shikhakath/APE-SingleBoardComputer/docs/schematic-open-items.md

# Schematic v0.1: open items for review

The schematic is generated from `hardware/gen` (16 sheets, 726 placed parts, 458 nets, 65 footprints). `build.py check` passes: no single-node nets, no accidental connections, no overlapping parts. All 16 sheets are built in Altium AD26, and every pin lands on its wire (pin-map check). `PCB.PcbDoc` is being placed and has not yet taken the 2026-11-04 netlist (717 footprints, 458 nets); the next Update PCB brings it in. 47 parts are DNP, and the `Production` project variant marks them Not Fitted. Use that variant for every BOM and pick-and-place output: `[No Variations]` still counts them as fitted.

ERC has 0 fatal errors, 7 errors and 332 warnings, all expected:
- The 7 errors are floating inputs, and the 262 "unconnected" warnings are on pins deliberately left NC with a No-ERC marker. The 7 inputs are the unused DP83867 JTAG pins and codec MIC1 inputs. All 262 pins were checked against the generator's NC list.
- 66 nets have only passive or input pins, so they have no driver.
- 4 nets join an IO pin with an output or power pin: SoC pads driven by a peripheral, and MCU_OSC0_XO tied to GND for the LVCMOS oscillator.

On 2026-10-21 the whole design was reviewed:
- against the Octavo OSD62x-PM schematic checklist (rev 07/07/2025, all 129 items);
- pin by pin against each part's datasheet;
- every footprint against its manufacturer drawing.

Fixes from that review are listed at the end.

Priority: **A** = must resolve before layout, **B** = confirm at footprint/PCB stage, **C** = confirm at bring-up.

## Decisions for you

| # | Sheet | Question | Default in the schematic |
|---|---|---|---|
| A1 | 07 | eMMC-module connector GB042-34P is broker-only (see `docs/bom`). Buy from a broker, or solder an eMMC chip? | Connector, as decided |
| A2 | 09 | Switch each USB-A port's power separately? This would mean TPS2041B plus a buffer. | Both ports switched together from USB1_DRVVBUS |
| A3 | 13 | Wire the M.2 USB pins to hub port 3, so USB-Bluetooth cards work? (M2-CC3351 uses UART.) | Not connected |
| A4 | 13 | Route BT `UART_WAKE#` and `VIO_CFG` to spare 1.8 V GPIOs? | Test points only |
| A5 | 14 | Fit the on-board HAT-ID EEPROM? It would collide with a HAT's own EEPROM at 0x50. | DNP |
| A6 | 15 | The TI-14 Tag-Connect pinout has no reset pin. `JTAG_SRST_N` sits on pad 6, the key position, which TI XDS probes leave unconnected. A custom adapter is needed. | KEY pad, pulled up on sheet 06 |
| A11 | 01 | L100 (MWSA0603S-4R7MT) saturates at 9 A, below the LM61460 high-side current limit (10.3 A typ, 11.5 A max). The datasheet asks for Isat ≥ the limit. The part is molded powder with a soft saturation curve, and the regulator has hiccup protection. Bourns SRP7028A-4R7M (10 A) is still short of 11.5 A. | Accept (risk 6 in `docs/research/bom/power.md`) |
| A12 | 14, 12 | Checklist 62_ALL_7 asks for ESD protection on off-board connectors. The 28 header signals have only their 33 Ω series resistors, and the camera FPC has none. The Raspberry Pi has none on its header either. Header protection would take 7 × TPD4E05U06. | None |
| A13 | 07 | The SD card is not power-cycled on a warm or watchdog reset. RESETSTATz is low for about 162 µs, but card VDD takes about 0.53 ms to discharge, so it only dips to about 2.4 V. A UHS-I card left in 1.8 V signalling then fails ROM SD boot. The SK has the same topology. Fixes: reboot through the Linux vmmc regulator (software), route watchdog/ESM resets to the PMIC as a cold reset, or delay the SD power enable. | Software fix (vmmc); sheet note |
| A14 | 08 | HR911130A ties all four PHY-side centre taps together inside the jack. TI DP83867 Fig 9-2 wants them separate, each with its own 0.1 µF. Most MagJack designs accept this. The alternative is a jack or discrete magnetics with separate taps, as on the DP83867 EVM. | Accept |
| A15 | 02, 03 | `VDDSHV_CANUART` is on the switched 3.3 V rail, and there is no link from `PMIC_LPM_EN0` to MODE/STBY (the DNP 0R `R207` was dropped on 2026-11-10). 62_CONFIG_9 assumes an always-on rail, as on the SK and OSD62-PM-BRK. This board has no Partial-IO, and AM625 DS Table 6-5 note 3 allows any valid IO source in that case. Moving the rail alone would break the rule that all rails discharge before a power-up (only Partial-IO with VDD_CANUART also always-on is exempt), so it would also need a 0.85 V always-on LDO for VDD_CANUART. Adding that link as things stand would be unsafe: if STBY drops `VCC_3V3_SYS`, the pull-ups lose power and MODE/STBY cannot return high. | Switched rail, no LPM_EN0 link, no SoC low-power mode through the PMIC |
| B1 | 11 | Headphone coupling caps: 47 µF gives a 211 Hz corner into 16 Ω. Fit 100–220 µF? | 47 µF |

## Footprint checks

The footprints are in `hardware/gen/fplib/`. Section 10 of `hardware/gen/README.md` lists what each one assumes. All 65 footprints were checked against their manufacturer drawings and compared pad by pad with the LCSC EasyEDA footprints; USB-C, HDMI, USB-A and TC2070 were also compared with KiCad. Where EasyEDA disagrees with the drawing, the library follows the drawing. Those cases: microSD shell tabs, TE FPC row pitch, USB-A contact rows, M.2 tab length, RJ45 LED holes.

| # | Part | Status |
|---|---|---|
| B2 | J100/J1500 USB-C (HRO TYPE-C-31-M-12) | Confirmed against the drawing, KiCad and EasyEDA |
| B3 | J1000 HDMI-A (XFCN) | Confirmed: pin 1 position backed by three sources |
| B4 | J1100 TRRS jack PJ-320DB | Confirmed from the drawing's schematic; the sheet wiring is CTIA |
| B5 | J1200 CSI FPC (TE) | Confirmed. Pick the cable type so conductor 1 lands on circuit 1. |
| B6 | J700/J701 GB042 | Confirmed by the Radxa eMMC module's own board export: socket rows 1–17 / 18–34, 34 opposite 1, no hold-downs. Face to face this gives the plug numbering used here. The same file fixes placement: J701's centre is 13.0 mm from J700's, on J700's 1–17 side, both turned the same way. |
| B7 | J702 microSD TF-01A | Footprint confirmed. **Still open:** the drawing does not show the card-detect polarity. The ROM needs SD_CD_N low with a card in. Check on a sample. |
| B8 | J900 dual USB-A (Bossie) | VBUS position confirmed (KiCad, EasyEDA). Lower port = front row is reasoned only; a swap would be harmless. |
| B9 | J1300 M.2 socket | Confirmed |
| B10 | J1400 header | Confirmed |
| B11 | SW602 DIP switch | Confirmed |
| B12 | All | Done: one name per package, every pad checked against its symbol pin by `build.py check` |
| B20 | J100, J1000 | Front silk lies 0.49 mm (USB-C) and 0.96 mm (HDMI) past the board edge. Cosmetic only. |
| B21 | Diodes, LEDs | Pad 1 = anode, matching the symbols (IPC puts the cathode on pad 1). Check D101–D103, D902 and LED1600–LED1603 rotation in the JLC placement preview. |
| B22 | U1 SiP | 0.20 mm paste apertures (area ratio 0.50). A `Paste_SiP` rule adds +0.03 mm in `pcbsetup.py`. |
| B23 | J700 GB042 | The 0.4 mm pitch leaves a 0.07 mm solder-mask web, so expect no mask between those pads. |

## Electrical items to confirm

| # | Sheet | Item |
|---|---|---|
| A8 | 01 | TPS25730 strap decoding is "firmware controlled": verify 5–9 V and 1.5/3 A on the EVM or the first boards. Its I2C address 0x20 collides with TCA64xx defaults (none on this board). |
| A9 | 06 | Ethernet boot puts 25 MHz on header **pin 7** (ball D16, CLKOUT0), because BOOTMODE bit 9 is fixed at 1. Booting from the eMMC UDA through MMCSD is unreachable; use the eMMC boot partition. |
| A10 | 07/08 | SD power-enable and PHY reset follow RESETSTATZ through resistors so the ROM can boot SD and Ethernet. R611 is 10 kΩ to GND, as on the SK. Before the SoC drives the pad, the PHY's ~9 k pull-up through R815 lifts RESETSTATZ to about 1.5 V, so RESET_N sits at 1.6–1.9 V (VIH 1.7 V), U703 reads high, and the U700 ON pins reach about 1.3 V (VIH 1.2 V). The PHY, eMMC reset and SD switch are not held off until the pad goes low, which then gives them a normal reset. Fallback: remove R815; the PHY's internal pull-up then holds RESET_N high, and nothing lifts the net. |
| B13 | 06 | 25 MHz oscillator rise time: ≤ 7 ns at 15 pF specified, against ≤ 4 ns required at the SoC input. Confirm with ECS or measure. Alternative: TI LMK6CE025000. |
| B14 | 10 | TFP410 latches on the falling edge (ti-tfp410 default). Setup at 1080p60 is 1.12 ns against the TFP410's 1.2 ns. DNP straps R1012–R1016 can add 350 ps of de-skew (fit R1013, R1014, R1016; remove R1005), giving 1.47 ns setup and 1.87 ns hold. Decide at bring-up from a 1080p60 margin test. |
| B16 | 11 | AUDIO_EXT_REFCLK1 (G26) must be configured as an **input** to McASP1, because the 12.288 MHz oscillator drives it. Confirm in the TRM. |
| B17 | 11 | Codec supply order: VDD_1V8 comes up before 3.3 V, but the datasheet wants AVDD ≥ DVDD. The codec is held in reset as on the SK. |
| B18 | 01/09 | Total capacitance on VCC_5V0, including 2 × 150 µF USB-A bulk, must be ≤ 470 µF effective for the TPS63070 |
| B19 | 03/08 | Capacitance on the LDO4 (DDR4_VPP_2V5) rail must be ≤ 30 µF including the SiP's internal caps. About 14.5 µF is on the board. |
| C1 | 06/07/08 | Measure RESET_N with its ~9 k internal pull-up: about 0.47 V with the pad low, 1.6–1.9 V before the pad is driven. Also check VDD_SD_3V3 for a short pulse in early power-up. |
| C2 | 15 | The FT4232 consoles go Hi-Z while the USB host suspends the bridge (PWREN# drives the buffers' OE# directly). The always-on option (R1530 out, R1506 in) went with the 0R links on 2026-11-10. |
| C3 | 14 | The 5 V header pins stay live while the SoC is off. Only the 33 Ω resistors limit back-drive from a HAT into SoC pads. |
| C5 | 02 | Optional upgrades: a Buck1 inductor rated ≥ 7.4 A (TI recommendation; DFE252012F-R47M is 6.7 A, the SK uses 4.5 A), and a VMON divider of 40.2 k / 4.87 k (trip 3.97–4.47 V instead of 4.33–4.79 V). |
| C6 | 02/06 | nRSTOUT rises through 2.2 k (R201) into U601, which is slow for its input. Fit 1 k if the gate output chatters. |

Closed in this review: **A7** (TI SLVUCL1A confirms the TPS6521904 rail map, sequence and SD_VSEL polarity) and **B15** (the 1.3 A bead carries the TFP410's 250 mA).

## Fixed in the 2026-10-21 review

| Sheet | Change | Reason |
|---|---|---|
| 01, 02, 16 | R1620/R1621 47 Ω at the SoC's I2C0 balls. Every I2C0 device now sits on `I2C0_SCL_BUS`/`I2C0_SDA_BUS`. | SK p.44: emulated open-drain pad |
| 01 | C100 4.7 µF 25 V 0805 | TPS25730 CVBUS max 10 µF |
| 02 | R208 MODE/STBY, R209 MODE/RESET, R210 LPM_EN0 pull-ups | Pins left floating; Octavo 62_CONFIG_9 |
| 03 | FB310 from VDDA_1V8 feeds a new `VDDS_OSC0_1V8` rail (SiP VDDS_OSC0, U600, U601) | VDDS_OSC0 was on the noisy Buck2 rail; Octavo 62_POWER_4, 62_CLOCK_2 |
| 03 | C322/C324/C326/C328 4.7 µF → 1 µF | 32 µF on LDO3 exceeded its 30 µF slow-ramp limit |
| 03 | TP300–TP312 on 13 rails | Octavo 62_ALL_2 |
| 06 | R611 1 kΩ (back to 10 kΩ on 2026-11-06) | See A10 |
| 07 | R732 SD CLK pull-down | Octavo checklist |
| 09 | R913 fitted (USB1_DRVVBUS pull-down) | TPS2051B EN floated while the SoC IO rail is off |
| 10 | R1012–R1016 de-skew straps (DNP) | See B14 |
| 11 | D1100–D1102 ESD at the jack | 62_ALL_7 |
| 13 | R1322/R1323 BT UART pull-ups (the R1321 SDIO CLK series link was dropped on 2026-11-10) | Octavo checklist |
| 14 | R1433 47 k UART5 RX pull-up | 62_UART_2 |
| 15 | PWREN# drives OE# directly (R1530 dropped 2026-11-10); C1506 10 µF | VREGOUT needs ≥ 3.3 µF effective |
| Footprints | QFN28 (CH335F) paste windows; silk clearance 0.20 mm; SiP paste rule | IPC-7525, JLC silk-to-mask rule |

## Fixed in the 2026-11-03 update

| Sheet | Change | Reason |
|---|---|---|
| All | `Production` variant marks all 47 DNP parts Not Fitted (`build.py variant`) | DNP was only a hidden parameter, which BOM and pick-and-place outputs ignore |
| 06 | R603 is now 10 MΩ | Its value read "0402". TI recommends the Rbias footprint on pre-production boards but gives no value. 10 MΩ is the usual bias for a 32 kHz crystal and is harmless if fitted. |
| 07 | U703 (SN74LVC1G08 on VDD_1V8) drives the module's RST_n from RESETSTATz ANDed with the GPIO. R710 moved to the GPIO side. | Checklist 62_EMMC_9: the GPIO alone left the module un-reset on a warm reset. |
| 08 | R824–R837 removed; U800 pins 39, 40 and 45 are NC | Fitted, they gave PHY address 5, RX skew 0.5 ns and TX skew 3.5 ns. The wanted setting is mode 1 (open), so no fitted value can be correct. Skews can still be changed in software. This also removes stubs from RGMII RX. |
| 08 | R816 removed | Fitted beside R815, it lifted RESET_N to about 0.8 V during reset. The fallback only needs R815 removed (see A10). |

## Power-net audit (2026-11-04)

Every checklist item that names a supply was checked against the netlist. Each SoC signal ball's IO bank comes from the ball map, and every pull-up reached directly or through one series resistor was compared with that bank: 0 mismatches.

| Sheet | Change | Reason |
|---|---|---|
| 03 | `R303`-`R310` (0 Ω) feed new nets `VDDSHV0`, `VDDSHV1`, `VDDSHV2`, `VDDSHV3`, `VDDSHV4`, `VDDSHV6`, `VDDSHV_MCU` and `VDDSHV_CANUART` from `VCC_3V3_SYS` or `VDD_1V8` | The checklist names pull-up rails by bank. All banks shared two nets, so a pull-up to `VCC_3V3_SYS` could not be told apart from a pull-up to the right bank. Voltages and sources do not change. **2026-11-10: the links were dropped with every other 0R link, so the bank nets are `VCC_3V3_SYS` and `VDD_1V8` again (`schgen.MERGED_NETS`); the sheets still name the bank behind each pull-up.** |
| All | 110 parts moved to the net of their bank: pull-ups, decoupling, `J700` VCCQ, `U800` VDDIO, `U602`, `U703`, `U1504`, `U1505` | 62_CONFIG_4, 62_CONFIG_5, 62_CONFIG_9, 62_RESET_4, 62_RESET_6, 62_BOOT_1, 62_I2C_1, 62_I2C_3, 62_UART_2, 62_EMMC_3, 62_EMMC_8, 62_SD_7, 62_DPI_3, 62_ETH_1, 62_ETH_2 |
| 03 | `R301` 40.2 kΩ, `R302` 4.87 kΩ (were 10 kΩ, 1.1 kΩ) | 62_CONFIG_6 figure is 40.2 kΩ / 4.81 kΩ. The old values could trip as high as 4.79 V, only 4 % under a 5 V rail. Now 3.97-4.47 V. |
| 03 | `FB311` gives `VDDA_3P3_USB` its own bead; `VDDA_TEMP` joins `VDDA_1V8_MCU`. `C361`, added here on the bead output, was deleted on 2026-11-06 with the other capacitors not in OSD62x-PM Table 4-3. | 62_POWER_4 groups 5 and 3 |

Divider details, using the AM625 DS 8.2.4 method (0.45 V ±3 %, 1 % resistors, 2.5 µA leakage):
- The figure's 4.81 kΩ trips at 4.01-4.52 V. It is not an E96 value, and a stocked 1 % 0402 part could not be confirmed (the parts searches were failing on 2026-11-04). 4.87 kΩ (C25902) trips at 3.97-4.47 V, which keeps the maximum under the 4.5 V target.
- The checklist quotes 2.5-10 µA leakage while the datasheet says 10 nA-2.5 µA. At 10 µA the maximum trip would be 4.77 V.
- At 5.25 V the pin sits at 0.57 V, under the 1 V limit.

| Item | Checklist asks | Net now | Parts | Result |
|---|---|---|---|---|
| 62_POWER_4 | Filtered groups 1-5 | `VDDA_1V8_OLDI`, `VDDA_1V8_CSI`, `VDDS_OSC0_1V8`, `VDDA_1V8_MCU` (with VDDA_TEMP), `VDDA_1V8_PLL0/1/2`, `VDDA_1V8_USB`, `VDDA_3P3_USB` | `FB303`-`FB311` | Met; each 1.8 V group split further than asked |
| 62_POWER_5 | VPP unconnected unless programming | `VPP_EFUSE_1V8` | `U202` DNP | Met |
| 62_POWER_7 | Partial IO needs always-on rails | `VDD_CORE_0V85`, `VDDSHV_CANUART` (switched) | | Not used; see A15 |
| 62_POWER_8, 62_POWER_10 | VDDR_CORE with VDD_CORE, 0.85 V at 1.4 GHz | `VDD_CORE_0V85` (one net since `R300` was dropped on 2026-11-10) | Direct | Met |
| 62_CONFIG_2, 62_RESET_1 | MCU_ERRORn and MCU_PORz in VDDS_OSC0 | `VDDS_OSC0_1V8` | `U601`, `R605` | Met |
| 62_CONFIG_4, 62_RESET_4 | 10 k or 47 k to VDDSHV_MCU | `VDDSHV_MCU` | `R610`, `R1523`-`R1527`, all 10 k | Met |
| 62_CONFIG_5 | Separate pull-ups to VDDSHV_MCU | `VDDSHV_MCU` | `R1428`-`R1431` | Met |
| 62_CONFIG_6 | VSYS divider | `VCC_5V0`, `VMON_VSYS` | `R301`, `R302`, `C300` 22 pF | Met |
| 62_CONFIG_8 | VMON pins on their rails | `VDD_1V8`, `VCC_3V3_SYS` | | Met (the sources, per DS Table 6-5 note 4) |
| 62_CONFIG_9 | Pull-up to the VDDSHV_CANUART source | `VDDSHV_CANUART` | `R210`; no LPM_EN0 link | Met, but the rail is not always-on; see A15 |
| 62_RESET_6 | 10 k or 47 k to VDDSHV0 | `VDDSHV0` | `R609`, `U602` | Met |
| 62_CLOCK_2 | Oscillator on the VDDS_OSC0 rail | `VDDS_OSC0_1V8` | `U600` | Met |
| 62_I2C_1 | 4.7 k to VDDSHV_MCU | `VDDSHV_MCU` | `R1428`, `R1429` 1.8 k; `R1430`, `R1431` 3.9 k | Rail met; values kept for HAT compatibility (62_CONFIG_5 allows choosing) |
| 62_I2C_3 | Pull-ups on the bank's rail | I2C0, I2C1 `VDDSHV0`; I2C2 `VDDSHV3` | `R1605`, `R1606`, `R1100`, `R1101`, `R1200`, `R1201` | Met |
| 62_UART_2 | RX pull-up | UART0/1/5 `VDDSHV0`; MCU/WKUP_UART0 `VDDSHV_CANUART`; UART6 `VDDSHV1` | `R1511`-`R1518`, `R1433`, `R1322`, `R1323` | Met |
| 62_BOOT_1, 62_DPI_3 | Straps to VDDSHV3 | `VDDSHV3` | `R620`-`R642`, `R651`, `SW602` | Met |
| 62_USB_2 | Valid USB supplies | `VDDA_CORE_USB_0V85`, `VDDA_1V8_USB`, `VDDA_3P3_USB` | | Met |
| 62_CSI_2 | Valid CSI supplies | `VDDA_CORE_CSI_0V85`, `VDDA_1V8_CSI` | | Met |
| 62_EMMC_3, 62_EMMC_8 | VCCQ on the VDDSHV4 rail; pull-ups to it | `VDDSHV4` | `J700`, `R701`-`R709`, `U703` | Met |
| 62_SD_3, 62_SD_4, 62_SD_8 | Switchable VDDSHV5, pull-ups on it | `VDDSHV5_SD` | `U700` ch2, `R723`-`R727` | Met |
| 62_SD_5 | Fixed 3.3 V card VDD | `VDD_SD_3V3` | `U700` ch1 | Met |
| 62_SD_7 | SDCD in VDDSHV0 | `VDDSHV0` | `R731` | Met |
| 62_OSPI_1 | VDDSHV1 and the attached IO on one source | `VDD_1V8` (one net since `R304` and `R1320` were dropped) | Direct | Met; OSPI balls used as UART6 and GPIO |
| 62_ETH_1, 62_ETH_2 | PHY IO on the VDDSHV2 source, MDIO pulled up | `VDDSHV2` | `U800`, `R813` | Met |
| 62_ALL_2 | Test points on rails | The bank rails are `VCC_3V3_SYS` and `VDD_1V8` (links dropped 2026-11-10) | `TP303`, `TP308` | Probe the two system rails |

`J1400` I2C path, checked ball to pin. Each signal goes ball, 47 pF to GND, 62 Ω, bus with pull-up, header pin:
- `MCU_I2C0_SDA` (B7): `C1400`, `R1424`, `R1428`, pin 3 (SDA1).
- `MCU_I2C0_SCL` (A7): `C1401`, `R1425`, `R1429`, pin 5 (SCL1).
- `WKUP_I2C0_SDA` (B8): `C1402`, `R1426`, `R1430`, pin 27 (ID_SD).
- `WKUP_I2C0_SCL` (A8): `C1403`, `R1427`, `R1431`, pin 28 (ID_SC).

SDA and SCL are not swapped, and these balls are fail-safe, so a powered HAT cannot damage them. The header has no ESD protection (A12).

## Software notes for the device tree

- `ti,vbus-divider` on both USB wrappers (09).
- McASP1 high-speed clock from AUDIO_EXT_REFCLK1 as an input (11).
- The TFP410 runs in strap mode, with PD# on `HDMI_PD_N` (10).
- CC3351 over SDIO (MMC2) + UART6 for Bluetooth. The card's reset is on WLAN_EN (W_DISABLE1#).
- PMIC at 0x30, TPS25730 at 0x20, TMP102 at 0x48 and the board-ID EEPROM at 0x51, all on I2C0.
- eMMC: RST_n only acts once EXT_CSD[162] (RST_n_FUNCTION) is enabled on the module. This setting is one-time programmable.
- SD card: give MMC1 a `vmmc-supply` on the SD power-enable GPIO, so a reboot power-cycles the card (A13).
