shikhakath/APE-SingleBoardComputer/reference/2_PROC142A/1_SCHEMATIC/ORCAD/Backup_SK_Schematic_For_Reference/PROC142A_GPIO_EXP_PINMUX.xlsx

Sheet: PROC142A
TCA6424ARGJR
Pin Number | Pin Name | Signal Name
1 | P00 | GPIO_CPSW2_RST
2 | P01 | GPIO_CPSW1_RST
3 | P02 | PRU_DETECT
4 | P03 | MMC1_SD_EN
5 | P04 | VPP_LDO_EN
6 | P05 | EXP_PS_3V3_EN
7 | P06 | EXP_PS_5V0_EN
8 | P07 | EXP_HAT_DETECT
17 | P20 | HDMI_INTN
18 | P21 | PD_I2C_IRQ
19 | P22 | MCASP1_FET_EN
20 | P23 | MCASP1_BUF_BT_EN
21 | P24 | MCASP1_FET_SEL
22 | P25 | UART1_FET_SEL
23 | P26 | TS_INT#
24 | P27 | IO_EXP_TEST_LED
9 | P10 | WLAN_ALERT_3V3
10 | P11 | BT_UART_WAKE_SOC_3V3
11 | P12 | UART1_FET_BUF_EN
12 | P13 | WL_LT_EN
13 | P14 | GPIO_HDMI_RSTN
14 | P15 | CSI_GPIO1
15 | P16 | CSI_GPIO2
16 | P17 | PRU_3V3_EN
TCA6408ARGTR
Pin Number | Pin Name | Signal Name
2 | P0 | WLAN_SDIO_RST_3V3
3 | P1 | GPIO_TS_RSTN
4 | P2 | GPIO_AUD_RSTN
5 | P3 | GPIO_EMMC_RSTN
7 | P4 | TP 118
8 | P5 | TP 119
9 | P6 | TP 120
10 | P7 | TP 121

Sheet: TCA6408ARGTR
Pin Number | Signal Name
1 | RESETSTATZ
2 | WLAN_SDIO_RST_3V3
3 | GPIO_TS_RSTN
4 | GPIO_AUD_RSTN
5 | GPIO_EMMC_RSTN
7 | TP 118
8 | TP 119
9 | TP 120
10 | TP 121
11 | IO_EXP1_INTN
12 | SOC_I2C1_SCL
13 | SOC_I2C1_SDA
16 | ADDR_IO_EXP1

Sheet: TCA6424ARGJR
Pin Number | Signal Name
1 | GPIO_CPSW2_RST
2 | GPIO_CPSW1_RST
3 | PRU_DETECT
4 | MMC1_SD_EN
5 | VPP_LDO_EN
6 | EXP_PS_3V3_EN
7 | EXP_PS_5V0_EN
8 | EXP_HAT_DETECT
17 | HDMI_INTN
18 | PD_I2C_IRQ
19 | MCASP1_FET_EN
20 | MCASP1_BUF_BT_EN
21 | MCASP1_FET_SEL
22 | UART1_FET_SEL
23 | TS_INT#
24 | IO_EXP_TEST_LED
26 | ADDR_IO_EXP
28 | RESETSTATZ
29 | SOC_I2C1_SCL
30 | SOC_I2C1_SDA
32 | IO_EXP_INTN
9 | WLAN_ALERT_3V3
10 | BT_UART_WAKE_SOC_3V3
11 | UART1_FET_BUF_EN
12 | WL_LT_EN
13 | GPIO_HDMI_RSTN
14 | CSI_GPIO1
15 | CSI_GPIO2
16 | PRU_3V3_EN
