shikhakath/APE-SingleBoardComputer/reference/2_PROC142A/1_SCHEMATIC/ORCAD/Backup_SK_Schematic_For_Reference/AM62-EVM_BGA425.xlsx

Pin Number | Pin Name
Y15 | RSVD7
AA12 | RSVD6
AA14 | CSI0_RXRCALIB
AB14 | CSI0_RXN0
AC15 | CSI0_RXP0
AD14 | CSI0_RXN1
AE14 | CSI0_RXP1
AE13 | CSI0_RXP2
AD13 | CSI0_RXN2
AB12 | CSI0_RXN3
AC13 | CSI0_RXP3
AD15 | CSI0_RXCLKN
AE15 | CSI0_RXCLKP
AA19 | RGMII2_TX_CTL
AD17 | RGMII1_RXC
AD19 | RGMII1_TX_CTL
AD22 | RGMII2_RX_CTL
AD23 | RGMII2_RXC
AE17 | RGMII1_RX_CTL
AE19 | RGMII1_TXC
AE21 | RGMII2_TXC
AB17 | RGMII1_RD0
AC17 | RGMII1_RD1
AB16 | RGMII1_RD2
AA15 | RGMII1_RD3
AE20 | RGMII1_TD0
AD20 | RGMII1_TD1
AE18 | RGMII1_TD2
AD18 | RGMII1_TD3
AE23 | RGMII2_RD0
AB20 | RGMII2_RD1
AC21 | RGMII2_RD2
AE22 | RGMII2_RD3
Y18 | RGMII2_TD0
AA18 | RGMII2_TD1
AD21 | RGMII2_TD2
AC20 | RGMII2_TD3
Y6 | OLDI0_A0P
Y8 | OLDI0_A2N
AA5 | OLDI0_A0N
AA8 | OLDI0_A2P
AB4 | OLDI0_A1P
AD3 | OLDI0_A1N
AD4 | OLDI0_CLK0N
AD6 | OLDI0_A5P
AD7 | OLDI0_A6P
AD8 | OLDI0_A7N
AE3 | OLDI0_CLK0P
AE5 | OLDI0_A5N
AE6 | OLDI0_A6N
AE7 | OLDI0_A7P
AA7 | OLDI0_A3P
AB6 | OLDI0_A3N
AC5 | OLDI0_A4P
AC6 | OLDI0_A4N
AD5 | OLDI0_CLK1P
AE4 | OLDI0_CLK1N
A3 | MCU_OSC0_XO
A5 | MCU_UART0_TXD
A6 | MCU_UART0_CTSN
A7 | MCU_SPI0_CLK
A8 | MCU_I2C0_SCL
B2 | MCU_OSC0_XI
B3 | MCU_MCAN0_RX
B5 | MCU_UART0_RXD
B6 | MCU_UART0_RTSN
B8 | MCU_SPI0_CS1
C9 | MCU_SPI0_D1
D4 | MCU_MCAN1_RX
D6 | MCU_MCAN0_TX
D9 | MCU_SPI0_D0
D10 | MCU_I2C0_SDA
E5 | MCU_MCAN1_TX
E8 | MCU_SPI0_CS0
A21 | MMC1_CMD
A22 | MMC1_DAT0
A23 | MMC2_SDCD
B21 | MMC1_DAT1
B22 | MMC1_CLK
B23 | MMC2_SDWP
C17 | MMC1_SDWP
C21 | MMC1_DAT2
C24 | MMC2_CMD
D17 | MMC1_SDCD
D22 | MMC1_DAT3
D25 | MMC2_CLK
Y3 | MMC0_CMD
Y4 | MMC0_DAT3
AA1 | MMC0_DAT1
AA2 | MMC0_DAT0
AA3 | MMC0_DAT2
AB1 | MMC0_CLK
AB2 | MMC0_DAT4
AC1 | MMC0_DAT5
AD2 | MMC0_DAT6
AC2 | MMC0_DAT7
B24 | MMC2_DAT0
C25 | MMC2_DAT1
E23 | MMC2_DAT2
D24 | MMC2_DAT3
A16 | I2C0_SDA
A17 | I2C1_SDA
B16 | I2C0_SCL
B17 | I2C1_SCL
A13 | SPI0_CS0
A14 | SPI0_CLK
B13 | SPI0_D0
B14 | SPI0_D1
C13 | SPI0_CS1
B1 | RSVD0
C15 | MCAN0_TX
E15 | MCAN0_RX
A15 | UART0_CTSN
B15 | UART0_RTSN
D14 | UART0_RXD
E14 | UART0_TXD
A18 | EXT_REFCLK1
A2 | RSVD1
F6 | RSVD2
AE2 | RSVD3
G9 | CAP_VDDS_CANUART
H11 | CAP_VDDS_MCU
H15 | CAP_VDDS0
K18 | CAP_VDDS1
W17 | CAP_VDDS2
P19 | CAP_VDDS3
U7 | CAP_VDDS4
H17 | CAP_VDDS5
J19 | CAP_VDDS6
A1 | VSS
A24 | VSS
A25 | VSS
B25 | VSS
F13 | VSS
G13 | VSS
G19 | VSS
H13 | VSS
H16 | VSS
H18 | VSS
H20 | VSS
J7 | VSS
J13 | VSS
K7 | VSS
K13 | VSS
K15 | VSS
K19 | VSS
L20 | VSS
M7 | VSS
M8 | VSS
M10 | VSS
M12 | VSS
M13 | VSS
M17 | VSS
M18 | VSS
N15 | VSS
P7 | VSS
P10 | VSS
P13 | VSS
R13 | VSS
R15 | VSS
R18 | VSS
R20 | VSS
T8 | VSS
T13 | VSS
T14 | VSS
T16 | VSS
T17 | VSS
T18 | VSS
U8 | VSS
U19 | VSS
V9 | VSS
V10 | VSS
V11 | VSS
V13 | VSS
V16 | VSS
V18 | VSS
W7 | VSS
Y2 | VSS
AA11 | VSS
AB9 | VSS
AD1 | VSS
AD9 | VSS
AD12 | VSS
AD16 | VSS
AD25 | VSS
AE1 | VSS
AE8 | VSS
AE12 | VSS
AE16 | VSS
AE24 | VSS
AE25 | VSS
A4 | WKUP_UART0_RTSN
A9 | WKUP_I2C0_SDA
A12 | WKUP_CLKOUT0
B4 | WKUP_UART0_RXD
B9 | WKUP_I2C0_SCL
C1 | WKUP_LFOSC0_XO
C2 | WKUP_LFOSC0_XI
C5 | WKUP_UART0_TXD
C6 | WKUP_UART0_CTSN
AB22 | MDIO0_MDIO
AD24 | MDIO0_MDC
B7 | PMIC_LPM_EN0
G7 | VDDS_OSC0
M9 | VDDS_DDR_C
G16 | VDDA_TEMP1
L11 | VDDA_MCU
L14 | VDDA_PLL2
T9 | VDDA_TEMP0
U11 | VDDA_PLL0
U15 | VDDA_PLL1
W9 | VDDA_1P8_OLDI0
W10 | VDDA_1P8_OLDI0
W12 | VDDA_CORE_USB
W13 | VDDA_CORE_CSIRX0
W14 | VDDA_1P8_CSIRX0
Y11 | VDDA_1P8_USB
Y13 | VDDA_3P3_USB
E7 | RSVD8
F8 | VDD_CANUART
G10 | VMON_1P8_SOC
H10 | VMON_ER_VSYS
J8 | VPP
K10 | VMON_3P3_SOC
H8 | VDD_CORE
J11 | VDD_CORE
J14 | VDD_CORE
K17 | VDD_CORE
L12 | VDD_CORE
L15 | VDD_CORE
M16 | VDD_CORE
N8 | VDD_CORE
N11 | VDD_CORE
N13 | VDD_CORE
P17 | VDD_CORE
R11 | VDD_CORE
R14 | VDD_CORE
U12 | VDD_CORE
V8 | VDD_CORE
V15 | VDD_CORE
V17 | VDD_CORE
K9 | VDDS_DDR
L8 | VDDS_DDR
P9 | VDDS_DDR
R8 | VDDS_DDR
K16 | VDDR_CORE
N12 | VDDR_CORE
N14 | VDDR_CORE
P16 | VDDR_CORE
R12 | VDDR_CORE
T10 | VDDR_CORE
U14 | VDDR_CORE
J12 | VDDR_CORE
F15 | VDDSHV0
G14 | VDDSHV0
L18 | VDDSHV1
M19 | VDDSHV1
T7 | VDDSHV4
W16 | VDDSHV2
W19 | VDDSHV2
F11 | VDDSHV_MCU
G12 | VDDSHV_MCU
N18 | VDDSHV3
P18 | VDDSHV3
T19 | VDDSHV3
U18 | VDDSHV3
G17 | VDDSHV5
J18 | VDDSHV6
H9 | VDDSHV_CANUART
B12 | MCU_RESETSTATZ
D2 | MCU_PORZ
D1 | MCU_ERRORN
E11 | MCU_RESETZ
E21 | PORZ_OUT
D16 | EXTINTN
F20 | RESET_REQZ
F22 | RESETSTATZ
L23 | GPMC0_ADVN_ALE
M22 | GPMC0_DIR
N20 | GPMC0_BE1N
M25 | GPMC0_AD0
M24 | GPMC0_BE0N_CLE
N23 | GPMC0_AD1
N24 | GPMC0_AD2
N25 | GPMC0_AD3
P21 | GPMC0_AD6
P22 | GPMC0_AD5
P24 | GPMC0_AD4
P25 | GPMC0_CLK
U24 | GPMC0_AD15
U25 | GPMC0_AD14
R23 | GPMC0_AD7
R24 | GPMC0_AD8
R25 | GPMC0_AD9
T25 | GPMC0_AD10
R21 | GPMC0_AD11
T22 | GPMC0_AD12
T24 | GPMC0_AD13
M21 | GPMC0_CSN0
L21 | GPMC0_CSN1
K22 | GPMC0_CSN2
K24 | GPMC0_CSN3
U23 | GPMC0_WAIT0
V25 | GPMC0_WAIT1
K25 | GPMC0_WPN
L24 | GPMC0_OEN_REN
L25 | GPMC0_WEN
U22 | VOUT0_DATA0
V24 | VOUT0_DATA1
W24 | VOUT0_DATA3
W25 | VOUT0_DATA2
Y20 | VOUT0_DE
Y23 | VOUT0_DATA6
Y24 | VOUT0_DATA5
Y25 | VOUT0_DATA4
AA25 | VOUT0_DATA7
AB24 | VOUT0_HSYNC
AC24 | VOUT0_PCLK
AC25 | VOUT0_VSYNC
V20 | VOUT0_DATA10
W21 | VOUT0_DATA9
V21 | VOUT0_DATA8
AA23 | VOUT0_DATA11
AB25 | VOUT0_DATA12
AA24 | VOUT0_DATA13
Y22 | VOUT0_DATA14
AA21 | VOUT0_DATA15
J1 | DDR0_A0
J2 | DDR0_A1
K1 | DDR0_A5
K3 | DDR0_A2
K4 | DDR0_A4
L5 | DDR0_A3
P1 | DDR0_A8
P2 | DDR0_A7
P4 | DDR0_A9
P5 | DDR0_A11
R1 | DDR0_A13
R2 | DDR0_A6
R3 | DDR0_ALERT_N
R5 | DDR0_A10
R6 | DDR0_A12
T1 | DDR0_PAR
F4 | DDR0_DQ0
G5 | DDR0_DQ1
F3 | DDR0_DQ2
H6 | DDR0_DQ3
E3 | DDR0_DQ4
G2 | DDR0_DQ5
F2 | DDR0_DQ6
F1 | DDR0_DQ7
U1 | DDR0_DQ8
U3 | DDR0_DQ9
U2 | DDR0_DQ10
V5 | DDR0_DQ11
W2 | DDR0_DQ12
V6 | DDR0_DQ13
Y1 | DDR0_DQ14
W1 | DDR0_DQ15
H1 | DDR0_ODT0
H2 | DDR0_CKE0
H5 | DDR0_DM0
J3 | DDR0_ODT1
J4 | DDR0_CKE1
K2 | DDR0_CS1_N
L1 | DDR0_CK0
L2 | DDR0_CK0_N
L6 | DDR0_CS0_N
M2 | DDR0_CAL0
M4 | DDR0_CAS_N
M5 | DDR0_RAS_N
N6 | DDR0_ACT_N
M1 | DDR0_BA0
N1 | DDR0_BA1
T4 | DDR0_BG0
N2 | DDR0_BG1
T2 | RSVD4
U4 | RSVD5
G1 | DDR0_RESET0_N
N3 | DDR0_WE_N
W5 | DDR0_DM1
E1 | DDR0_DQS0
E2 | DDR0_DQS0_N
V1 | DDR0_DQS1
V2 | DDR0_DQS1_N
C11 | EMU1
E12 | EMU0
A10 | TCK
A11 | TDI
B10 | TRSTN
B11 | TMS
D12 | TDO
E25 | OSPI0_D0
F23 | OSPI0_CSN0
F24 | OSPI0_D3
G21 | OSPI0_CSN1
F25 | OSPI0_D2
G24 | OSPI0_D1
G25 | OSPI0_LBCLKO
H24 | OSPI0_CLK
J23 | OSPI0_D4
J24 | OSPI0_DQS
J25 | OSPI0_D5
H25 | OSPI0_D6
J22 | OSPI0_D7
H21 | OSPI0_CSN2
E24 | OSPI0_CSN3
A19 | MCASP0_AXR2
A20 | MCASP0_ACLKR
B18 | MCASP0_AXR1
B19 | MCASP0_AXR3
B20 | MCASP0_ACLKX
D20 | MCASP0_AFSX
E18 | MCASP0_AXR0
E19 | MCASP0_AFSR
C20 | USB0_DRVVBUS
F18 | USB1_DRVVBUS
AB10 | USB1_VBUS
AC9 | USB1_RCALIB
AC11 | USB0_VBUS
AD10 | USB1_DM
AD11 | USB0_DP
AE9 | USB1_DP
AE10 | USB0_RCALIB
AE11 | USB0_DM
