shikhakath/APE-SingleBoardComputer/docs/pcb-floorplan.png

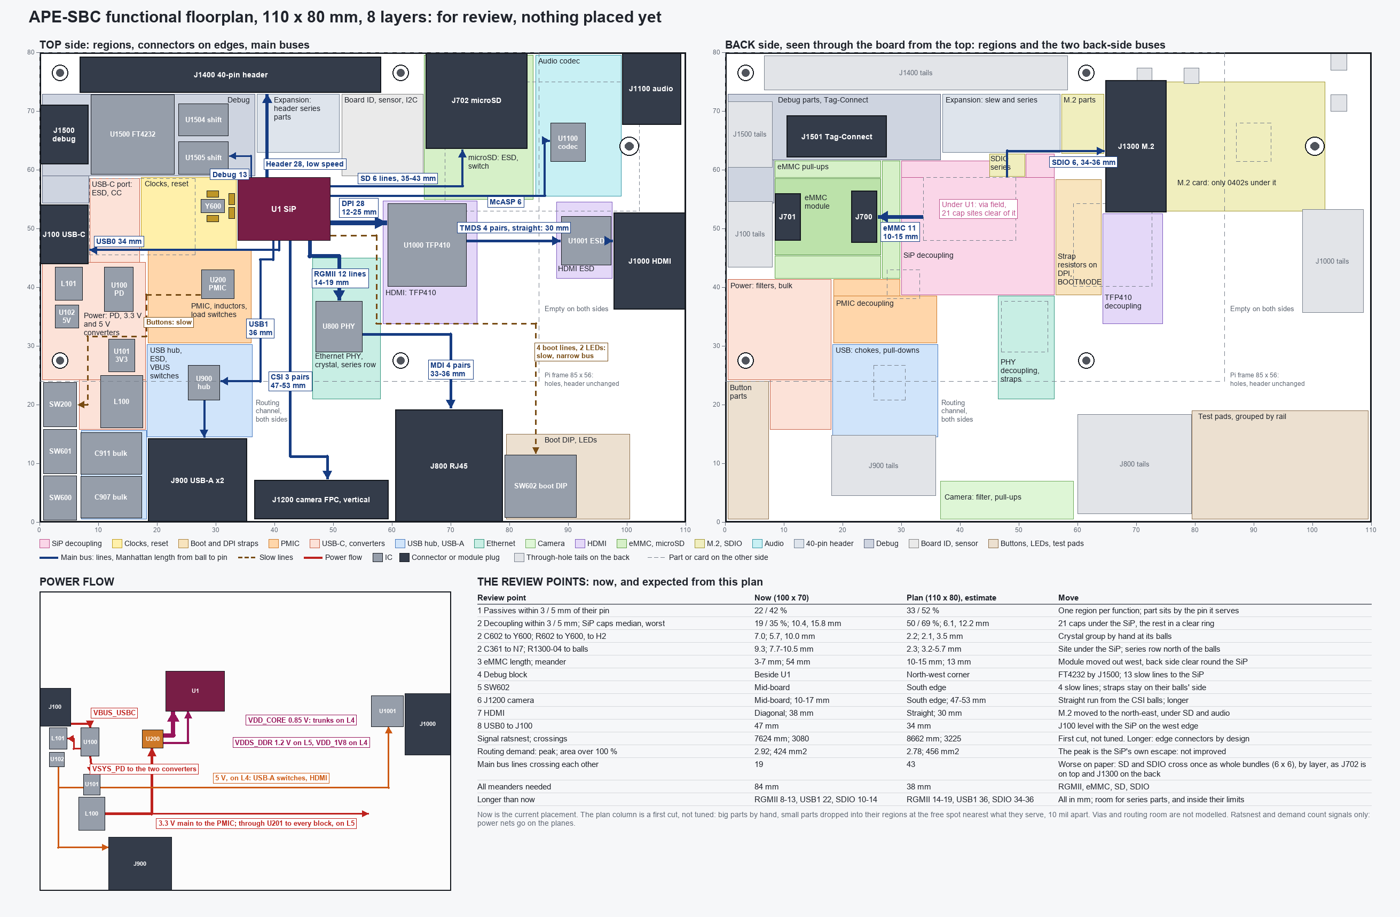
docs/pcb-floorplan.png
