shikhakath/APE-SingleBoardComputer/reference/2_PROC142A/1_SCHEMATIC/ORCAD/Backup_SK_Schematic_For_Reference/PROC142A_SCH.png

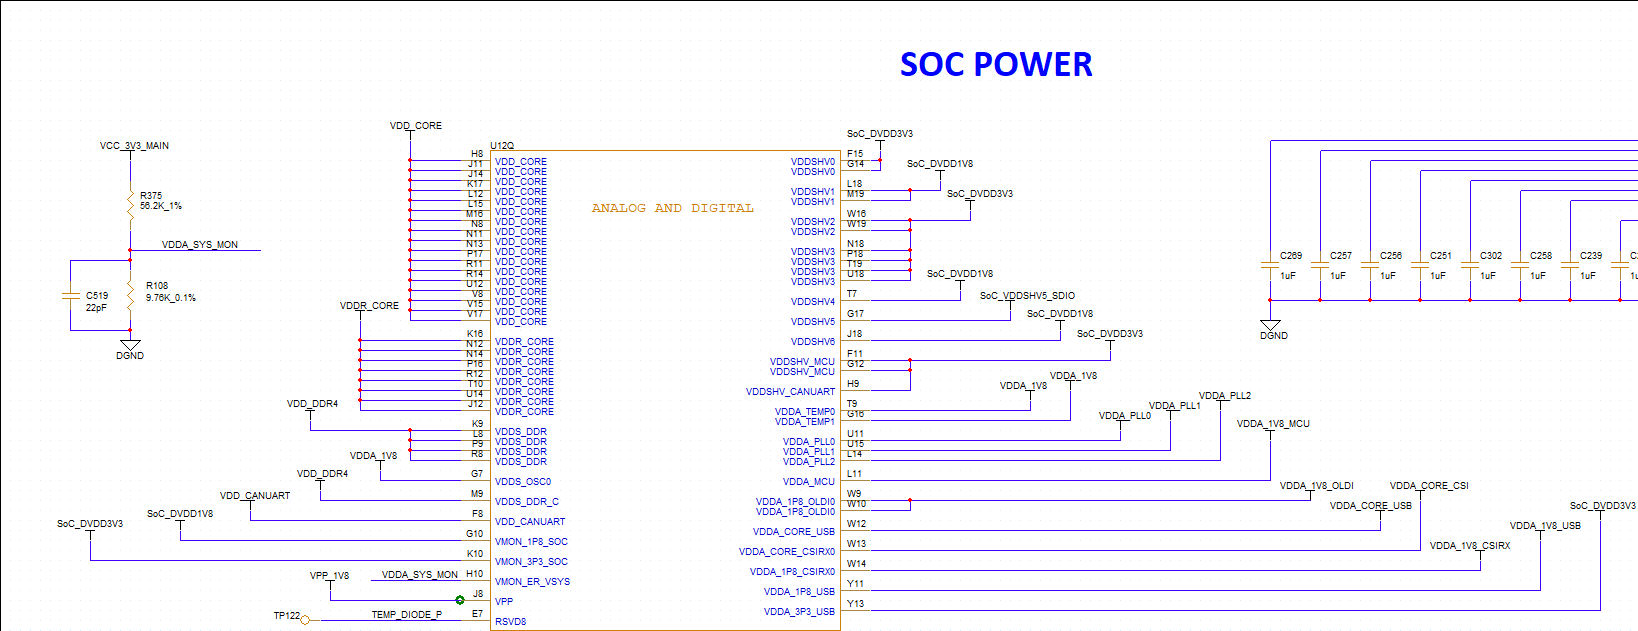
reference/2_PROC142A/1_SCHEMATIC/ORCAD/Backup_SK_Schematic_For_Reference/PROC142A_SCH.png
