shikhakath/APE-SingleBoardComputer/docs/bom/APE-SBC_BOM_estimate.csv

group | function | refdes_hint | qty_per_board | mpn | manufacturer | description | package | supplier | supplier_pn | unit_price_usd | ext_price_usd | price_basis | stock | jlc_class | url | notes
Processor | Processor SiP: AM6254 (quad A53 @1.4 GHz) + 1 GB DDR4 + passives | U1 | 1 | OSD6254-1G-IPM | Octavo Systems | System-in-Package AM6254 + 1 GB DDR4, -40..85 C, MSL4 | BGA-500 9x14 mm 0.5 mm pitch | Digi-Key | 1676-OSD6254-1G-IPM-ND | 44.0620 | 44.0620 | Digi-Key qty-10 break, checked 2026-10-17 ($45.48 @1) | Digi-Key 182 (Active, 18-wk LT); Mouser 0 (182 on order due 2026-10-27, $45.48 @1); Avnet 0; JLC C49026186 0 | Extended - JLC Global Sourcing or consign (JLC lib C49026186 exists, no stock/price, X-ray required) | https://www.digikey.com/en/products/detail/octavo-systems-llc/osd6254-1g-ipm/26728725 | Single in-stock source = Digi-Key (182 pcs = one factory tray; enough for 10 boards). Octavo direct list $22.50 (qty basis not stated; volume). 2025 DK price was ~$27.54 @10. Buy 10-11 now; JLC Global Sourcing can pull from DK/Mouser, or ship consigned parts to JLC. MSL4 (72 h floor life) - confirm JLC dry-pack/bake handling for consigned trays.
Power | PMIC (3x buck, 4x LDO), NVM for AM62x DDR4 0.85 V core, 3.3 V VSYS | U4 | 1 | TPS6521904RSMR | Texas Instruments | TPS65219 PMIC, NVM 04 (same NVM as SK's RHBR) | VQFN-32 4x4 0.4 mm pitch (RSM) | Digi-Key | 296-TPS6521904RSMRCT-ND | 3.4490 | 3.4490 | Digi-Key cut tape @10pcs (2026-10-17) | 2524 | global sourcing (JLC lib C32975654 has 5 pcs only) | https://www.digikey.com/en/products/detail/texas-instruments/TPS6521904RSMR/22106795 | STOCK OK (2,524 at Digi-Key = 2,524 boards' worth). Package changed RHB->RSM for stock: RSMR is in stock at Digi-Key (2,524) and Mouser (595-TPS6521904RSMR, 2,680, $3.49@10); RHBR is 0 at Digi-Key (26 wk, ~3,000 due 09-Dec-2026), 0 at Mouser (2,894 expected 02-Nov-2026), out of stock at TI store, only 19 at JLC/LCSC; Arrow lists RSMR quote-only. TI store RSMR out of stock. JLC has RSMR C32975654 (5 pcs only) -> buy via JLC global sourcing or consign from Digi-Key/Mouser. Layout: RSM footprint (TPS65219EVM-RSM as reference), not the SK RHB.
Power | USB-PD sink controller w/ integrated 5 A power path (OVP/RCP) | U1 | 1 | TPS25730DREFR | Texas Instruments | Stand-alone USB-C PD3.1 sink, resistor-strapped, 16 mOhm 5 A PPHV switch, I2C target 0x20/0x21 | WQFN-38 4x6 (REF) | JLCPCB/LCSC | C22438973 | 2.5680 | 2.5680 | JLCPCB parts lib @10pcs (2026-10-17) | 283 | extended | https://jlcpcb.com/partdetail/TexasInstruments-TPS25730DREFR/C22438973 | STOCK OK (283 at JLCPCB = 283 boards' worth). Strap: ADCIN1=GND (min 5 V, I2C 0x20), ADCIN2=decoded 1 (max 9 V; 100k/4.99k to LDO_3V3), ADCIN3/4 = 1.5 A op / 3 A max. This min/max combo gives dead-battery mode AlwaysEnableSink (datasheet Table 8-3), so legacy 5 V sources always power the board. Chosen over TPS25730ADREFR (PD3.2, cheaper $2.19) because the A has only 39 pcs at JLC (<50 boards); A is pin-compatible (see ALT row).
Power | Always-on 3.3 V buck (VCC_3V3_MAIN) | U2 | 1 | LM61460AANRJRR | Texas Instruments | 3-36 V in (42 V tolerant), 6 A sync buck, 200 kHz-2.2 MHz, adjustable | VQFN-HR-14 3.5x4 | JLCPCB/LCSC | C2864505 | 1.5934 | 1.5934 | JLCPCB parts lib @10pcs (2026-10-17) | 956 | extended | https://jlcpcb.com/partdetail/TexasInstruments-LM61460AANRJRR/C2864505 | STOCK OK (956 at JLCPCB = 956 boards' worth). Same family as SK U67 (LM61460AANQRJRRQ1) but catalog grade; input range is 3.0-36 V (not 4.5-24 V), so it works at the 5 V fallback. Run ~400 kHz.
Power | 5 V buck-boost (VCC_5V0: USB-A, HDMI 5 V, header 5 V) | U3 | 1 | TPS63070RNMR | Texas Instruments | 2-16 V in buck-boost, 3.6 A switch, 2 A out @5 V | VQFN-HR-15 2.5x3 | JLCPCB/LCSC | C109322 | 1.1265 | 1.1265 | JLCPCB parts lib @10pcs (2026-10-17) | 33251 | extended | https://jlcpcb.com/partdetail/TexasInstruments-TPS63070RNMR/C109322 | STOCK OK (33,251 at JLCPCB = 33,251 boards' worth). SK uses TPS630702 (same die, output-discharge on; $2.72, 146 pcs). TPS63070 is $1.14 with 31k stock. VIN max 16 V -> PD max-voltage strap must stay <= 9 V (15 V only with margin loss).
Power | LM61460 output caps (3.3 V) | C8-C11 | 4 | CL31A476MPHNNNE | Samsung | 47 uF 10 V X5R 20 % MLCC | 1206 | JLCPCB/LCSC | C96123 | 0.1803 | 0.7212 | JLCPCB parts lib @40pcs (2026-10-17) | 410152 | basic | https://jlcpcb.com/partdetail/97327-CL31A476MPHNNNE/C96123 | STOCK OK (410,152 at JLCPCB = 102,538 boards' worth).
Power | Bulk 22 uF 25 V: PPHV/VMAIN (2) + TPS63070 output (3) | C1-C5 | 5 | CL31A226KAHNNNE | Samsung | 22 uF 25 V X5R 10 % MLCC | 1206 | JLCPCB/LCSC | C12891 | 0.1238 | 0.6190 | JLCPCB parts lib @50pcs (2026-10-17) | 491470 | basic | https://jlcpcb.com/partdetail/13537-CL31A226KAHNNNE/C12891 | STOCK OK (491,470 at JLCPCB = 98,294 boards' worth). PPHV needs 47-100 uF nominal total (TPS25730A table); VMAIN total with converter input caps = ~84 uF nominal.
Power | LM61460 input caps | C6,C7 | 2 | CL31A106KBHNNNE | Samsung | 10 uF 50 V X5R 10 % MLCC | 1206 | JLCPCB/LCSC | C13585 | 0.2554 | 0.5108 | JLCPCB parts lib @20pcs (2026-10-17) | 2288816 | basic | https://jlcpcb.com/partdetail/14236-CL31A106KBHNNNE/C13585 | STOCK OK (2,288,816 at JLCPCB = 1,144,408 boards' worth). One per VIN pin pair (HotRod symmetric input) + 0.1 uF HF each (in passives line).
Power | VBUS surge/ESD clamp | D1 | 1 | TVS2200DRVR | Texas Instruments | 22 V flat-clamp surge protection, 40 A 8/20 us | WSON-6 2x2 | JLCPCB/LCSC | C523793 | 0.4621 | 0.4621 | JLCPCB parts lib @10pcs (2026-10-17) | 1365 | extended | https://jlcpcb.com/partdetail/TexasInstruments-TVS2200DRVR/C523793 | STOCK OK (1,365 at JLCPCB = 1,365 boards' worth). TPS25730 datasheet recommends TVS2200 on VBUS (breakdown between 22 V rec-max and 28 V abs-max). Same as SK U69/U78.
Power | PMIC buck inductors (Buck1/2/3) | L3,L4,L5 | 3 | DFE252012F-R47M=P2 | Murata | 0.47 uH, Isat 7.4 A, Irms 4.9 A, DCR 23 mOhm | 2520 (1008) | JLCPCB/LCSC | C703140 | 0.1478 | 0.4434 | JLCPCB parts lib @30pcs (2026-10-17) | 1654 | extended | https://jlcpcb.com/partdetail/MurataElectronics-DFE252012F_R47MP2/C703140 | STOCK OK (1,654 at JLCPCB = 551 boards' worth). Meets DCR <= 50 mOhm and Isat >= 7.4 A (Buck1) / 5.4 A (Buck2/3). SK part DFE201612E-R47M has Isat 5.5 A only (OK for Buck2/3, not Buck1).
Power | USB-A VBUS current-limited switches (0.5 A each) | U9,U10 | 2 | TPS2051BDBVR | Texas Instruments | 0.5 A power-distribution switch, OC flag | SOT-23-5 | JLCPCB/LCSC | C24593 | 0.1942 | 0.3884 | JLCPCB parts lib @20pcs (2026-10-17) | 64563 | extended | https://jlcpcb.com/partdetail/TexasInstruments-TPS2051BDBVR/C24593 | STOCK OK (64,563 at JLCPCB = 32,281 boards' worth). Same function as SK U34 (TPS2051BD SOIC-8). FLT# to IO expander/GPIO.
Power | CC1/CC2 ESD (short-to-VBUS tolerant) | D2,D3 | 2 | PESD24VL1BA,115 | Nexperia | 24 V bidirectional ESD diode, IEC 61000-4-2 | SOD-323 | JLCPCB/LCSC | C69324 | 0.1749 | 0.3498 | JLCPCB parts lib @20pcs (2026-10-17) | 19256 | extended | https://jlcpcb.com/partdetail/Nexperia-PESD24VL1BA115/C69324 | STOCK OK (19,256 at JLCPCB = 9,628 boards' worth). Deviation from SK (TPD1E01B04, 6.4 V breakdown): a 24 V part does not defeat the TPS25730 CC short-to-VBUS (26 V) tolerance. CC cap budget 200-480 pF total.
Power | SD card VDD + VDDSHV5 IO supply dual switch | U8 | 1 | TPS22996DRLR | Texas Instruments | Dual 4 A 14 mOhm load switch, VIN 0.6 V-VBIAS, QOD | SOT-583-8 (DRL) | JLCPCB/LCSC | C34640248 | 0.3070 | 0.3070 | JLCPCB parts lib @10pcs (2026-10-17) | 18518 | extended | https://jlcpcb.com/partdetail/TexasInstruments-TPS22996DRLR/C34640248 | STOCK OK (18,518 at JLCPCB = 18,518 boards' worth). Ch1 VCC_3V3_SYS -> VDD_SD; Ch2 PMIC LDO1 (3.3/1.8 V) -> VDDSHV5. VBIAS = 3.3 V. Catalog part replaces SK TPS22996H-Q1 ($0.67, 32 pcs).
Power | PMIC buck output bulk (1 per buck) | C15-C17 | 3 | CL21A476MQYNNNE | Samsung | 47 uF 6.3 V X5R 20 % MLCC | 0805 | JLCPCB/LCSC | C16780 | 0.1016 | 0.3048 | JLCPCB parts lib @30pcs (2026-10-17) | 1545354 | basic | https://jlcpcb.com/partdetail/17464-CL21A476MQYNNNE/C16780 | STOCK OK (1,545,354 at JLCPCB = 515,118 boards' worth). Plus 1x 10 uF 0603 per buck (passives line). Total Cout within 10-75 uF (low BW) incl. SiP-internal caps; confirm BW mode in SLVUCL1.
Power | USB-A port VBUS bulk (>=120 uF per port) | C_USBA1,C_USBA2 | 2 | RYHV10V150UF6*5 | Honor Elec | 150 uF 10 V polymer aluminium, 105 C | SMD D6.3xL5.8 | JLCPCB/LCSC | C48970647 | 0.1409 | 0.2818 | JLCPCB parts lib @20pcs (2026-10-17) | 370 | extended | https://jlcpcb.com/partdetail/HonorElec-RYHV10V150UF65/C48970647 | STOCK OK (370 at JLCPCB = 185 boards' worth). USB 2.0 downstream-port bulk requirement. Polymer chosen over wet electrolytic for lifetime.
Power | 3.3 V IO rail load switch (VCC_3V3_SYS), ON = PMIC GPO2 | U5 | 1 | TPS22965DSGR | Texas Instruments | 5.7 V 6 A 16 mOhm load switch, QOD, CT slew | WSON-8 2x2 | JLCPCB/LCSC | C122837 | 0.2479 | 0.2479 | JLCPCB parts lib @10pcs (2026-10-17) | 15234 | extended | https://jlcpcb.com/partdetail/TexasInstruments-TPS22965DSGR/C122837 | STOCK OK (15,234 at JLCPCB = 15,234 boards' worth). CT = 220 pF (SK). QOD version (not -N) as TPS65219 app note requires active discharge on the GPO2 rail. SK uses DSGT (small reel, $0.66).
Power | Ethernet PHY 1.0 V core LDO (DP83867 VDD1P0) | U7 | 1 | TLV75710PDBVR | Texas Instruments | 1 A 1.0 V LDO with EN, from VDD_1V8 | SOT-23-5 | JLCPCB/LCSC | C2865385 | 0.2304 | 0.2304 | JLCPCB parts lib @10pcs (2026-10-17) | 2113 | extended | https://jlcpcb.com/partdetail/TexasInstruments-TLV75710PDBVR/C2865385 | STOCK OK (2,113 at JLCPCB = 2,113 boards' worth). Requested TLV75510PDBVR has 4 pcs at JLC / 0 at LCSC; TLV75710P is the 1 A family member in the same DBV pinout (IN/GND/EN/NC/OUT). Either fits the footprint.
Power | Analog 1.8 V / VPP / PHY 2.5 V ferrite beads | FB1-FB8 | 8 | BLM15PX121SN1D | Murata | Ferrite bead 120 Ohm@100 MHz, 2 A, 55 mOhm | 0402 | JLCPCB/LCSC | C88970 | 0.0283 | 0.2264 | JLCPCB parts lib @80pcs (2026-10-17) | 348880 | extended | https://jlcpcb.com/partdetail/MurataElectronics-BLM15PX121SN1D/C88970 | STOCK OK (348,880 at JLCPCB = 43,610 boards' worth). VDDA_1P8 CSIRX/USB/MCU/OLDI/PLL, VDDS_OSC0, DDR_VPP, PHY VDDA2P5 (SK uses 18 incl. 2nd PHY etc.).
Power | USB-C PD power input + USB0 data (USB2) | J1 | 1 | TYPE-C-31-M-12 | Korean Hroparts Elec | USB Type-C receptacle, 16-pin USB 2.0, 20 V / 5 A, SMD right-angle, THT shell pegs | SMD R/A | JLCPCB/LCSC | C165948 | 0.1865 | 0.1865 | JLCPCB parts lib @10pcs (2026-10-17) | 365172 | extended | https://jlcpcb.com/partdetail/Korean_HropartsElec-TYPE_C_31_M12/C165948 | STOCK OK (365,172 at JLCPCB = 365,172 boards' worth). D+/D- pass straight to SoC USB0 (device/DFU) via USB-section ESD; CC1/CC2 to U1. Upgrade option: GCT USB4105-GF-A-120 (C5184243, $0.72) for a heavier shell.
Power | Core analog ferrite beads (VDDA_CORE_USB / _CSIRX) | FB9,FB10 | 2 | BLM18SG260TN1D | Murata | Ferrite bead 26 Ohm@100 MHz, 6 A, 7 mOhm | 0603 | JLCPCB/LCSC | C87063 | 0.0848 | 0.1696 | JLCPCB parts lib @20pcs (2026-10-17) | 42914 | extended | https://jlcpcb.com/partdetail/MurataElectronics-BLM18SG260TN1D/C87063 | STOCK OK (42,914 at JLCPCB = 21,457 boards' worth). As SK FL4/FL7. Keep within the +/-1 % VDD_CORE vs VDDA_CORE_USB matching rule (7 mOhm x ~50 mA, negligible).
Power | 5 V buck-boost inductor | L2 | 1 | MWSA0402S-1R5MT | Sunlord | 1.5 uH, Isat 5.5 A, Irms 5 A, DCR 46 mOhm | 4.4x4.2 mm | JLCPCB/LCSC | C408334 | 0.1638 | 0.1638 | JLCPCB parts lib @10pcs (2026-10-17) | 623 | extended | https://jlcpcb.com/partdetail/Sunlord-MWSA0402S1R5MT/C408334 | STOCK OK (623 at JLCPCB = 623 boards' worth). Replaces Coilcraft XFL4020-152 (no JLC stock). Isat > TPS63070 4 A switch limit.
Power | Small MLCC 10 uF 10 V 0603 (PMIC buck POL x3, TPS25730 VIN_3V3/LDO_3V3 x2, TPS22965 out x1) | C18-C23 | 6 | CL10A106KP8NNNC | Samsung | 10 uF 10 V X5R MLCC | 0603 | JLCPCB/LCSC | C19702 | 0.0271 | 0.1626 | JLCPCB parts lib @60pcs (2026-10-17) | 11164607 | basic | https://jlcpcb.com/partdetail/20411-CL10A106KP8NNNC/C19702 | STOCK OK (11,164,607 at JLCPCB = 1,860,767 boards' worth).
Power | VBUS input cap (1) + TPS63070 input (2) | C12-C14 | 3 | CL21A106KAYNNNE | Samsung | 10 uF 25 V X5R 10 % MLCC | 0805 | JLCPCB/LCSC | C15850 | 0.0438 | 0.1314 | JLCPCB parts lib @30pcs (2026-10-17) | 6500138 | basic | https://jlcpcb.com/partdetail/16532-CL21A106KAYNNNE/C15850 | STOCK OK (6,500,138 at JLCPCB = 2,166,712 boards' worth). CVBUS 1-10 uF effective per TPS25730A (keeps USB-PD cSnkBulk limit).
Power | 3.3 V buck inductor | L1 | 1 | MWSA0603S-4R7MT | Sunlord | 4.7 uH, Isat 9 A, Irms 6 A, DCR 33 mOhm, molded | 7.0x6.6 mm | JLCPCB/LCSC | C408447 | 0.1096 | 0.1096 | JLCPCB parts lib @10pcs (2026-10-17) | 47178 | extended | https://jlcpcb.com/partdetail/Sunlord-MWSA0603S4R7MT/C408447 | STOCK OK (47,178 at JLCPCB = 47,178 boards' worth). Replaces Coilcraft XAL6060-472 (not in JLC library). Upgrade for more Isat margin vs LM61460 10.3 A typ HS limit: Bourns SRP7028A-4R7M (C840529, Isat 10 A, $0.97).
Power | Small MLCC 4.7 uF 10 V 0402 (PMIC PVIN_B1/B2/B3, PVIN_LDO34, TPS25730 LDO_1V5) | C24-C28 | 5 | CL05A475MP5NRNC | Samsung | 4.7 uF 10 V X5R MLCC | 0402 | JLCPCB/LCSC | C23733 | 0.0206 | 0.1030 | JLCPCB parts lib @50pcs (2026-10-17) | 2106975 | basic | https://jlcpcb.com/partdetail/24469-CL05A475MP5NRNC/C23733 | STOCK OK (2,106,975 at JLCPCB = 421,395 boards' worth).
Power | Small MLCC 100 nF 16 V 0402 (HF decoupling, BOOT, VAUX, VBIAS) | C44-C57 | 14 | CL05B104KO5NNNC | Samsung | 100 nF 16 V X7R MLCC | 0402 | JLCPCB/LCSC | C1525 | 0.0051 | 0.0714 | JLCPCB parts lib @140pcs (2026-10-17) | 24757160 | basic | https://jlcpcb.com/partdetail/1877-CL05B104KO5NNNC/C1525 | STOCK OK (24,757,160 at JLCPCB = 1,768,368 boards' worth).
Power | Resistors 0402 1 % (TPS25730 ADCIN straps + provision x4, LM61460 FB/EN-UVLO/RT/PG x6, TPS63070 FB/EN/PS/PG x5, PMIC EN/nRSTOUT/nINT/VSEL/GPO2 pulls x5, TPS2051B FLT pulls x2, VMON_VSYS 10k/1k1 x2, TPS22996 ON pulls x2, FAULT_IN pull x1, spare/DNP-option x13) | R8-R47 | 40 | 0402WGF1002TCE (and similar values) | UNI-ROYAL | Thick-film 0402 1 % 62.5 mW | 0402 | JLCPCB/LCSC | C25744 | 0.0015 | 0.0600 | JLCPCB parts lib @400pcs (2026-10-17) | 20292353 | basic | https://jlcpcb.com/partdetail/26487-0402WGF1002TCE/C25744 | STOCK OK (20,292,353 at JLCPCB = 507,308 boards' worth). All values available as JLC basic 0402WGFxxxxTCE at the same price.
Power | Small MLCC 1 uF 25 V 0402 (LDO in/out, TPS22996 in/out, TPS22965 in, LM61460 VCC) | C36-C43 | 8 | CL05A105KA5NQNC | Samsung | 1 uF 25 V X5R MLCC | 0402 | JLCPCB/LCSC | C52923 | 0.0068 | 0.0544 | JLCPCB parts lib @80pcs (2026-10-17) | 9087231 | basic | https://jlcpcb.com/partdetail/53938-CL05A105KA5NQNC/C52923 | STOCK OK (9,087,231 at JLCPCB = 1,135,903 boards' worth). Excludes 2x DNP caps on U6.
Power | 40-pin header 5 V protection | F1 | 1 | BSMD1206-110-6V | BHFUSE | PTC resettable fuse, 1.1 A hold / 2.2 A trip, 6 V | 1206 | JLCPCB/LCSC | C2803344 | 0.0516 | 0.0516 | JLCPCB parts lib @10pcs (2026-10-17) | 24034 | extended | https://jlcpcb.com/partdetail/BHFUSE-BSMD1206_1106V/C2803344 | STOCK OK (24,034 at JLCPCB = 24,034 boards' worth). Deviation from SK (TPS22946 150 mA switch, off by default): RPi-style always-on header 5 V with PTC.
Power | Small MLCC 100 nF 50 V 0603 (LM61460 VIN HF x2, VBUS/VMAIN HF x2) | C58-C61 | 4 | CC0603KRX7R9BB104 | YAGEO | 100 nF 50 V X7R MLCC | 0603 | JLCPCB/LCSC | C14663 | 0.0108 | 0.0432 | JLCPCB parts lib @40pcs (2026-10-17) | 31897660 | basic | https://jlcpcb.com/partdetail/YAGEO-CC0603KRX7R9BB104/C14663 | STOCK OK (31,897,660 at JLCPCB = 7,974,415 boards' worth).
Power | Small MLCC 2.2 uF 6.3 V 0402 (PMIC VSYS, VDD1P8, PVIN_LDO1/2, LDO1/3/4 out) | C29-C35 | 7 | CL05A225MQ5NSNC | Samsung | 2.2 uF 6.3 V X5R MLCC | 0402 | JLCPCB/LCSC | C12530 | 0.0054 | 0.0378 | JLCPCB parts lib @70pcs (2026-10-17) | 4363079 | basic | https://jlcpcb.com/partdetail/13164-CL05A225MQ5NSNC/C12530 | STOCK OK (4,363,079 at JLCPCB = 623,297 boards' worth).
Power | PMIC buck-output 0 Ohm test links (Buck1 x2 parallel, Buck2, Buck3) | R1-R4 | 4 | 1206W4F0000T5E | UNI-ROYAL | 0 Ohm jumper 1206 | 1206 | JLCPCB/LCSC | C17888 | 0.0085 | 0.0340 | JLCPCB parts lib @40pcs (2026-10-17) | 2202661 | basic | https://jlcpcb.com/partdetail/18576-1206W4F0000T5E/C17888 | STOCK OK (2,202,661 at JLCPCB = 550,665 boards' worth). SK D-note: 0 Ohm or jumper at buck outputs on pre-production boards. Two in parallel on Buck1 (2.7 A).
Power | Small MLCC C0G pF caps (VMON 22 pF, TPS22965 CT 220 pF, CC 2x ~390 pF, spare) | C62-C66 | 5 | 0402CG220J500NT (and similar values) | FH (Fenghua) | C0G 50 V 0402, 22-390 pF | 0402 | JLCPCB/LCSC | C1555 | 0.0026 | 0.0130 | JLCPCB parts lib @50pcs (2026-10-17) | 1917153 | basic | https://jlcpcb.com/partdetail/1907-0402CG220J500NT/C1555 | STOCK OK (1,917,153 at JLCPCB = 383,430 boards' worth). Priced at the 22 pF basic part; other C0G 0402 values in the basic library are the same ~$0.002-0.003.
Power | PMIC LDO-output 0 Ohm test links (LDO1, LDO3, LDO4) | R5-R7 | 3 | 0603WAF0000T5E | UNI-ROYAL | 0 Ohm jumper 0603 | 0603 | JLCPCB/LCSC | C21189 | 0.0022 | 0.0066 | JLCPCB parts lib @30pcs (2026-10-17) | 23656090 | basic | https://jlcpcb.com/partdetail/21903-0603WAF0000T5E/C21189 | STOCK OK (23,656,090 at JLCPCB = 7,885,363 boards' worth).
Power | SoC VPP eFuse LDO 1.8 V, GPIO-enabled | U6 | 0 | TLV75518PDBVR | Texas Instruments | 500 mA 1.8 V LDO with EN | SOT-23-5 | JLCPCB/LCSC | C2877863 | 0.2049 | 0.0000 | JLCPCB parts lib @10pcs (2026-10-17) | 8540 | extended | https://jlcpcb.com/partdetail/TexasInstruments-TLV75518PDBVR/C2877863 | STOCK OK (8,540 at JLCPCB = 8,540 boards' worth). DNP by default (footprint + 2x 1 uF DNP). Never tie 1.8 V permanently to VPP. Price shown for reference; ext = 0.
Power | ALT: PMIC in RHB package (SK footprint) | (U4 alt) | 0 | TPS6521904RHBR | Texas Instruments | TPS65219 NVM 04, 5x5 mm 0.5 mm pitch | VQFN-32 5x5 (RHB) | JLCPCB/LCSC | C19274407 | 4.6201 | 0.0000 | JLCPCB parts lib @10pcs (2026-10-17) | 19 | extended | https://jlcpcb.com/partdetail/TexasInstruments-TPS6521904RHBR/C19274407 | STOCK RISK (19 at JLCPCB = 19 boards' worth: enough for 10, not 50). Only if you keep the SK RHB footprint: JLC/LCSC 19 pcs (enough for 10 boards, not 50); Digi-Key 0, Mouser 0 (2,894 expected 02-Nov-2026), TI store out of stock. Different footprint from U4 - decide before layout.
Power | ALT: PD sink controller A revision (PD3.2, pin-compatible) | (U1 alt) | 0 | TPS25730ADREFR | Texas Instruments | TPS25730A PD3.2-certified sink, same REF package/pinout | WQFN-38 4x6 (REF) | JLCPCB/LCSC | C55128590 | 2.1925 | 0.0000 | JLCPCB parts lib @10pcs (2026-10-17) | 39 | extended | https://jlcpcb.com/partdetail/TexasInstruments-TPS25730ADREFR/C55128590 | STOCK RISK (39 at JLCPCB = 39 boards' worth: enough for 10, not 50). JLC 39 pcs; Digi-Key 296-TPS25730ADREFRCT-ND 1,739 pcs $2.219@10 (20 wk). Dead-battery mode differs: A = EnableSinkAfterContract (set ADCIN3/4 operating current to 0.5 A so 5 V/500 mA sources still enable the path).
Power | ALT: Buck1 inductor with more Isat margin | (L3 alt) | 0 | DFE322520F-R47M=P2 | Murata | 0.47 uH, Isat 8.5 A, DCR 16 mOhm | 3225 (1210) | JLCPCB/LCSC | C5711365 | 0.7559 | 0.0000 | JLCPCB parts lib @10pcs (2026-10-17) | 203 | extended | https://jlcpcb.com/partdetail/6634885-DFE322520F_R47MP2/C5711365 | STOCK OK (203 at JLCPCB = 203 boards' worth). Optional for Buck1 only.
Clock+Reset+Boot | SoC MCU_OSC0 25 MHz LVCMOS clock (VDDS_OSC0 1.8 V; XO to VSS) | Y1 | 1 | ECS-2520MV-250-CN-TR | ECS Inc | Oscillator 25 MHz HCMOS 1.6-3.6 V +/-25 ppm | 2.5x2.0 mm SMD-4 | LCSC/JLCPCB | C405464 | 1.3387 | 1.3387 | JLCPCB parts library price @ order qty 10 (10 boards x 1/board for this C#), 2026-10-17 | 3477 | Extended | https://www.lcsc.com/product-detail/crystal-oscillators_ecs-ecs-2520mv-250-cn-tr_C405464.html | Exact part fitted on SK-AM62B-P1 BOM (U53). Alt: YXC OT252025MJBA4SL C717683 $0.498 @10 (1.8-3.3 V, +/-20 ppm, 7430 stk); TI D-note part LMK6CE02500DDLFR C22454733 $2.6055 @10 but only 11 in stock.
Clock+Reset+Boot | BOOTMODE[6:3] boot-device select DIP switch | SW1 | 1 | 2.54-4P TPGT | SHOU HAN | DIP switch 4-pos SPST slide (raised), gold, 2.54 mm | SMD gull-wing 2.54 mm | LCSC/JLCPCB | C6331176 | 0.4229 | 0.4229 | JLCPCB parts library price @ order qty 10 (10 boards x 1/board for this C#), 2026-10-17 | 45433 | Extended | https://www.lcsc.com/product-detail/dip-switches_shou-han-2-54-4p-tpgt_C6331176.html | Alt half-pitch 1.27-4P TPPT C6386919 $0.3968 @10 (smaller, recessed). Balls GPMC0_AD3-6 carry no display function so a switch is safe there.
Clock+Reset+Boot | Reset AND gates: SoC_PORz/JTAG-nRST + peripheral resets AND(RESETSTATz, GPIO) for eMMC, PHY, HDMI bridge, USB hub | U (5x) | 5 | SN74LVC1G08DBVR | Texas Instruments | Single 2-input AND, 1.65-5.5 V | SOT-23-5 | LCSC/JLCPCB | C7666 | 0.0449 | 0.2245 | JLCPCB parts library price @ order qty 50 (10 boards x 5/board for this C#), 2026-10-17 | 69792 | Extended | https://www.lcsc.com/product-detail/logic-gates_texas-instruments-sn74lvc1g08dbvr_C7666.html | SK uses 7x 1G08 + 4x 1G11; this board has fewer reset targets.
Clock+Reset+Boot | Button debounce Schmitt buffers: RESET_REQz and USER button | U (1x) | 1 | SN74LVC2G17DBVR | Texas Instruments | Dual Schmitt-trigger buffer | SOT-23-6 | LCSC/JLCPCB | C10429 | 0.2170 | 0.2170 | JLCPCB parts library price @ order qty 10 (10 boards x 1/board for this C#), 2026-10-17 | 61719 | Extended | https://www.lcsc.com/product-detail/buffers-drivers-receivers-transceivers_texas-instruments-sn74lvc2g17dbvr_C10429.html | Power button goes straight to PMIC EN/PB (PMIC deglitches). SK used SN74LVC3G17DCUR (C68245 $0.3396 @10) if a third channel is wanted.
Clock+Reset+Boot | WKUP_LFOSC0 32.768 kHz crystal (CL 6-12 pF) | Y2 | 1 | Q13FC13500003 | Seiko Epson | Crystal 32.768 kHz 9 pF +/-20 ppm ESR 70k | 3.2x1.5 mm SMD-2 | LCSC/JLCPCB | C99010 | 0.2035 | 0.2035 | JLCPCB parts library price @ order qty 10 (10 boards x 1/board for this C#), 2026-10-17 | 45939 | Extended | https://www.lcsc.com/product-detail/crystals_seiko-epson-q13fc13500003_C99010.html | Same 9 pF CL / 70k ESR / 3215 footprint as SK part ECS-.327-9-34QCS-TR (LCSC C5682941 $1.4432 @10, 150 stk). JLC basic 32k (C32346) is 12.5 pF = outside the 6-12 pF spec, so not used.
Clock+Reset+Boot | MCU_PORz driver AND3 (PMIC nRSTOUT, JTAG nSRST, spare) in 1.8 V domain, 22 pF filter | U (1x) | 1 | 74LVC1G11GW,125 | Nexperia | Single 3-input AND, 1.65-5.5 V, 5.5 V-tolerant Schmitt inputs, IOFF | SC-88 / SOT363 (SC70-6 land) | JLCPCB/LCSC | C282348 | 0.1089 | 0.1089 | JLCPCB parts library 1+ break, 2026-11-09 | JLC 27,882; Mouser 2,810 (771-LVC1G11GW125) | Extended | https://www.lcsc.com/product-detail/C282348.html | Replaces SN74LVC1G11DCKR (C529281): 0 at Digi-Key and Mouser on 2026-11-09. Same pins as TI DCK (A1 GND2 B3 Y4 VCC5 C6), same SC70-6 footprint. Fast-edge gate required by SK D-note (not slow open-drain PGOOD). Could be a 1G08 if only 2 inputs are used.
Clock+Reset+Boot | Button ESD (one per button, SK D12/D13/D15) | D (3x) | 3 | TPD1E10B06DPYR | Texas Instruments | 1-ch bidirectional ESD 6 V | X1SON-2 (0402) | LCSC/JLCPCB | C48260 | 0.0446 | 0.1338 | JLCPCB parts library price @ order qty 40 (10 boards x 4/board for this C#), 2026-10-17 | 288846 | Extended | https://www.lcsc.com/product-detail/esd-and-surge-protection-tvs-esd_texas-instruments-tpd1e10b06dpyr_C48260.html
Clock+Reset+Boot | Push buttons: POWER (PMIC PB), RESET (RESET_REQz), USER (MCU GPIO) | SW2-SW4 | 3 | TS-1187A-B-A-B | XKB Connection | Tactile switch SPST 5.1x5.1 mm, 1.5 mm actuator | SMD-4P 5.1x5.1 | LCSC/JLCPCB | C318884 | 0.0206 | 0.0618 | JLCPCB parts library price @ order qty 30 (10 boards x 3/board for this C#), 2026-10-17 | 294963 | Basic | https://www.lcsc.com/product-detail/tactile-switches_xkb-connection-ts-1187a-b-a-b_C318884.html | JLC Basic part (no feeder fee).
Clock+Reset+Boot | BOOTMODE fixed straps (BOOTMODE[15:7] and [2:0]: 25 MHz=011, backup boot, VOUT0-shared bits) | R (12x) | 12 | 0402WGF1002TCE | UNI-ROYAL | Res 10 k 1% 0402 | 0402 | LCSC/JLCPCB | C25744 | 0.0015 | 0.0180 | JLCPCB parts library price @ order qty 480 (10 boards x 48/board for this C#), 2026-10-17 | 20292880 | Basic | https://www.lcsc.com/product-detail/chip-resistor-surface-mount_uni-royal-uniroyal-elec-0402wgf1002tce_C25744.html | Each bit gets its own resistor (never tie bits together/rails). Lay out both PU and PD pads; only one fitted (DNP pads cost nothing).
Clock+Reset+Boot | BOOTMODE[6:3] DIP pull-ups (switch ON = 1) | R (4x) | 4 | 0402WGF1001TCE | UNI-ROYAL | Res 1 k 1% 0402 | 0402 | LCSC/JLCPCB | C11702 | 0.0035 | 0.0140 | JLCPCB parts library price @ order qty 80 (10 boards x 8/board for this C#), 2026-10-17 | 13763230 | Basic | https://www.lcsc.com/product-detail/chip-resistor-surface-mount_uni-royal-uniroyal-elec-0402wgf1001tce_C11702.html
Clock+Reset+Boot | BOOTMODE[6:3] pull-downs behind DIP switch | R (4x) | 4 | 0402WGF4702TCE | UNI-ROYAL | Res 47 k 1% 0402 | 0402 | LCSC/JLCPCB | C25792 | 0.0026 | 0.0104 | JLCPCB parts library price @ order qty 40 (10 boards x 4/board for this C#), 2026-10-17 | 4979344 | Basic | https://www.lcsc.com/product-detail/chip-resistor-surface-mount_uni-royal-uniroyal-elec-0402wgf4702tce_C25792.html | Octavo checklist: 47 k / 470 R-2 k divider when a DIP switch is used.
Clock+Reset+Boot | 32.768 kHz load capacitors | C (Y2) | 2 | 0402CG180J500NT | FH (Fenghua) | Cap C0G 18 pF 50 V 0402 | 0402 | LCSC/JLCPCB | C1549 | 0.0027 | 0.0054 | JLCPCB parts library price @ order qty 20 (10 boards x 2/board for this C#), 2026-10-17 | 790731 | Basic | https://www.lcsc.com/product-detail/multilayer-ceramic-capacitors-mlcc-smd-smt_fh-guangdong-fenghua-advanced-tech-0402cg180j500nt_C1549.html | SK rev-B design update uses 18 pF on LFOSC0 with a 9 pF crystal (C75/C79). Tune on first boards.
Storage | eMMC module board-side signal connector (34-pin plug) | J_EMMC1 | 1 | GB042-34P-H10-E3000 | LS Mtron (LS/LG Cable) | B2B plug 34P 0.4mm pitch, 1.0mm mated height; mates with GB042-34S-H10 on Hardkernel/Pine64/Radxa eMMC modules | SMD 2x17 0.4mm | IC Components Ltd (HK broker); consign to JLC | GB042-34P-H10-E3000 | 0.60 | 0.60 | EST: broker listings ~$0.50-0.57/pc (digipart/LRC listing); not stocked by LCSC/Digi-Key/Mouser | 2740 (broker claim; Jotrin claims 7310 for GB042-34P-H10) | Consigned (not in JLC library) | https://www.ic-components.com/products/1b3719006/GB042-34P-H10-E3000.pdf | STOCK RISK: broker-only part (no LCSC/Digi-Key/Mouser stock; JLC library has only placeholder C99000xxxx entries). Order ~20 pcs early, verify mating with a real module, ship to JLC as customer-supplied part. No in-stock mating-compatible equivalent exists at authorized distributors; fallback is a soldered BGA153 eMMC (see notes).
Storage | microSD socket push-push with card-detect | J_SD1 | 1 | TF-01A | Korean Hroparts Elec | microSD push-push, 8 contacts + CD switch, 1.85mm height, locating pins | SMD | JLCPCB/LCSC | C91145 | 0.1927 | 0.1927 | JLC parts library @10 pcs (1+ break) | 184825 | Extended | https://jlcpcb.com/partdetail/Korean_HropartsElec-TF01A/C91145 | STOCK OK. Replaces GCT MEM2051-00-195-00-A (C5137462: JLC stock 0). Contacts Ag-plated, 5000 cycles. Gold-contact alternate: Hirose DM3AT-SF-PEJM5 C114218 ($1.164, stock 16552).
Storage | microSD ESD array (CLK/CMD/DAT0-3/CD; 8 ch over 2 parts) | U_SDESD1-2 | 2 | TPD4E05U06DQAR | Texas Instruments | 4-ch ESD, 0.5pF, flow-through, IEC 61000-4-2 | USON-10 1x2.5 | JLCPCB/LCSC | C138714 | 0.083 | 0.166 | JLC parts library @20 pcs (1+ break) | 215912 | Extended | https://jlcpcb.com/partdetail/TexasInstruments-TPD4E05U06DQAR/C138714 | STOCK OK. Replaces TPD6E001RSER (C1973318 $0.33, stock 852) + TPD2E001DRLR (C150526 $0.161): cheaper and lower capacitance (0.5pF) for SDR104.
Storage | Storage passives (SD: 6x47k pull-ups incl CD, 100R CD series, CLK direct (0R link dropped 2026-11-10), 10uF+0.1uF; eMMC: 22R CLK, 3x10k (CMD/DAT0 pull-ups + RST_n pull-up), 0R RST link DNI, 10uF+4.7uF+3x0.1uF) | R/C various | 18 | various 0402/0603 (C25792 C25076 C25092 C25744 C19702 C23733 C1525) | UNI-ROYAL / Samsung | 0402 1% resistors, 0402/0603 X5R/X7R caps | 0402/0603 | JLCPCB/LCSC | various basic | 0.0083 | 0.15 | EST: sum of JLC basic unit prices (~$0.12) rounded up | >1M each | Basic | https://jlcpcb.com/parts | STOCK OK (all JLC basic, >1M stock).
Storage | eMMC module mounting connector (30-pin plug) - footprint only | J_EMMC2 | 0 | GB042-30P-H10-E3000 | LS Mtron (LS/LG Cable) | B2B plug 30P 0.4mm, mechanical only (no signals) for Radxa dual-connector modules | SMD 2x15 0.4mm | IC Components Ltd (HK broker) | GB042-30P-H10-E3000 | 0.55 | 0.00 | EST: broker listing; DNP so not in subtotal | 2656 (broker claim) | Consigned | https://www.ic-components.com/ | STOCK RISK (broker-only) - therefore DNP: keep footprint, do not populate. 34-pin-only hosts work with all module brands (Radxa forum; ROCKPro64/ODROID are 34-pin only).
USB | USB 2.0 hub controller (USB1 -> 2 downstream used of 4) | U_HUB1 | 1 | CH335F | WCH (Jiangsu Qin Heng) | USB2.0 HS 4-port hub, MTT, per-port power/OC control, -40~85C, 6kV ESD on USB pins, V5+VDD33 tied to single 3.3V | QFN-28 4x4 0.4mm | JLCPCB/LCSC | C5137013 | 0.9192 | 0.9192 | JLC parts library @10 pcs (10+ break) | 6199 | Extended | https://jlcpcb.com/partdetail/WCH_Jiangsu_Qin_Heng-CH335F/C5137013 | STOCK OK. Class-compliant hub (no driver). Cheaper sibling CH334F C5187527 $0.532 stock 8489 (GANG power/OC only). Conservative fallback: Microchip USB2514BI-AEZG-TR C58940 $2.04 stock 9424 (needs 24MHz xtal + caps + 12k RBIAS).
USB | USB-A port ESD (D+/D-/VBUS per port) | U_USBESD1-2 | 2 | USBLC6-2SC6 | STMicroelectronics | 2-line ESD + VBUS rail clamp, USB2.0 HS rated | SOT-23-6 | JLCPCB/LCSC | C7519 | 0.1774 | 0.3548 | JLC parts library @20 pcs (1+ break) | 34334 | Extended | https://jlcpcb.com/partdetail/STMicroelectronics-USBLC62SC6/C7519 | STOCK OK. Replaces TPD4S012DRYR (C96506 $0.392, stock 13613) at less than half the cost. Budget: TECH PUBLIC USBLC6-2SC6 C2827654 $0.045.
USB | USB0 D+/D- ESD | D_USB0 | 1 | ESD122DMXR | Texas Instruments | 2-ch bidirectional ESD 0.2pF (SK part) | X2SON-3 0.6x1 | JLCPCB/LCSC | C544474 | 0.3476 | 0.3476 | JLC parts library @10 pcs | 34664 | Extended | https://jlcpcb.com/partdetail/TexasInstruments-ESD122DMXR/C544474 | STOCK OK. USB0 path: CHECK NOT DOUBLE-COUNTED with USB-C/power section. Not USBLC6 here because PD VBUS may exceed 5.25V.
USB | USB-A receptacle dual stacked (2 host ports) | J_USBA1 | 1 | 61400826021 | Wurth Elektronik | WR-COM USB 2.0 Type-A female x2 stacked, right angle, THT | THT right-angle | Digi-Key | 732-2107-ND | 1.7690 | 1.7690 | Digi-Key qty-10 break, 2026-11-09 | Digi-Key 14,585; Mouser 12,279 (710-61400826021) | global sourcing or consign (JLC C5366339 had 99 on 2026-10-17) | https://www.digikey.com/en/products/detail/w%C3%BCrth-elektronik/61400826021/2060603 | Replaces Bossie BX-TYPE-A-MWC44 (C18077688, JLC 349; not at Digi-Key/Mouser). Fits the USBA_2X_BX-TYPE-A-MWC44 land: KiCad USB_A_Wuerth_61400826021_Horizontal_Stacked has the same 13.14 x 5.68 peg grid and 2.0/2.5 contact pitch; its front contact row is 0.09 mm off ours (0.90 mm holes). Body 14.5 x 17.0 mm, about 0.3 mm more overhang at the mating face. THT -> JLC THT assembly fee applies.
USB | USB passives (hub: 2x1uF, 3x0.1uF, 10uF, 2x10k PSELF/RESET; 2x22uF VBUS bulk at USB-A; USB0_VBUS divider 3.48k/16.5k/10k 1%; the 6x 0R CMC bypass DNP were dropped 2026-11-10) | R/C various | 7 | various 0402/0603/0805 | UNI-ROYAL / Samsung | 0402 1% resistors, ceramic caps | 0402/0603/0805 | JLCPCB/LCSC | various basic | 0.0115 | 0.15 | EST: JLC basic unit prices (~$0.13) rounded up | >1M each | Basic | https://jlcpcb.com/parts | STOCK OK. USB spec 120uF/port VBUS bulk assumed with port power switches (power section).
USB | USB-A D+/D- common-mode choke (fit; no bypass) | L_USBA1-2 | 2 | SDCW2012-2-900TF | Sunlord | CMC 90 ohm @100MHz, 330mA, 0805 | SMD-4P 2.0x1.2 | JLCPCB/LCSC | C54888 | 0.0593 | 0.1186 | JLC parts library @20 pcs (1+ break) | 65898 | Extended | https://jlcpcb.com/partdetail/Sunlord-SDCW2012_2900TF/C54888 | STOCK OK. Replaces Murata DLW21SZ900HQ2B (not in JLC library). The 0R bypass footprints were dropped on 2026-11-10.
USB | Hub crystal 12 MHz (no external load caps; CH335 has ~16pF internal) | Y_HUB1 | 1 | FL1200074 | Diodes Incorporated | 12MHz +/-20ppm tol, +/-20ppm stab, CL 20pF, -40..85 C, 3225 | SMD3225-4P | Digi-Key | 31-FL1200074CT-ND | 0.5640 | 0.5640 | Digi-Key cut tape qty-10 break (20 pcs with the FT4232 crystal is the same break), 2026-11-09 | Digi-Key 3,118 (+153,000 factory) | global sourcing or consign | https://www.digikey.com/en/products/detail/diodes-incorporated/FL1200074/9766596 | Replaces YXC X322512MSB4SI (C9002, JLC Basic; not at Digi-Key/Mouser). Pins 1/3 Xtal, 2/4 Case as before: same symbol and XTAL_3225_4P. WCH: do not fit external load caps. CL mismatch -> few-tens ppm offset, well inside USB +/-500ppm. Crystal-less mode exists but WCH says it may deviate from USB spec; not recommended.
USB | USB0 (USB-C device port) D+/D- common-mode choke | L_USB0 | 1 | SDCW2012-2-900TF | Sunlord | CMC 90 ohm @100MHz, 0805, no bypass | SMD-4P 2.0x1.2 | JLCPCB/LCSC | C54888 | 0.0593 | 0.0593 | JLC parts library @10 pcs | 65898 | Extended | https://jlcpcb.com/partdetail/Sunlord-SDCW2012_2900TF/C54888 | STOCK OK. USB0 path: CHECK NOT DOUBLE-COUNTED with the USB-C/power section.
USB | USB0_VBUS clamp zener 6.8V (AM62x DS Fig 8-4 divider) | D_VBUS0 | 1 | LBZX84C6V8LT1G | LRC | Zener 6.8V SOT-23 (BZX84C6V8 equivalent) | SOT-23 | JLCPCB/LCSC | C12746 | 0.019 | 0.019 | JLC parts library @10 pcs | 18902 | Extended | https://jlcpcb.com/partdetail/LRC-LBZX84C6V8LT1G/C12746 | STOCK OK. Verify leakage <100nA @5V per AM62x DS; onsemi BZX84C6V8LT1G C90848 $0.05 stock 5628 if LRC data insufficient. CHECK NOT DOUBLE-COUNTED with power section.
Ethernet | Gigabit Ethernet PHY (RGMII1) | U_PHY1 | 1 | DP83867ISRGZR | Texas Instruments | 10/100/1000 PHY, RGMII (+SGMII unused), -40~85C, VDDIO 3.3V, 2-supply mode 2.5V+1.0V | VQFN-48 7x7 | JLCPCB/LCSC | C543036 | 4.5303 | 4.5303 | JLC parts library @10 pcs (10+ break) | 777 (LCSC 773) | Extended | https://jlcpcb.com/partdetail/TexasInstruments-DP83867ISRGZR/C543036 | STOCK OK (77 boards). Pin-compatible superset of the SK's DP83867IRRGZ (IR: LCSC IRRGZR stock 0, IRRGZT stock 14 = STOCK RISK; Digi-Key IRRGZR 0 stock, ETA 2027-02-02). Same Linux dp83867 driver/PHY ID. Keep SGMII off (LED_1 strap default); fit dummy straps on RX_D1/RX_D3 if RX_D0/RX_D2 strapped. CS (0-70C) is NOT cheaper: LCSC $5.48, Digi-Key $5.31 @10.
Ethernet | RJ45 with integrated 1000BASE-T magnetics + 2 LEDs | J_ETH1 | 1 | HR911130A | HanRun | 1x RJ45, 100/1000Base-T magnetics (IEEE802.3ab), Bob-Smith 4x75R+1nF/2kV, green/yellow LEDs, shielded | THT right-angle | JLCPCB/LCSC | C54408 | 2.3541 | 2.3541 | JLC parts library @10 pcs (10+ break) | 20781 (LCSC 1707) | Extended | https://jlcpcb.com/partdetail/55426-HR911130A/C54408 | STOCK OK. Gigabit verified from HanRun datasheet. 0-70C rated. Replaces LINK-PP LPJG16314A4NL (C22456563 stock 10 = STOCK RISK, $4.38). THT -> JLC THT fee. Common chip-side center tap (P1) -> 0.1uF to GND.
Ethernet | Ethernet passives (decoupling per DP83867 Fig 9-7: ~9x1uF, ~10x0.1uF, 3x10uF, 3x10nF; 2x 15-18pF xtal; 2x 470R LED; 2.2k MDIO pull-up; 2x10k RESET/INT; 62R+47pF INT RC; 0.1uF center tap) | R/C various | 34 | various (C52923 C1525 C19702 C1549 C25117 C25879 C25744) | Samsung / UNI-ROYAL / FH | 0402/0603 ceramic caps and 0402 resistors | 0402/0603 | JLCPCB/LCSC | various basic | 0.0074 | 0.25 | EST: JLC basic unit prices (~$0.22) rounded up | >790k each | Basic | https://jlcpcb.com/parts | STOCK OK. PHY 2.5V and 1.0V rails/regulators NOT included (power section).
Ethernet | PHY crystal 25 MHz | Y_PHY1 | 1 | X322525MOB4SI | YXC | 25MHz +/-10ppm (+/-20ppm over temp), CL 12pF, 3225 | SMD3225-4P | JLCPCB/LCSC | C9006 | 0.0949 | 0.0949 | JLC parts library @10 pcs | 244430 | Basic | https://jlcpcb.com/partdetail/YXC_CrystalOscillators-X322525MOB4SI/C9006 | STOCK OK. Meets DP83867 25MHz +/-50ppm. Load caps 2x 15-18pF (in Ethernet passives line).
Ethernet | PHY strap resistors (4-level straps RX_D0, RX_D2, RX_CTRL mode3/4, GPIO_0/1, LED_0/1/2 + dummy RX_D1/RX_D3) | R_STRAP | 12 | 0402 1% various (e.g. C25744 10k / C25905 5.1k / C25768 22k) | UNI-ROYAL | 0402 1% strap resistors (count EST) | 0402 | JLCPCB/LCSC | various basic | 0.0021 | 0.025 | EST: JLC basic $0.0012-0.0026 | >1M each | Basic | https://jlcpcb.com/parts | STOCK OK. Count from DP83867 strap table + SK sheet p.25 (~36 R per PHY incl. series).
Ethernet | RGMII series resistors 22R (6 TX at SoC + 6 RX at PHY) | R_RGMII | 12 | 0402WGF220JTCE | UNI-ROYAL | 22R 1% 0402 | 0402 | JLCPCB/LCSC | C25092 | 0.0015 | 0.018 | JLC parts library @120 pcs | 3973188 | Basic | https://jlcpcb.com/partdetail/25835-0402WGF220JTCE/C25092 | STOCK OK. RX set may be 0R per SI sim (SK practice).
Ethernet | PHY RBIAS 11k 1% | R_RBIAS | 1 | 0402WGF1102TCE | UNI-ROYAL | 11k 1% 0402 | 0402 | JLCPCB/LCSC | C25749 | 0.0021 | 0.0021 | JLC parts library @10 pcs | 255608 | Extended | https://jlcpcb.com/partdetail/26492-0402WGF1102TCE/C25749 | STOCK OK. SK D-note: value tuned (reduced from 11k + parallel cap) for compliance; keep footprint for a cap.
HDMI | DPI (24-bit RGB) to HDMI-connector TMDS transmitter (DVI 1.0) | U_HDMI | 1 | TFP410PAPR | Texas Instruments | PanelBus DVI transmitter, 25-165 MHz (1080p60 OK), 24-bit single-edge 3.3V input, strap config (I2C optional), 3.3V only | HTQFP-64 10x10 PowerPAD | JLCPCB/LCSC | C7498519 | 4.6021 | 4.6021 | JLC 10+ break (build qty 10); checked 2026-10-17 | JLC 110 / LCSC 109; TI.com 11,487 ($7.097 @1-99); Digi-Key 0 (1,000 due 2027-10-07) | Extended | https://jlcpcb.com/partdetail/TexasInstruments-TFP410PAPR/C7498519 | STOCK OK (110 = 110 boards). RECOMMENDED after SiI9022A was dropped (no stock). Mainline drm/bridge ti-tfp410 (compatible ti,tfp410; strap mode needs no I2C; optional powerdown-gpios, ti,deskew). Video only: no HDMI audio/CEC/infoframes, audio from codec. 3.3V only (DVDD/PVDD/TVDD), IDD 200 typ/250 mA max; no crystal, no 1.2V rail. RTFADJ 510R 1% to TVDD. 0-70C part. Tray alt TFP410PAP C1543847 (LCSC 394, $5.57).
HDMI | HDMI companion: 5V load switch, DDC/CEC/HPD level shift, 12-ch ESD | U_HDMI_ESD | 1 | TPD12S016PWR | Texas Instruments | HDMI companion IC, 55 mA 5V switch, DDC level shift with pull-ups, HPD buffer, ESD | TSSOP-24 | JLCPCB/LCSC | C201665 | 0.9453 | 0.9453 | JLC 10+ break; checked 2026-10-17 | JLC 3,447; TI.com 20,549 | Extended | https://jlcpcb.com/partdetail/TexasInstruments-TPD12S016PWR/C201665 | STOCK OK. SK part. With TFP410 the SoC reads EDID over DDC (hdmi-connector ddc-i2c-bus) and HPD goes to a GPIO through this part.
HDMI | HDMI type-A receptacle | J_HDMI | 1 | HDMI-A-19F-S-D | XFCN | HDMI-A 19P female, right-angle, SMD | SMD RA | JLCPCB/LCSC | C5151728 | 0.1852 | 0.1852 | JLC 1+ break (next break 50); checked 2026-10-17 | JLC 3,436 / LCSC 3,060 | Extended | https://jlcpcb.com/partdetail/XFCN-HDMI_A_19F_SD/C5151728 | STOCK OK. SK part Amphenol 10029449-001RLF (JLC C428493, $1.17) has only 3 in stock (STOCK RISK). Use vendor footprint.
HDMI | HDMI section passives (rough) | C/R/FB_HDMI | 1 | various | various | ~8x100nF, 2x1uF, 3x10uF 0402; 1x 600R bead 0805 (PVDD); RTFADJ 510R 1% (C25123); ~7x 0402 R (ISEL/BSEL/DSEL/EDGE/DKEN/PD straps, 22R IDCK series) | 0402/0805 | JLCPCB basic | C1525/C52923/C15525/C1017/C25123/C25744 | 0.15 | 0.15 | EST: sum of JLC basic unit prices (100nF $0.0051, 1uF $0.0068, 10uF $0.0257, bead $0.020, R ~$0.0015) | JLC basic, >1M each | Basic | https://jlcpcb.com/parts | ~22 parts. STOCK OK (JLC basic parts, >1M each).
HDMI | ALT in-stock full HDMI + audio bridge (not in subtotal) | U_HDMI | 0 | ADV7513BSWZ | Analog Devices | HDMI 1.4 TX, 24-bit RGB in, 1080p60, I2S/SPDIF audio, CEC, I2C | LQFP-64 10x10 | JLCPCB/LCSC | C408901 | 26.5464 | 0.0 | JLC 1-29 break; checked 2026-10-17 | JLC 93 / LCSC 90 | Extended | https://jlcpcb.com/partdetail/AnalogDevices-ADV7513BSWZ/C408901 | STOCK OK (93 boards). Upgrade path if HDMI audio is required: mainline adv7511 driver (adv7513 compatible) with hdmi-codec audio. Needs 1.8V + 3.3V. +$21.9/board vs TFP410. ADV7511KSTZ (LQFP-100, JLC C179459 $13.23, 44 pcs) is cheaper but <50 boards.
HDMI | DROPPED: SK bridge (not in subtotal) | U_HDMI | 0 | SII9022ACNU | Lattice Semiconductor | HDMI 1.4a TX, 24-bit RGB in, I2S audio | QFN-72 10x10 | Digi-Key | SII9022ACNU-ND | 5.85 | 0.0 | Digi-Key 1-24 break; checked 2026-10-17 | DK 0 (104 due 2027-01-18); LCSC/JLC C369565 0; Mouser non-stocked | Extended (0 stock) | https://www.digikey.com/en/products/result?keywords=SII9022ACNU | STOCK RISK - dropped by user (no stock at any authorized distributor).
HDMI | REJECTED: DPI->HDMI ITE (not in subtotal) | U_HDMI | 0 | IT66121FN | ITE Tech | HDMI 1.4 TX, 24-bit RGB in, I2S audio | QFN-64 9x9 | Broker (Win Source via findchips) | - | 5.28 | 0.0 | EST: broker range $4.11-5.28 (findchips); no distributor price exists | JLC C2684803 0; LCSC none; Digi-Key/Mouser no listing; brokers only | Extended (0 stock) | https://www.findchips.com/search/IT66121FN | STOCK RISK - broker-only. Mainline ite-it66121 (BeaglePlay AM625, audio supported); needs 3.3/1.8/1.2V.
HDMI | REJECTED: OLDI(LVDS)->HDMI ITE (not in subtotal) | U_HDMI | 0 | IT6263FN | ITE Tech | LVDS (single/dual link) to HDMI 1.4 TX | QFN-64 9x9 | Broker (Win Source via findchips) | - | 6.45 | 0.0 | EST: broker range $4.30-6.45 (findchips, IT6263FN/BX); no distributor price exists | JLC C5184443 0; LCSC/Digi-Key none; brokers only | Extended (0 stock) | https://www.findchips.com/search/IT6263FN | STOCK RISK - broker-only. Mainline ite-it6263 (NXP 2024) is video-only (no audio), 9 supplies (1.8/3.3V), dual-link OK. Would free the DPI/BOOTMODE[15:8] balls.
Audio | Stereo audio codec (HP out + mic in), I2S + I2C | U_CODEC | 1 | TLV320AIC3104IRHBR | Texas Instruments | Low-power stereo codec, 8-96 kHz, PLL (MCLK/BCLK/GPIO2 ref), HP + line outs, mic bias, I2C control | VQFN-32 5x5 (RHB) | JLCPCB/LCSC | C181753 | 1.2326 | 1.2326 | JLC 10+ break; checked 2026-10-17 | JLC 769; TI.com 14,577 | Extended | https://jlcpcb.com/partdetail/TexasInstruments-TLV320AIC3104IRHBR/C181753 | STOCK OK. RECOMMENDED. Same mainline tlv320aic3x driver as SK's AIC3106 (compatible ti,tlv320aic3104); SK simple-audio-card DT reusable with routing change (no MIC3 on 3104). Supplies AVDD/DRVDD 3.3V, IOVDD 3.3V, DVDD 1.8V. HP out AC-coupled for TRRS headset. With no HDMI audio it owns McASP1 alone (SK FET mux not needed). SK's AIC3106 = $2.81 (C2651822, only 25 pcs).
Audio | Audio MCLK 12.288 MHz oscillator | Y_AUD | 1 | MC3225Z12.2880C19XSH | KYOCERA AVX | 12.288 MHz CMOS XO, 1.71-3.63 V, +/-30 ppm, -40..125 C, pad 1 stand-by | SMD3225-4P | Digi-Key | 478-MC3225Z12.2880C19XSHCT-ND | 1.3060 | 1.3060 | Digi-Key cut tape qty-10 break, 2026-11-09 | Digi-Key 2,115 | global sourcing or consign | https://www.digikey.com/en/products/detail/kyocera-avx/MC3225Z12-2880C19XSH/11610135 | Replaces SJK 3N12288G33YC (C252334, JLC 438; not at Digi-Key/Mouser). Pads 1 stand-by (open/H = active), 2 GND, 3 OUT, 4 VCC in the same corners: same OSC_3225_4P land; R1106 holds pad 1 high. Exact 48k-family rates, matches SK DT (fixed-clock, codec is clock master). AM62x AUDIO_EXT_REFCLK cannot make exact 12.288 MHz (12.345679 MHz observed, Toradex). Oscillator-less option: AIC3104 PLL from BCLK with McASP master (BeaglePlay auxclk style). 10k pull-down at MCLK input (SK D-note).
Audio | Audio passives (rough) | C/R/FB_AUD | 1 | various | various | ~6x100nF, 4x1uF, 2x10uF 0402; 2x47uF 0805 HP coupling; 1x bead 0805; ~6x 0402 R (mic bias 2.2k, MCLK 10k PD, reset, 0R) | 0402/0805 | JLCPCB basic | C1525/C52923/C15525/C16780/C1017/C25879 | 0.34 | 0.34 | EST: sum of JLC basic unit prices (47uF 0805 C16780 $0.1016 dominates) | JLC basic, >1M each | Basic | https://jlcpcb.com/parts | ~21 parts. STOCK OK (JLC basic parts, >1M each).
Audio | 3.5 mm 4-pole TRRS jack (headphone + mic) | J_AUDIO | 1 | PJ-320DB-5A | Korean Hroparts Elec | 3.5mm headphone jack, TRRS, SMD | SMD | JLCPCB/LCSC | C707225 | 0.1452 | 0.1452 | JLC 1+ break (next break 50); checked 2026-10-17 | JLC 412 | Extended | https://jlcpcb.com/partdetail/Korean_HropartsElec-PJ_320DB5A/C707225 | STOCK OK. SK part CUI SJ-43514-SMT-TR (JLC C4992301, $1.44) has only 9 in stock (STOCK RISK). Verify CTIA pin map and detect contact in the datasheet before layout.
Audio | ALT cost-down codec (not in subtotal) | U_CODEC | 0 | ES8316 | Everest Semiconductor | Stereo DAC + mono ADC, ground-centred charge-pump HP driver (no HP caps), mic bias, 1.8-3.3V | QFN-32-EP 4x4 | JLCPCB/LCSC | C365735 | 0.7331 | 0.0 | JLC 10+ break; checked 2026-10-17 | JLC 5,078 | Extended | https://jlcpcb.com/partdetail/339917-ES8316/C365735 | STOCK OK. Cheapest stereo option with a mainline driver (es8316; Pinebook Pro / RK3399 boards). Needs MCLK. ~$0.70/board cheaper incl. HP caps; less TI-ecosystem support.
Camera | 15-pin 1.0 mm CSI FPC (RPi camera pinout) | J_CSI | 1 | 1-1734248-5 | TE Connectivity | FPC 15P 1.0mm, vertical, single-side contact, slide lock, SMD | SMD P=1mm | JLCPCB/LCSC | C2922285 | 0.9453 | 0.9453 | JLC 10+ break; checked 2026-10-17 | JLC 3,324 | Extended | https://jlcpcb.com/partdetail/TEConnectivity-1_17342485/C2922285 | STOCK OK. Exact SK part, so contact side and orientation match RPi camera cables. Cheaper look-alike HDGC 1.0K-GL-15PB (C2914181, $0.148, 343 pcs) needs a contact-side check.
Camera | Camera passives (rough) | C/R/FB_CSI | 1 | various | various | 2x100nF, 1x1uF, 1x10uF 0402; 1x bead 0805 (3.3V); 2x I2C pull-ups 0402 | 0402/0805 | JLCPCB basic | C1525/C52923/C15525/C1017/C25879 | 0.06 | 0.06 | EST: sum of JLC basic unit prices | JLC basic, >1M each | Basic | https://jlcpcb.com/parts | ~7 parts. STOCK OK (JLC basic parts, >1M each).
Camera | OPTIONAL camera I2C switch (not in subtotal) | U_CSI_I2C | 0 | TCA9543APWR | Texas Instruments | 2-ch I2C switch with interrupt and reset | TSSOP-14 | JLCPCB/LCSC | C2653307 | 0.7265 | 0.0 | JLC 10+ break; checked 2026-10-17 | JLC 357 | Extended | https://jlcpcb.com/partdetail/TexasInstruments-TCA9543APWR/C2653307 | STOCK OK. SK uses it (U100, 0x71). Optional: give the camera a dedicated I2C bus (e.g. MCU_I2C0/WKUP_I2C0 or I2C3) and omit.
Wireless | M.2 module standoff (SMT M2 threaded, 1.5 mm) | ST_M2 | 1 | 9774015243R | Wurth Elektronik | SMT steel standoff, M2 internal thread, 1.5 mm | SMT | JLCPCB/LCSC | C22431324 | 0.6106 | 0.6106 | JLC 10+ break; checked 2026-10-17 | JLC 1,763 | Extended | https://jlcpcb.com/partdetail/WurthElektronik-9774015243R/C22431324 | STOCK OK. Exact SK part (ACC1). Cheaper alt HanElectricity SMTSO-M2-5.56-1.5-1.53 (C55968553, $0.058, 1,463 pcs): check height/OD.
Wireless | M.2 Key-E 2230 socket, 67P, H3.2 | J_M2 | 1 | APCI0085-P002A | LOTES | M.2 Key-E 67P 0.5mm right-angle SMD, 3.2 mm stack height | SMD P=0.5mm | JLCPCB/LCSC | C841649 | 0.3641 | 0.3641 | JLC 10+ break; checked 2026-10-17 | JLC 6,396 / LCSC 6,336 | Extended | https://jlcpcb.com/partdetail/LOTES-APCI0085P002A/C841649 | STOCK OK. Same 3.2 mm height as SK TE 2199119-4 (JLC C5163551 $2.28, 0 stock = STOCK RISK), so the same 1.5 mm standoff applies. LCSC spec table says 3 mm, key attributes say H3.2: confirm in the drawing.
Wireless | Wireless passives (rough) | C/R_M2 | 1 | various | various | 6x47k (SDIO CMD/D0-3 + WLAN_IRQ pull-up, rev-B fix), 3x10k, 4x0R 0402; 4x100nF, 2x10uF 0402; 1x22uF 0805 on 3.3V | 0402/0805 | JLCPCB basic | C25792/C25744/C17168/C1525/C15525/C45783 | 0.29 | 0.29 | EST: sum of JLC basic unit prices (22uF 0805 C45783 $0.1935 dominates) | JLC basic, >1M each | Basic | https://jlcpcb.com/parts | ~20 parts. STOCK OK (JLC basic parts, >1M each).
Wireless | M.2 module retaining screw M2 x 4 pan head | MH_M2 | 1 | PM2X4 (nickel) | Shuntian | M2 x 4 mm cross-recess pan-head machine screw, nickel-plated steel | - | JLCPCB/LCSC | C357393 | 0.0018 | 0.0018 | JLC 1+ break; checked 2026-10-17 | JLC 11,579 | Extended (hand-fit, not placed) | https://jlcpcb.com/partdetail/C357393 | STOCK OK. Order loose and fit by hand with the module. SK used an M2x5 (B&F MPMS 002 0005 PH); x4 is enough for 0.8 mm card + 1.5 mm standoff.
Wireless | BT UART 4-wire level shift 3.3V<->1.8V | U_BT_LS | 0 | SN74AVC4T245PWR | Texas Instruments | 4-bit dual-supply bus transceiver (2x2 direction groups) | TSSOP-16 | JLCPCB/LCSC | C81461 | 0.2444 | 0 | JLC 1+ break (next break 50); checked 2026-10-17 | JLC 18,217 | Extended | https://jlcpcb.com/partdetail/TexasInstruments-SN74AVC4T245PWR/C81461 | REMOVED: BT UART/BT_EN are on the 1.8 V VDDSHV1 bank (pinmux), no level shift. STOCK OK. NEEDED: AM62x UART1 pin options are in VDDSHV0 (3.3V) and the M.2-CC3351 IO is 1.8V. Same die as SK's DGVR (C2652943, $1.34) in a cheaper package.
Wireless | BT_EN 3.3V->1.8V level shift | U_EN_LS | 0 | TXS0104ERGYR | Texas Instruments | 4-bit auto-direction level translator | VQFN-14 3.5x3.5 | JLCPCB/LCSC | C154926 | 0.3951 | 0 | JLC 10+ break; checked 2026-10-17 | JLC 21,132 | Extended | https://jlcpcb.com/partdetail/TexasInstruments-TXS0104ERGYR/C154926 | REMOVED: BT UART/BT_EN are on the 1.8 V VDDSHV1 bank (pinmux), no level shift. STOCK OK. SK copy (BT_EN from MCU_GPIO0_1 at 3.3V). Delete if BT_EN moves to a 1.8V-domain GPIO (VDDSHV1/VDDSHV6), or use SN74LVC2T45DCUR (C15741, $0.217, 52k pcs). 32 kHz slow clock comes from the SoC (no part).
Expansion | 40-pin 2x20 2.54 mm header (RPi pinout) | J_EXP | 1 | 2541WV-2x20P | HanElectricity | Pin header 2x20P 2.54mm, straight, gold, through-hole | THT 2x20 | JLCPCB/LCSC | C25503140 | 0.1377 | 0.1377 | JLC 1+ break (next break 50); checked 2026-10-17 | JLC 3,873 | Extended | https://jlcpcb.com/partdetail/HanElectricity-2541WV2x20P/C25503140 | STOCK OK. THT adds a JLC through-hole soldering charge (or hand-solder). SK part Sullins PEC20DAAN (JLC C7025283, $2.13) has 0 stock (STOCK RISK). SMD alt Kinghelm KH-2.54PH-2X20P-L11.0-SMT (C19630986, $0.287) has only 50 pcs and is weaker mechanically.
Expansion | HAT-ID EEPROM 24C32 on dedicated ID_SD/ID_SC bus | U_HATID | 1 | BL24C32A-SFRC | Shanghai Belling | 32 Kbit I2C EEPROM, 1.7-5.5V, 1 MHz | TSSOP-8 | JLCPCB/LCSC | C177775 | 0.1076 | 0.1076 | JLC 1+ break (next break 50); checked 2026-10-17 | JLC 11,669 | Extended | https://jlcpcb.com/partdetail/BL_Shanghai_Belling-BL24C32ASFRC/C177775 | STOCK OK. VERIFY NEED: on a Raspberry Pi the HAT-ID EEPROM sits on the HAT; the host only routes pins 27/28 with pull-ups. Alt AT24C32D-SSHM-T (C60583, $0.33, 50k pcs).
Expansion | Expansion passives (rough) | C/R_EXP | 1 | various | various | 2x I2C2 pull-up (1.8k), 2x ID-bus pull-up, EEPROM WP pull, 1x100nF, 2x10uF 0402 on header 3V3/5V | 0402 | JLCPCB basic | C25879/C1525/C15525 | 0.06 | 0.06 | EST: sum of JLC basic unit prices | JLC basic, >1M each | Basic | https://jlcpcb.com/parts | ~8 parts. Header 3V3/5V load switches are priced in the power section. STOCK OK (JLC basic parts, >1M each).
Expansion | Header IO series resistors 33R (back-power/ESD damping) | R_EXP1-28 | 28 | 0402WGF330JTCE | UNI-ROYAL | 33R 1% 0402 thick film | 0402 | JLCPCB/LCSC | C25105 | 0.0012 | 0.0336 | JLC basic 1+ break (280 pcs for 10 boards; next break 1000); checked 2026-10-17 | JLC 1,682,522 | Basic | https://jlcpcb.com/partdetail/25848-0402WGF330JTCE/C25105 | STOCK OK. 28 = every non-power header pin (incl. I2C 3/5/27/28); 24 if the I2C pins have no series R. 4x arrays 4D02WGJ0330TCE (C25501, extended, $0.0084) x7 if area is tight.
Debug | Quad USB-UART bridge: MAIN_UART0 (Linux), MAIN_UART1 (TIFS), WKUP_UART0 (DM), MCU_UART0 | U (FT4232) | 1 | FT4232HL-Reel | FTDI | Hi-Speed USB 2.0 to quad UART/MPSSE | LQFP-64 10x10 | LCSC/JLCPCB | C56742 | 12.6031 | 12.6031 | JLCPCB parts library price @ order qty 10 (10 boards x 1/board for this C#), 2026-10-17 | 3109 | Extended | https://www.lcsc.com/product-detail/usb-converters_ftdi-ft4232hl-reel_C56742.html | LCSC/JLC is the only in-stock source found: Mouser FT4232HL-TRAY $6.25 @10 and Digi-Key $6.25-6.43 but 0 stock (Mouser on-order; DK 50-wk lead, 1000 due 2027-01-18). FT4232HQ: JLC REEL $59.72 (1676 stk), TRAY $23.14 (0 stk); Mouser $6.25-7.15 on order. HL chosen (cheaper at LCSC, easier to inspect).
Debug | UART power-domain isolation buffers (FT4232 side on debug-VBUS 3.3 V, SoC side on VCC_3V3_SYS) | U (2x) | 2 | SN74AVC4T245PWR | Texas Instruments | 4-bit dual-supply transceiver, Ioff / VCC isolation | TSSOP-16 | LCSC/JLCPCB | C81461 | 0.2444 | 0.4888 | JLCPCB parts library price @ order qty 20 (10 boards x 2/board for this C#), 2026-10-17 | 18217 | Extended | https://www.lcsc.com/product-detail/translators-level-shifters_texas-instruments-sn74avc4t245pwr_C81461.html | No level shift needed (all 4 UARTs and FT4232 VCCIO are 3.3 V) but buffers ARE needed for isolation: SoC IOs are not fail-safe and the FT4232 is powered from debug VBUS. 2 chips cover TX+RX of 4 UARTs (one 2-bit half per direction); SK used 4 because it also routed RTS/CTS.
Debug | FT4232 config EEPROM (93LC46B, 16-bit org) | U (EEPROM) | 1 | 93LC46BT-I/OT | Microchip | Microwire EEPROM 1 Kbit | SOT-23-6 | LCSC/JLCPCB | C2649426 | 0.4392 | 0.4392 | JLCPCB parts library price @ order qty 10 (10 boards x 1/board for this C#), 2026-10-17 | 1081 | Extended | https://www.lcsc.com/product-detail/eeprom_microchip-tech-93lc46bt-i-ot_C2649426.html | SK used 93LC46B-I/MS (MSOP-8, C613228 $0.7233 @10).
Debug | Debug USB connector (USB 2.0 only, UFP) | J (DEBUG) | 1 | TYPE-C-31-M-12 | Korean Hroparts (HRO) | USB Type-C receptacle 16-pin, mid-mount SMD | SMD 16P | LCSC/JLCPCB | C165948 | 0.1865 | 0.1865 | JLCPCB parts library price @ order qty 10 (10 boards x 1/board for this C#), 2026-10-17 | 365192 | Extended | https://www.lcsc.com/product-detail/usb-connectors_korean-hroparts-elec-type-c-31-m-12_C165948.html | Micro-B U254-051N-4BH806 (C319170) is $0.13 @10, only $0.06 cheaper (and needs no CC resistors) - USB-C recommended.
Debug | 3.3 V LDO for FT4232 + buffer A-side, powered from debug USB VBUS | U (LDO) | 1 | AP2112K-3.3TRG1 | Diodes Inc | LDO 3.3 V 600 mA, Vin 2.5-6 V | SOT-23-5 | LCSC/JLCPCB | C51118 | 0.1717 | 0.1717 | JLCPCB parts library price @ order qty 10 (10 boards x 1/board for this C#), 2026-10-17 | 7645 | Extended | https://www.lcsc.com/product-detail/voltage-regulators-linear-low-drop-out-ldo-regulators_diodes-incorporated-ap2112k-3-3trg1_C51118.html | Cheaper than TPS73533DRVR (C48984 $0.9371 @10, only 100 stk; TPS73533DRBR C388480 $0.973, 4428 stk). FT4232H draws ~70-100 mA. Basic-library XC6206P332MR (C5446, 200 mA) also works but has less margin.
Debug | JTAG ESD on Tag-Connect lines (TCK/TMS/TDI/TDO/TRSTn/EMU0/EMU1/nRST) | U (2x) | 2 | TPD4E05U06DQAR | Texas Instruments | 4-ch unidirectional ESD 5.5 V 0.5 pF | USON-10 1x2.5 | LCSC/JLCPCB | C138714 | 0.0830 | 0.1660 | JLCPCB parts library price @ order qty 20 (10 boards x 2/board for this C#), 2026-10-17 | 215912 | Extended | https://www.lcsc.com/product-detail/esd-and-surge-protection-tvs-esd_texas-instruments-tpd4e05u06dqar_C138714.html | SK D-note: add ESD on any external debug connector.
Debug | Debug USB D+/D- ESD | U (ESD) | 1 | TPD2E001DRLR | Texas Instruments | 2-ch low-cap ESD array with VCC rail | SOT-553-5 | LCSC/JLCPCB | C150526 | 0.1610 | 0.1610 | JLCPCB parts library price @ order qty 10 (10 boards x 1/board for this C#), 2026-10-17 | 6370 | Extended | https://www.lcsc.com/product-detail/esd-and-surge-protection-tvs-esd_texas-instruments-tpd2e001drlr_C150526.html | Same part as SK (U44). Alt ST USBLC6-2SC6 C7519 $0.1774.
Debug | FT4232 12 MHz crystal | Y3 | 1 | FL1200074 | Diodes Incorporated | Crystal 12 MHz 20 pF +/-20 ppm tol, +/-20 ppm stab, -40..85 C, 3225 | 3.2x2.5 mm SMD-4 | Digi-Key | 31-FL1200074CT-ND | 0.5640 | 0.5640 | Digi-Key cut tape qty-10 break, 2026-11-09 | Digi-Key 3,118 (+153,000 factory) | global sourcing or consign | https://www.digikey.com/en/products/detail/diodes-incorporated/FL1200074/9766596 | Replaces YXC X322512MSB4SI (C9002). Same pins (1/3 Xtal, 2/4 Case) and XTAL_3225_4P; CL 20 pF keeps the 33 pF load caps. FTDI needs +/-30 ppm; +/-20/+/-20 ppm is tighter than the SK's ECS-120-18-30B-AGN-TR (+/-25/+/-30 ppm, 18 pF).
Debug | Debug VBUS ESD | D (VBUS) | 1 | TPD1E10B06DPYR | Texas Instruments | 1-ch bidirectional ESD 6 V | X1SON-2 (0402) | LCSC/JLCPCB | C48260 | 0.0446 | 0.0446 | JLCPCB parts library price @ order qty 40 (10 boards x 4/board for this C#), 2026-10-17 | 288846 | Extended | https://www.lcsc.com/product-detail/esd-and-surge-protection-tvs-esd_texas-instruments-tpd1e10b06dpyr_C48260.html | SK D7.
Debug | FT4232 VPHY/VPLL ferrite beads | FB (2x) | 2 | BLM18PG121SN1D | Murata | Ferrite bead 120 R @100 MHz 2 A 0603 | 0603 | LCSC/JLCPCB | C14709 | 0.0152 | 0.0304 | JLCPCB parts library price @ order qty 20 (10 boards x 2/board for this C#), 2026-10-17 | 2705359 | Basic | https://www.lcsc.com/product-detail/ferrite-beads_murata-electronics-blm18pg121sn1d_C14709.html | JLC Basic (SK FL25/FL26).
Debug | 12 MHz crystal load caps | C (Y3) | 2 | 0402CG330J500NT | FH (Fenghua) | Cap C0G 33 pF 50 V 0402 | 0402 | LCSC/JLCPCB | C1562 | 0.0032 | 0.0064 | JLCPCB parts library price @ order qty 20 (10 boards x 2/board for this C#), 2026-10-17 | 1278855 | Basic | https://www.lcsc.com/product-detail/multilayer-ceramic-capacitors-mlcc-smd-smt_fh-guangdong-fenghua-advanced-tech-0402cg330j500nt_C1562.html | For a 20 pF CL crystal with ~3-5 pF stray; SK used 18 pF caps with an 18 pF crystal.
Debug | USB-C CC Rd pull-downs (device/UFP) | R (CC) | 2 | 0402WGF5101TCE | UNI-ROYAL | Res 5.1 k 1% 0402 | 0402 | LCSC/JLCPCB | C25905 | 0.0023 | 0.0046 | JLCPCB parts library price @ order qty 20 (10 boards x 2/board for this C#), 2026-10-17 | 5094583 | Basic | https://www.lcsc.com/product-detail/chip-resistor-surface-mount_uni-royal-uniroyal-elec-0402wgf5101tce_C25905.html
Debug | FT4232 REF resistor | R (REF) | 1 | 0402WGF1202TCE | UNI-ROYAL | Res 12 k 1% 0402 | 0402 | LCSC/JLCPCB | C25752 | 0.0018 | 0.0018 | JLCPCB parts library price @ order qty 10 (10 boards x 1/board for this C#), 2026-10-17 | 952381 | Basic | https://www.lcsc.com/product-detail/chip-resistor-surface-mount_uni-royal-uniroyal-elec-0402wgf1202tce_C25752.html | FTDI requires 12 k 1%.
Debug | JTAG connector: Tag-Connect TC2070 (14-pin, TI-14 pinout incl. TRSTn/EMU0/EMU1) footprint | J (JTAG) | 1 | TC2070-IDC-NL footprint | Tag-Connect | PCB footprint only - no BOM part | footprint | n/a | n/a | 0.0000 | 0.0000 | no part (PCB copper only) | n/a | n/a |  | Zero BOM cost. TRSTn pulled low on board.
Debug | TOOL (not BOM): Tag-Connect 14-pin no-legs cable to TI-14 ribbon | tool | 0 | TC2070-IDC-NL | Tag-Connect | Plug-of-Nails 14-pin cable, 8 in, no legs | cable | Digi-Key | TC2070-IDC-NL-ND | 49.1900 | 0.0000 | Digi-Key qty 1, 2026-10-17 - TOOL, excluded from BOM total | 410 (Digi-Key) | n/a (tool) | https://www.digikey.com/en/products/detail/tag-connect-llc/TC2070-IDC-NL/3986444 | One-off tool purchase, $49.19 @1 at Digi-Key (TC2070-IDC-NL-ND, 410 stk, 2026-10-17). Needs XDS110 cTI-20 to TI-14 adapter. 10-pin alt TC2050-IDC-NL $39.00 (Digi-Key) uses the ARM-10 pinout which has no TRSTn/EMU0/EMU1 - not recommended for AM62x.
Misc | Temperature sensor near SiP (I2C0 @0x48) | U (TEMP) | 1 | TMP102AIDRLR | Texas Instruments | Digital temp sensor +/-2 C, I2C | SOT-563 | LCSC/JLCPCB | C99269 | 0.5420 | 0.5420 | JLCPCB parts library price @ order qty 10 (10 boards x 1/board for this C#), 2026-10-17 | 38027 | Extended | https://www.lcsc.com/product-detail/temperature-sensors_texas-instruments-tmp102aidrlr_C99269.html | SK used 2x TMP100NA/3K (C31810 $0.9518 @10). Cheaper TI alt: TMP1075DGKR C2864807 $0.3151 @10 (LM75-compatible).
Misc | Board-ID EEPROM for TI U-Boot board detect (I2C0 @0x51, 2-byte addressing) | U (ID) | 1 | AT24C512C-SSHD-T | Microchip | I2C EEPROM 512 Kbit 1.7-3.6 V | SOIC-8 | LCSC/JLCPCB | C12371 | 0.4229 | 0.4229 | JLCPCB parts library price @ order qty 10 (10 boards x 1/board for this C#), 2026-10-17 | 28988 | Extended | https://www.lcsc.com/product-detail/eeprom_microchip-tech-at24c512c-sshd-t_C12371.html | Same family as SK (AT24C512C-MAHM-T UDFN). Cheaper drop-in: ST M24C32-WMN6TP C7998 $0.2983 @10 (BRK uses AT24C32 at 0x50); TI AM6 EEPROM reader handles 2-byte-address parts.
Misc | LEDs green: 3V3 power, heartbeat, user1, debug-USB power | LED (4x) | 4 | KT-0805G | Hubei KENTO | LED green 525 nm 0805 | 0805 | LCSC/JLCPCB | C2297 | 0.0164 | 0.0656 | JLCPCB parts library price @ order qty 40 (10 boards x 4/board for this C#), 2026-10-17 | 2660137 | Basic | https://www.lcsc.com/product-detail/led-indication-discrete_hubei-kento-elec-kt-0805g_C2297.html | JLC Basic. No 0603 green in Basic library.
Misc | LEDs red: user2, 5 V input present | LED (2x) | 2 | KT-0603R | Hubei KENTO | LED red 0603 | 0603 | LCSC/JLCPCB | C2286 | 0.0076 | 0.0152 | JLCPCB parts library price @ order qty 20 (10 boards x 2/board for this C#), 2026-10-17 | 7572604 | Basic | https://www.lcsc.com/product-detail/led-indication-discrete_hubei-kento-elec-kt-0603r_C2286.html | JLC Basic.
Misc | Red-LED series resistors | R (2x) | 2 | 0402WGF1001TCE | UNI-ROYAL | Res 1 k 1% 0402 | 0402 | LCSC/JLCPCB | C11702 | 0.0035 | 0.0070 | JLCPCB parts library price @ order qty 80 (10 boards x 8/board for this C#), 2026-10-17 | 13763230 | Basic | https://www.lcsc.com/product-detail/chip-resistor-surface-mount_uni-royal-uniroyal-elec-0402wgf1001tce_C11702.html
Misc | Green-LED series resistors | R (4x) | 4 | 0402WGF3300TCE | UNI-ROYAL | Res 330 R 1% 0402 | 0402 | LCSC/JLCPCB | C25104 | 0.0011 | 0.0044 | JLCPCB parts library price @ order qty 40 (10 boards x 4/board for this C#), 2026-10-17 | 1897480 | Basic | https://www.lcsc.com/product-detail/chip-resistor-surface-mount_uni-royal-uniroyal-elec-0402wgf3300tce_C25104.html | ~1.5 mA from 3.3 V GPIO.
Misc | Test points (spare UART consoles, OBSCLK, PORz/RESETSTATz, rails) | TP (~12x) | 12 | bare SMD test pad | - | Copper pad, no part | pad | n/a | n/a | 0.0000 | 0.0000 | no part (PCB copper only) | n/a | n/a |  | No BOM cost. Fiducials: copper-only (3 recommended for the 0.5 mm BGA), no BOM part. No mounting hardware (board only).
Passives (SiP + generic) | SiP decoupling Table 4-3: 4.7 uF on VDDA_CORE_CSIRX0/USB/VDD_CANUART (3), VDDA_1P8_CSIRX0/USB (2), VDDA_MCU/PLL0/1/2 (4) | C (9x) | 9 | CL05A475MP5NRNC | Samsung | Cap X5R 4.7 uF 10 V 0402 | 0402 | LCSC/JLCPCB | C23733 | 0.0206 | 0.1854 | JLCPCB parts library price @ order qty 110 (10 boards x 11/board for this C#), 2026-10-17 | 2106975 | Basic | https://www.lcsc.com/product-detail/multilayer-ceramic-capacitors-mlcc-smd-smt_samsung-electro-mechanics-cl05a475mp5nrnc_C23733.html | If all core rails are tied (this design: Buck1), Table 4-3 note allows dropping the 3 core-analog sets (-3x 4.7 uF, -3x 0.1 uF). Kept for margin.
Passives (SiP + generic) | Generic 100 nF: oscillator 1, logic gates 7, button RC 2, ID EEPROM 1, 93LC46 1, TMP102 1, FT4232 rails 10, AVC4T245 4, TPD2E001 1, debug VBUS 1 | C (29x) | 29 | CL05B104KO5NNNC | Samsung | Cap X7R 100 nF 16 V 0402 | 0402 | LCSC/JLCPCB | C1525 | 0.0051 | 0.1479 | JLCPCB parts library price @ order qty 710 (10 boards x 71/board for this C#), 2026-10-17 | 24757290 | Basic | https://www.lcsc.com/product-detail/multilayer-ceramic-capacitors-mlcc-smd-smt_samsung-electro-mechanics-cl05b104ko5nnnc_C1525.html | EST count.
Passives (SiP + generic) | SiP decoupling per OSD62x-PM DS Rev 2.0 Table 4-3: VDD_CORE 6, VDDA_CORE_CSIRX0/USB/VDD_CANUART 3, VDDR_CORE 4, VDDS_DDR 3, DDR_VPP 1, VDDA_1P8_OLDI0 1, VDDA_1P8_CSIRX0/USB 2, VDDA_MCU/PLL0-2 4, VPP 1, VDDA_3P3_USB 1 | C (26x) | 26 | CL05B104KO5NNNC | Samsung | Cap X7R 100 nF 16 V 0402 | 0402 | LCSC/JLCPCB | C1525 | 0.0051 | 0.1326 | JLCPCB parts library price @ order qty 710 (10 boards x 71/board for this C#), 2026-10-17 | 24757290 | Basic | https://www.lcsc.com/product-detail/multilayer-ceramic-capacitors-mlcc-smd-smt_samsung-electro-mechanics-cl05b104ko5nnnc_C1525.html | VDDR_CORE counted as 4 (table total 0.4 uF). Plus ~10 DNP 0.1 uF EMI footprints (Octavo rec., no cost).
Passives (SiP + generic) | SiP IO/aux rails not in Table 4-3 (VDDSHV0-6, VDDSHV_MCU, VDDSHV_CANUART, VDDS_OSC0, VMON_1P8/3P3, VDDA_TEMP): 0.1 uF | C (16x) | 16 | CL05B104KO5NNNC | Samsung | Cap X7R 100 nF 16 V 0402 | 0402 | LCSC/JLCPCB | C1525 | 0.0051 | 0.0816 | JLCPCB parts library price @ order qty 710 (10 boards x 71/board for this C#), 2026-10-17 | 24757290 | Basic | https://www.lcsc.com/product-detail/multilayer-ceramic-capacitors-mlcc-smd-smt_samsung-electro-mechanics-cl05b104ko5nnnc_C1525.html | EST count from TI AM62x/SK practice (CAP_VDDSx are internal).
Passives (SiP + generic) | SiP IO/aux rails not in Table 4-3: 1 uF (9 VDDSHV rails + VDDS_OSC0) | C (10x) | 10 | CL05A105KA5NQNC | Samsung | Cap X5R 1 uF 25 V 0402 | 0402 | LCSC/JLCPCB | C52923 | 0.0068 | 0.0680 | JLCPCB parts library price @ order qty 160 (10 boards x 16/board for this C#), 2026-10-17 | 9087216 | Basic | https://www.lcsc.com/product-detail/multilayer-ceramic-capacitors-mlcc-smd-smt_samsung-electro-mechanics-cl05a105ka5nqnc_C52923.html | EST count.
Passives (SiP + generic) | 10 k pulls: RESET_REQz, MCU_RESETz, 3 buttons, PORz_OUT/RESETSTATz PD, JTAG 6, misc SoC 4, EEPROM WP, TMP ALERT, FT4232 4, buffer DIR/OE 8, SoC-side RX 4, EXTINTn | R (36x) | 36 | 0402WGF1002TCE | UNI-ROYAL | Res 10 k 1% 0402 | 0402 | LCSC/JLCPCB | C25744 | 0.0015 | 0.0540 | JLCPCB parts library price @ order qty 480 (10 boards x 48/board for this C#), 2026-10-17 | 20292880 | Basic | https://www.lcsc.com/product-detail/chip-resistor-surface-mount_uni-royal-uniroyal-elec-0402wgf1002tce_C25744.html | EST count.
Passives (SiP + generic) | Generic 4.7 uF (FT4232 VPHY/VPLL after ferrites) | C (2x) | 2 | CL05A475MP5NRNC | Samsung | Cap X5R 4.7 uF 10 V 0402 | 0402 | LCSC/JLCPCB | C23733 | 0.0206 | 0.0412 | JLCPCB parts library price @ order qty 110 (10 boards x 11/board for this C#), 2026-10-17 | 2106975 | Basic | https://www.lcsc.com/product-detail/multilayer-ceramic-capacitors-mlcc-smd-smt_samsung-electro-mechanics-cl05a475mp5nrnc_C23733.html
Passives (SiP + generic) | 47 pF slew limiters: EXTINTn + MCU_I2C0/WKUP_I2C0 (62 R + 47 pF, SK rev B) | C (5x) | 5 | 0402CG470J500NT | FH (Fenghua) | Cap C0G 47 pF 50 V 0402 | 0402 | LCSC/JLCPCB | C1567 | 0.0081 | 0.0405 | JLCPCB parts library price @ order qty 50 (10 boards x 5/board for this C#), 2026-10-17 | 562346 | Basic | https://www.lcsc.com/product-detail/multilayer-ceramic-capacitors-mlcc-smd-smt_fh-guangdong-fenghua-advanced-tech-0402cg470j500nt_C1567.html
Passives (SiP + generic) | SiP decoupling Table 4-3: 10 uF on VDD_CORE | C (1x) | 1 | CL10A106KP8NNNC | Samsung | Cap X5R 10 uF 10 V 0603 | 0603 | LCSC/JLCPCB | C19702 | 0.0271 | 0.0271 | JLCPCB parts library price @ order qty 20 (10 boards x 2/board for this C#), 2026-10-17 | 11164622 | Basic | https://www.lcsc.com/product-detail/multilayer-ceramic-capacitors-mlcc-smd-smt_samsung-electro-mechanics-cl10a106kp8nnnc_C19702.html | Rail bulk (22 uF etc.) is in the power section.
Passives (SiP + generic) | Generic 10 uF (debug USB VBUS bulk) | C (1x) | 1 | CL10A106KP8NNNC | Samsung | Cap X5R 10 uF 10 V 0603 | 0603 | LCSC/JLCPCB | C19702 | 0.0271 | 0.0271 | JLCPCB parts library price @ order qty 20 (10 boards x 2/board for this C#), 2026-10-17 | 11164622 | Basic | https://www.lcsc.com/product-detail/multilayer-ceramic-capacitors-mlcc-smd-smt_samsung-electro-mechanics-cl10a106kp8nnnc_C19702.html
Passives (SiP + generic) | SiP decoupling Table 4-3: 1 uF on VDDA_1P8_OLDI0 (1), VPP eFuse (2) | C (3x) | 3 | CL05A105KA5NQNC | Samsung | Cap X5R 1 uF 25 V 0402 | 0402 | LCSC/JLCPCB | C52923 | 0.0068 | 0.0204 | JLCPCB parts library price @ order qty 160 (10 boards x 16/board for this C#), 2026-10-17 | 9087216 | Basic | https://www.lcsc.com/product-detail/multilayer-ceramic-capacitors-mlcc-smd-smt_samsung-electro-mechanics-cl05a105ka5nqnc_C52923.html
Passives (SiP + generic) | Generic 1 uF (debug LDO in/out, FT4232 VREGOUT) | C (3x) | 3 | CL05A105KA5NQNC | Samsung | Cap X5R 1 uF 25 V 0402 | 0402 | LCSC/JLCPCB | C52923 | 0.0068 | 0.0204 | JLCPCB parts library price @ order qty 160 (10 boards x 16/board for this C#), 2026-10-17 | 9087216 | Basic | https://www.lcsc.com/product-detail/multilayer-ceramic-capacitors-mlcc-smd-smt_samsung-electro-mechanics-cl05a105ka5nqnc_C52923.html
Passives (SiP + generic) | 100 k pull-downs: MCU_PORz, peripheral reset AND in/outputs (11) | R (12x) | 12 | 0402WGF1003TCE | UNI-ROYAL | Res 100 k 1% 0402 | 0402 | LCSC/JLCPCB | C25741 | 0.0016 | 0.0192 | JLCPCB parts library price @ order qty 120 (10 boards x 12/board for this C#), 2026-10-17 | 9217948 | Basic | https://www.lcsc.com/product-detail/chip-resistor-surface-mount_uni-royal-uniroyal-elec-0402wgf1003tce_C25741.html | EST count.
Passives (SiP + generic) | 2.2 k: I2C0/MCU_I2C0/WKUP_I2C0 pull-ups (6), FT4232 EEPROM DO (1) | R (7x) | 7 | 0402WGF2201TCE | UNI-ROYAL | Res 2.2 k 1% 0402 | 0402 | LCSC/JLCPCB | C25879 | 0.0011 | 0.0077 | JLCPCB parts library price @ order qty 70 (10 boards x 7/board for this C#), 2026-10-17 | 2128914 | Basic | https://www.lcsc.com/product-detail/chip-resistor-surface-mount_uni-royal-uniroyal-elec-0402wgf2201tce_C25879.html
Passives (SiP + generic) | 1 k: button RC series (2) | R (2x) | 2 | 0402WGF1001TCE | UNI-ROYAL | Res 1 k 1% 0402 | 0402 | LCSC/JLCPCB | C11702 | 0.0035 | 0.0070 | JLCPCB parts library price @ order qty 80 (10 boards x 8/board for this C#), 2026-10-17 | 13763230 | Basic | https://www.lcsc.com/product-detail/chip-resistor-surface-mount_uni-royal-uniroyal-elec-0402wgf1001tce_C11702.html
Passives (SiP + generic) | 62 R: EXTINTn + MCU_I2C0/WKUP_I2C0 slew limiters | R (5x) | 5 | 0402WGF620JTCE | UNI-ROYAL | Res 62 R 1% 0402 | 0402 | LCSC/JLCPCB | C4962 | 0.0012 | 0.0060 | JLCPCB parts library price @ order qty 50 (10 boards x 5/board for this C#), 2026-10-17 | 25661 | Extended | https://www.lcsc.com/product-detail/chip-resistor-surface-mount_uni-royal-uniroyal-elec-0402wgf620jtce_C4962.html | Extended part (adds JLC $3/order feeder fee). Basic alt 49.9 R C25120 if fall-time check allows.
Passives (SiP + generic) | Generic 2.2 uF (debug LDO output) | C (1x) | 1 | CL05A225MQ5NSNC | Samsung | Cap X5R 2.2 uF 6.3 V 0402 | 0402 | LCSC/JLCPCB | C12530 | 0.0054 | 0.0054 | JLCPCB parts library price @ order qty 10 (10 boards x 1/board for this C#), 2026-10-17 | 4363220 | Basic | https://www.lcsc.com/product-detail/multilayer-ceramic-capacitors-mlcc-smd-smt_samsung-electro-mechanics-cl05a225mq5nsnc_C12530.html
Passives (SiP + generic) | 22 pF glitch filters on MCU_PORz and RESET_REQz | C (2x) | 2 | 0402CG220J500NT | FH (Fenghua) | Cap C0G 22 pF 50 V 0402 | 0402 | LCSC/JLCPCB | C1555 | 0.0026 | 0.0052 | JLCPCB parts library price @ order qty 20 (10 boards x 2/board for this C#), 2026-10-17 | 1917083 | Basic | https://www.lcsc.com/product-detail/multilayer-ceramic-capacitors-mlcc-smd-smt_fh-guangdong-fenghua-advanced-tech-0402cg220j500nt_C1555.html | SK D-note.
Passives (SiP + generic) | 47 R: I2C0 (emulated open-drain) series | R (2x) | 2 | 0402WGF470JTCE | UNI-ROYAL | Res 47 R 1% 0402 | 0402 | LCSC/JLCPCB | C25118 | 0.0023 | 0.0046 | JLCPCB parts library price @ order qty 20 (10 boards x 2/board for this C#), 2026-10-17 | 331205 | Extended (Preferred) | https://www.lcsc.com/product-detail/chip-resistor-surface-mount_uni-royal-uniroyal-elec-0402wgf470jtce_C25118.html | Extended part. Basic alt 49.9 R C25120.
Passives (SiP + generic) | Generic 10 nF (FT4232 VPLL/LDO NR) | C (1x) | 1 | CL05B103KB5NNNC | Samsung | Cap X7R 10 nF 50 V 0402 | 0402 | LCSC/JLCPCB | C15195 | 0.0041 | 0.0041 | JLCPCB parts library price @ order qty 10 (10 boards x 1/board for this C#), 2026-10-17 | 6164399 | Basic | https://www.lcsc.com/product-detail/multilayer-ceramic-capacitors-mlcc-smd-smt_samsung-electro-mechanics-cl05b103kb5nnnc_C15195.html
Passives (SiP + generic) | 22 R: 25 MHz clock series, JTAG TDO series | R (2x) | 2 | 0402WGF220JTCE | UNI-ROYAL | Res 22 R 1% 0402 | 0402 | LCSC/JLCPCB | C25092 | 0.0015 | 0.0030 | JLCPCB parts library price @ order qty 20 (10 boards x 2/board for this C#), 2026-10-17 | 3973198 | Basic | https://www.lcsc.com/product-detail/chip-resistor-surface-mount_uni-royal-uniroyal-elec-0402wgf220jtce_C25092.html
Passives (SiP + generic) | 0 R: debug USB shield link (dropped 2026-11-10) | R (1x) | 0 | 0402WGF0000TCE | UNI-ROYAL | Res 0 R 0402 | 0402 | LCSC/JLCPCB | C17168 | 0.0011 | 0.0011 | JLCPCB parts library price @ order qty 10 (10 boards x 1/board for this C#), 2026-10-17 | 8664410 | Basic | https://www.lcsc.com/product-detail/chip-resistor-surface-mount_uni-royal-uniroyal-elec-0402wgf0000tce_C17168.html
Storage (module, plug-in) | eMMC module 32 GB (plugs into J_EMMC1) | - | 1 | 32GB eMMC Module | PINE64 | Removable eMMC module, GB042-34S socket, eMMC 5.x, HS200 1.8V proven on ROCK64/ROCKPro64 (mainline DT mmc-hs200-1_8v) | 18x13 mm module | PINE64 store | 32GB eMMC Module | 24.95 | 24.95 | pine64.com community price 2026-10-17 (shipping extra) | In stock (qty not published; store max 10 per order) | N/A (shipped loose) | https://pine64.com/product/32gb-emmc-module/ | STOCK OK (vendor shows In stock; 16GB also in stock at $15.95; 64GB OUT OF STOCK at Pine64 -> 64GB in stock at Ameridroid Radxa $54.95 / Hardkernel $55). Not assembled by JLC. Alternates in stock: Hardkernel 32GB $45, Ameridroid Hardkernel no-OS 32GB $53.95.
Wireless (module, plug-in) | Wi-Fi 6 + BLE M.2 2230 Key-E card | M2_MODULE | 1 | M2-CC3351 | Texas Instruments | CC3351 dual-band Wi-Fi 6 + Bluetooth LE M.2 2230 Key-E card, SDIO + UART, chip antenna (U.FL/SMA test option) | M.2 2230 | TI.com | M2-CC3351 | 55.0 | 55.0 | TI.com list price (single price; login to order); checked 2026-10-17 | TI.com 74 (store inventory API); no Digi-Key/Mouser listing | n/a (plug-in) | https://www.ti.com/tool/M2-CC3351 | STOCK OK (74 = 74 boards; only source is TI.com, which may cap EVM quantity per order). PLUG-IN MODULE, not soldered; boards without Wi-Fi carry only the socket. Largest line in this section.
PCB + Assembly | Bare PCB fabrication | PCB1 | 1 | APE-SBC rev A (JLC08161H-3313) | JLCPCB | 8-layer FR-4 (Shengyi S1000-2M Tg170), 1.6 mm nominal (stackup 1.57 mm), 1 oz outer / 0.5 oz inner, ENIG 1u", green LPI, impedance control +/-10%, min via 0.15/0.25 mm, epoxy filled & capped vias (POFV, free on 6L and up), 4-wire Kelvin test, flying-probe e-test | 100 x 70 mm | JLCPCB | JLC08161H-3313 | 35.067 | 35.067 | JLCPCB online quote 2026-11-05, qty 10, 7-8 day build; per-order total / 10 | n/a | n/a (fab/assembly service) | https://cart.jlcpcb.com/quote | Qty-5 order $315.06 = $63.012/board. Qty-10 order $350.67 = base 8L $120.00 + stackup fee $83.86 + ENIG $18.20 + S1000-2M $40.45 + impedance $33.08 + 0.15 mm via $36.56 + 4-wire Kelvin $17.47 + confirm production file $1.05 (qty 5: 90.00/83.29/17.40/38.42/33.08/34.82/17.00/1.05). Free stack JLC08161H-2116 instead: $266.81 / $231.77, but its L3 and L6 sit closer to the power planes than to GND. Shipping/duties excluded (DHL DDP estimate $31.59 for bare boards). GROUP TOTAL (11 lines, excl. components): qty 10 $527.23/order = $52.72/board; qty 5 $438.00/order = $87.60/board.
PCB + Assembly | Feeder loading fee (unique parts) | - | 1 | 70 unique part numbers x $1.53 | JLCPCB | Standard PCBA feeder loading, charged per unique basic OR extended part | per order | JLCPCB | Standard PCBA | 10.710 | 10.710 | JLCPCB PCBA price page: $1.53 per basic/extended part (Standard); 70 x 1.53 = $107.10 / 10 | n/a | n/a (fab/assembly service) | https://jlcpcb.com/help/article/pcb-assembly-price | Qty 5: $21.420/board. Under Standard PCBA every unique part (basic and extended) pays $1.53; Economic would charge $3.07 per unique extended part only (35 x 3.07 = $107.45, about the same). THT-only parts may not need feeders (then 66 x 1.53 = $100.98).
PCB + Assembly | X-ray inspection | U1 + QFN/SON parts | 1 | ~20 X-ray parts/board | JLCPCB | Mandatory X-ray of BGA (SiP), QFN/VQFN/WQFN/SON leadless parts | per component | JLCPCB | Standard PCBA | 9.800 | 9.800 | JLCPCB PCBA price page: 51-200 pcs tier $0.49/pc; 200 pcs at qty 10 = $98.00 | n/a | n/a (fab/assembly service) | https://jlcpcb.com/help/article/pcb-assembly-price | Qty 5: 100 pcs x $0.49 = $49.00 ($9.80/board). Count from sibling BOM drafts (18 leadless incl. X1SON/USON ESD) + margin; if JLC only flags the SiP + ~10 QFN/SON: qty 10 = 110 pcs x $0.49 = $53.90.
PCB + Assembly | SiP consignment (handling + inbound courier) | U1 | 1 | OSD6254-1G-IPM consigned (JLC C49026186) | JLCPCB | Overseas consignment handling 2% of declared value (min $10/shipment) + DHL inbound to JLC HK warehouse (estimate $45) | per order | JLCPCB | C49026186 | 5.500 | 5.500 | JLCPCB consignment guide: handling = 2% declared value, min $10; courier is an estimate | n/a | n/a (fab/assembly service) | https://jlcpcb.com/help/article/how-to-consign-parts-to-jlcpcb | Qty 5: $11.00/board. Excludes the SiP itself (BOM line) and the refundable import-duty + 13% VAT deposit (~$63 on 11 x $44, refunded after use). Alternative: JLC Global Sourcing (no listed fee, price difference vs DK/Mouser, 9-15 days; only in-stock DK/Mouser) -> saves this $55 but adds markup. Send 11-12 SiPs for 10 boards (attrition).
PCB + Assembly | SMT placement (per joint) | - | 1 | ~1900 SMT joints/board x $0.0016 | JLCPCB | Automated SMT assembly, ~400 placements incl. 500-ball SiP | per board | JLCPCB | Standard PCBA | 3.040 | 3.040 | JLCPCB PCBA price page: $0.0016/joint (1-50,000 joints) | n/a | n/a (fab/assembly service) | https://jlcpcb.com/help/article/pcb-assembly-price | Same per board at qty 5 ($3.04). Joint count is an estimate (SiP 500 + ~320 two-terminal passives 640 + ICs ~420 + SMD connectors ~130 + small parts ~200). Single-board minimum $0.48 not triggered.
PCB + Assembly | PCBA setup (engineering) fee | - | 1 | Standard PCBA setup, single side | JLCPCB | Standard PCBA engineering setup, top-side SMT (THT handled by manual/wave) | per order | JLCPCB | Standard PCBA | 2.556 | 2.556 | JLCPCB PCBA price page (updated 2026-09-09); per-order $25.56 / 10 | n/a | n/a (fab/assembly service) | https://jlcpcb.com/help/article/pcb-assembly-price | Qty 5: $5.112/board. Double-sided assembly: setup becomes $51.12 (+$25.56/order). Standard PCBA chosen over Economic: Economic reflow is fixed at 255 +/-5 C vs Octavo recommended 245 C peak (Standard 240 +/-5 C), no SPI, special stackups not supported.
PCB + Assembly | Assembly fixture (Standard, rigid) | - | 1 | 2 fixtures (1-29 pcs) x $8.21 | JLCPCB | Fixture fee listed for Standard PCBA rigid boards | per order | JLCPCB | Standard PCBA | 1.642 | 1.642 | JLCPCB PCBA price page: $8.21/fixture, 1-29 pcs = 2 fixtures = $16.42 | n/a | n/a (fab/assembly service) | https://jlcpcb.com/help/article/pcb-assembly-price | Qty 5: $3.284/board. Listed on the price page without stating when it applies (likely wave-solder/reflow fixture); kept as a conservative line - confirm in the live PCBA quote.
PCB + Assembly | THT hand/wave soldering | J (40-pin, RJ45, USB-A, HDMI shell) | 1 | ~70 THT joints/board x $0.0164 + $3.58/order | JLCPCB | Manual assembly of through-hole connectors (40-pin header 40, RJ45 ~14, USB-A dual ~12, HDMI shell 4) plus hand-soldering labor fee | per board + per order | JLCPCB | Standard PCBA | 1.506 | 1.506 | JLCPCB PCBA price page: manual assembly $0.0164/joint + hand-soldering labor $3.58/order | n/a | n/a (fab/assembly service) | https://jlcpcb.com/help/article/pcb-assembly-price | Qty 5: $1.864/board (labor fee spread over 5). Build time +1 day. THT parts must be JLC-library or consigned parts.
PCB + Assembly | SMT stencil | - | 1 | Standard PCBA stencil, single side | JLCPCB | Stencil generated by JLC SMT engineers (not shipped) | per order | JLCPCB | Standard PCBA | 0.821 | 0.821 | JLCPCB PCBA price page; per-order $8.21 / 10 | n/a | n/a (fab/assembly service) | https://jlcpcb.com/help/article/pcb-assembly-price | Qty 5: $1.642/board. Double-sided: $16.42 (+$8.21/order).
PCB + Assembly | MSL bake of SiP (MSL 4) | U1 | 1 | 48 h bake service | JLCPCB | Pre-assembly bake of consigned/global-sourced moisture-sensitive part (Octavo: 34 h at 125 C if floor life exceeded) | per order | JLCPCB | Bake service | 0.800 | 0.800 | JLCPCB Global Sourcing T&C: baking fee $8 per 48 h | n/a | n/a (fab/assembly service) | https://jlcpcb.com/help/article/global-sourcing-parts-order-terms-conditions | Qty 5: $1.60/board. Ask JLC to bake per Octavo DS 8.4.3 (34 h, 125 C, <5% RH) or to keep the tray dry-packed; floor life 72 h.
PCB + Assembly | Packing + confirm parts placement | - | 1 | packing $0.50 + area; placement confirm $0.45 | JLCPCB | Standard PCBA packing ($0.50 + $0.00003 x 70 cm2) and DFM parts-placement confirmation (recommended for BGA pin-1/orientation) | per order | JLCPCB | Standard PCBA | 0.095 | 0.095 | JLCPCB PCBA price page | n/a | n/a (fab/assembly service) | https://jlcpcb.com/help/article/pcb-assembly-price | Qty 5: $0.190/board. Stencil/fixture storage for reorders $4.93 each (not included).
PCB + Assembly | OPTION: double-sided assembly delta | - | 0 | Standard PCBA double side | JLCPCB | Extra setup ($51.12 vs $25.56) + stencil ($16.42 vs $8.21) if any part goes on the bottom | per order | JLCPCB | Standard PCBA | 3.377 | 0.000 | JLCPCB PCBA price page: +$33.77/order / 10 | n/a | n/a (fab/assembly service) | https://jlcpcb.com/help/article/pcb-assembly-price | Not in total (qty_per_board 0). Qty 5: +$6.754/board. Bottom-side SMT joints at the same $0.0016/joint; may add fixtures.
PCB + Assembly | OPTION: special stackup JLC06161H-3313E | PCB1 | 0 | JLC06161H-3313E | JLCPCB | Keeps the TOP/GND/SIG/PWR/GND/BOT order with every signal layer next to GND (0.10 mm cores L2-L3, L4-L5) | 100 x 70 mm | JLCPCB | JLC06161H-3313E | 6.732 | 0.000 | JLCPCB online quote 2026-10-17: stackup fee $67.32 (q10) | n/a | n/a (fab/assembly service) | https://cart.jlcpcb.com/quote | Not in total (qty_per_board 0). Qty 5: $66.74/order = +$13.348/board. 2116A/1080A/1080B/2116B/2116/7628A: $102.72 (q10).
