shikhakath/APE-SingleBoardComputer/reference/1_PROC142B/2_BOM/PROC142B(002)_BOM.xlsx

Sheet: PROC142B(002)_Assembly_BOM
Item Number | Quantity | Mistral Part No | Part Reference | Value | Description | Mfr_name | Mfr_part_number | PCB Footprint
1 | 1 | 160019020049-R | ACC1 | 9774015243R | STANDOFF BOARD TO BOARD 1.50MM LENGTH FEMALE M2 THREADED SS | WURTH ELECTRONICS | 9774015243R | NA
2 | 44 | 120018010007-R | C1 C24 C26 C30 C38 C61 C67 C84 C90 C113 C176 C181 C186 C189 C191 C220 C270 C281 C287 C288 C289 C290 C296 C329 C334 C336 C337 C339 C340 C343 C344 C346 C347 C350 C354 C358 C359 C401 C409 C422 C442 C451 C473 C490 | 0.01uF | CAP CERAMIC 0.01uF 25V 10% X5R 0201 | MURATA | GRM033R61E103KA12J | CAP0201_0-5
3 | 27 | 120013110019-R | C3 C9 C33 C39 C43 C69 C77 C142 C144 C146 C199 C201 C204 C211 C219 C230 C242 C248 C311 C313 C319 C384 C393 C406 C410 C483 C508 | 10uF | CAP CERAMIC 10uF 10V 20% X5R 0402 | MURATA | GRM155R61A106ME11D | CAP0402_0-75
4 | 181 | 120009030072-R | C4 C6 C7 C8 C10 C11 C12 C20 C22 C25 C27 C29 C31 C32 C34 C36 C40 C42 C44 C55 C56 C63 C68 C70 C73 C76 C80 C82 C83 C85 C89 C93 C102 C129 C134 C137 C140 C145 C148 C157 C159 C161 C162 C166 C167 C169 C170 C173 C184 C190 C194 C200 C207 C208 C209 C212 C213 C216 C217 C218 C221 C223 C225 C229 C231 C235 C238 C240 C241 C243 C245 C247 C250 C252 C253 C254 C255 C259 C260 C261 C262 C263 C264 C265 C266 C267 C268 C271 C272 C273 C274 C275 C277 C278 C279 C280 C282 C283 C284 C286 C291 C292 C295 C298 C300 C301 C304 C309 C310 C315 C318 C321 C325 C326 C328 C352 C361 C362 C363 C375 C381 C385 C386 C388 C394 C404 C405 C411 C429 C430 C431 C435 C437 C439 C440 C445 C446 C449 C450 C452 C453 C456 C457 C458 C462 C463 C464 C466 C467 C468 C469 C470 C472 C474 C475 C477 C478 C481 C484 C485 C487 C488 C489 C492 C493 C495 C496 C497 C499 C507 C510 C511 C512 C513 C514 C515 C516 C521 C522 C525 C539 | 0.1uF | CAP CERAMIC 0.1uF 16V 10% X5R 0201 | MURATA | GRM033R61C104KE14D | CAP0201_0-5
5 | 0 | DNI | C5 C156 | DNI | DNI | DNI | DNI | DNI
6 | 10 | 120015120001-R | C13 C65 C179 C197 C338 C341 C351 C379 C455 C482 | 2.2uF | CAP CERAMIC 2.2uF 25V 10% X5R 0402 | MURATA | GRM155R61E225KE11D | CAP0402_0-75
7 | 8 | 120018050004-R | C14 C46 C47 C193 C391 C538 C540 C541 | 1uF | CAP CERAMIC 1uF 25V 10% X6S 0402 | MURATA | GRM155C81E105KE11D | CAP0402_0-75
8 | 65 | 120011100014-R | C15 C18 C23 C45 C53 C59 C60 C64 C66 C72 C74 C94 C96 C97 C99 C101 C103 C114 C116 C118 C121 C139 C147 C153 C164 C177 C182 C183 C187 C188 C196 C202 C203 C205 C206 C210 C323 C331 C332 C333 C335 C365 C377 C380 C408 C413 C421 C426 C460 C461 C471 C476 C479 C480 C498 C509 C520 C528 C529 C531 C532 C533 C543 C544 C545 | 0.1uF | CAP CERAMIC 0.1uF 50V 10% X7R 0402 | MURATA | GRM155R71H104KE14D | CAP0402_0-75
9 | 41 | 120018090038-R | C19 C21 C28 C35 C37 C58 C62 C71 C78 C81 C88 C92 C95 C100 C178 C192 C215 C222 C224 C227 C228 C236 C237 C244 C246 C249 C285 C299 C306 C307 C308 C316 C317 C324 C330 C376 C407 C443 C454 C506 C527 | 1uF | CAP CERAMIC 1uF 16V 20% X5R 0201 | MURATA | GRM033R61C105ME15D | CAP0201_0-5
10 | 19 | 120012060002-R | C41 C48 C49 C50 C87 C104 C110 C143 C180 C198 C214 C226 C233 C293 C297 C314 C320 C423 C465 | 4.7uF | CAP CERAMIC 4.7uF 10V 20% X5R 0402 | MURATA | GRM155R61A475MEAAD | CAP0402_0-75
11 | 2 | 120009050017-R | C51 C548 | 0.1uF | CAP CERAMIC 0.1uF 10V 10% X5R 0201 | SAMSUNG | CL03A104KP3NNNC | CAP0201_0-5
12 | 3 | 120014100011-R | C52 C112 C122 | 47uF | CAP CERAMIC 47uF 10V 20% X5R 0805 | MURATA | GRM21BR61A476ME15L | CAP0805_1-5
13 | 4 | 120015030003-R | C54 C57 C546 C547 | 1uF | CAP CERAMIC 1uF 10V 20% X5R 0201 | SAMSUNG | CL03A105MP3NSNC | CAP0201_0-5
14 | 4 | 120014100019-R | C75 C79 C174 C175 | 18pF | CAP CERAMIC 18pF 50V 5% HI-Q C0G(NP0) 0402 | MURATA | GJM1555C1H180JB01D | CAP0402_0-75
15 | 9 | 120018090044-R | C86 C98 C107 C108 C117 C357 C494 C502 C503 | 2.2uF | CAP CERAMIC 2.2uF 10V 10% X5R 0201 | MURATA | GRM033R61A225KE47D | CAP0201_0-5
16 | 0 | DNI | C106 C119 C397 C399 | DNI | DNI | DNI | DNI | DNI
17 | 4 | 120022060019-R | C115 C355 C387 C549 | 0.1uF | CAP CERAMIC 0.1uF 16V 10% X5R 0201 | MURATA | GRT033R61C104KE01 | CAP0201_0-5
18 | 5 | 120021100001-R | C135 C136 C151 C152 C526 | 220pF | CAP CERAMIC 220pF 100V 5% C0G(NP0) 0402 | MURATA | GRM1555C2A221JE01D | CAP0402_0-75
19 | 0 | DNI | C138 | DNI | DNI | DNI | DNI | DNI
20 | 6 | 120019050016-R | C141 C150 C155 C400 C414 C424 | 10uF | CAP CERAMIC 10uF 35V 20% X5R 0603 | MURATA | GRM188R6YA106MA73D | CAP0603_1
21 | 2 | 120021030002-R | C149 C425 | 10uF | CAP CERAMIC 10uF 50V 10% X5R 0805 | MURATA | GRM21BR61H106KE43L | CAP0805_1-5
22 | 3 | 120021070001-R | C154 C395 C419 | 47uF | CAP CERAMIC 47uF 16V 10% X6S 1210 | MURATA | GRM32EC81C476KE15L | CAP1210_2-75
23 | 3 | 120013120018-R | C158 C160 C420 | 22uF | CAP CERAMIC 22uF 25V 20% X5R 0805 | MURATA | GRM21BR61E226ME44K | CAP0805_1-5
24 | 2 | 120009030213-R | C171 C172 | 12pF | CAP CERAMIC 12pF 25V 5% C0G(NP0) 0201 | MURATA | GRM0335C1E120JA01D | CAP0201_0-5
25 | 0 | DNI | C185 C195 C327 C372 C392 C427 | DNI | DNI | DNI | DNI | DNI
26 | 1 | 120016010019-R | C232 | 4.7uF | CAP CERAMIC 4.7uF 6.3V 10% X5R AUTO 0603 | MURATA | GRT188R60J475KE01D | CAP0603_1
27 | 3 | 120021070019-R | C234 C312 C519 | 22pF | CAP CERAMIC 22pF 25V 1% C0G(NP0) 0201 | MURATA | GRM0335C1E220FA01D | CAP0201_0-5
28 | 9 | 120019050005-R | C239 C251 C256 C257 C258 C269 C276 C294 C302 | 1uF | CAP CERAMIC 1uF 10V 10% X5R 0201 | SAMSUNG | CL03A105KP3NSNC | CAP0201_0-5
29 | 0 | DNI | C303 C305 | DNI | DNI | DNI | DNI | DNI
30 | 1 | 120014100009-R | C349 | 22uF | CAP CERAMIC 22uF 10V 20% X5R 0603 | MURATA | GRM188R61A226ME15D | CAP0603_1
31 | 1 | 120022060023-R | C356 | 10uF | CAP CERAMIC 10uF 25V 20% X5R AUTO 0603 | MURATA | GRT188R61E106ME13 | CAP0603_1
32 | 1 | 120021090007-R | C371 | 150uF_10V | CAP TANTALUM 150uF 10V 10% ESR 600mE D7343 | VISHAY | 293D157X9010D2TE3 | CAPT7343D_3-25
33 | 3 | 120013030002-R | C396 C398 C418 | 1uF | CAP CERAMIC 1uF 100V 10% X7S 0805 | MURATA | GRM21BC72A105KE01L | CAP0805_1-5
34 | 1 | 120021100002-R | C402 | 36pF | CAP CERAMIC 36pF 50V 2% HI-Q C0G(NP0) 0402 | MURATA | GJM1555C1H360GB01D | CAP0402_0-75
35 | 1 | 120021060019-R | C412 | 0.47uF | CAP CERAMIC 0.47uF 10V 10% X7R 0402 | MURATA | GRM155R71A474KE01D | CAP0402_0-75
36 | 1 | 120011070010-R | C415 | 4.7uF | CAP CERAMIC 4.7uF 50V 10% X5R 0805 | TDK CORPORATION | C2012X5R1H475K | CAP0805_1-5
37 | 4 | 120013120015-R | C416 C417 C517 C518 | 47uF | CAP CERAMIC 47uF 10V 20% X5R 1206 | MURATA | GRM31CR61A476ME15L | CAP1206_2
38 | 0 | DNI | C432 C433 | DNI | DNI | DNI | DNI | DNI
39 | 1 | 120016120011-R | C441 | 15pF | CAP CERAMIC 15pF 25V 2% HI-Q C0G(NP0) 0201 | MURATA | GJM0335C1E150GB01D | CAP0201_0-5
40 | 1 | 120020100018-R | C459 | 8.2pF | CAP CERAMIC 8.2pF 25V 0.5pF C0G(NP0) 0201 | MURATA | GRM0335C1E8R2DA01D | CAP0201_0-5
41 | 5 | 120021120018-R | C491 C534 C535 C536 C537 | 47pF | CAP CERAMIC 47pF 50V 5% C0G(NP0) AUTO 0201 | MURATA | GRT0335C1H470JA02D | CAP0201_0-5
42 | 1 | 120014100023-R | C542 | 22pF | CAP CERAMIC 22pF 50V 5% C0G(NP0) 0402 | MURATA | GRM1555C1H220JA01D | CAP0402_0-75
43 | 2 | 130017100002-R | D1 D14 | BZX84C6V8LT1G | DIODE ZENER 250mW 6.8V SOT23-123 | ON SEMICONDUCTOR | BZX84C6V8LT1G | SOT23-123_1-2
44 | 4 | 130020090037-R | D2 D4 D9 D10 | TPD1E01B04DPLT | DIODE 1CH ESD PROTECTION FOR USB TYPE-C AND THUNDERBOLT3 X2SON2 | TEXAS INSTRUMENTS | TPD1E01B04DPLT | DIO_DFN0201_0-4
45 | 1 | 130017080015-R | D5 | ESD122DMXR | DIODE 2-CH ESD PROTECTION FOR USB TYPE-C AND HDMI 2.0 X2SON-3 | TEXAS INSTRUMENTS | ESD122DMXR | X2SON3_ESD122DMX_30X40_0-4
46 | 7 | 130014110022-R | D7 D8 D12 D13 D15 D16 D17 | TPD1E10B06DPYR | DIODE 1CH ESD PROTECTION X1SON2 | TEXAS INSTRUMENTS | TPD1E10B06DPYR | DIO_DFN0402_0-5
47 | 3 | 130014060028-R | FB1 FB2 FB3 | 300E | IND FERRITE CHIP 300E 500mA 0603 | TDK CORPORATION | MMZ1608R301A | IND0603
48 | 0 |  | FID1 | DNI |  |  |  | DNI
49 | 0 |  | FID2 | DNI |  |  |  | DNI
50 | 0 |  | FID3 | DNI |  |  |  | DNI
51 | 0 |  | FID4 | DNI |  |  |  | DNI
52 | 0 |  | FID5 | DNI |  |  |  | DNI
53 | 0 |  | FID6 | DNI |  |  |  | DNI
54 | 18 | 130013060022-R | FL3 FL5 FL6 FL8 FL9 FL10 FL12 FL13 FL14 FL16 FL17 FL18 FL19 FL21 FL22 FL23 FL25 FL26 | 120E | IND FERRITE BEAD CHIP 120E 2A 0402 | MURATA | BLM15PX121SN1D | EMIFIL_BLM15A_0402_0-6
55 | 2 | 130013100028-R | FL4 FL7 | 26E | FERRITE CHIP 26E 6A 0603 | MURATA | BLM18SG260TN1D | EMIFIL_BLM18K_0603_0-7
56 | 0 | DNI | FL15 FL20 | DNI | DNI | DNI | DNI | DNI
57 | 1 | 150021030016-R | J2 | CON_MINIPCIE_75_F | CON MINIPCI 75POS 0.50MM PITCH FEMALE RT SMD | TE CONNECTIVITY | 2199119-4_2230 | CON_MINIPCI75_2199119-4_S_R_S_3-2_2230
58 | 1 | 150020100013-R | J3 | HDR_2X20 | CON HDR 2X20 2.54MM PITCH ST TH | SULLINS CONNECTOR | PEC20DAAN | HDR_2X20_PEC20DAAN_S_T_8-6
59 | 2 | 150014060029-R | J4 J6 | CON_RJ45-14_LPJG16314A4NL | CON RJ-45 FEMALE 14POS RT TH | LINK-PP | LPJG16314A4NL | CON_RJ45-14_LPJG16314A4NL_S_R_T_13-6
60 | 1 | 150010050001-R | J5 | CON_HDMI_1X19_F | CON HDMI-A TYPE 1X19 0.50MM PITCH FEMALE RT SMD | FCI | 10029449-001RLF | CON_19X1_10029449-001RLF_S_R_S_6-3
61 | 1 | 150017100042-R | J7 | CON_USB-A_4_F | CON USB-A TYPE 4POS FEMALE RT SMD | WURTH ELECTRONICS | 629104151021 | CON_USBA4_629104151_S_R_S_7-4
62 | 5 | 150012100005-R | J8 J14 J24 J25 J26 | HDR_1X2 | CON HDR 1X2 2.54MM PITCH ST TH | MOLEX | 90120-0122 | HDR_1X2_90120-0122_S_T_5-6
63 | 1 | 150014110005-R | J9 | HDR_2X14 | CON HDR 2X14 2.54MM PITCH ST TH | SULLINS | PREC014DAAN-RC | HDR_14X2_100_S_T
64 | 1 | 150021070022-R | J10 | HDR_2X10 | CON HDR 2X10 2.54MM PITCH ST TH | SULLINS CONNECTOR | PREC010DAAN-RC | HDR_2X10_PREC010DAAN_S_T_8-4
65 | 2 | 150018060002-R | J11 J13 | CON_USB-C_24_F | CON USB-C TYPE 24POS FEMALE RT SMD | MOLEX | 2012670005 | CON_USBC24_2012670_S_R_S_3-9
66 | 1 | 150010060028-R | J12 | CON_AUDIOJACK4_SJ-43514-SMT | CON AUDIO JACK 4POS FEMALE RT SMD | CUI INC | SJ-43514-SMT-TR | CON_AV4_SJ-43514-SMT_S_R_S_5-1
67 | 2 | 150019050015-R | J15 J16 | CON_MUSB-B_5_F | CON MICRO USB TYPE B 5POS FEMALE RT SMD | WURTH ELECTRONICS | 629105150521 | CON_MUSBB5_629105150521_S_R_S_2-7
68 | 1 | 150011090001-R | J17 | HDR_2X10 | CON HDR 2X10 1.27MM PITCH ST SMD | SAMTEC | FTR-110-51-S-D-06 | HDR_2X10_FTR-110-51-D-06_S_S_8-7
69 | 1 | 150020060004-R | J19 | CON_FLEX_1X15_1-1734248-5 | CON FPC 1X15 1.00MM PITCH FEMALE ST SMD | TE CONNECTIVITY | 1-1734248-5 | CON_FLEX1X15_1-1734248-5_S_S_S_7-7
70 | 1 | 150021090028-R | J20 | CON_SDCARD9_MEM2051-00-195-00-A | CON MICROSD CARD 9POS FEMALE RT SMD | GCT | MEM2051-00-195-00-A | CON_SD9_MEM2051-00-195-00_S_R_S_2-1
71 | 1 | 150021100004-R | J21 | CON_FLEX_1X40_FFC2A32 | CON FPC 1X40 0.50MM PITCH FEMALE ST SMD | GCT | FFC2A32-40-T | CON_FLEX1X40_FFC2A32-40-T_S_S_S_4-3
72 | 0 | DNI | J22 | DNI | DNI | DNI | DNI | DNI
73 | 1 | 150009030176-R | J23 | CON_FLEX_40X1_FH12A-40S-0.5SH | CON FPC 40X1 0.50MM PITCH RT TOP SMD | HIROSE ELECTRIC EUROPE | FH12A-40S-0.5SH(55) | CON_FLEX40X1_FH12A_S_R_S
74 | 3 | 130020100030-R | L5 L7 L8 | 0.47uH | IND CHIP 0.47uH 4.5A 20% 0806 | MURATA | DFE201612E-R47M=P2 | IND0806_1-2
75 | 2 | 130019060035-R | L9 L10 | 90E | IND COMMON MODE CHOKE 90E 280mA SMD | MURATA | DLW21SZ900HQ2B | IND4_DLW21H_90X60_SMD_1-4
76 | 1 | 130015090013-R | L12 | 4.7uH | IND POWER 4.7uH 11A 20% SMD | COILCRAFT | XAL6060-472MEB | IND_XAL6060_260X270_SMD_6-1
77 | 1 | 130019100011-R | L13 | 1.5uH | IND POWER 1.5uH 9.1A 20% SMD | COIL CRAFT | XFL4020-152MEB | IND_XFL4020_170X170_SMD_2-1
78 | 0 | DNI | LBL1 LBL2 LBL3 | DNI | DNI | DNI | DNI | DNI
79 | 8 | 130020080012-R | LD1 LD10 LD11 LD12 LD13 LD14 LD16 LD17 | 150080VS75000 | DIODE LED BRIGHT GREEN SMD | WURTH ELECTRONICS | 150080VS75000 | LED_150080VS75000_80X50_SMD_0-8
80 | 4 | 130020110071-R | LD2 LD4 LD7 LD9 | 150040VS73220 | DIODE LED BRIGHT GREEN SMD | WURTH ELECTRONIK | 150040VS73220 | LED_150040GS73220_40X20_SMD_0-4
81 | 3 | 130020090020-R | LD3 LD8 LD15 | 150040RS73220 | DIODE LED RED SMD | WURTH ELECTRONICS | 150040RS73220 | LED_150040GS73220_40X20_SMD_0-4
82 | 2 | 130020090022-R | LD5 LD6 | 150040AS73220 | DIODE LED AMBER SMD | WURTH ELECTRONICS | 150040AS73220 | LED_150040GS73220_40X20_SMD_0-4
83 | 0 |  | LOGO1 | DNI
84 | 0 |  | LOGO2 | DNI |  |  |  | DNI
85 | 0 |  | LOGO3 | DNI
86 | 0 |  | LOGO4 | DNI |  |  |  | DNI
87 | 1 | 160019030017-R | MH1 | FLAT WASHER_M2 | FLAT WASHER FOR M2 NYLON | KEYSTONE | 3356 | NA
88 | 1 | 160019030026-R | MH2 | PAN HEAD_M2 X 5 | PHILLIPS PAN HEAD SCREW - M2 X 5 | B AND F FASTENER | MPMS 002 0005 PH | NA
89 | 1 | FY201506000101 | PCB1 | PROC142B | AM62x SKEVM Bare PCB |  | PROC142B
90 | 10 | 142020120008-R | Q1 Q3 Q4 Q5 Q6 Q7 Q8 Q9 Q13 Q20 | CSD16301Q2 | IC MOSFET N-CHANNEL NEXFET 25V WSON6 | TEXAS INSTRUMENTS | CSD16301Q2 | WSON6_CSD13202Q2_80X80_0-8
91 | 0 | DNI | Q2 | DNI | DNI | DNI | DNI | DNI
92 | 2 | 142015120011-R | Q14 Q16 | CSD25310Q2 | IC MOSFET P-CHANNEL WSON6 | TEXAS INSTRUMENTS | CSD25310Q2 | SON6_CSD17313Q2_80X80
93 | 2 | 130009031213-P | Q17 Q18 | IRLML6401 | TRANSISTOR MOSFET P-CHANNEL SOT23-3 | IRF | IRLML6401TRPBF | TO_SOT23-123
94 | 59 | 110010070067-R | R1 R7 R11 R15 R32 R39 R55 R57 R60 R62 R66 R74 R83 R87 R89 R105 R116 R157 R163 R224 R225 R226 R229 R230 R231 R232 R287 R301 R302 R314 R331 R353 R354 R422 R437 R438 R439 R440 R441 R446 R460 R464 R468 R473 R477 R478 R480 R540 R608 R625 R638 R639 R643 R654 R677 R678 R695 R702 R791 | 0E | RES 0E 1/20W 5% 0201 | YAGEO AMERICA | RC0201JR-070RL | RES0201_0-5
95 | 0 | DNI | R2 R3 R4 R23 R52 R158 R164 R221 R385 R492 R676 R721 R722 | DNI | DNI | DNI | DNI | DNI
96 | 0 | DNI | R5 | DNI | DNI | DNI | DNI | DNI
97 | 143 | 110010070051-R | R6 R12 R16 R17 R25 R26 R27 R28 R35 R58 R63 R77 R94 R104 R107 R111 R112 R114 R117 R118 R140 R160 R162 R165 R169 R176 R177 R179 R180 R181 R184 R185 R187 R191 R192 R193 R196 R197 R199 R200 R218 R252 R253 R254 R285 R296 R300 R313 R315 R317 R322 R325 R333 R351 R373 R380 R381 R388 R389 R393 R398 R402 R420 R427 R432 R433 R450 R451 R452 R457 R469 R472 R475 R481 R486 R487 R488 R489 R495 R502 R514 R517 R521 R522 R531 R537 R538 R539 R541 R542 R543 R554 R555 R558 R559 R562 R564 R566 R567 R568 R572 R574 R575 R576 R577 R578 R579 R585 R586 R587 R601 R602 R606 R609 R655 R657 R659 R660 R661 R662 R663 R664 R665 R685 R688 R691 R696 R700 R703 R713 R714 R715 R717 R719 R765 R766 R767 R768 R769 R770 R778 R789 R790 | 10K | RES 10K 1/20W 5% 0201 | YAGEO AMERICA | RC0201JR-0710KL | RES0201_0-5
98 | 0 | DNI | R10 R90 R364 R365 R366 R367 R376 R377 R379 | DNI | DNI | DNI | DNI | DNI
99 | 38 | 110021090007-R | R13 R30 R31 R61 R71 R73 R201 R262 R264 R265 R270 R391 R392 R403 R404 R490 R491 R498 R499 R550 R561 R573 R581 R592 R599 R600 R611 R666 R667 R684 R686 R687 R689 R690 R782 R783 R787 R788 | 4.7K | RES 4.7K 1/20W 5% 0201 | YAGEO AMERICA | RC0201JR-074K7L | RES0201_0-5
100 | 21 | 110011060021-R | R14 R41 R96 R120 R266 R272 R273 R274 R304 R370 R425 R426 R445 R470 R509 R533 R671 R704 R784 R785 R786 | 10K | RES 10K 1/16W 5% 0402 | VISHAY | CRCW040210K0JNED | RES0402_0-5
101 | 12 | 110009030882-R | R18 R19 R20 R21 R22 R80 R81 R82 R91 R92 R378 R396 | 47K | RES 47K 1/10W 5% 0402 | PANASONIC-ECG | ERJ-2GEJ473X | RES0402_0-5
102 | 3 | 110010070052-R | R24 R535 R603 | 33E | RES 33E 1/20W 5% 0201 | PANASONIC-ECG | ERJ-1GEJ330C | RES0201_0-5
103 | 6 | 110011020013-R | R29 R178 R219 R256 R339 R418 | 0E | RES 0E 1/10W 5% 0603 | PANASONIC-ECG | RC0603JR-070RL | RES0603_0-75
104 | 61 | 110010080019-R | R33 R34 R37 R64 R72 R78 R79 R95 R101 R102 R109 R115 R124 R125 R149 R155 R198 R222 R280 R281 R282 R283 R284 R289 R312 R321 R324 R335 R338 R340 R359 R383 R387 R483 R485 R525 R544 R569 R570 R571 R580 R583 R589 R590 R591 R594 R595 R596 R597 R598 R616 R673 R674 R726 R727 R729 R730 R731 R754 R755 R756 | 0E | RES 0E 1/16W JUMPER 0402 | VISHAY | CRCW04020000Z0ED | RES0402_0-5
105 | 0 | DNI | R38 R49 R76 R85 R86 R291 R292 R293 R294 R295 R311 R344 R345 R346 R347 R348 R356 R357 | DNI | DNI | DNI | DNI | DNI
106 | 5 | 110016050020-R | R47 R54 R84 R299 R350 | 2.49K_1% | RES 2.49K 1/16W 1% 0402 | YAGEO AMERICA | RC0402FR-072K49L | RES0402_0-5
107 | 5 | 110018030003-R | R48 R70 R106 R134 R148 | 0.01E_1% | RES 0.01E 1W 1% 1206-4 | SUSUMU | KRL3216T4A-M-R010-F-T1 | RES_KRL3216T4_1206-4_0-7
108 | 0 | DNI | R53 R93 R110 R113 R145 R146 R147 R154 R189 R194 R235 R290 R337 R355 R358 R421 R466 R615 R750 R751 R752 R753 R775 | DNI | DNI | DNI | DNI | DNI
109 | 11 | 110022010018-R | R56 R320 R336 R343 R369 R372 R382 R384 R553 R565 R748 | 22E | RES 22E 1/16W 5% 0402 | YAGEO AMERICA | RC0402JR-0722RL | RES0402_0-5
110 | 14 | 110024040012-R | R65 R360 R732 R733 R734 R735 R736 R738 R739 R740 R741 R742 R745 R761 | 22E | RES 22E 1/20W 5% 0201 | YAGEO | RC0201JR-0722RL | RES0201_0-5
111 | 3 | 110020080006-R | R67 R68 R69 | 499E_1% | RES 499E 1/16W 1% 0402 | YAGEO AMERICA | RC0402FR-07499RL | RES0402_0-5
112 | 4 | 110009030859-R | R88 R188 R614 R617 | 470E | RES 470E 1/10W 5% 0402 | PANASONIC-ECG | ERJ-2GEJ471X | RES0402_0-5
113 | 2 | 110011060017-R | R98 R135 | 240E_1% | RES 240E 1/10W 1% 0402 | PANASONIC-ECG | ERJ-2RKF2400X | RES0402_0-5
114 | 1 | 110010120009-R | R108 | 1.1K_1% | RES 1.1K 1/16W 1% 0402 | VISHAY | CRCW04021K10FKED | RES0402_0-5
115 | 0 | DNI | R119 R442 R672 R681 | DNI | DNI | DNI | DNI | DNI
116 | 0 | DNI | R121 | DNI | DNI | DNI | DNI | DNI
117 | 45 | 110009030400-R | R122 R182 R227 R236 R237 R238 R239 R240 R241 R242 R243 R244 R245 R246 R247 R248 R249 R250 R251 R267 R271 R305 R400 R461 R494 R501 R504 R506 R508 R511 R513 R516 R518 R527 R552 R556 R560 R563 R651 R656 R692 R693 R694 R716 R718 | 1K | RES 1K 1/10W 5% 0402 | PANASONIC-ECG | ERJ-2GEJ102X | RES0402_0-5
118 | 0 | DNI | R123 | DNI | DNI | DNI | DNI | DNI
119 | 2 | 110023110006-R | R152 R649 | 3.48K_1% | RES 3.48K 1/20W 1% 0201 | PANASONIC-ECG | ERJ-1GNF3481C | RES0201_0-5
120 | 2 | 110020120011-R | R153 R648 | 16.5K_1% | RES 16.5K 1/16W 1% 0402 | YAGEO AMERICA | RC0402FR-0716K5L | RES0402_0-5
121 | 4 | 110011040018-R | R156 R328 R361 R647 | 10K_1% | RES 10K 1/20W 1% 0201 | YAGEO AMERICA | RC0201FR-0710KL | RES0201_0-5
122 | 15 | 110009030506-R | R159 R161 R166 R167 R168 R170 R171 R175 R257 R286 R288 R334 R341 R342 R371 | 220E | RES 220E 1/10W 5% 0402 | PANASONIC-ECG | ERJ-2GEJ221X | RES0402_0-5
123 | 0 | DNI | R172 R173 R190 R195 R220 R297 R329 R362 R374 R390 R394 R431 R459 R474 R526 R546 R584 R605 R607 R650 R658 R712 | DNI | DNI | DNI | DNI | DNI
124 | 20 | 110011060002-R | R202 R203 R204 R205 R206 R207 R208 R209 R210 R211 R212 R213 R214 R215 R216 R217 R453 R465 R471 R497 | 100K | RES 100K 1/16W 5% 0402 | YAGEO AMERICA | RC0402JR-07100KL | RES0402_0-5
125 | 0 | DNI | R223 R515 | DNI | DNI | DNI | DNI | DNI
126 | 1 | 110009030846-R | R228 | 49.9E_1% | RES 49.9E 1/16W 1% 0402 | VISHAY | CRCW040249R9FKEDC | RES0402_0-5
127 | 0 | DNI | R255 R258 R259 R260 | DNI | DNI | DNI | DNI | DNI
128 | 1 | 110009030803-R | R261 | 4.87K_1% | RES 4.87K 1/16W 1% 0402 | PANASONIC-ECG | ERJ2RKF4871X | RES0402
129 | 2 | 110017080023-R | R268 R519 | 30K | RES 30K 1/16W 5% 0402 | VISHAY | CRCW040230K0JNED | RES0402_0-5
130 | 1 | 110009030486-R | R269 | 20K_1% | RES 20K 1/16W 1% 0402 | VISHAY | CRCW040220K0FKED | RES0402_0-5
131 | 2 | 110009030945-R | R298 R349 | 5.76K_1% | RES 5.76K 1/10W 1% 0402 | PANASONIC-ECG | ERJ-2RKF5761X | RES0402_0-5
132 | 8 | 110024080020-R | R303 R306 R307 R308 R309 R310 R318 R319 | 47K | RES 47K 1/20W 5% 0201 | PANASONIC-ECG | ERJ-1GNJ473C | RES0201_0-5
133 | 0 | DNI | R316 R323 | DNI | DNI | DNI | DNI | DNI
134 | 0 | DNI | R326 R764 | DNI | DNI | DNI | DNI | DNI
135 | 1 | 110009031092-R | R327 | 7.5K | RES 7.5K 1/16W 5% 0402 | VISHAY | CRCW04027K50JNED | RES0402_0-5
136 | 2 | 110009030427-R | R330 R363 | 2.2K | RES 2.2K 1/20W 5% 0201 | PANASONIC-ECG | ERJ-1GEJ222C | RES0201_0-5
137 | 4 | 110010120018-R | R352 R479 R551 R680 | 2.2K | RES 2.2K 1/16W 5% 0402 | YAGEO AMERICA | RC0402JR-072K2L | RES0402_0-5
138 | 1 | 110015050015-R | R375 | 10K_1% | RES 10K 1/10W 1% 0402 | PANASONIC-ECG | ERJ-2RKF1002X | RES0402_0-5
139 | 0 | DNI | R386 | DNI | DNI | DNI | DNI | DNI
140 | 2 | 110011040030-R | R395 R397 | 39.2E_1% | RES 39.2E 1/16W 1% 0402 | STACKPOLE ELECTRONICS | RMCF0402FT39R2 | RES0402_0-5
141 | 0 | DNI | R399 | DNI | DNI | DNI | DNI | DNI
142 | 2 | 110022080039-R | R407 R408 | 1K_1% | RES 1K 1/20W 1% 0201 | PANASONIC-ECG | ERJ-1GNF1001C | RES0201_0-5
143 | 1 | 110014060045-R | R449 | 1M_1% | RES 1M 1/16W 1% 0402 | YAGEO AMERICA | RC0402FR-071ML | RES0402_0-5
144 | 1 | 110020040003-R | R454 | 32.4K_1% | RES 32.4K 1/16W 1% 0402 | VISHAY | CRCW040232K4FKED | RES0402_0-5
145 | 2 | 110009030187-R | R455 R780 | 100K_1% | RES 100K 1/10W 1% 0402 | PANASONIC-ECG | ERJ-2RKF1003X | RES0402_0-5
146 | 1 | 110021080019-R | R467 | 43.2K_1% | RES 43.2K 1/16W 1% 0402 | VISHAY | CRCW040243K2FKED | RES0402_0-5
147 | 1 | 110009030176-R | R484 | 100K | RES 100K 1/20W 5% 0201 | PANASONIC-ECG | ERJ-1GEJ104C | RES0201_0-5
148 | 1 | 110009030966-R | R520 | 51K | RES 51K 1/16W 5% 0402 | VISHAY | CRCW040251K0JNED | RES0402_0-5
149 | 2 | 110014070015-R | R530 R557 | 100E_1% | RES 100E 1/16W 1% 0402 | YAGEO AMERICA | RC0402FR-07100RL | RES0402_0-5
150 | 4 | 110009030074-R | R582 R612 R699 R725 | 0E | RES 0E 1/8W 5% 0805 | YAGEO AMERICA | RC0805JR-070RL | RES0805_0-75
151 | 1 | 110019040053-R | R593 | 12K_1% | RES 12K 1/10W 1% 0402 | PANASONIC-ECG | ERJ-2RKF1202X | RES0402_0-5
152 | 5 | 110026030006-R | R613 R743 R744 R746 R747 | 62E | RES 62E 1/20W 1% 0201 | PANASONIC | ERJ-1GNF62R0C | RES0201_0-5
153 | 0 | DNI | R618 | DNI | DNI | DNI | DNI | DNI
154 | 6 | 110010070051-R | R620 R621 R624 R675 R679 R682 | 10K | RES 10K 1/20W 5% 0201 | PANASONIC-ECG | ERJ-1GEJ103C | RES0201_0-5
155 | 1 | 110011060012-R | R645 | 130K_1% | RES 130K 1/10W 1% 0402 | PANASONIC-ECG | ERJ-2RKF1303X | RES0402_0-5
156 | 1 | 110011040004-R | R646 | 680K_1% | RES 680K 1/10W 1% 0402 | PANASONIC-ECG | ERJ-2RKF6803X | RES0402_0-5
157 | 2 | 110009030149-R | R668 R669 | 1.8K | RES 1.8K 1/20W 1% 0201 | YAGEO AMERICA | ERJ-1GEF182C | RES0201_0-5
158 | 1 | 110010070001-R | R701 | 8.2K_1% | RES 8.2K 1/20W 1% 0201 | VISHAY | CRCW02018K20FKED | RES0201_0-5
159 | 4 | 110009030875-R | R757 R758 R759 R760 | 47E | RES 47E 1/20W 5% 0201 | PANASONIC-ECG | ERJ-1GEJ470C | RES0201_0-5
160 | 2 | 110025070048-R | R776 R777 | 3.9K | RES 3.9K 1/16W 5% 0402 | YAGEO AMERICA | RC0402JR-073K9L | RES0402_0-5
161 | 1 | 110018030052-R | R779 | 0E | RES 0E 1/10W JUMPER 0402 | PANASONIC-ECG | ERJ-2GE0R00X | RES0402_0-5
162 | 1 | 110022010016-R | R781 | 182K_1% | RES 182K 1/16W 1% 0402 | YAGEO AMERICA | RC0402FR-07182KL | RES0402_0-5
163 | 2 | 110015050003-R | RA1 RA2 | 1K | RES ARRAY 1K 31mW 5% 0201-4 | PANASONIC-ECG | EXB-18V102JX | RESA_EXB_0201-4_0-5
164 | 2 | 110018090033-R | RA3 RA4 | 0E | RES ARRAY 0E 31mW JUMPER 0201-4 | PANASONIC-ECG | EXB-18VR000X | RESA_EXB_0201-4_0-5
165 | 2 | 130020100001-R | SW1 SW2 | 416131160808 | SWITCH SLIDE SPST ST SMD | WURTH ELECTRONICS | 416131160808 | SW16_416131160808_460X230_SMD_2-7
166 | 2 | 130015110004-R | SW3 SW4 | 7914G-1-000E | SWITCH SPST-NO 4MM SQ SMD 7914G | BOURNS | 7914G-1-000E | SW4_100X216_200X200_SMD_4-2
167 | 1 | 130020100002-R | SW5 | 436331045822 | SWITCH TACTILE SPST RT SMD | WURTH ELECTRONICS | 436331045822 | SW4_436331045822_190X190_SMD_1-7
168 | 0 | DNI | TP1 TP2 TP3 TP4 TP11 TP12 TP13 TP14 TP15 TP16 TP17 TP18 TP19 TP20 TP21 TP22 TP23 TP24 TP25 TP26 TP27 TP28 TP29 TP30 TP31 TP32 TP33 TP34 TP35 TP36 TP37 TP39 TP40 TP41 TP42 TP43 TP45 TP49 TP50 TP51 TP52 TP53 TP54 TP55 TP60 TP61 TP62 TP63 TP64 TP66 TP67 TP68 TP69 TP70 TP73 TP74 TP75 TP76 TP77 TP78 TP79 TP80 TP81 TP82 TP83 TP84 TP85 TP86 TP88 TP90 TP91 TP92 TP93 TP95 TP98 TP99 TP100 TP101 TP102 TP103 TP104 TP105 TP108 TP109 TP111 TP112 TP113 TP114 TP115 TP116 TP117 TP120 TP121 TP122 TP123 TP124 | DNI | DNI | DNI | DNI | DNI
169 | 0 | DNI | TP56 TP59 TP65 | DNI | DNI | DNI | DNI | DNI
170 | 0 | DNI | TP57 TP58 TP71 TP72 TP96 TP97 | DNI | DNI | DNI | DNI | DNI
171 | 0 | DNI | U1 | DNI | DNI | DNI | DNI | DNI
172 | 1 | 141221060001 | U12 | AM6254ATCGGAALW | IC AM62 SoC MICROPROCESSOR BGA425 | TEXAS INSTRUMENTS | AM6254ATCGGAALW | BGA425_19-68_510X510_0-7
173 | 1 | 141009030362-R | U2 | TXS0104ERGYR | IC 4-BIT BIDIRECTIONAL VOLTAGE-LEVEL TRANSLATOR QFN14 | TEXAS INSTRUMENTS | TXS0104ERGYR | QFN14_19-68_145X145
174 | 7 | 141009110005-P | U3 U84 U85 U88 U92 U93 U97 | SN74AVC4T245DGVR | IC 4-BIT DUAL SUPPLY BUS TRANSCEIVER TVSOP16 | TEXAS INSTRUMENTS | SN74AVC4T245DGVR | TVSOP16_15-74_150X180
175 | 1 | 142021010016-R | U4 | TPS22946YZPR | IC CURRENT-LIMITED LOAD SWITCH WITH SHUTOFF AUTO-RESTART AND OVERCURRENT CONDITION TIME-OUT DSBGA6 | TEXAS INSTRUMENTS | TPS22946YZPR | DSBGA6_19-68_40X60_0-5
176 | 6 | 141009060026-R | U6 U43 U54 U58 U71 U105 | SN74LVC1G08DBVRE4 | IC SINGLE 2-INPUT POSITIVE AND GATE SOT23-5 | TEXAS INSTRUMENTS | SN74LVC1G08DBVRE4 | SOT23-5
177 | 2 | 130021100008-R | U7 U59 | 12.288MHz | OSC 12.288MHz CMOS SMD | KYOCERA | KC2520Z12.2880C1KX00 | OSC4_KC2520B_100X80_SMD_0-8
178 | 5 | 142021080022-R | U8 U16 U23 U25 U37 | INA231AIYFDR | IC HIGH OR LOW SIDE MEASUREMENT BI-DIR CURRENT AND POWER MONITOR WITH 1.8V I2C INTERFACE DSBGA12 | TEXAS INSTRUMENTS | INA231AIYFDR | DSBGA12_15-74_60X70_0-4
179 | 1 | 141120010002 | U9 | S28HS512TGABHM010 | IC 1.8V 512Mb SEMPER FLASH WITH OCTAL INTERFACE BGA24 | CYPRESS SEMICONDUCTOR | S28HS512TGABHM010 | BGA24_39-37_240X310_1
180 | 1 | 141010060001 | U10 | SiI9022ACNU | IC HDMI TRANSMITTER QFN72 | SILICON IMAGE | SiI9022ACNU | QFN72_19-68_390X390_0-9
181 | 2 | 141017080030-R | U11 U33 | TMP100NA/3K | IC TEMPERATURE SENSOR WITH I2C AND SMBUS INTERFACE SOT23-6 | TEXAS INSTRUMENTS | TMP100NA/3K | SOT23-6_1-5
182 | 1 | 142025070014-R | U13 | TPS22996HQDYCRQ1 | IC 5.5V 4A 13MO ON-RESISTANCE DUAL-CHANNEL AUTOMOTIVE LOAD SWITCH SOT583-8 | TEXAS INSTRUMENTS | TPS22996HQDYCRQ1 | SOT5X3-8_0-6
183 | 1 | 142022100015-R | U14 | TPS6521904RHBR | IC INTEGRATED POWER MANAGEMENT FOR ARM CORTEX-A53 PROCESSOR AND FPGA QFN32 | TEXAS INSTRUMENTS | TPS6521904RHBR | QFN32_19-68_200X200_1_EP3-8
184 | 1 | 141011080020-R | U15 | TPD6E001RSER | IC 6CH ESD-PROTECTION ARRAY UQFN10 | TEXAS INSTRUMENTS | TPD6E001RSER | UQFN10_19-68_80X60_0-6
185 | 3 | 141009030117-R | U17 U63 U65 | SN74CB3Q3257PWR | IC 4BIT 1-OF-2 FET MULTIPLEXER/DEMULTIPLEXER TSSOP16 | TEXAS INSTRUMENTS | SN74CB3Q3257PWR | TSSOP16_25-59_205X180
186 | 2 | 140110060007-R | U18 U44 | TPD2E001DRLR | IC ESD-PROTECTION DIODE ARRAYS SOT-5 | TEXAS INSTRUMENTS | TPD2E001DRLR | SOT553-5_0-6
187 | 4 | 141012050010-R | U20 U80 U86 U109 | TXS0102DQER | IC 2-BIT BI-DIR VOLTAGE-LEVEL TRANSLATOR FOR OPEN-DRAIN AND PUSH-PULL X2SON8 | TEXAS INSTRUMENTS | TXS0102DQER | X2SON8_TXS0102_40X60_0-4
188 | 1 | 142021010009-R | U21 | TLV75518PDBVR | IC 1.8V 500mA LOW IQ LDO REGULATOR SOT23-5 | TEXAS INSTRUMENTS | TLV75518PDBVR | SOT23-5_1-5
189 | 4 | 141021010013-R | U22 U40 U41 U72 | SN74LVC1G11DRYR | IC SINGLE 3-INPUT POSITIVE-AND GATE SON6 | TEXAS INSTRUMENTS | SN74LVC1G11DRYR | SON6_SN74LVC2G17_40X60_0-6
190 | 1 | 142021080018-R | U24 | TLV75510PDQNR | IC 500mA 1V LOW IQ LDO REGULATOR X2SON-4 | TEXAS INSTRUMENTS | TLV75510PDQNR | X2SON4_TLV71318P_40X40_0-4
191 | 1 | 141119090004-R | U26 | AT24C512C-MAHM-T | IC 1.7-3.6V 512Kb I2C COMPATIBLE SERIAL EEPROM UDFN8 | MICROCHIP | AT24C512C-MAHM-T | UDFN8_19-68_120X80_0-6
192 | 1 | 141122090001-R | U28 | MTFC32GAZAQHD-IT | IC 32GB e-MMC MEMORY VFBGA153 | MICRON | MTFC32GAZAQHD-IT | VFBGA153_19-68_460X520_0-9
193 | 1 | 141022110006-R | U29 | MT40A1G16TB-062E | IC 16Gb DDR4 SDRAM FBGA96 | MICRON | MT40A1G16TB-062E IT:F | FBGA96_31-49_300X520_1-2
194 | 1 | 142014060011-R | U34 | TPS2051BD | IC POWER DISTRIBUTION SWITCH SOIC8 | TEXAS INSTRUMENTS | TPS2051BD | SOIC8_1-8
195 | 0 | DNI | U36 | DNI | DNI | DNI | DNI | DNI
196 | 1 | 141017080026-R | U38 | TPIC2810D | IC 8-BIT LED DRIVER WITH I2C INTERFACE SOIC16 | TEXAS INSTRUMENTS | TPIC2810D | SOIC16_1-8
197 | 1 | 141117020010-R | U39 | W25Q80DVSNIG | IC SERIAL FLASH MEMORY SOIC8 | WINBOND | W25Q80DVSNIG-TR | SOIC8_1-8
198 | 3 | 141021110017-R | U42 U106 U107 | TCA9517DR | IC 2-CHANNEL BI-DIR LEVEL-SHIFTING I2C BUS REPEATER SOIC8 | TEXAS INSTRUMENTS | TCA9517DR | SOIC8_1-8
199 | 1 | 141217080002-R | U45 | TM4C1294NCPDTT3R | IC 32-BIT MICROCONTROLLER WITH 1MB FLASH TQFP128 | TEXAS INSTRUMENTS | TM4C1294NCPDTT3R | TQFP128_15-74_550X550_1-2
200 | 1 | 141013080006-R | U46 | FT4232HL | IC HIGH SPEED QUAD USB UART LQFP64 | FTDI | FT4232HL-REEL | LQFP64_19-68_390X390_1-6
201 | 1 | 142017080015-R | U47 | LM4040B25IDCKR | IC PRECISION MICROPOWER SHUNT VOLTAGE REFERENCE SC70-5 | TEXAS INSTRUMENTS | LM4040B25IDCKR | SC70-5_1-1
202 | 2 | 142020090007-R | U48 U62 | TPS22902YFPR | IC 3.6V 500mA 78mE ON-RESISTANCE LOAD SWITCH WITH CONTROLLED TURNON DSBGA4 | TEXAS INSTRUMENTS | TPS22902YFPR | DSBGA4_15-74_30X30_0-5
203 | 2 | 143017080002-R | U49 U51 | DP83867IRRGZ | IC HIGH IMMUNITY 10/100/1000 Mb/s ETHERNET PHY LAYER TRANSCEIVER VQFN48 | TEXAS INSTRUMENTS | DP83867IRRGZ | QFN48_19-68_280X280_1
204 | 1 | 141011080021-R | U50 | TPD12S016PWR | IC HDMI COMPANION CHIP WITH I2C LEVEL SHIFTING,12-CH ESD TSSOP24 | TEXAS INSTRUMENTS | TPD12S016PWR | TSSOP24_25-59_315X180_1-2
205 | 1 | 141020090002-R | U52 | LMK1C1103PWR | IC 3-CHANNEL LVCMOS CLOCK BUFFER TSSOP8 | TEXAS INSTRUMENTS | LMK1C1103PWR | TSSOP8_25-59_125X180_1-2
206 | 1 | 130020110041-R | U53 | 25.000MHz | OSC 25.000MHz CMOS SMD | ECS INC | ECS-2520MV-250-CN-TR | OSC4_ECS-2520MV_100X80_SMD_0-9
207 | 1 | 141017110007-R | U60 | TXB0104RUTR | IC 4-BIT BIDIRECTIONAL VOLTAGE-LEVEL TRANSLATOR UQFN12 | TEXAS INSTRUMENTS | TXB0104RUTR | UQFN12_TXB0104RUT_70X80_0-6
208 | 1 | 143010060003-R | U66 | TLV320AIC3106IRGZT | IC LOW-POWER STEREO AUDIO CODEC VQFN48 | TEXAS INSTRUMENTS | TLV320AIC3106IRGZT | VQFN48_19-68_285X285
209 | 1 | 142021020006-R | U67 | LM61460AANQRJRRQ1 | IC 6A ADJ AUTO LOW EMI SYNCHRONOUS STEP DOWN DC-DC CONVERTER VQFN-HR14 | TEXAS INSTRUMENTS | LM61460AANQRJRRQ1 | VQFNHR14_LM61460_160X140_1
210 | 1 | 142021070017-R | U68 | TPS65988DHRSHR | IC 2-PORT USB TYPE-C AND USB PD CONTROLLER WITH INTEGRATED POWER SWITCH VQFN56 | TEXAS INSTRUMENTS | TPS65988DHRSHR | VQFN56_TPS65987D_280X280_1
211 | 2 | 142021100001-R | U69 U78 | TVS2200DRVR | IC 22V FLAT-CLAMP SURGE PROTECTION DEVICE WSON6 | TEXAS INSTRUMENTS | TVS2200DRVR | SON6_25-59_85X85_0-8
212 | 2 | 141014090009-R | U70 U74 | TCA6424ARGJR | IC I2C I/O EXPANDER 24B UQFN32 | TEXAS INSTRUMENTS | TCA6424ARGJR | QFN32_19-68_200X200
213 | 2 | 143011040001-R | U73 U75 | SN74AVC8T245RHL | IC BUS TRANSCEIVER 8-BIT DUAL-SUPPLY QFN24 | TEXAS INSTRUMENTS | SN74AVC8T245RHLR | QFN24_19-68_220X140_1
214 | 1 | 142022010015-R | U76 | TPS630702RNMR | IC ADJ BUCK-BOOST CONVERTER WITH 3.6A SWITCH CURRENT VQFN-HR15 | TEXAS INSTRUMENTS | TPS630702RNMR | VQFNHR15_TPS630701_100X120_1
215 | 2 | 141020100010-R | U77 U99 | SN74LVC1G04DPWR | IC SINGLE INVERTER GATE X2SON5 | TEXAS INSTRUMENTS | SN74LVC1G04DPWR | X2SON5_TLV7021_30X30_0-4
216 | 1 | 142009080012-R | U79 | TPS79601DRBR | IC 1A HIGH PSRR RF ADJ LDO LINEAR REGULATOR SON8 | TEXAS INSTRUMENTS | TPS79601DRBR | SON8_25-59_130X130_1
217 | 2 | 141020100011-R | U81 U91 | SN74LVC1G32DPWR | IC SINGLE 2-INPUT POSITIVE-OR GATE X2SON5 | TEXAS INSTRUMENTS | SN74LVC1G32DPWR | X2SON5_TLV7021_30X30_0-4
218 | 1 | 141017090019-R | U82 | SN74LVC3G17DCUR | IC TRIPLE SCHMITT-TRIGGER BUFFER VSSOP8 | TEXAS INSTRUMENTS | SN74LVC3G17DCUR | VSSOP8_19-68_85X95_0-9
219 | 2 | 141016030002-R | U83 U96 | SN74AVC2T244DQMR | IC 2-BIT UNDIRECTIONAL VOLTAGE-LEVEL TRANSLATOR X2SON8 | TEXAS INSTRUMENTS | SN74AVC2T244DQMR | X2SON8_15-74_70X50
220 | 1 | 141118020002-R | U87 | 93LC46B | IC 1K MICROWIRE COMPATIBLE SERIAL EEPROM MSOP8 | MICROCHIP | 93LC46B-I/MS | MSOP8_25-59_125X125_1-1
221 | 1 | 141010020012-R | U89 | TPD4E004DRYR | IC 4-CH ESD PROTECTION ARRAY FOR HIGH SPEED DATA INTERFACE SON6 | TEXAS INSTRUMENTS | TPD4E004DRYR | SON6_19-68_40X60_PB_0-6
222 | 1 | 141020100009-R | U90 | SN74LVC1G08DPWR | IC SINGLE 2-INPUT POSITIVE-AND GATE X2SON5 | TEXAS INSTRUMENTS | SN74LVC1G08DPWR | X2SON5_TLV7021_30X30_0-4
223 | 1 | 142014100001-R | U95 | TPS73533DRVR | IC 500mA LOW DROPOUT REGULATOR SON6 | TEXAS INSTRUMENTS | TPS73533DRVR | SON6_25-59_85X85
224 | 1 | 141016030006-R | U100 | TCA9543APWR | IC 2-CHANNEL I2C BUS SWITCH WITH INTERRUPT LOGIC AND RESET TSSOP14 | TEXAS INSTRUMENTS | TCA9543APWR | TSSOP14_25-59_205X180_1-2
225 | 1 | 142014070020-R | U104 | TPS22965DSGT | IC 5.7V 6A 1-CHANNEL 16mE ON-RESISTANCE LOAD SWITCH WSON8 | TEXAS INSTRUMENTS | TPS22965DSGT | WSON8_19-68_80X80_0-8
226 | 1 | 141022040005-R | U108 | SN74LVC07ADGVR | IC HEX BUFFER AND DRIVER WITH OPEN DRAIN OUTPUT TVSOP14 | TEXAS INSTRUMENTS | SN74LVC07ADGVR | TVSOP14_15-74_180X150_1-2
227 | 1 | 141018100011-R | U110 | TCA6408ARGTR | IC 8-BIT I2C AND SMBUS I/O EXPANDER WITH INTERRUPT O/P VQFN16 | TEXAS INSTRUMENTS | TCA6408ARGTR | QFN16_19-68_120X120_1_EP1-6
228 | 1 | 140122110004-R | U111 | SN74LVC1G3157DBVR | IC SPDT ANALOG SWITCH SOT23-6 | TEXAS INSTRUMENTS | SN74LVC1G3157DBVR | SOT23-6_1-5
229 | 1 | 140124060002-R | U112 | TXU0101DBVR | IC DUAL-BIT FIXED DIRECTION VOLTAGE-LEVEL TRANSLATOR WITH SCHMITT-TRIGGER INPUTS AND 3-STATE OUTPUTS SOT23-6 | TEXAS INSTRUMENTS | TXU0101DBVR | SOT23-6_1-5
230 | 1 | 142022090041-R | U113 | TLV75801PDBVT | IC 500mA ADJ LDO REGULATOR SOT23-5 | TEXAS INSTRUMENTS | TLV75801PDBVT | SOT23-5_1-5
231 | 1 | 141011080022-R | U114 | TPD4S012DRYR | IC 4CH ESD SOLUTION FOR USB-HS/USB OTG/USB CHARGER INTERFACE SON6 | TEXAS INSTRUMENTS | TPD4S012DRYR | SON6_SN74LVC2G17_40X60_0-6
232 | 1 | 130019040003-R | Y1 | 32.768KHz | CRY 32.768KHz 9pF SMD | ECS INC | ECS-.327-9-34QCS-TR | XTAL_ECS-32_130X60_SMD_0-9
233 | 1 | 130020100044-R | Y2 | 16.000MHz | CRY 16.000MHz 8pF SMD | MURATA | XRCGB16M000FXN01R0 | XTAL4_XRCGB-FM_80X60_SMD_0-7
234 | 1 | 130021100037-R | Y3 | 12.000MHz | CRY 12.000MHz 18pF SMD | ECS INC | ECS-120-18-30B-AGN-TR | XTAL4_ECX-53BQ_200X130_SMD_0-9
235 | 0 | DNI | Y4 | DNI | DNI | DNI | DNI | DNI

Sheet: PROC142B(002)_All_Parts_BOM
Item Number | Quantity | Mistral Part No | Part Reference | Value | Description | Mfr_name | Mfr_part_number | PCB Footprint
1 | 1 | 160019020049-R | ACC1 | 9774015243R | STANDOFF BOARD TO BOARD 1.50MM LENGTH FEMALE M2 THREADED SS | WURTH ELECTRONICS | 9774015243R | NA
2 | 44 | 120018010007-R | C1 C24 C26 C30 C38 C61 C67 C84 C90 C113 C176 C181 C186 C189 C191 C220 C270 C281 C287 C288 C289 C290 C296 C329 C334 C336 C337 C339 C340 C343 C344 C346 C347 C350 C354 C358 C359 C401 C409 C422 C442 C451 C473 C490 | 0.01uF | CAP CERAMIC 0.01uF 25V 10% X5R 0201 | MURATA | GRM033R61E103KA12J | CAP0201_0-5
3 | 27 | 120013110019-R | C3 C9 C33 C39 C43 C69 C77 C142 C144 C146 C199 C201 C204 C211 C219 C230 C242 C248 C311 C313 C319 C384 C393 C406 C410 C483 C508 | 10uF | CAP CERAMIC 10uF 10V 20% X5R 0402 | MURATA | GRM155R61A106ME11D | CAP0402_0-75
4 | 183 | 120009030072-R | C4 C5 C6 C7 C8 C10 C11 C12 C20 C22 C25 C27 C29 C31 C32 C34 C36 C40 C42 C44 C55 C56 C63 C68 C70 C73 C76 C80 C82 C83 C85 C89 C93 C102 C129 C134 C137 C140 C145 C148 C156 C157 C159 C161 C162 C166 C167 C169 C170 C173 C184 C190 C194 C200 C207 C208 C209 C212 C213 C216 C217 C218 C221 C223 C225 C229 C231 C235 C238 C240 C241 C243 C245 C247 C250 C252 C253 C254 C255 C259 C260 C261 C262 C263 C264 C265 C266 C267 C268 C271 C272 C273 C274 C275 C277 C278 C279 C280 C282 C283 C284 C286 C291 C292 C295 C298 C300 C301 C304 C309 C310 C315 C318 C321 C325 C326 C328 C352 C361 C362 C363 C375 C381 C385 C386 C388 C394 C404 C405 C411 C429 C430 C431 C435 C437 C439 C440 C445 C446 C449 C450 C452 C453 C456 C457 C458 C462 C463 C464 C466 C467 C468 C469 C470 C472 C474 C475 C477 C478 C481 C484 C485 C487 C488 C489 C492 C493 C495 C496 C497 C499 C507 C510 C511 C512 C513 C514 C515 C516 C521 C522 C525 C539 | 0.1uF | CAP CERAMIC 0.1uF 16V 10% X5R 0201 | MURATA | GRM033R61C104KE14D | CAP0201_0-5
5 | 10 | 120015120001-R | C13 C65 C179 C197 C338 C341 C351 C379 C455 C482 | 2.2uF | CAP CERAMIC 2.2uF 25V 10% X5R 0402 | MURATA | GRM155R61E225KE11D | CAP0402_0-75
6 | 8 | 120018050004-R | C14 C46 C47 C193 C391 C538 C540 C541 | 1uF | CAP CERAMIC 1uF 25V 10% X6S 0402 | MURATA | GRM155C81E105KE11D | CAP0402_0-75
7 | 69 | 120011100014-R | C15 C18 C23 C45 C53 C59 C60 C64 C66 C72 C74 C94 C96 C97 C99 C101 C103 C106 C114 C116 C118 C119 C121 C139 C147 C153 C164 C177 C182 C183 C187 C188 C196 C202 C203 C205 C206 C210 C323 C331 C332 C333 C335 C365 C377 C380 C397 C399 C408 C413 C421 C426 C460 C461 C471 C476 C479 C480 C498 C509 C520 C528 C529 C531 C532 C533 C543 C544 C545 | 0.1uF | CAP CERAMIC 0.1uF 50V 10% X7R 0402 | MURATA | GRM155R71H104KE14D | CAP0402_0-75
8 | 41 | 120018090038-R | C19 C21 C28 C35 C37 C58 C62 C71 C78 C81 C88 C92 C95 C100 C178 C192 C215 C222 C224 C227 C228 C236 C237 C244 C246 C249 C285 C299 C306 C307 C308 C316 C317 C324 C330 C376 C407 C443 C454 C506 C527 | 1uF | CAP CERAMIC 1uF 16V 20% X5R 0201 | MURATA | GRM033R61C105ME15D | CAP0201_0-5
9 | 20 | 120012060002-R | C41 C48 C49 C50 C87 C104 C110 C138 C143 C180 C198 C214 C226 C233 C293 C297 C314 C320 C423 C465 | 4.7uF | CAP CERAMIC 4.7uF 10V 20% X5R 0402 | MURATA | GRM155R61A475MEAAD | CAP0402_0-75
10 | 2 | 120009050017-R | C51 C548 | 0.1uF | CAP CERAMIC 0.1uF 10V 10% X5R 0201 | SAMSUNG | CL03A104KP3NNNC | CAP0201_0-5
11 | 3 | 120014100011-R | C52 C112 C122 | 47uF | CAP CERAMIC 47uF 10V 20% X5R 0805 | MURATA | GRM21BR61A476ME15L | CAP0805_1-5
12 | 4 | 120015030003-R | C54 C57 C546 C547 | 1uF | CAP CERAMIC 1uF 10V 20% X5R 0201 | SAMSUNG | CL03A105MP3NSNC | CAP0201_0-5
13 | 4 | 120014100019-R | C75 C79 C174 C175 | 18pF | CAP CERAMIC 18pF 50V 5% HI-Q C0G(NP0) 0402 | MURATA | GJM1555C1H180JB01D | CAP0402_0-75
14 | 9 | 120018090044-R | C86 C98 C107 C108 C117 C357 C494 C502 C503 | 2.2uF | CAP CERAMIC 2.2uF 10V 10% X5R 0201 | MURATA | GRM033R61A225KE47D | CAP0201_0-5
15 | 4 | 120022060019-R | C115 C355 C387 C549 | 0.1uF | CAP CERAMIC 0.1uF 16V 10% X5R 0201 | MURATA | GRT033R61C104KE01 | CAP0201_0-5
16 | 5 | 120021100001-R | C135 C136 C151 C152 C526 | 220pF | CAP CERAMIC 220pF 100V 5% C0G(NP0) 0402 | MURATA | GRM1555C2A221JE01D | CAP0402_0-75
17 | 8 | 120019050016-R | C141 C150 C155 C400 C414 C424 C432 C433 | 10uF | CAP CERAMIC 10uF 35V 20% X5R 0603 | MURATA | GRM188R6YA106MA73D | CAP0603_1
18 | 2 | 120021030002-R | C149 C425 | 10uF | CAP CERAMIC 10uF 50V 10% X5R 0805 | MURATA | GRM21BR61H106KE43L | CAP0805_1-5
19 | 3 | 120021070001-R | C154 C395 C419 | 47uF | CAP CERAMIC 47uF 16V 10% X6S 1210 | MURATA | GRM32EC81C476KE15L | CAP1210_2-75
20 | 3 | 120013120018-R | C158 C160 C420 | 22uF | CAP CERAMIC 22uF 25V 20% X5R 0805 | MURATA | GRM21BR61E226ME44K | CAP0805_1-5
21 | 2 | 120009030213-R | C171 C172 | 12pF | CAP CERAMIC 12pF 25V 5% C0G(NP0) 0201 | MURATA | GRM0335C1E120JA01D | CAP0201_0-5
22 | 6 | 120015080006-R | C185 C195 C327 C372 C392 C427 | 1000pF | CAP CERAMIC 1000pF 2KV 10% X7R 1206 | AVX CORPORATION | 1206GC102KAT1A | CAP1206_1-75
23 | 1 | 120016010019-R | C232 | 4.7uF | CAP CERAMIC 4.7uF 6.3V 10% X5R AUTO 0603 | MURATA | GRT188R60J475KE01D | CAP0603_1
24 | 3 | 120021070019-R | C234 C312 C519 | 22pF | CAP CERAMIC 22pF 25V 1% C0G(NP0) 0201 | MURATA | GRM0335C1E220FA01D | CAP0201_0-5
25 | 9 | 120019050005-R | C239 C251 C256 C257 C258 C269 C276 C294 C302 | 1uF | CAP CERAMIC 1uF 10V 10% X5R 0201 | SAMSUNG | CL03A105KP3NSNC | CAP0201_0-5
26 | 2 | 120017030004-R | C303 C305 | 13pF | CAP CERAMIC 13pF 50V 5% C0G(NP0) 0402 | MURATA | GRM1555C1H130JA01D | CAP0402_0-75
27 | 1 | 120014100009-R | C349 | 22uF | CAP CERAMIC 22uF 10V 20% X5R 0603 | MURATA | GRM188R61A226ME15D | CAP0603_1
28 | 1 | 120022060023-R | C356 | 10uF | CAP CERAMIC 10uF 25V 20% X5R AUTO 0603 | MURATA | GRT188R61E106ME13 | CAP0603_1
29 | 1 | 120021090007-R | C371 | 150uF_10V | CAP TANTALUM 150uF 10V 10% ESR 600mE D7343 | VISHAY | 293D157X9010D2TE3 | CAPT7343D_3-25
30 | 3 | 120013030002-R | C396 C398 C418 | 1uF | CAP CERAMIC 1uF 100V 10% X7S 0805 | MURATA | GRM21BC72A105KE01L | CAP0805_1-5
31 | 1 | 120021100002-R | C402 | 36pF | CAP CERAMIC 36pF 50V 2% HI-Q C0G(NP0) 0402 | MURATA | GJM1555C1H360GB01D | CAP0402_0-75
32 | 1 | 120021060019-R | C412 | 0.47uF | CAP CERAMIC 0.47uF 10V 10% X7R 0402 | MURATA | GRM155R71A474KE01D | CAP0402_0-75
33 | 1 | 120011070010-R | C415 | 4.7uF | CAP CERAMIC 4.7uF 50V 10% X5R 0805 | TDK CORPORATION | C2012X5R1H475K | CAP0805_1-5
34 | 4 | 120013120015-R | C416 C417 C517 C518 | 47uF | CAP CERAMIC 47uF 10V 20% X5R 1206 | MURATA | GRM31CR61A476ME15L | CAP1206_2
35 | 1 | 120016120011-R | C441 | 15pF | CAP CERAMIC 15pF 25V 2% HI-Q C0G(NP0) 0201 | MURATA | GJM0335C1E150GB01D | CAP0201_0-5
36 | 1 | 120020100018-R | C459 | 8.2pF | CAP CERAMIC 8.2pF 25V 0.5pF C0G(NP0) 0201 | MURATA | GRM0335C1E8R2DA01D | CAP0201_0-5
37 | 5 | 120021120018-R | C491 C534 C535 C536 C537 | 47pF | CAP CERAMIC 47pF 50V 5% C0G(NP0) AUTO 0201 | MURATA | GRT0335C1H470JA02D | CAP0201_0-5
38 | 1 | 120014100023-R | C542 | 22pF | CAP CERAMIC 22pF 50V 5% C0G(NP0) 0402 | MURATA | GRM1555C1H220JA01D | CAP0402_0-75
39 | 2 | 130017100002-R | D1 D14 | BZX84C6V8LT1G | DIODE ZENER 250mW 6.8V SOT23-123 | ON SEMICONDUCTOR | BZX84C6V8LT1G | SOT23-123_1-2
40 | 4 | 130020090037-R | D2 D4 D9 D10 | TPD1E01B04DPLT | DIODE 1CH ESD PROTECTION FOR USB TYPE-C AND THUNDERBOLT3 X2SON2 | TEXAS INSTRUMENTS | TPD1E01B04DPLT | DIO_DFN0201_0-4
41 | 1 | 130017080015-R | D5 | ESD122DMXR | DIODE 2-CH ESD PROTECTION FOR USB TYPE-C AND HDMI 2.0 X2SON-3 | TEXAS INSTRUMENTS | ESD122DMXR | X2SON3_ESD122DMX_30X40_0-4
42 | 7 | 130014110022-R | D7 D8 D12 D13 D15 D16 D17 | TPD1E10B06DPYR | DIODE 1CH ESD PROTECTION X1SON2 | TEXAS INSTRUMENTS | TPD1E10B06DPYR | DIO_DFN0402_0-5
43 | 3 | 130014060028-R | FB1 FB2 FB3 | 300E | IND FERRITE CHIP 300E 500mA 0603 | TDK CORPORATION | MMZ1608R301A | IND0603
44 | 1 |  | FID1 | FID_40X80 |  |  |  | FID_40X80
45 | 1 |  | FID2 | FID_40X80 |  |  |  | FID_40X80
46 | 1 |  | FID3 | FID_40X80 |  |  |  | FID_40X80
47 | 1 |  | FID4 | FID_40X80 |  |  |  | FID_40X80
48 | 1 |  | FID5 | FID_40X80 |  |  |  | FID_40X80
49 | 1 |  | FID6 | FID_40X80 |  |  |  | FID_40X80
50 | 20 | 130013060022-R | FL3 FL5 FL6 FL8 FL9 FL10 FL12 FL13 FL14 FL15 FL16 FL17 FL18 FL19 FL20 FL21 FL22 FL23 FL25 FL26 | 120E | IND FERRITE BEAD CHIP 120E 2A 0402 | MURATA | BLM15PX121SN1D | EMIFIL_BLM15A_0402_0-6
51 | 2 | 130013100028-R | FL4 FL7 | 26E | FERRITE CHIP 26E 6A 0603 | MURATA | BLM18SG260TN1D | EMIFIL_BLM18K_0603_0-7
52 | 1 | 150021030016-R | J2 | CON_MINIPCIE_75_F | CON MINIPCI 75POS 0.50MM PITCH FEMALE RT SMD | TE CONNECTIVITY | 2199119-4_2230 | CON_MINIPCI75_2199119-4_S_R_S_3-2_2230
53 | 1 | 150020100013-R | J3 | HDR_2X20 | CON HDR 2X20 2.54MM PITCH ST TH | SULLINS CONNECTOR | PEC20DAAN | HDR_2X20_PEC20DAAN_S_T_8-6
54 | 2 | 150014060029-R | J4 J6 | CON_RJ45-14_LPJG16314A4NL | CON RJ-45 FEMALE 14POS RT TH | LINK-PP | LPJG16314A4NL | CON_RJ45-14_LPJG16314A4NL_S_R_T_13-6
55 | 1 | 150010050001-R | J5 | CON_HDMI_1X19_F | CON HDMI-A TYPE 1X19 0.50MM PITCH FEMALE RT SMD | FCI | 10029449-001RLF | CON_19X1_10029449-001RLF_S_R_S_6-3
56 | 1 | 150017100042-R | J7 | CON_USB-A_4_F | CON USB-A TYPE 4POS FEMALE RT SMD | WURTH ELECTRONICS | 629104151021 | CON_USBA4_629104151_S_R_S_7-4
57 | 5 | 150012100005-R | J8 J14 J24 J25 J26 | HDR_1X2 | CON HDR 1X2 2.54MM PITCH ST TH | MOLEX | 90120-0122 | HDR_1X2_90120-0122_S_T_5-6
58 | 1 | 150014110005-R | J9 | HDR_2X14 | CON HDR 2X14 2.54MM PITCH ST TH | SULLINS | PREC014DAAN-RC | HDR_14X2_100_S_T
59 | 1 | 150021070022-R | J10 | HDR_2X10 | CON HDR 2X10 2.54MM PITCH ST TH | SULLINS CONNECTOR | PREC010DAAN-RC | HDR_2X10_PREC010DAAN_S_T_8-4
60 | 2 | 150018060002-R | J11 J13 | CON_USB-C_24_F | CON USB-C TYPE 24POS FEMALE RT SMD | MOLEX | 2012670005 | CON_USBC24_2012670_S_R_S_3-9
61 | 1 | 150010060028-R | J12 | CON_AUDIOJACK4_SJ-43514-SMT | CON AUDIO JACK 4POS FEMALE RT SMD | CUI INC | SJ-43514-SMT-TR | CON_AV4_SJ-43514-SMT_S_R_S_5-1
62 | 2 | 150019050015-R | J15 J16 | CON_MUSB-B_5_F | CON MICRO USB TYPE B 5POS FEMALE RT SMD | WURTH ELECTRONICS | 629105150521 | CON_MUSBB5_629105150521_S_R_S_2-7
63 | 1 | 150011090001-R | J17 | HDR_2X10 | CON HDR 2X10 1.27MM PITCH ST SMD | SAMTEC | FTR-110-51-S-D-06 | HDR_2X10_FTR-110-51-D-06_S_S_8-7
64 | 1 | 150020060004-R | J19 | CON_FLEX_1X15_1-1734248-5 | CON FPC 1X15 1.00MM PITCH FEMALE ST SMD | TE CONNECTIVITY | 1-1734248-5 | CON_FLEX1X15_1-1734248-5_S_S_S_7-7
65 | 1 | 150021090028-R | J20 | CON_SDCARD9_MEM2051-00-195-00-A | CON MICROSD CARD 9POS FEMALE RT SMD | GCT | MEM2051-00-195-00-A | CON_SD9_MEM2051-00-195-00_S_R_S_2-1
66 | 1 | 150021100004-R | J21 | CON_FLEX_1X40_FFC2A32 | CON FPC 1X40 0.50MM PITCH FEMALE ST SMD | GCT | FFC2A32-40-T | CON_FLEX1X40_FFC2A32-40-T_S_S_S_4-3
67 | 1 | 150021080010-R | J22 | HDR_2X5 | CON HDR 2X5 2.54MM PITCH ST TH | SULLINS CONNECTOR | PEC05DAAN | HDR_2X5_PEC05DAAN_S_T_8-6
68 | 1 | 150009030176-R | J23 | CON_FLEX_40X1_FH12A-40S-0.5SH | CON FPC 40X1 0.50MM PITCH RT TOP SMD | HIROSE ELECTRIC EUROPE | FH12A-40S-0.5SH(55) | CON_FLEX40X1_FH12A_S_R_S
69 | 3 | 130020100030-R | L5 L7 L8 | 0.47uH | IND CHIP 0.47uH 4.5A 20% 0806 | MURATA | DFE201612E-R47M=P2 | IND0806_1-2
70 | 2 | 130019060035-R | L9 L10 | 90E | IND COMMON MODE CHOKE 90E 280mA SMD | MURATA | DLW21SZ900HQ2B | IND4_DLW21H_90X60_SMD_1-4
71 | 1 | 130015090013-R | L12 | 4.7uH | IND POWER 4.7uH 11A 20% SMD | COILCRAFT | XAL6060-472MEB | IND_XAL6060_260X270_SMD_6-1
72 | 1 | 130019100011-R | L13 | 1.5uH | IND POWER 1.5uH 9.1A 20% SMD | COIL CRAFT | XFL4020-152MEB | IND_XFL4020_170X170_SMD_2-1
73 | 3 | 160018020185 | LBL1 LBL2 LBL3 | THT-103-423-10 | ACCESSORIE 1 WORKHORSE POLYSTER LABLE 0.25" X 1" | BRADY | THT-103-423-10 | NA
74 | 8 | 130020080012-R | LD1 LD10 LD11 LD12 LD13 LD14 LD16 LD17 | 150080VS75000 | DIODE LED BRIGHT GREEN SMD | WURTH ELECTRONICS | 150080VS75000 | LED_150080VS75000_80X50_SMD_0-8
75 | 4 | 130020110071-R | LD2 LD4 LD7 LD9 | 150040VS73220 | DIODE LED BRIGHT GREEN SMD | WURTH ELECTRONIK | 150040VS73220 | LED_150040GS73220_40X20_SMD_0-4
76 | 3 | 130020090020-R | LD3 LD8 LD15 | 150040RS73220 | DIODE LED RED SMD | WURTH ELECTRONICS | 150040RS73220 | LED_150040GS73220_40X20_SMD_0-4
77 | 2 | 130020090022-R | LD5 LD6 | 150040AS73220 | DIODE LED AMBER SMD | WURTH ELECTRONICS | 150040AS73220 | LED_150040GS73220_40X20_SMD_0-4
78 | 1 |  | LOGO1 | Texas Intruments
79 | 1 |  | LOGO2 | For Evaluation only; not FCC approved for resale |  |  |  | FCC_disclaimer
80 | 1 |  | LOGO3 | WEEE Mark
81 | 1 |  | LOGO4 | CE Mark |  |  |  | TI_Stacked_Overlay_Small
82 | 1 | 160019030017-R | MH1 | FLAT WASHER_M2 | FLAT WASHER FOR M2 NYLON | KEYSTONE | 3356 | NA
83 | 1 | 160019030026-R | MH2 | PAN HEAD_M2 X 5 | PHILLIPS PAN HEAD SCREW - M2 X 5 | B AND F FASTENER | MPMS 002 0005 PH | NA
84 | 1 | FY201506000101 | PCB1 | PROC142B | AM62x SKEVM Bare PCB |  | PROC142B
85 | 10 | 142020120008-R | Q1 Q3 Q4 Q5 Q6 Q7 Q8 Q9 Q13 Q20 | CSD16301Q2 | IC MOSFET N-CHANNEL NEXFET 25V WSON6 | TEXAS INSTRUMENTS | CSD16301Q2 | WSON6_CSD13202Q2_80X80_0-8
86 | 3 | 130009031213-P | Q2 Q17 Q18 | IRLML6401 | TRANSISTOR MOSFET P-CHANNEL SOT23-3 | IRF | IRLML6401TRPBF | TO_SOT23-123
87 | 2 | 142015120011-R | Q14 Q16 | CSD25310Q2 | IC MOSFET P-CHANNEL WSON6 | TEXAS INSTRUMENTS | CSD25310Q2 | SON6_CSD17313Q2_80X80
88 | 72 | 110010070067-R | R1 R2 R3 R4 R7 R11 R15 R23 R32 R39 R52 R55 R57 R60 R62 R66 R74 R83 R87 R89 R105 R116 R157 R158 R163 R164 R221 R224 R225 R226 R229 R230 R231 R232 R287 R301 R302 R314 R331 R353 R354 R385 R422 R437 R438 R439 R440 R441 R446 R460 R464 R468 R473 R477 R478 R480 R492 R540 R608 R625 R638 R639 R643 R654 R676 R677 R678 R695 R702 R721 R722 R791 | 0E | RES 0E 1/20W 5% 0201 | YAGEO AMERICA | RC0201JR-070RL | RES0201_0-5
89 | 1 | 110009030522-R | R5 | 22E_1% | RES 22E 1/20W 1% 0201 | PANASONIC-ECG | ERJ-1GEF22R0C | RES0201_0-5
90 | 165 | 110010070051-R | R6 R12 R16 R17 R25 R26 R27 R28 R35 R58 R63 R77 R94 R104 R107 R111 R112 R114 R117 R118 R140 R160 R162 R165 R169 R172 R173 R176 R177 R179 R180 R181 R184 R185 R187 R190 R191 R192 R193 R195 R196 R197 R199 R200 R218 R220 R252 R253 R254 R285 R296 R297 R300 R313 R315 R317 R322 R325 R329 R333 R351 R362 R373 R374 R380 R381 R388 R389 R390 R393 R394 R398 R402 R420 R427 R431 R432 R433 R450 R451 R452 R457 R459 R469 R472 R474 R475 R481 R486 R487 R488 R489 R495 R502 R514 R517 R521 R522 R526 R531 R537 R538 R539 R541 R542 R543 R546 R554 R555 R558 R559 R562 R564 R566 R567 R568 R572 R574 R575 R576 R577 R578 R579 R584 R585 R586 R587 R601 R602 R605 R606 R607 R609 R650 R655 R657 R658 R659 R660 R661 R662 R663 R664 R665 R685 R688 R691 R696 R700 R703 R712 R713 R714 R715 R717 R719 R765 R766 R767 R768 R769 R770 R778 R789 R790 | 10K | RES 10K 1/20W 5% 0201 | YAGEO AMERICA | RC0201JR-0710KL | RES0201_0-5
91 | 21 | 110009030882-R | R10 R18 R19 R20 R21 R22 R80 R81 R82 R90 R91 R92 R364 R365 R366 R367 R376 R377 R378 R379 R396 | 47K | RES 47K 1/10W 5% 0402 | PANASONIC-ECG | ERJ-2GEJ473X | RES0402_0-5
92 | 38 | 110021090007-R | R13 R30 R31 R61 R71 R73 R201 R262 R264 R265 R270 R391 R392 R403 R404 R490 R491 R498 R499 R550 R561 R573 R581 R592 R599 R600 R611 R666 R667 R684 R686 R687 R689 R690 R782 R783 R787 R788 | 4.7K | RES 4.7K 1/20W 5% 0201 | YAGEO AMERICA | RC0201JR-074K7L | RES0201_0-5
93 | 23 | 110011060021-R | R14 R41 R96 R120 R266 R272 R273 R274 R304 R326 R370 R425 R426 R445 R470 R509 R533 R671 R704 R764 R784 R785 R786 | 10K | RES 10K 1/16W 5% 0402 | VISHAY | CRCW040210K0JNED | RES0402_0-5
94 | 3 | 110010070052-R | R24 R535 R603 | 33E | RES 33E 1/20W 5% 0201 | PANASONIC-ECG | ERJ-1GEJ330C | RES0201_0-5
95 | 6 | 110011020013-R | R29 R178 R219 R256 R339 R418 | 0E | RES 0E 1/10W 5% 0603 | PANASONIC-ECG | RC0603JR-070RL | RES0603_0-75
96 | 84 | 110010080019-R | R33 R34 R37 R53 R64 R72 R78 R79 R93 R95 R101 R102 R109 R110 R113 R115 R124 R125 R145 R146 R147 R149 R154 R155 R189 R194 R198 R222 R235 R280 R281 R282 R283 R284 R289 R290 R312 R321 R324 R335 R337 R338 R340 R355 R358 R359 R383 R387 R421 R466 R483 R485 R525 R544 R569 R570 R571 R580 R583 R589 R590 R591 R594 R595 R596 R597 R598 R615 R616 R673 R674 R726 R727 R729 R730 R731 R750 R751 R752 R753 R754 R755 R756 R775 | 0E | RES 0E 1/16W JUMPER 0402 | VISHAY | CRCW04020000Z0ED | RES0402_0-5
97 | 23 | 110016050020-R | R38 R47 R49 R54 R76 R84 R85 R86 R291 R292 R293 R294 R295 R299 R311 R344 R345 R346 R347 R348 R350 R356 R357 | 2.49K_1% | RES 2.49K 1/16W 1% 0402 | YAGEO AMERICA | RC0402FR-072K49L | RES0402_0-5
98 | 6 | 110018030003-R | R48 R70 R106 R123 R134 R148 | 0.01E_1% | RES 0.01E 1W 1% 1206-4 | SUSUMU | KRL3216T4A-M-R010-F-T1 | RES_KRL3216T4_1206-4_0-7
99 | 11 | 110022010018-R | R56 R320 R336 R343 R369 R372 R382 R384 R553 R565 R748 | 22E | RES 22E 1/16W 5% 0402 | YAGEO AMERICA | RC0402JR-0722RL | RES0402_0-5
100 | 14 | 110024040012-R | R65 R360 R732 R733 R734 R735 R736 R738 R739 R740 R741 R742 R745 R761 | 22E | RES 22E 1/20W 5% 0201 | YAGEO | RC0201JR-0722RL | RES0201_0-5
101 | 3 | 110020080006-R | R67 R68 R69 | 499E_1% | RES 499E 1/16W 1% 0402 | YAGEO AMERICA | RC0402FR-07499RL | RES0402_0-5
102 | 4 | 110009030859-R | R88 R188 R614 R617 | 470E | RES 470E 1/10W 5% 0402 | PANASONIC-ECG | ERJ-2GEJ471X | RES0402_0-5
103 | 2 | 110011060017-R | R98 R135 | 240E_1% | RES 240E 1/10W 1% 0402 | PANASONIC-ECG | ERJ-2RKF2400X | RES0402_0-5
104 | 1 | 110010120009-R | R108 | 1.1K_1% | RES 1.1K 1/16W 1% 0402 | VISHAY | CRCW04021K10FKED | RES0402_0-5
105 | 6 | 110009030427-R | R119 R330 R363 R442 R672 R681 | 2.2K | RES 2.2K 1/20W 5% 0201 | PANASONIC-ECG | ERJ-1GEJ222C | RES0201_0-5
106 | 1 | 110009030411-R | R121 | 1K_1% | RES 1K 1/10W 1% 0402 | PANASONIC-ECG | ERJ-2RKF1001X | RES0402_0-5
107 | 49 | 110009030400-R | R122 R182 R227 R236 R237 R238 R239 R240 R241 R242 R243 R244 R245 R246 R247 R248 R249 R250 R251 R255 R258 R259 R260 R267 R271 R305 R400 R461 R494 R501 R504 R506 R508 R511 R513 R516 R518 R527 R552 R556 R560 R563 R651 R656 R692 R693 R694 R716 R718 | 1K | RES 1K 1/10W 5% 0402 | PANASONIC-ECG | ERJ-2GEJ102X | RES0402_0-5
108 | 2 | 110023110006-R | R152 R649 | 3.48K_1% | RES 3.48K 1/20W 1% 0201 | PANASONIC-ECG | ERJ-1GNF3481C | RES0201_0-5
109 | 2 | 110020120011-R | R153 R648 | 16.5K_1% | RES 16.5K 1/16W 1% 0402 | YAGEO AMERICA | RC0402FR-0716K5L | RES0402_0-5
110 | 5 | 110011040018-R | R156 R328 R361 R386 R647 | 10K_1% | RES 10K 1/20W 1% 0201 | YAGEO AMERICA | RC0201FR-0710KL | RES0201_0-5
111 | 15 | 110009030506-R | R159 R161 R166 R167 R168 R170 R171 R175 R257 R286 R288 R334 R341 R342 R371 | 220E | RES 220E 1/10W 5% 0402 | PANASONIC-ECG | ERJ-2GEJ221X | RES0402_0-5
112 | 20 | 110011060002-R | R202 R203 R204 R205 R206 R207 R208 R209 R210 R211 R212 R213 R214 R215 R216 R217 R453 R465 R471 R497 | 100K | RES 100K 1/16W 5% 0402 | YAGEO AMERICA | RC0402JR-07100KL | RES0402_0-5
113 | 2 | 110018060032-R | R223 R515 | 10K_1% | RES 10K 1/20W 1% 0201 | VISHAY | CRCW020110K0FNED | RES0201_0-5
114 | 1 | 110009030846-R | R228 | 49.9E_1% | RES 49.9E 1/16W 1% 0402 | VISHAY | CRCW040249R9FKEDC | RES0402_0-5
115 | 1 | 110009030803-R | R261 | 4.87K_1% | RES 4.87K 1/16W 1% 0402 | PANASONIC-ECG | ERJ2RKF4871X | RES0402
116 | 2 | 110017080023-R | R268 R519 | 30K | RES 30K 1/16W 5% 0402 | VISHAY | CRCW040230K0JNED | RES0402_0-5
117 | 1 | 110009030486-R | R269 | 20K_1% | RES 20K 1/16W 1% 0402 | VISHAY | CRCW040220K0FKED | RES0402_0-5
118 | 2 | 110009030945-R | R298 R349 | 5.76K_1% | RES 5.76K 1/10W 1% 0402 | PANASONIC-ECG | ERJ-2RKF5761X | RES0402_0-5
119 | 8 | 110024080020-R | R303 R306 R307 R308 R309 R310 R318 R319 | 47K | RES 47K 1/20W 5% 0201 | PANASONIC-ECG | ERJ-1GNJ473C | RES0201_0-5
120 | 6 | 110010120018-R | R316 R323 R352 R479 R551 R680 | 2.2K | RES 2.2K 1/16W 5% 0402 | YAGEO AMERICA | RC0402JR-072K2L | RES0402_0-5
121 | 1 | 110009031092-R | R327 | 7.5K | RES 7.5K 1/16W 5% 0402 | VISHAY | CRCW04027K50JNED | RES0402_0-5
122 | 1 | 110015050015-R | R375 | 10K_1% | RES 10K 1/10W 1% 0402 | PANASONIC-ECG | ERJ-2RKF1002X | RES0402_0-5
123 | 2 | 110011040030-R | R395 R397 | 39.2E_1% | RES 39.2E 1/16W 1% 0402 | STACKPOLE ELECTRONICS | RMCF0402FT39R2 | RES0402_0-5
124 | 1 | 110009030902-R | R399 | 49.9K_1% | RES 49.9K 1/16W 1% 0402 | YAGEO AMERICA | RC0402FR-0749K9L | RES0402_0-5
125 | 2 | 110022080039-R | R407 R408 | 1K_1% | RES 1K 1/20W 1% 0201 | PANASONIC-ECG | ERJ-1GNF1001C | RES0201_0-5
126 | 1 | 110014060045-R | R449 | 1M_1% | RES 1M 1/16W 1% 0402 | YAGEO AMERICA | RC0402FR-071ML | RES0402_0-5
127 | 1 | 110020040003-R | R454 | 32.4K_1% | RES 32.4K 1/16W 1% 0402 | VISHAY | CRCW040232K4FKED | RES0402_0-5
128 | 2 | 110009030187-R | R455 R780 | 100K_1% | RES 100K 1/10W 1% 0402 | PANASONIC-ECG | ERJ-2RKF1003X | RES0402_0-5
129 | 1 | 110021080019-R | R467 | 43.2K_1% | RES 43.2K 1/16W 1% 0402 | VISHAY | CRCW040243K2FKED | RES0402_0-5
130 | 1 | 110009030176-R | R484 | 100K | RES 100K 1/20W 5% 0201 | PANASONIC-ECG | ERJ-1GEJ104C | RES0201_0-5
131 | 1 | 110009030966-R | R520 | 51K | RES 51K 1/16W 5% 0402 | VISHAY | CRCW040251K0JNED | RES0402_0-5
132 | 2 | 110014070015-R | R530 R557 | 100E_1% | RES 100E 1/16W 1% 0402 | YAGEO AMERICA | RC0402FR-07100RL | RES0402_0-5
133 | 4 | 110009030074-R | R582 R612 R699 R725 | 0E | RES 0E 1/8W 5% 0805 | YAGEO AMERICA | RC0805JR-070RL | RES0805_0-75
134 | 1 | 110019040053-R | R593 | 12K_1% | RES 12K 1/10W 1% 0402 | PANASONIC-ECG | ERJ-2RKF1202X | RES0402_0-5
135 | 5 | 110026030006-R | R613 R743 R744 R746 R747 | 62E | RES 62E 1/20W 1% 0201 | PANASONIC | ERJ-1GNF62R0C | RES0201_0-5
136 | 7 | 110010070051-R | R618 R620 R621 R624 R675 R679 R682 | 10K | RES 10K 1/20W 5% 0201 | PANASONIC-ECG | ERJ-1GEJ103C | RES0201_0-5
137 | 1 | 110011060012-R | R645 | 130K_1% | RES 130K 1/10W 1% 0402 | PANASONIC-ECG | ERJ-2RKF1303X | RES0402_0-5
138 | 1 | 110011040004-R | R646 | 680K_1% | RES 680K 1/10W 1% 0402 | PANASONIC-ECG | ERJ-2RKF6803X | RES0402_0-5
139 | 2 | 110009030149-R | R668 R669 | 1.8K | RES 1.8K 1/20W 1% 0201 | YAGEO AMERICA | ERJ-1GEF182C | RES0201_0-5
140 | 1 | 110010070001-R | R701 | 8.2K_1% | RES 8.2K 1/20W 1% 0201 | VISHAY | CRCW02018K20FKED | RES0201_0-5
141 | 4 | 110009030875-R | R757 R758 R759 R760 | 47E | RES 47E 1/20W 5% 0201 | PANASONIC-ECG | ERJ-1GEJ470C | RES0201_0-5
142 | 2 | 110025070048-R | R776 R777 | 3.9K | RES 3.9K 1/16W 5% 0402 | YAGEO AMERICA | RC0402JR-073K9L | RES0402_0-5
143 | 1 | 110018030052-R | R779 | 0E | RES 0E 1/10W JUMPER 0402 | PANASONIC-ECG | ERJ-2GE0R00X | RES0402_0-5
144 | 1 | 110022010016-R | R781 | 182K_1% | RES 182K 1/16W 1% 0402 | YAGEO AMERICA | RC0402FR-07182KL | RES0402_0-5
145 | 2 | 110015050003-R | RA1 RA2 | 1K | RES ARRAY 1K 31mW 5% 0201-4 | PANASONIC-ECG | EXB-18V102JX | RESA_EXB_0201-4_0-5
146 | 2 | 110018090033-R | RA3 RA4 | 0E | RES ARRAY 0E 31mW JUMPER 0201-4 | PANASONIC-ECG | EXB-18VR000X | RESA_EXB_0201-4_0-5
147 | 2 | 130020100001-R | SW1 SW2 | 416131160808 | SWITCH SLIDE SPST ST SMD | WURTH ELECTRONICS | 416131160808 | SW16_416131160808_460X230_SMD_2-7
148 | 2 | 130015110004-R | SW3 SW4 | 7914G-1-000E | SWITCH SPST-NO 4MM SQ SMD 7914G | BOURNS | 7914G-1-000E | SW4_100X216_200X200_SMD_4-2
149 | 1 | 130020100002-R | SW5 | 436331045822 | SWITCH TACTILE SPST RT SMD | WURTH ELECTRONICS | 436331045822 | SW4_436331045822_190X190_SMD_1-7
150 | 96 | NA | TP1 TP2 TP3 TP4 TP11 TP12 TP13 TP14 TP15 TP16 TP17 TP18 TP19 TP20 TP21 TP22 TP23 TP24 TP25 TP26 TP27 TP28 TP29 TP30 TP31 TP32 TP33 TP34 TP35 TP36 TP37 TP39 TP40 TP41 TP42 TP43 TP45 TP49 TP50 TP51 TP52 TP53 TP54 TP55 TP60 TP61 TP62 TP63 TP64 TP66 TP67 TP68 TP69 TP70 TP73 TP74 TP75 TP76 TP77 TP78 TP79 TP80 TP81 TP82 TP83 TP84 TP85 TP86 TP88 TP90 TP91 TP92 TP93 TP95 TP98 TP99 TP100 TP101 TP102 TP103 TP104 TP105 TP108 TP109 TP111 TP112 TP113 TP114 TP115 TP116 TP117 TP120 TP121 TP122 TP123 TP124 | TP20_SMD | TESTPOINT CIR 20 SMD | LOCAL | TP20_SMD | TP20_SMD
151 | 3 | 130009030938 | TP56 TP59 TP65 | THRU HOLE | TESTPOINT 1.0MM DRILL PTH | LOCAL | TP_40X65 | TP_40X65
152 | 6 | 130010010008 | TP57 TP58 TP71 TP72 TP96 TP97 | THRU HOLE | TESTPOINT 0.56MM DRILL PTH | LOCAL | TP_36X22 | TP_36X22
153 | 1 | 130009031113-R | U1 | 32.768KHz | OSC 32.768KHz 1.8V SMD | ABRACON | ASDK2-32.768KHZ-LRT | OSC4_ASDK_105X85_SMD
154 | 1 | 141009030362-R | U2 | TXS0104ERGYR | IC 4-BIT BIDIRECTIONAL VOLTAGE-LEVEL TRANSLATOR QFN14 | TEXAS INSTRUMENTS | TXS0104ERGYR | QFN14_19-68_145X145
155 | 7 | 141009110005-P | U3 U84 U85 U88 U92 U93 U97 | SN74AVC4T245DGVR | IC 4-BIT DUAL SUPPLY BUS TRANSCEIVER TVSOP16 | TEXAS INSTRUMENTS | SN74AVC4T245DGVR | TVSOP16_15-74_150X180
156 | 1 | 142021010016-R | U4 | TPS22946YZPR | IC CURRENT-LIMITED LOAD SWITCH WITH SHUTOFF AUTO-RESTART AND OVERCURRENT CONDITION TIME-OUT DSBGA6 | TEXAS INSTRUMENTS | TPS22946YZPR | DSBGA6_19-68_40X60_0-5
157 | 6 | 141009060026-R | U6 U43 U54 U58 U71 U105 | SN74LVC1G08DBVRE4 | IC SINGLE 2-INPUT POSITIVE AND GATE SOT23-5 | TEXAS INSTRUMENTS | SN74LVC1G08DBVRE4 | SOT23-5
158 | 2 | 130021100008-R | U7 U59 | 12.288MHz | OSC 12.288MHz CMOS SMD | KYOCERA | KC2520Z12.2880C1KX00 | OSC4_KC2520B_100X80_SMD_0-8
159 | 6 | 142021080022-R | U8 U16 U23 U25 U36 U37 | INA231AIYFDR | IC HIGH OR LOW SIDE MEASUREMENT BI-DIR CURRENT AND POWER MONITOR WITH 1.8V I2C INTERFACE DSBGA12 | TEXAS INSTRUMENTS | INA231AIYFDR | DSBGA12_15-74_60X70_0-4
160 | 1 | 141120010002 | U9 | S28HS512TGABHM010 | IC 1.8V 512Mb SEMPER FLASH WITH OCTAL INTERFACE BGA24 | CYPRESS SEMICONDUCTOR | S28HS512TGABHM010 | BGA24_39-37_240X310_1
161 | 1 | 141010060001 | U10 | SiI9022ACNU | IC HDMI TRANSMITTER QFN72 | SILICON IMAGE | SiI9022ACNU | QFN72_19-68_390X390_0-9
162 | 2 | 141017080030-R | U11 U33 | TMP100NA/3K | IC TEMPERATURE SENSOR WITH I2C AND SMBUS INTERFACE SOT23-6 | TEXAS INSTRUMENTS | TMP100NA/3K | SOT23-6_1-5
163 | 1 | 141221060001 | U12 | AM6254ATCGGAALW | IC AM62 SoC MICROPROCESSOR BGA425 | TEXAS INSTRUMENTS | AM6254ATCGGAALW | BGA425_19-68_510X510_0-7
164 | 1 | 142025070014-R | U13 | TPS22996HQDYCRQ1 | IC 5.5V 4A 13MO ON-RESISTANCE DUAL-CHANNEL AUTOMOTIVE LOAD SWITCH SOT583-8 | TEXAS INSTRUMENTS | TPS22996HQDYCRQ1 | SOT5X3-8_0-6
165 | 1 | 142022100015-R | U14 | TPS6521904RHBR | IC INTEGRATED POWER MANAGEMENT FOR ARM CORTEX-A53 PROCESSOR AND FPGA QFN32 | TEXAS INSTRUMENTS | TPS6521904RHBR | QFN32_19-68_200X200_1_EP3-8
166 | 1 | 141011080020-R | U15 | TPD6E001RSER | IC 6CH ESD-PROTECTION ARRAY UQFN10 | TEXAS INSTRUMENTS | TPD6E001RSER | UQFN10_19-68_80X60_0-6
167 | 3 | 141009030117-R | U17 U63 U65 | SN74CB3Q3257PWR | IC 4BIT 1-OF-2 FET MULTIPLEXER/DEMULTIPLEXER TSSOP16 | TEXAS INSTRUMENTS | SN74CB3Q3257PWR | TSSOP16_25-59_205X180
168 | 2 | 140110060007-R | U18 U44 | TPD2E001DRLR | IC ESD-PROTECTION DIODE ARRAYS SOT-5 | TEXAS INSTRUMENTS | TPD2E001DRLR | SOT553-5_0-6
169 | 4 | 141012050010-R | U20 U80 U86 U109 | TXS0102DQER | IC 2-BIT BI-DIR VOLTAGE-LEVEL TRANSLATOR FOR OPEN-DRAIN AND PUSH-PULL X2SON8 | TEXAS INSTRUMENTS | TXS0102DQER | X2SON8_TXS0102_40X60_0-4
170 | 1 | 142021010009-R | U21 | TLV75518PDBVR | IC 1.8V 500mA LOW IQ LDO REGULATOR SOT23-5 | TEXAS INSTRUMENTS | TLV75518PDBVR | SOT23-5_1-5
171 | 4 | 141021010013-R | U22 U40 U41 U72 | SN74LVC1G11DRYR | IC SINGLE 3-INPUT POSITIVE-AND GATE SON6 | TEXAS INSTRUMENTS | SN74LVC1G11DRYR | SON6_SN74LVC2G17_40X60_0-6
172 | 1 | 142021080018-R | U24 | TLV75510PDQNR | IC 500mA 1V LOW IQ LDO REGULATOR X2SON-4 | TEXAS INSTRUMENTS | TLV75510PDQNR | X2SON4_TLV71318P_40X40_0-4
173 | 1 | 141119090004-R | U26 | AT24C512C-MAHM-T | IC 1.7-3.6V 512Kb I2C COMPATIBLE SERIAL EEPROM UDFN8 | MICROCHIP | AT24C512C-MAHM-T | UDFN8_19-68_120X80_0-6
174 | 1 | 141122090001-R | U28 | MTFC32GAZAQHD-IT | IC 32GB e-MMC MEMORY VFBGA153 | MICRON | MTFC32GAZAQHD-IT | VFBGA153_19-68_460X520_0-9
175 | 1 | 141022110006-R | U29 | MT40A1G16TB-062E | IC 16Gb DDR4 SDRAM FBGA96 | MICRON | MT40A1G16TB-062E IT:F | FBGA96_31-49_300X520_1-2
176 | 1 | 142014060011-R | U34 | TPS2051BD | IC POWER DISTRIBUTION SWITCH SOIC8 | TEXAS INSTRUMENTS | TPS2051BD | SOIC8_1-8
177 | 1 | 141017080026-R | U38 | TPIC2810D | IC 8-BIT LED DRIVER WITH I2C INTERFACE SOIC16 | TEXAS INSTRUMENTS | TPIC2810D | SOIC16_1-8
178 | 1 | 141117020010-R | U39 | W25Q80DVSNIG | IC SERIAL FLASH MEMORY SOIC8 | WINBOND | W25Q80DVSNIG-TR | SOIC8_1-8
179 | 3 | 141021110017-R | U42 U106 U107 | TCA9517DR | IC 2-CHANNEL BI-DIR LEVEL-SHIFTING I2C BUS REPEATER SOIC8 | TEXAS INSTRUMENTS | TCA9517DR | SOIC8_1-8
180 | 1 | 141217080002-R | U45 | TM4C1294NCPDTT3R | IC 32-BIT MICROCONTROLLER WITH 1MB FLASH TQFP128 | TEXAS INSTRUMENTS | TM4C1294NCPDTT3R | TQFP128_15-74_550X550_1-2
181 | 1 | 141013080006-R | U46 | FT4232HL | IC HIGH SPEED QUAD USB UART LQFP64 | FTDI | FT4232HL-REEL | LQFP64_19-68_390X390_1-6
182 | 1 | 142017080015-R | U47 | LM4040B25IDCKR | IC PRECISION MICROPOWER SHUNT VOLTAGE REFERENCE SC70-5 | TEXAS INSTRUMENTS | LM4040B25IDCKR | SC70-5_1-1
183 | 2 | 142020090007-R | U48 U62 | TPS22902YFPR | IC 3.6V 500mA 78mE ON-RESISTANCE LOAD SWITCH WITH CONTROLLED TURNON DSBGA4 | TEXAS INSTRUMENTS | TPS22902YFPR | DSBGA4_15-74_30X30_0-5
184 | 2 | 143017080002-R | U49 U51 | DP83867IRRGZ | IC HIGH IMMUNITY 10/100/1000 Mb/s ETHERNET PHY LAYER TRANSCEIVER VQFN48 | TEXAS INSTRUMENTS | DP83867IRRGZ | QFN48_19-68_280X280_1
185 | 1 | 141011080021-R | U50 | TPD12S016PWR | IC HDMI COMPANION CHIP WITH I2C LEVEL SHIFTING,12-CH ESD TSSOP24 | TEXAS INSTRUMENTS | TPD12S016PWR | TSSOP24_25-59_315X180_1-2
186 | 1 | 141020090002-R | U52 | LMK1C1103PWR | IC 3-CHANNEL LVCMOS CLOCK BUFFER TSSOP8 | TEXAS INSTRUMENTS | LMK1C1103PWR | TSSOP8_25-59_125X180_1-2
187 | 1 | 130020110041-R | U53 | 25.000MHz | OSC 25.000MHz CMOS SMD | ECS INC | ECS-2520MV-250-CN-TR | OSC4_ECS-2520MV_100X80_SMD_0-9
188 | 1 | 141017110007-R | U60 | TXB0104RUTR | IC 4-BIT BIDIRECTIONAL VOLTAGE-LEVEL TRANSLATOR UQFN12 | TEXAS INSTRUMENTS | TXB0104RUTR | UQFN12_TXB0104RUT_70X80_0-6
189 | 1 | 143010060003-R | U66 | TLV320AIC3106IRGZT | IC LOW-POWER STEREO AUDIO CODEC VQFN48 | TEXAS INSTRUMENTS | TLV320AIC3106IRGZT | VQFN48_19-68_285X285
190 | 1 | 142021020006-R | U67 | LM61460AANQRJRRQ1 | IC 6A ADJ AUTO LOW EMI SYNCHRONOUS STEP DOWN DC-DC CONVERTER VQFN-HR14 | TEXAS INSTRUMENTS | LM61460AANQRJRRQ1 | VQFNHR14_LM61460_160X140_1
191 | 1 | 142021070017-R | U68 | TPS65988DHRSHR | IC 2-PORT USB TYPE-C AND USB PD CONTROLLER WITH INTEGRATED POWER SWITCH VQFN56 | TEXAS INSTRUMENTS | TPS65988DHRSHR | VQFN56_TPS65987D_280X280_1
192 | 2 | 142021100001-R | U69 U78 | TVS2200DRVR | IC 22V FLAT-CLAMP SURGE PROTECTION DEVICE WSON6 | TEXAS INSTRUMENTS | TVS2200DRVR | SON6_25-59_85X85_0-8
193 | 2 | 141014090009-R | U70 U74 | TCA6424ARGJR | IC I2C I/O EXPANDER 24B UQFN32 | TEXAS INSTRUMENTS | TCA6424ARGJR | QFN32_19-68_200X200
194 | 2 | 143011040001-R | U73 U75 | SN74AVC8T245RHL | IC BUS TRANSCEIVER 8-BIT DUAL-SUPPLY QFN24 | TEXAS INSTRUMENTS | SN74AVC8T245RHLR | QFN24_19-68_220X140_1
195 | 1 | 142022010015-R | U76 | TPS630702RNMR | IC ADJ BUCK-BOOST CONVERTER WITH 3.6A SWITCH CURRENT VQFN-HR15 | TEXAS INSTRUMENTS | TPS630702RNMR | VQFNHR15_TPS630701_100X120_1
196 | 2 | 141020100010-R | U77 U99 | SN74LVC1G04DPWR | IC SINGLE INVERTER GATE X2SON5 | TEXAS INSTRUMENTS | SN74LVC1G04DPWR | X2SON5_TLV7021_30X30_0-4
197 | 1 | 142009080012-R | U79 | TPS79601DRBR | IC 1A HIGH PSRR RF ADJ LDO LINEAR REGULATOR SON8 | TEXAS INSTRUMENTS | TPS79601DRBR | SON8_25-59_130X130_1
198 | 2 | 141020100011-R | U81 U91 | SN74LVC1G32DPWR | IC SINGLE 2-INPUT POSITIVE-OR GATE X2SON5 | TEXAS INSTRUMENTS | SN74LVC1G32DPWR | X2SON5_TLV7021_30X30_0-4
199 | 1 | 141017090019-R | U82 | SN74LVC3G17DCUR | IC TRIPLE SCHMITT-TRIGGER BUFFER VSSOP8 | TEXAS INSTRUMENTS | SN74LVC3G17DCUR | VSSOP8_19-68_85X95_0-9
200 | 2 | 141016030002-R | U83 U96 | SN74AVC2T244DQMR | IC 2-BIT UNDIRECTIONAL VOLTAGE-LEVEL TRANSLATOR X2SON8 | TEXAS INSTRUMENTS | SN74AVC2T244DQMR | X2SON8_15-74_70X50
201 | 1 | 141118020002-R | U87 | 93LC46B | IC 1K MICROWIRE COMPATIBLE SERIAL EEPROM MSOP8 | MICROCHIP | 93LC46B-I/MS | MSOP8_25-59_125X125_1-1
202 | 1 | 141010020012-R | U89 | TPD4E004DRYR | IC 4-CH ESD PROTECTION ARRAY FOR HIGH SPEED DATA INTERFACE SON6 | TEXAS INSTRUMENTS | TPD4E004DRYR | SON6_19-68_40X60_PB_0-6
203 | 1 | 141020100009-R | U90 | SN74LVC1G08DPWR | IC SINGLE 2-INPUT POSITIVE-AND GATE X2SON5 | TEXAS INSTRUMENTS | SN74LVC1G08DPWR | X2SON5_TLV7021_30X30_0-4
204 | 1 | 142014100001-R | U95 | TPS73533DRVR | IC 500mA LOW DROPOUT REGULATOR SON6 | TEXAS INSTRUMENTS | TPS73533DRVR | SON6_25-59_85X85
205 | 1 | 141016030006-R | U100 | TCA9543APWR | IC 2-CHANNEL I2C BUS SWITCH WITH INTERRUPT LOGIC AND RESET TSSOP14 | TEXAS INSTRUMENTS | TCA9543APWR | TSSOP14_25-59_205X180_1-2
206 | 1 | 142014070020-R | U104 | TPS22965DSGT | IC 5.7V 6A 1-CHANNEL 16mE ON-RESISTANCE LOAD SWITCH WSON8 | TEXAS INSTRUMENTS | TPS22965DSGT | WSON8_19-68_80X80_0-8
207 | 1 | 141022040005-R | U108 | SN74LVC07ADGVR | IC HEX BUFFER AND DRIVER WITH OPEN DRAIN OUTPUT TVSOP14 | TEXAS INSTRUMENTS | SN74LVC07ADGVR | TVSOP14_15-74_180X150_1-2
208 | 1 | 141018100011-R | U110 | TCA6408ARGTR | IC 8-BIT I2C AND SMBUS I/O EXPANDER WITH INTERRUPT O/P VQFN16 | TEXAS INSTRUMENTS | TCA6408ARGTR | QFN16_19-68_120X120_1_EP1-6
209 | 1 | 140122110004-R | U111 | SN74LVC1G3157DBVR | IC SPDT ANALOG SWITCH SOT23-6 | TEXAS INSTRUMENTS | SN74LVC1G3157DBVR | SOT23-6_1-5
210 | 1 | 140124060002-R | U112 | TXU0101DBVR | IC DUAL-BIT FIXED DIRECTION VOLTAGE-LEVEL TRANSLATOR WITH SCHMITT-TRIGGER INPUTS AND 3-STATE OUTPUTS SOT23-6 | TEXAS INSTRUMENTS | TXU0101DBVR | SOT23-6_1-5
211 | 1 | 142022090041-R | U113 | TLV75801PDBVT | IC 500mA ADJ LDO REGULATOR SOT23-5 | TEXAS INSTRUMENTS | TLV75801PDBVT | SOT23-5_1-5
212 | 1 | 141011080022-R | U114 | TPD4S012DRYR | IC 4CH ESD SOLUTION FOR USB-HS/USB OTG/USB CHARGER INTERFACE SON6 | TEXAS INSTRUMENTS | TPD4S012DRYR | SON6_SN74LVC2G17_40X60_0-6
213 | 1 | 130019040003-R | Y1 | 32.768KHz | CRY 32.768KHz 9pF SMD | ECS INC | ECS-.327-9-34QCS-TR | XTAL_ECS-32_130X60_SMD_0-9
214 | 1 | 130020100044-R | Y2 | 16.000MHz | CRY 16.000MHz 8pF SMD | MURATA | XRCGB16M000FXN01R0 | XTAL4_XRCGB-FM_80X60_SMD_0-7
215 | 1 | 130021100037-R | Y3 | 12.000MHz | CRY 12.000MHz 18pF SMD | ECS INC | ECS-120-18-30B-AGN-TR | XTAL4_ECX-53BQ_200X130_SMD_0-9
216 | 1 | 130025110002-R | Y4 | 25MHz | CRY 25MHz 8pF SMD | ABRACON CORPORATION | ABM11W-25.0000MHZ-8-D1X-T3 | XTAL4_ABM11W_80X70_SMD_0-5
