shikhakath/APE-SingleBoardComputer/reference/2_PROC142A/2_BOM/PROC142A(002)_BOM_With_Design_Updates..Notes_V1.0.xlsx

PROC142A(002)_BOM - SK-AM62B-P1
Item Number | Quantity | Part Reference | Value | Description | Mfr_name | Mfr_part_number | PCB Footprint | Alternate_mfr_part_number_A | Remarks
1 | 1 | ACC1 | 9774015243R | STANDOFF BOARD TO BOARD 1.50MM LENGTH FEMALE M2 THREADED SS | WURTH ELECTRONICS | 9774015243R | NA
2 | 45 | C1,C24,C26,C30,C38,C51,C61,C67,C84,C90,C113,C176,C181,C186,C189,C191,C220,C270,C281,C287,C288,C289,C290,C296,C329,C334,C336,C337,C339,C340,C343,C344,C346,C347,C350,C354,C358,C359,C401,C409,C422,C442,C451,C473,C490 | 0.01uF | CAP CERAMIC 0.01uF 25V 10% X5R 0201 | MURATA | GRM033R61E103KA12J | CAP0201_0-5
3 | 27 | C3,C9,C33,C39,C43,C69,C77,C142,C144,C146,C199,C201,C204,C211,C219,C230,C242,C248,C311,C313,C319,C384,C393,C406,C410,C483,C508 | 10uF | CAP CERAMIC 10uF 10V 20% X5R 0402 | MURATA | GRM155R61A106ME11D | CAP0402_0-75
4 | 180 | C4,C6,C7,C8,C10,C11,C12,C20,C22,C25,C27,C29,C31,C32,C34,C36,C40,C42,C44,C54,C55,C56,C63,C68,C70,C73,C76,C80,C82,C83,C85,C89,C93,C102,C115,C129,C134,C137,C140,C145,C148,C157,C159,C161,C162,C166,C167,C169,C170,C173,C184,C190,C194,C200,C207,C208,C209,C212,C213,C216,C217,C218,C221,C223,C225,C229,C231,C235,C238,C240,C241,C243,C245,C247,C250,C252,C253,C254,C255,C259,C260,C261,C262,C263,C264,C265,C266,C267,C268,C271,C272,C273,C274,C275,C277,C278,C279,C280,C282,C283,C284,C286,C291,C292,C295,C298,C300,C301,C304,C309,C310,C315,C318,C321,C325,C326,C328,C352,C355,C361,C362,C363,C375,C381,C385,C386,C388,C394,C404,C405,C411,C429,C430,C431,C435,C437,C439,C440,C445,C446,C449,C450,C452,C453,C456,C457,C458,C462,C463,C464,C466,C467,C468,C469,C470,C472,C474,C475,C477,C478,C481,C484,C485,C487,C488,C489,C492,C493,C495,C496,C497,C499,C507,C510,C511,C512,C513,C514,C515,C516 | 0.1uF | CAP CERAMIC 0.1uF 16V 10% X5R 0201 | MURATA | GRM033R61C104KE14D | CAP0201_0-5
5 | 0 | C5,C156 | DNI | DNI | DNI | DNI | DNI
6 | 10 | C13,C65,C179,C197,C338,C341,C351,C379,C455,C482 | 2.2uF | CAP CERAMIC 2.2uF 25V 10% X5R 0402 | MURATA | GRM155R61E225KE11D | CAP0402_0-75
7 | 3 | C14,C193,C391 | 1uF | CAP CERAMIC 1uF 25V 10% X6S 0402 | MURATA | GRM155C81E105KE11D | CAP0402_0-75
8 | 55 | C15,C18,C23,C45,C53,C59,C64,C66,C72,C74,C94,C96,C97,C99,C101,C103,C114,C116,C118,C121,C139,C147,C153,C164,C177,C182,C183,C187,C188,C196,C202,C203,C205,C206,C210,C323,C331,C332,C333,C335,C365,C377,C380,C408,C413,C421,C426,C460,C461,C471,C476,C479,C480,C498,C509 | 0.1uF | CAP CERAMIC 0.1uF 50V 10% X7R 0402 | MURATA | GRM155R71H104KE14D | CAP0402_0-75
9 | 49 | C19,C21,C28,C35,C37,C58,C62,C71,C78,C81,C88,C92,C95,C100,C178,C192,C215,C222,C224,C227,C228,C236,C237,C239,C244,C246,C249,C251,C256,C257,C258,C269,C276,C285,C294,C299,C302,C306,C307,C308,C316,C317,C324,C330,C376,C407,C443,C454,C506 | 1uF | CAP CERAMIC 1uF 16V 20% X5R 0201 | MURATA | GRM033R61C105ME15D | CAP0201_0-5
10 | 20 | C41,C48,C49,C50,C57,C87,C104,C110,C143,C180,C198,C214,C226,C233,C293,C297,C314,C320,C423,C465 | 4.7uF | CAP CERAMIC 4.7uF 10V 20% X5R 0402 | MURATA | GRM155R61A475MEAAD | CAP0402_0-75
11 | 1 | C46 | 4.7uF | CAP CERAMIC 4.7uF 16V 20% X5R 0402 | YAGEO AMERICA | CC0402MRX5R7BB475 | CAP0402_0-75
12 | 1 | C47 | 0.1uF | CAP CERAMIC 0.1uF 25V 10% X5R 0201 | MURATA | GRM033R61E104KE14D | CAP0201_0-5
13 | 3 | C52,C112,C122 | 47uF | CAP CERAMIC 47uF 10V 20% X5R 0805 | MURATA | GRM21BR61A476ME15L | CAP0805_1-5
14 | 1 | C60 | 1uF | CAP CERAMIC 1uF 25V 10% X5R AUTO 0402 | MURATA | GRT155R61E105KE01D | CAP0402_0-75
15 | 4 | C75,C79,C174,C175 | 18pF | CAP CERAMIC 18pF 50V 5% HI-Q C0G(NP0) 0402 | MURATA | GJM1555C1H180JB01D | CAP0402_0-75
16 | 9 | C86,C98,C107,C108,C117,C357,C494,C502,C503 | 2.2uF | CAP CERAMIC 2.2uF 10V 10% X5R 0201 | MURATA | GRM033R61A225KE47D | CAP0201_0-5
17 | 0 | C106,C119,C397,C399 | DNI | DNI | DNI | DNI | DNI
18 | 4 | C135,C136,C151,C152 | 220pF | CAP CERAMIC 220pF 100V 5% C0G(NP0) 0402 | MURATA | GRM1555C2A221JE01D | CAP0402_0-75
19 | 0 | C138 | DNI | DNI | DNI | DNI | DNI
20 | 7 | C141,C150,C155,C356,C400,C414,C424 | 10uF | CAP CERAMIC 10uF 35V 20% X5R 0603 | MURATA | GRM188R6YA106MA73D | CAP0603_1
21 | 2 | C149,C425 | 10uF | CAP CERAMIC 10uF 50V 10% X5R 0805 | MURATA | GRM21BR61H106KE43L | CAP0805_1-5
22 | 3 | C154,C395,C419 | 47uF | CAP CERAMIC 47uF 16V 10% X6S 1210 | MURATA | GRM32EC81C476KE15L | CAP1210_2-75
23 | 3 | C158,C160,C420 | 22uF | CAP CERAMIC 22uF 25V 20% X5R 0805 | MURATA | GRM21BR61E226ME44K | CAP0805_1-5
24 | 2 | C171,C172 | 12pF | CAP CERAMIC 12pF 25V 5% C0G(NP0) 0201 | MURATA | GRM0335C1E120JA01D | CAP0201_0-5
25 | 0 | C185,C195,C327,C372,C392,C427 | DNI | DNI | DNI | DNI | DNI
26 | 2 | C232,C349 | 22uF | CAP CERAMIC 22uF 10V 20% X5R 0603 | MURATA | GRM188R61A226ME15D | CAP0603_1
27 | 3 | C234,C312,C519 | 22pF | CAP CERAMIC 22pF 25V 1% C0G(NP0) 0201 | MURATA | GRM0335C1E220FA01D | CAP0201_0-5
28 | 0 | C303,C305 | DNI | DNI | DNI | DNI | DNI
29 | 0 | C322 | DNI | DNI | DNI | DNI | DNI
30 | 1 | C371 | 150uF_10V | CAP TANTALUM 150uF 10V 10% ESR 600mE D7343 | VISHAY | 293D157X9010D2TE3 | CAPT7343D_3-25
31 | 1 | C387 | 0.1uF | CAP CERAMIC 0.1uF 16V 10% X5R 0201 | MURATA | GRT033R61C104KE01 | CAP0201_0-5
32 | 3 | C396,C398,C418 | 1uF | CAP CERAMIC 1uF 100V 10% X7S 0805 | MURATA | GRM21BC72A105KE01L | CAP0805_1-5
33 | 1 | C402 | 36pF | CAP CERAMIC 36pF 50V 2% HI-Q C0G(NP0) 0402 | MURATA | GJM1555C1H360GB01D | CAP0402_0-75
34 | 1 | C412 | 0.47uF | CAP CERAMIC 0.47uF 10V 10% X7R 0402 | MURATA | GRM155R71A474KE01D | CAP0402_0-75
35 | 1 | C415 | 4.7uF | CAP CERAMIC 4.7uF 50V 10% X5R 0805 | TDK CORPORATION | C2012X5R1H475K | CAP0805_1-5
36 | 4 | C416,C417,C517,C518 | 47uF | CAP CERAMIC 47uF 10V 20% X5R 1206 | MURATA | GRM31CR61A476ME15L | CAP1206_2
37 | 0 | C432,C433 | DNI | DNI | DNI | DNI | DNI
38 | 1 | C441 | 15pF | CAP CERAMIC 15pF 25V 2% HI-Q C0G(NP0) 0201 | MURATA | GJM0335C1E150GB01D | CAP0201_0-5
39 | 1 | C459 | 8.2pF | CAP CERAMIC 8.2pF 25V 0.5pF C0G(NP0) 0201 | MURATA | GRM0335C1E8R2DA01D | CAP0201_0-5
40 | 2 | D1,D14 | BZX84C6V8LT1G | DIODE ZENER 250mW 6.8V SOT23-123 | ON SEMICONDUCTOR | BZX84C6V8LT1G | SOT23-123_1-2
41 | 4 | D2,D4,D9,D10 | TPD1E01B04DPLT | DIODE 1CH ESD PROTECTION FOR USB TYPE-C AND THUNDERBOLT3 X2SON2 | TEXAS INSTRUMENTS | TPD1E01B04DPLT | DIO_DFN0201_0-4
42 | 1 | D5 | ESD122DMXR | DIODE 2-CH ESD PROTECTION FOR USB TYPE-C AND HDMI 2.0 X2SON-3 | TEXAS INSTRUMENTS | ESD122DMXR | X2SON3_ESD122DMX_30X40_0-4
43 | 5 | D7,D8,D12,D13,D15 | TPD1E10B06DPYR | DIODE 1CH ESD PROTECTION X1SON2 | TEXAS INSTRUMENTS | TPD1E10B06DPYR | DIO_DFN0402_0-5
44 | 3 | FB1,FB2,FB3 | 300E | IND FERRITE CHIP 300E 500mA 0603 | TDK CORPORATION | MMZ1608R301A | IND0603 | MMZ1608R301ATA00
45 | 0 | FID1 | DNI |  |  |  | DNI
46 | 0 | FID2 | DNI |  |  |  | DNI
47 | 0 | FID3 | DNI |  |  |  | DNI
48 | 0 | FID4 | DNI |  |  |  | DNI
49 | 0 | FID5 | DNI |  |  |  | DNI
50 | 0 | FID6 | DNI |  |  |  | DNI
51 | 17 | FL3,FL5,FL6,FL8,FL9,FL10,FL12,FL13,FL14,FL16,FL17,FL19,FL21,FL22,FL23,FL25,FL26 | 120E | IND FERRITE BEAD CHIP 120E 2A 0402 | MURATA | BLM15PX121SN1D | EMIFIL_BLM15A_0402_0-6
52 | 3 | FL4,FL7,FL18 | 26E | FERRITE CHIP 26E 6A 0603 | MURATA | BLM18SG260TN1D | EMIFIL_BLM18K_0603_0-7
53 | 0 | FL15,FL20 | DNI | DNI | DNI | DNI | DNI
54 | 1 | J2 | CON_MINIPCIE_75_F | CON MINIPCI 75POS 0.50MM PITCH FEMALE RT SMD | TE CONNECTIVITY | 2199119-4_2230 | CON_MINIPCI75_2199119-4_S_R_S_3-2_2230
55 | 1 | J3 | HDR_2X20 | CON HDR 2X20 2.54MM PITCH ST TH | SULLINS CONNECTOR | PEC20DAAN | HDR_2X20_PEC20DAAN_S_T_8-6
56 | 2 | J4,J6 | CON_RJ45-14_LPJG16314A4NL | CON RJ-45 FEMALE 14POS RT TH | LINK-PP | LPJG16314A4NL | CON_RJ45-14_LPJG16314A4NL_S_R_T_13-6
57 | 1 | J5 | CON_HDMI_1X19_F | CON HDMI-A TYPE 1X19 0.50MM PITCH FEMALE RT SMD | FCI | 10029449-001RLF | CON_19X1_10029449-001RLF_S_R_S_6-3
58 | 1 | J7 | CON_USB-A_4_F | CON USB-A TYPE 4POS FEMALE RT SMD | WURTH ELECTRONICS | 629104151021 | CON_USBA4_629104151_S_R_S_7-4
59 | 3 | J8,J14,J24 | HDR_1X2 | CON HDR 1X2 2.54MM PITCH ST TH | MOLEX | 90120-0122 | HDR_1X2_90120-0122_S_T_5-6
60 | 1 | J9 | HDR_2X14 | CON HDR 2X14 2.54MM PITCH ST TH | SULLINS | PREC014DAAN-RC | HDR_14X2_100_S_T
61 | 1 | J10 | HDR_2X10 | CON HDR 2X10 2.54MM PITCH ST TH | SULLINS CONNECTOR | PREC010DAAN-RC | HDR_2X10_PREC010DAAN_S_T_8-4
62 | 2 | J11,J13 | CON_USB-C_24_F | CON USB-C TYPE 24POS FEMALE RT SMD | MOLEX | 2012670005 | CON_USBC24_2012670_S_R_S_3-9
63 | 1 | J12 | CON_AUDIOJACK4_SJ-43514-SMT | CON AUDIO JACK 4POS FEMALE RT SMD | CUI INC | SJ-43514-SMT-TR | CON_AV4_SJ-43514-SMT_S_R_S_5-1
64 | 2 | J15,J16 | CON_MUSB-B_5_F | CON MICRO USB TYPE B 5POS FEMALE RT SMD | WURTH ELECTRONICS | 629105150521 | CON_MUSBB5_629105150521_S_R_S_2-7
65 | 1 | J17 | HDR_2X10 | CON HDR 2X10 1.27MM PITCH ST SMD | SAMTEC | FTR-110-51-S-D-06 | HDR_2X10_FTR-110-51-D-06_S_S_8-7
66 | 1 | J19 | CON_FLEX_1X15_1-1734248-5 | CON FPC 1X15 1.00MM PITCH FEMALE ST SMD | TE CONNECTIVITY | 1-1734248-5 | CON_FLEX1X15_1-1734248-5_S_S_S_7-7
67 | 1 | J20 | CON_SDCARD9_MEM2051-00-195-00-A | CON MICROSD CARD 9POS FEMALE RT SMD | GCT | MEM2051-00-195-00-A | CON_SD9_MEM2051-00-195-00_S_R_S_2-1
68 | 1 | J21 | CON_FLEX_1X40_FFC2A32 | CON FPC 1X40 0.50MM PITCH FEMALE ST SMD | GCT | FFC2A32-40-T | CON_FLEX1X40_FFC2A32-40-T_S_S_S_4-3
69 | 0 | J22 | DNI | DNI | DNI | DNI | DNI
70 | 1 | J23 | CON_FLEX_40X1_FH12A-40S-0.5SH | CON FPC 40X1 0.50MM PITCH RT TOP SMD | HIROSE ELECTRIC EUROPE | FH12A-40S-0.5SH(55) | CON_FLEX40X1_FH12A_S_R_S
71 | 3 | L5,L7,L8 | 0.47uH | IND CHIP 0.47uH 4.5A 20% 0806 | MURATA | DFE201612E-R47M=P2 | IND0806_1-2
72 | 2 | L9,L10 | 90E | IND COMMON MODE CHOKE 90E 280mA SMD | MURATA | DLW21SZ900HQ2B | IND4_DLW21H_90X60_SMD_1-4
73 | 1 | L12 | 4.7uH | IND POWER 4.7uH 11A 20% SMD | COILCRAFT | XAL6060-472MEB | IND_XAL6060_260X270_SMD_6-1
74 | 1 | L13 | 1.5uH | IND POWER 1.5uH 9.1A 20% SMD | COIL CRAFT | XFL4020-152MEB | IND_XFL4020_170X170_SMD_2-1
75 | 0 | LBL1,LBL2,LBL3 | DNI | DNI | DNI | DNI | DNI
76 | 8 | LD1,LD10,LD11,LD12,LD13,LD14,LD16,LD17 | 150080VS75000 | DIODE LED BRIGHT GREEN SMD | WURTH ELECTRONICS | 150080VS75000 | LED_150080VS75000_80X50_SMD_0-8
77 | 4 | LD2,LD4,LD7,LD9 | 150040VS73220 | DIODE LED BRIGHT GREEN SMD | WURTH ELECTRONIK | 150040VS73220 | LED_150040GS73220_40X20_SMD_0-4
78 | 3 | LD3,LD8,LD15 | 150040RS73220 | DIODE LED RED SMD | WURTH ELECTRONICS | 150040RS73220 | LED_150040GS73220_40X20_SMD_0-4
79 | 2 | LD5,LD6 | 150040AS73220 | DIODE LED AMBER SMD | WURTH ELECTRONICS | 150040AS73220 | LED_150040GS73220_40X20_SMD_0-4
80 | 0 | LOGO1 | DNI
81 | 0 | LOGO2 | DNI |  |  |  | DNI
82 | 0 | LOGO3 | DNI
83 | 0 | LOGO4 | DNI |  |  |  | DNI
84 | 1 | MH1 | FLAT WASHER_M2 | FLAT WASHER FOR M2 NYLON | KEYSTONE | 3356 | NA
85 | 1 | MH2 | PAN HEAD_M2 X 5 | PHILLIPS PAN HEAD SCREW - M2 X 5 | B AND F FASTENER | MPMS 002 0005 PH | NA
86 | 1 | PCB1 | PROC142E1 | AM62x SKEVM Bare PCB |  | PROC142E1
87 | 10 | Q1,Q3,Q4,Q5,Q6,Q7,Q8,Q9,Q13,Q20 | CSD16301Q2 | IC MOSFET N-CHANNEL NEXFET 25V WSON6 | TEXAS INSTRUMENTS | CSD16301Q2 | WSON6_CSD13202Q2_80X80_0-8
88 | 0 | Q2 | DNI | DNI | DNI | DNI | DNI
89 | 2 | Q14,Q16 | CSD25310Q2 | IC MOSFET P-CHANNEL WSON6 | TEXAS INSTRUMENTS | CSD25310Q2 | SON6_CSD17313Q2_80X80
90 | 2 | Q17,Q18 | IRLML6401 | TRANSISTOR MOSFET P-CHANNEL SOT23-3 | IRF | IRLML6401TRPBF | TO_SOT23-123
91 | 51 | R1,R7,R11,R15,R32,R39,R55,R57,R60,R62,R66,R83,R87,R89,R105,R116,R157,R163,R287,R301,R302,R314,R331,R353,R354,R422,R437,R438,R439,R440,R441,R446,R460,R464,R468,R473,R477,R478,R480,R540,R608,R613,R625,R638,R639,R643,R654,R677,R678,R695,R702 | 0E | RES 0E 1/20W 5% 0201 | YAGEO AMERICA | RC0201JR-070RL | RES0201_0-5
92 | 0 | R2,R3,R4,R23,R34,R52,R53,R158,R164,R221,R224,R225,R226,R229,R230,R231,R232,R337,R385,R492,R525,R544,R580,R598,R676 | DNI | DNI | DNI | DNI | DNI
93 | 0 | R5 | DNI | DNI | DNI | DNI | DNI
94 | 0 | R6,R10,R386 | DNI | DNI | DNI | DNI | DNI
95 | 52 | R8,R33,R37,R64,R65,R72,R78,R79,R95,R101,R102,R109,R115,R124,R125,R149,R155,R198,R222,R280,R281,R282,R283,R284,R289,R312,R321,R324,R335,R338,R340,R359,R360,R383,R387,R483,R485,R569,R570,R571,R583,R589,R590,R591,R594,R595,R596,R597,R615,R616,R673,R674 | 0E | RES 0E 1/16W JUMPER 0402 | VISHAY | CRCW04020000Z0ED | RES0402_0-5
96 | 3 | R12,R333,R398 | 10K | RES 10K 1/16W 5% 0402 | YAGEO AMERICA | RC0402JR-0710KL | RES0402_0-5
97 | 34 | R13,R30,R31,R61,R71,R73,R201,R262,R264,R265,R270,R391,R392,R403,R404,R490,R491,R498,R499,R550,R561,R573,R581,R592,R599,R600,R611,R666,R667,R684,R686,R687,R689,R690 | 4.7K | RES 4.7K 1/20W 5% 0201 | YAGEO AMERICA | RC0201JR-074K7L | RES0201_0-5
98 | 19 | R14,R202,R203,R204,R205,R206,R207,R208,R209,R210,R211,R212,R213,R214,R215,R216,R217,R274,R484 | 100K | RES 100K 1/20W 5% 0201 | PANASONIC-ECG | ERJ-1GEJ104C | RES0201_0-5
99 | 142 | R16,R17,R25,R26,R27,R28,R35,R58,R63,R77,R80,R81,R82,R91,R92,R94,R96,R104,R107,R111,R112,R114,R117,R118,R140,R160,R162,R165,R169,R176,R177,R179,R180,R181,R184,R185,R187,R191,R192,R193,R196,R197,R199,R200,R218,R252,R253,R254,R285,R296,R300,R303,R304,R306,R307,R308,R309,R310,R313,R315,R317,R318,R319,R322,R325,R351,R373,R374,R380,R381,R388,R389,R393,R402,R420,R427,R432,R433,R450,R451,R452,R457,R469,R472,R475,R481,R486,R487,R488,R489,R514,R517,R521,R522,R531,R537,R538,R539,R541,R542,R543,R554,R555,R558,R559,R562,R564,R566,R567,R568,R572,R574,R575,R576,R577,R578,R579,R585,R586,R587,R601,R602,R606,R609,R655,R657,R659,R660,R661,R662,R663,R664,R665,R685,R688,R691,R696,R700,R703,R713,R714,R715 | 10K | RES 10K 1/20W 5% 0201 | YAGEO AMERICA | RC0201JR-0710KL | RES0201_0-5
100 | 21 | R18,R19,R20,R21,R22,R41,R156,R266,R272,R273,R328,R361,R370,R425,R470,R495,R502,R509,R533,R647,R704 | 10K_1% | RES 10K 1/20W 1% 0201 | YAGEO AMERICA | RC0201FR-0710KL | RES0201_0-5
101 | 4 | R24,R74,R535,R603 | 33E | RES 33E 1/20W 5% 0201 | PANASONIC-ECG | ERJ-1GEJ330C | RES0201_0-5
102 | 6 | R29,R178,R219,R256,R339,R418 | 0E | RES 0E 1/10W 5% 0603 | PANASONIC-ECG | RC0603JR-070RL | RES0603_0-75
103 | 0 | R38,R49,R76,R85,R86,R291,R292,R293,R294,R295,R311,R344,R345,R346,R347,R348,R356,R357 | DNI | DNI | DNI | DNI | DNI
104 | 5 | R47,R54,R84,R299,R350 | 2.49K_1% | RES 2.49K 1/16W 1% 0402 | YAGEO AMERICA | RC0402FR-072K49L | RES0402_0-5
105 | 5 | R48,R70,R106,R134,R148 | 0.01E_1% | RES 0.01E 1W 1% 1206-4 | SUSUMU | KRL3216T4A-M-R010-F-T1 | RES_KRL3216T4_1206-4_0-7
106 | 1 | R56 | 22E | RES 22E 1/20W 5% 0201 | YAGEO AMERICA | RC0201JR-0722RL | RES0201_0-5
107 | 3 | R67,R68,R69 | 499E_1% | RES 499E 1/16W 1% 0402 | YAGEO AMERICA | RC0402FR-07499RL | RES0402_0-5
108 | 21 | R88,R159,R161,R166,R167,R168,R170,R171,R175,R188,R257,R267,R271,R286,R288,R334,R341,R342,R371,R614,R617 | 220E | RES 220E 1/10W 5% 0402 | PANASONIC-ECG | ERJ-2GEJ221X | RES0402_0-5
109 | 0 | R90,R172,R173,R190,R195,R220,R297,R329,R362,R390,R394,R431,R459,R474,R526,R546,R584,R605,R607,R650,R658,R712 | DNI | DNI | DNI | DNI | DNI
110 | 0 | R93,R110,R113,R145,R146,R147,R154,R189,R194,R235,R290,R355,R358,R421 | DNI | DNI | DNI | DNI | DNI
111 | 2 | R98,R135 | 240E_1% | RES 240E 1/10W 1% 0402 | PANASONIC-ECG | ERJ-2RKF2400X | RES0402_0-5
112 | 1 | R108 | 9.76K_0.1% | RES 9.76K 1/16W 0.1% 0402 | PANASONIC-ECG | ERA-2AEB9761X | RES0402_0-5
113 | 0 | R119,R363,R442,R672,R681 | DNI | DNI | DNI | DNI | DNI
114 | 1 | R120 | 2.2K | RES 2.2K 1/16W 5% 0402 | YAGEO AMERICA | RC0402JR-072K2L | RES0402_0-5
115 | 0 | R121,R255,R258,R259,R260 | DNI | DNI | DNI | DNI | DNI
116 | 16 | R122,R182,R227,R305,R400,R461,R494,R527,R552,R556,R560,R563,R656,R692,R693,R694 | 1K_1% | RES 1K 1/10W 1% 0402 | PANASONIC-ECG | ERJ-2RKF1001X | RES0402_0-5
117 | 0 | R123 | DNI | DNI | DNI | DNI | DNI
118 | 2 | R152,R649 | 3.48K_1% | RES 3.48K 1/20W 1% 0201 | PANASONIC-ECG | ERJ-1GNF3481C | RES0201_0-5
119 | 2 | R153,R648 | 16.5K_1% | RES 16.5K 1/16W 1% 0402 | YAGEO AMERICA | RC0402FR-0716K5L | RES0402_0-5
120 | 0 | R223,R515 | DNI | DNI | DNI | DNI | DNI
121 | 1 | R228 | 49.9E_1% | RES 49.9E 1/16W 1% 0402 | VISHAY | CRCW040249R9FKEDC | RES0402_0-5
122 | 24 | R236,R237,R238,R239,R240,R241,R242,R243,R244,R245,R246,R247,R248,R249,R250,R251,R501,R504,R506,R508,R511,R513,R516,R518 | 1.1K_1% | RES 1.1K 1/20W 1% 0201 | PANASONIC-ECG | ERJ-1GEF1101C | RES0201_0-5
123 | 1 | R261 | 4.87K_1% | RES 4.87K 1/16W 1% 0402 | PANASONIC-ECG | ERJ2RKF4871X | RES0402
124 | 2 | R268,R519 | 30K | RES 30K 1/16W 5% 0402 | VISHAY | CRCW040230K0JNED | RES0402_0-5
125 | 1 | R269 | 20K_1% | RES 20K 1/16W 1% 0402 | VISHAY | CRCW040220K0FKED | RES0402_0-5
126 | 2 | R298,R349 | 5.76K_1% | RES 5.76K 1/10W 1% 0402 | PANASONIC-ECG | ERJ-2RKF5761X | RES0402_0-5
127 | 0 | R316,R323 | DNI | DNI | DNI | DNI | DNI
128 | 9 | R320,R336,R343,R369,R372,R382,R384,R553,R565 | 22E_1% | RES 22E 1/20W 1% 0201 | PANASONIC-ECG | ERJ-1GEF22R0C | RES0201_0-5
129 | 0 | R326 | DNI | DNI | DNI | DNI | DNI
130 | 1 | R327 | 7.5K | RES 7.5K 1/16W 5% 0402 | VISHAY | CRCW04027K50JNED | RES0402_0-5
131 | 1 | R330 | 1.5K | RES 1.5K 1/20W 5% 0201 | PANASONIC-ECG | ERJ-1GEJ152C | RES0201_0-5
132 | 3 | R352,R479,R551 | 2.2K_1% | RES 2.2K 1/20W 1% 0201 | PANASONIC-ECG | RC0201FR-072K2L | RES0201_0-5
133 | 0 | R364,R365,R366,R367,R376,R377,R379 | DNI | DNI | DNI | DNI | DNI
134 | 0 | R368 | DNI | DNI | DNI | DNI | DNI
135 | 1 | R375 | 56.2K_1% | RES 56.2K 1/16W 1% 0402 | YAGEO AMERICA | 9C04021A5622FLHF3 | RES0402_0-5
136 | 2 | R378,R396 | 49.9K_1% | RES 49.9K 1/20W 1% 0201 | PANASONIC-ECG | ERJ-1GEF4992C | RES0201_0-5
137 | 2 | R395,R397 | 39.2E_1% | RES 39.2E 1/16W 1% 0402 | STACKPOLE ELECTRONICS | RMCF0402FT39R2 | RES0402_0-5
138 | 0 | R399 | DNI | DNI | DNI | DNI | DNI
139 | 3 | R407,R408,R651 | 1K_1% | RES 1K 1/20W 1% 0201 | PANASONIC-ECG | ERJ-1GNF1001C | RES0201_0-5
140 | 1 | R426 | 49.9K_1% | RES 49.9K 1/16W 1% 0402 | YAGEO AMERICA | RC0402FR-0749K9L | RES0402_0-5
141 | 8 | R445,R453,R455,R465,R471,R497,R671,R680 | 100K_1% | RES 100K 1/10W 1% 0402 | PANASONIC-ECG | ERJ-2RKF1003X | RES0402_0-5
142 | 1 | R449 | 1M_1% | RES 1M 1/16W 1% 0402 | YAGEO AMERICA | RC0402FR-071ML | RES0402_0-5
143 | 1 | R454 | 32.4K_1% | RES 32.4K 1/16W 1% 0402 | VISHAY | CRCW040232K4FKED | RES0402_0-5
144 | 0 | R466 | DNI | DNI | DNI | DNI | DNI
145 | 1 | R467 | 43.2K_1% | RES 43.2K 1/16W 1% 0402 | VISHAY | CRCW040243K2FKED | RES0402_0-5
146 | 1 | R520 | 51K | RES 51K 1/16W 5% 0402 | VISHAY | CRCW040251K0JNED | RES0402_0-5
147 | 2 | R530,R557 | 100E_1% | RES 100E 1/16W 1% 0402 | YAGEO AMERICA | RC0402FR-07100RL | RES0402_0-5
148 | 3 | R582,R612,R699 | 0E | RES 0E 1/8W 5% 0805 | YAGEO AMERICA | RC0805JR-070RL | RES0805_0-75
149 | 1 | R593 | 12K_1% | RES 12K 1/10W 1% 0402 | PANASONIC-ECG | ERJ-2RKF1202X | RES0402_0-5
150 | 0 | R618 | DNI | DNI | DNI | DNI | DNI
151 | 6 | R620,R621,R624,R675,R679,R682 | 10K | RES 10K 1/20W 5% 0201 | PANASONIC-ECG | ERJ-1GEJ103C | RES0201_0-5
152 | 1 | R645 | 130K_1% | RES 130K 1/10W 1% 0402 | PANASONIC-ECG | ERJ-2RKF1303X | RES0402_0-5
153 | 1 | R646 | 680K_1% | RES 680K 1/10W 1% 0402 | PANASONIC-ECG | ERJ-2RKF6803X | RES0402_0-5
154 | 2 | R668,R669 | 1.8K | RES 1.8K 1/20W 1% 0201 | YAGEO AMERICA | ERJ-1GEF182C | RES0201_0-5
155 | 1 | R701 | 8.2K_1% | RES 8.2K 1/20W 1% 0201 | VISHAY | CRCW02018K20FKED | RES0201_0-5
156 | 2 | RA1,RA2 | 1K | RES ARRAY 1K 31mW 5% 0201-4 | PANASONIC-ECG | EXB-18V102JX | RESA_EXB_0201-4_0-5
157 | 2 | RA3,RA4 | 0E | RES ARRAY 0E 31mW JUMPER 0201-4 | PANASONIC-ECG | EXB-18VR000X | RESA_EXB_0201-4_0-5
158 | 2 | SW1,SW2 | 416131160808 | SWITCH SLIDE SPST ST SMD | WURTH ELECTRONICS | 416131160808 | SW16_416131160808_460X230_SMD_2-7
159 | 2 | SW3,SW4 | 7914G-1-000E | SWITCH SPST-NO 4MM SQ SMD 7914G | BOURNS | 7914G-1-000E | SW4_100X216_200X200_SMD_4-2
160 | 1 | SW5 | 436331045822 | SWITCH TACTILE SPST RT SMD | WURTH ELECTRONICS | 436331045822 | SW4_436331045822_190X190_SMD_1-7
161 | 0 | TP1,TP2,TP3,TP4,TP11,TP12,TP13,TP14,TP15,TP16,TP17,TP18,TP19,TP20,TP21,TP22,TP23,TP24,TP25,TP26,TP27,TP28,TP29,TP30,TP31,TP32,TP33,TP34,TP35,TP36,TP37,TP39,TP40,TP41,TP42,TP43,TP45,TP49,TP50,TP51,TP52,TP53,TP54,TP55,TP60,TP61,TP62,TP63,TP64,TP66,TP67,TP68,TP69,TP70,TP73,TP74,TP75,TP76,TP77,TP78,TP79,TP80,TP81,TP82,TP83,TP84,TP85,TP86,TP88,TP90,TP91,TP92,TP93,TP95,TP98,TP99,TP100,TP101,TP102,TP103,TP104,TP105,TP108,TP109,TP111,TP112,TP113,TP114,TP115,TP116,TP117,TP118,TP119,TP120,TP121,TP122 | DNI | DNI | DNI | DNI | DNI
162 | 0 | TP56,TP59,TP65 | DNI | DNI | DNI | DNI | DNI
163 | 0 | TP57,TP58,TP71,TP72,TP96,TP97 | DNI | DNI | DNI | DNI | DNI
164 | 0 | U1 | DNI | DNI | DNI | DNI | DNI
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
