shikhakath/APE-SingleBoardComputer/reference/2_PROC142A/6_Assembly_Models_Package/2D/PROC142A_TASY.dxf

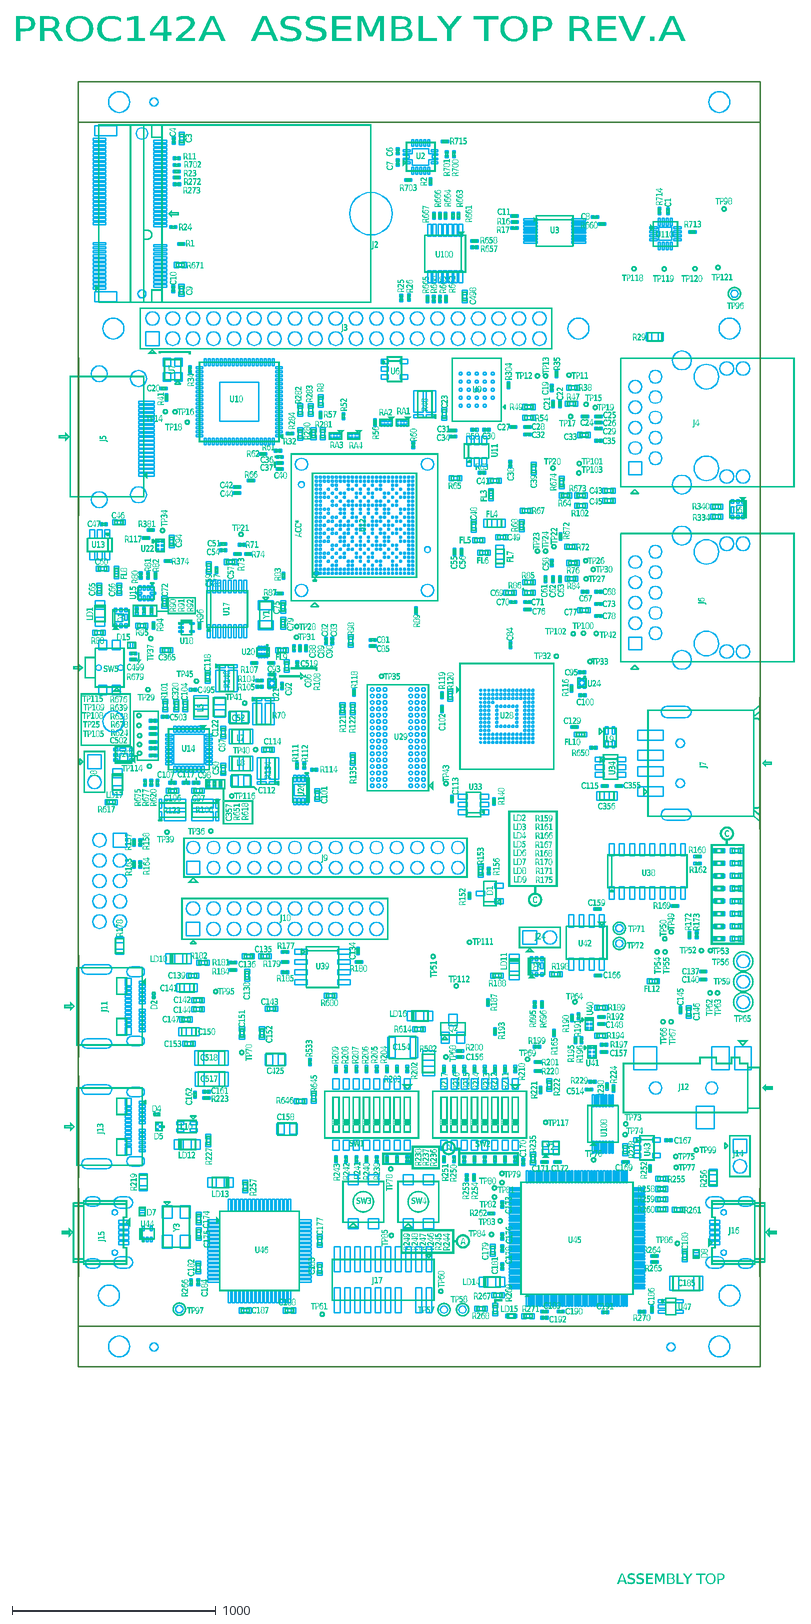
[picture p8: CAD file, 2026-10-17]
reference/2_PROC142A/6_Assembly_Models_Package/2D/PROC142A_TASY.dxf
U28
U29
U110
J2
U2
U3
R702
R715
R714
R713
R703
R700
R701
R1
R2
R23
R11
R17
R16
R118
R152
R533
R181
R184
R185
R177
R180
R179
R104
R117
R374
R114
R112
R111
R140
R192
R191
R190
R197
R196
R35
R195
R252
R25
R26
R77
R381
R220
R200
R116
R158
R164
R157
R163
R87
R83
R105
R262
R73
R71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
