shikhakath/APE-SingleBoardComputer/(list of files, cad)

Other CAD files:
reference/1_PROC142B/6_Assembly_Models_Package/2D/PROC142B_TASY_DXF.dxf
reference/1_PROC142B/6_Assembly_Models_Package/3D/PROC142B_3D_STEP.STEP
reference/2_PROC142A/6_Assembly_Models_Package/3D/PROC142A_3D.STEP
reference/1_PROC142B/6_Assembly_Models_Package/2D/PROC142B_BASY_DXF.dxf
reference/2_PROC142A/6_Assembly_Models_Package/2D/PROC142A_BASY.dxf
