shikhakath/APE-SingleBoardComputer/hardware/gen/blocks/20_debug.txt

# Debug corner: USB-C, FT4232, level shifters, Tag-Connect.

# USB-C side
near T J1500.A5 R1500
near T J1500.B5 R1501
# (0R links dropped 2026-11-10) near T J1500.S1 R1502
near T J1500.A6 U1501
near T U1501.1 C1502
near T J1500.A4B9 D1500 C1500 C1501
at T 0 5 50.5 U1502
near T U1502.1 C1503
near T U1502.5 C1504 C1505

# FT4232: decoupling behind each pin named in the schematic
near B U1500.12 C1507
near B U1500.37 C1508
near B U1500.64 C1509
near B U1500.50 C1510
near B U1500.20 C1511
near B U1500.31 C1512
near B U1500.42 C1513
near B U1500.56 C1514
near B U1500.49 C1506
near B U1500.4 C1516 C1515 FB1500
near B U1500.9 C1518 C1517 FB1501
at B 0 12.3 58.6 Y1500
near B U1500.2 C1519
near B U1500.3 C1520
near B U1500.6 R1503
near B U1500.14 R1504

# Config EEPROM
at B 0 13 62.8 U1503
near B U1503.6 C1521
near B U1503.3 R1507
near B U1503.5 R1508
near B U1503.4 R1509
near B U1503.1 R1510

# Level shifters: caps at the supply pins, pull-ups on the SiP side
near T U1504.1 C1522
near T U1504.16 C1523
near T U1505.1 C1524
near T U1505.16 C1525
near T U1504.15 R1505
# (0R links dropped 2026-11-10) near B U1500.60 R1530

# JTAG: ESD and pull-ups around the Tag-Connect
at T 0 36.6 59.2 U1510
at T 0 36.6 63.6 U1511
near T U1510.1 R1521 R1523
near T U1510.2 R1524
near T U1510.4 R1525
near T U1511.2 R1526
near T U1511.4 R1527
near T U1511.1 R1528
near T U1511.5 R1529
near T U1511.5 R604
near T U1510.5 R1522
near B J1501.6 TP1500
