shikhakath/APE-SingleBoardComputer/reference/1_PROC142B/1_SCHEMATIC/2_PDF_Standard/PROC142B(002)_SCH_With_Design_Updates..Notes_V1.0.pdf

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
# I2C TREE

# TABLE OF CONTENTS

# GPIO MAPPING TABLE

# PERIPHERAL POWER SUPPLIES-2

# SOC POWER SUPPLIES - PMIC BASED WITH SOC CURRENT MEASUREMENT SHUNTS

# PERIPHERAL POWER SUPPLIES-1

# USB TYPE-C PD CONTROLLER AND POWER SUPPLY

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
# BLOCK DIAGRAM XDS110 DEBUGGER

# POWER-UP SEQUENCE AND POWER ARCHITECTURE BLOCK DIAGRAM

# POWER SEQUENCE

# TABLE OF CONTENTS

# REVISION HISTORY

# BLOCK DIAGRAM FOR AM625 / AM623 STARTER KIT SK (EVM)

PAGE | CONTENTS

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
# SOC MMC0.2 INTERFACE AND eMMC FLASH + RESET

# SOC OSPI/QSPI INTERFACE AND OSPI FLASH

# SOC SUPPLY RAILS CURRENT MEASUREMENT DEVICES

# CPSW3G RGMII_1 ETHERNET PHY

# M.2 INTERFACE AND CONNECTOR

# SOC POWER SUPPLIES - DECAPS 1

# SOC DDRSS AND DDR4 MEMORY DEVICE INTERFACE

# SOC POWER SUPPLIES, SUPPLY RAILS AND SOC GROUND VSS

# SD CARD - LOAD SWITCH, LOAD SWITCH RESET LOGIC AND DATA INTERFACE

# BOARD ID EEPROM & DIGITAL TEMPERATURE SENSORS

PAGE | CONTENTS
REV | B
VER | 0.15

# AM625 / AM623 Starter Kit SK (EVM) WITH TPS6521904 PMIC

# ASSEMBLY NOTES AND MOUNTING HARDWARE

# SOC PUSH BUTTON RESET INPUTS, DEBOUNCE LOGIC FOR RC RESET

# SOC RESETs AND IOs, AND EXTERNAL LVCMOS CLOCK (OSCILLATOR)

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
# TEST AUTOMATION

# BOOT MODE CONFIGURATION BUFFERS, RESISTOR DIVIDERS & DIP SWITCHES

# XDS110 DEBUGGER

# SOC MAC INTRFACE, SOC AND ETHERNET PHYs CLOCK BUFFER, LED DRIVER

# CPSW3G RGMII_2 ETHERNET PHY

# USB0 TYPE-C DRP

# SOC-MCU DOMAIN IO, OSC0 AND SOC-MCU IO HEADER

# SOC USB INTERFACE, USB1 TYPE-A CONNECTOR, VBUS DIVIDER & POWER SWITCH

# SOC JTAG INTERFACE AND JTAG BUFFERS

# SOC LFOSC0 AND SOC BOOTMODE INPUT PINS, PRU HEADER

# JTAG 20 PIN cTI CONNECTOR AND BUFFERS

# USER EXPANSION CONNECTOR

# FT4232 UART TO USB BRIDGE

# SOC DPI INTERFACE, DPI TO HDMI TRANSMITTER INTERFACE

# SOC OLDI INTERFACE, LCD CONNECTOR AND SOC UART1 FET SWITCH & BUFFER

# SOC CSI INTERFACE AND CAMERA CONNECTOR

# AUDIO CODEC

# IO EXPANDER AND MCASP1 FET SWITCH & BUFFER

44

# AUTOMATION SIGNALS BUFFER

* Verify the DNI components configuration with respect to the SK schematics (use PDF) after completion of board design before board assembly. * A standard 5% tolerance resistor can be used for most of the series and parallel pull resistors.
* Be sure to read through all the D-Notes (Design notes), R-Notes (Review notes) and CAD notes during board design and before start of board build. (Refer FAQs listed for additional details).

# R-Note:

# Revision Number

SK/EVM is an evaluation board or platform. The SK/EVM is not a reference design. In some cases, the EVM implementation may deviate from the optimum solution to provide a better customer experience or provide flexibility for customers to be able to validate the SoC functionality. TI expects and recommends customers to carefully review and follow all requirements defined in the datasheet, silicon errata and TRM when designing their custom board. The information found in the datasheet should always take precedence over the SK/EVM implementation.

# D-Note:

C

V

Indicates that the value of the component has been updated.

# Indicates circuit level change

# LINKS TO KEY COLLATERALS AND FAQs

45

# SOC POWER SUPPLIES - DECAPS 2

46

Title

Size | Rev
Date: | Sheet | o f
Designed for TI by Mistral Solutions Pvt Ltd | B

TABLE OF CONTENTS C

Friday, May 08, 2026 | 1 | 46 PROC142B(002)

Title
Designed for TI by Mistral Solutions Pvt Ltd | B

TABLE OF CONTENTS C

Friday, May 08, 2026 | 1 | 46 PROC142B(002)

Title
Designed for TI by Mistral Solutions Pvt Ltd | B

TABLE OF CONTENTS C

Friday, May 08, 2026 | 1 | 46 PROC142B(002)

D D

C C

B B

A A

# REVISION HISTORY

## 0.15 23 April 2026

## Below components have been updated based on TI review comments checklist:

1. Tolerance of R502, R495, R461, R6, R305, R563, R560, R556, R552, R260, R259, R258, R255,

R694, R693 and R400 resistors has been changed from 1% to 5% 2. Value of R304 has been changed from 47K to 10K 3. Value of R330 has been changed from 1.5K to 2.2K 4. Value of R614 & R617 has been changed from 1K to 470E 5. Value of R88 & R188 has been changed from 220E to 470E 6. Added and updated D-Notes

## - Added D-notes - Added blocks to indicate value/circuit changes form rev A to B

## Updated D-Notes

## AUTHOR

## - R96 has been changed from 10k to 47k - VCCB of U106 has been changed from VCC3V3_TA to VCC_3V3_SYS - Pull-ups R787 & R788 have been added in the FT4232 UART buffers section - Pull-up resistor R789 has been added on TEST_GPIO2_XDS signal

## Mistral Design Team

## - Changed the supply from VCC3V3_EXP to VCC_3V3_SYS on U111 & R717

- Moved U112 and the corresponding components to the User Expansion Connector section & added the

## respective D-Notes

## 26 Jun 2025

0.03

0.09

## 14 July 2025

## 0.06 Mistral Design Team

## 11 Nov 2025

## Mistral Design Team

## 21 July 2025

## 0.12 23 March 2026

## - Replaced U13 with a dual-channel load switch - Changed the implementation of AUDIO_EXT_REFCLK1

## Mounted R6 (The production revision of Wi-Fi+BT module "M.2-CC3351" requires R6 resistor as confirmed by TI)

## REVIEWED BY

## 09 Jan 2026

## Mistral Design Team

## DATE

## Mistral Design Team

## Mistral Design Team

0.08

0.01

## 04 Nov 2025

0.07

## Implemented the review comments shared by TI

## 22 Sept 2025

## Implemented the review comments shared by TI

## Mistral Design Team

## 0.05 12 Aug 2025

## Mistral Design Team

## 0.04 Mistral Design Team

## 20 Jun 2025

0.11

VER # | APPROVED BY

## 03 Nov 2025

- U34 part number has been changed to TPS2051BD and the corresponding circuit has been updated

## - U114 and the corresponding circuit have been added for ESD protection of USB data lines - Y4 part number has been changed to ABM11W-25.0000MHZ-8-D1X-T3; C303 and C305 have been updated to 13pF

## 07 Oct 2025

## Mistral Design Team

## - TP124 has been added to U12.B7 pin of the SoC - D16 and D17 ESD diodes have been added to J26 and J25 headers respectively

- R785, R784 and R786 pulldown resistors have been added to AUDIO_EXT_REFCLK1_R, EXP_CLKOUT0

## and AUDIO_EXT_REFCLK1 signals respectively

## Mistral Design Team

0.02

0.10

## Updated TIVA and XDS section as per TI requirement

## - Added U113 regulator and corresponding components for VDD_CANUART implementation - Implemented partial IO support for FT4232 UART

## Below components have been updated based on TI review comments checklist: 1. Value of C232 is changed from 22uF to 4.7uF 2. C491, C534, C535, C536, C537 have been changed from 10pF to 47pF 3. R613, R743, R744, R746, R747 have been changed from 620E to 62E 4. Mounted R363 5. Added D-Notes

## Mistral Design Team

## - Drafted from PROC142A1 Schematics

- Added optional clock path for EXP_CLKOUT0 signal on the Expansion header to support DANTE

## DESCRIPTION OF CHANGES

## 0.14 Mistral Design Team 14 April 2026

0.13 | 31 March 2026 | Mistral Design Team

## Mistral Design Team

## Pandiyarajan

## Pandiyarajan

## Pandiyarajan

## Pandiyarajan

## Pandiyarajan

## Pandiyarajan

## Pandiyarajan

## Pandiyarajan

## Pandiyarajan

## Pandiyarajan

## Pandiyarajan

## Pandiyarajan

## Pandiyarajan

## Pandiyarajan

## Pandiyarajan

Title
Designed for TI by Mistral Solutions Pvt Ltd | B REVISION HISTORY C
Friday, May 08, 2026 | 2 | 46 PROC142B(002)

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

D D

C C

B B

A A

https://e2e.ti.com/support/processors-group/processors/f/processors-forum/1285107/faq-am64x-am62x-am62ax-am62px-custom-board-hardware-design---

# collaterals-for-reference-during-schematic-design-and-schematics-review

https://e2e.ti.com/support/processors-group/processors/f/processors-forum/1184006/faq-am623-custom-board-hardware-design-collaterals-to-get-startedhttps://e2e.ti.com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

https://e2e.ti.com/support/processors-group/processors/f/processors-forum/1280721/faq-am625-am623-am625sip-am625-q1-am620-q1-custom-board-hardware-design---faqs-rela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

# review-notes-for-reuse-of-sk-am62b-p1-schematics

# Schematic Design guidelines combined for Sitara processor families : https://www.ti.com/lit/pdf/sprad21

# SKs (Starter Kits) for Reference:

# https://www.ti.com/lit/an/sprad05b/sprad05b.pdf

# Hardware Design Guide:

# https://www.ti.com/lit/an/slvafd0b/slvafd0b.pdf

# https://www.ti.com/lit/an/sprad06/sprad06.pdf

# DDR Board Design and Layout Guidelines:

# PMIC Power Solutions Application Note:

# https://www.ti.com/lit/pdf/sprado3

Schematic Design checklist, General guidelines and Review Checklist for AM62x Processor Family:

# SK-AM62B, SK-AM62B-P1, SK-AM62-LP, SK-AM62-SIP, SK-AM62A-LP, SK-AM62P-LP

# LINKS TO KEY COLLATERALS

# LINKS TO KEY FAQs

https://e2e.ti.com/support/processors-group/processors/f/processors-forum/1596731/faq-am625-am623-am620-q1-am625-q1-am625sip---collaterals-for-reference-during-

# different-phases-of-custom-board-design-self-review-and-bring-up

https://e2e.ti.com/support/processors-group/processors/f/processors-forum/1454755/faq-am625-am623-am62aam62p-am62d-q1-am64x-am243x-design-recommendations-

# custom-board-hardware-design---queries-related-to-soc-data-sheet-pin-attributes

https://e2e.ti.com/support/processors-group/processors/f/processors-forum/1457736/faq-am625-am623-am62a-am62p-am62d-q1-am64x-am243x-design-recommendations-

# custom-board-hardware-design---schematics-review-checklists

https://e2e.ti.com/support/processors-group/processors/f/processors-forum/1318441/faq-am625-am623-am62adesign-recommendations-commonly-observed-errors-during-

# custom-board-hardware-design-sk-schematics-updates-for-design-update-note

https://e2e.ti.com/support/processors-group/processors/f/processors-forum/1455706/faq-am625-am623-am620-q1-am625-q1-am625sip-design-recommendations-custom-

# board-hardware-design---custom-board-schematics-self-review

https://e2e.ti.com/support/processors-group/processors/f/processors-forum/1455682/faq-am625-am623-am620-q1-am62l-am62a-am62p-am62d-q1-am64x-am243x-design-recommendat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

Title
Designed for TI by Mistral Solutions Pvt Ltd | B

LINKS TO KEY COLLATERALS AND FAQs C

Friday, May 08, 2026 | 3 | 46 PROC142B(002)

Title
Designed for TI by Mistral Solutions Pvt Ltd | B

LINKS TO KEY COLLATERALS AND FAQs C

Friday, May 08, 2026 | 3 | 46 PROC142B(002)

Title
Designed for TI by Mistral Solutions Pvt Ltd | B

LINKS TO KEY COLLATERALS AND FAQs C

Friday, May 08, 2026 | 3 | 46 PROC142B(002)

## PMIC

# I2C0 DVDD3V3(VDDSHVx), VDDSHV_MCU

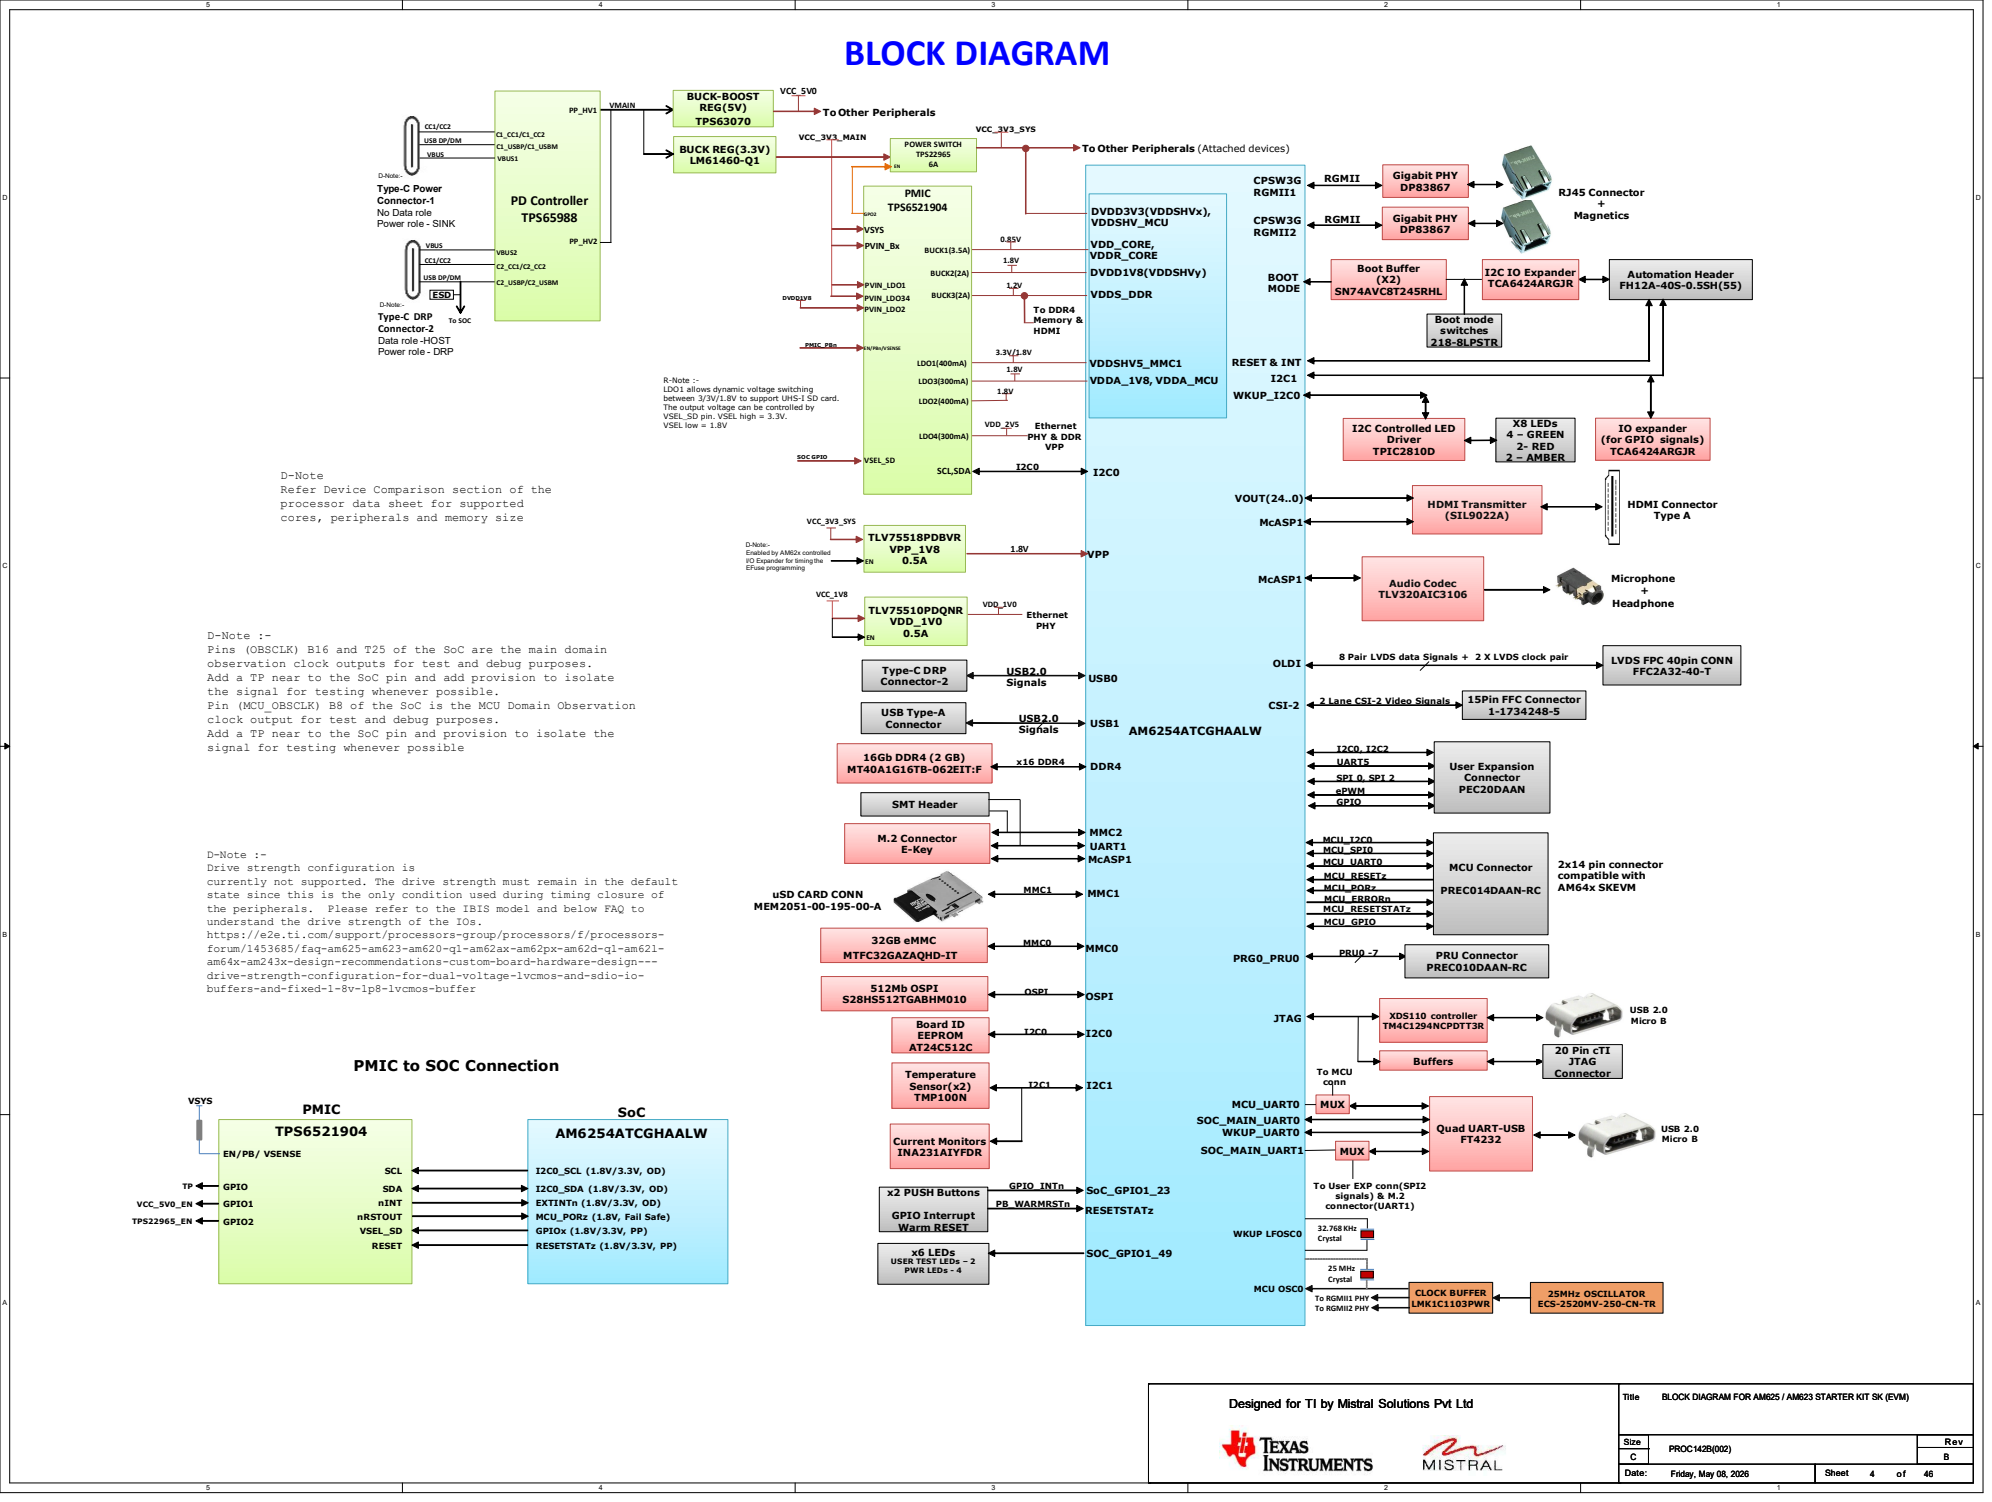
[picture p9: page 4]
AM6254ATCGHAALW; BOOT MODE; I2C IO Expander TCA6424ARGJR; RESET & INT; RGMII; HDMI Transmitter (SIL9022A) Audio Codec TLV320AIC3106; HDMI Connector Type A; CPSW3G RGMII1 CPSW3G RGMII2 WKUP_I2C0; RJ45 Connector + Magnetics Microphone +; Headphone McASP1; X8 LEDs 4 – GREEN; 2- RED 2 – AMBER; VCC_3V3_SYS; TPS6521904 BUCK1(3.5A) BUCK2(2A) BUCK3(2A) LDO1(400mA) LDO3(300mA) VSYS PVIN_Bx PVIN_LDO1; EN/PBn/VSENSE; VPP_1V8 0.5A; VCC_5V0; LDO2(400mA) LDO4(300mA); SCL,SDA TLV75510PDQNR; VDD_1V0 0.5A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

BLOCK DIAGRAM
EN SOC GPIO

1.8V To Other Peripherals

CC1/CC2 CC1/CC2 VBUS VBUS Type-C Power Connector-1 No Data role Power role - SINK

USB DP/DM

Automation Header FH12A-40S-0.5SH(55) Gigabit PHY DP83867 Gigabit PHY DP83867 Boot Buffer (X2) SN74AVC8T245RHLBoot mode switches 218-8LPSTR

Type-C DRP Connector-2 Data role -HOST Power role - DRP ESD

To DDR4 Memory & HDMI TLV75518PDBVR

I2C Controlled LED Driver TPIC2810D

IO expander (for GPIO signals) TCA6424ARGJR

D-Note
Refer Device Comparison section of the
processor data sheet for supported
cores, peripherals and memory size

VOUT(24..0) McASP1
16Gb DDR4 (2 GB) MT40A1G16TB-062EIT:F M.2 Connector E-Key 512Mb OSPI S28HS512TGABHM010 Board ID EEPROM

D-Note:-
EN Enabled by AM62x controlled
I/O Expander for timing the EFuse programming

D-Note :-
Pins (OBSCLK) B16 and T25 of the SoC are the main domain
observation clock outputs for test and debug purposes.
Add a TP near to the SoC pin and add provision to isolate
the signal for testing whenever possible.
Pin (MCU_OBSCLK) B8 of the SoC is the MCU Domain Observation
clock output for test and debug purposes.
Add a TP near to the SoC pin and provision to isolate the
signal for testing whenever possible

SMT Header Type-C DRP Connector-2 USB Type-A Connector

15Pin FFC Connector 1-1734248-5 OLDI CSI-2

Drive strength configuration is
currently not supported. The drive strength must remain in the default
state since this is the only condition used during timing closure of
the peripherals. Please refer to the IBIS model and below FAQ to
understand the drive strength of the IOs.
https://e2e.ti.com/support/processors-group/processors/f/processors-
forum/1453685/faq-am625-am623-am620-q1-am62ax-am62px-am62d-q1-am62l-
am64x-am243x-design-recommendations-custom-board-hardware-design---
drive-strength-configuration-for-dual-voltage-lvcmos-and-sdio-io-
buffers-and-fixed-1-8v-1p8-lvcmos-buffer

2x14 pin connector compatible with AM64x SKEVM

XDS110 controller TM4C1294NCPDTT3R MCU Connector PREC014DAAN-RC

MTFC32GAZAQHD-IT
x2 PUSH Buttons GPIO Interrupt Warm RESET x6 LEDs USER TEST LEDs – 2 PWR LEDs - 4 Temperature Sensor(x2) TMP100N

PMIC to SOC Connection

To MCU conn

I2C0_SCL (1.8V/3.3V, OD) I2C0_SDA (1.8V/3.3V, OD) EXTINTn (1.8V/3.3V, OD) MCU_PORz (1.8V, Fail Safe) GPIOx (1.8V/3.3V, PP) RESETSTATz (1.8V/3.3V, PP) VSYS

Quad UART-USB

EN/PB/ VSENSE GPIO

To RGMII2 PHY 25 MHz Crystal MCU OSC0

ECS-2520MV-250-CN-TR

Title
BLOCK DIAGRAM FOR AM625 / AM623 STARTER KIT SK (EVM) C

### TPS79601DRBR OUT

51k 30k

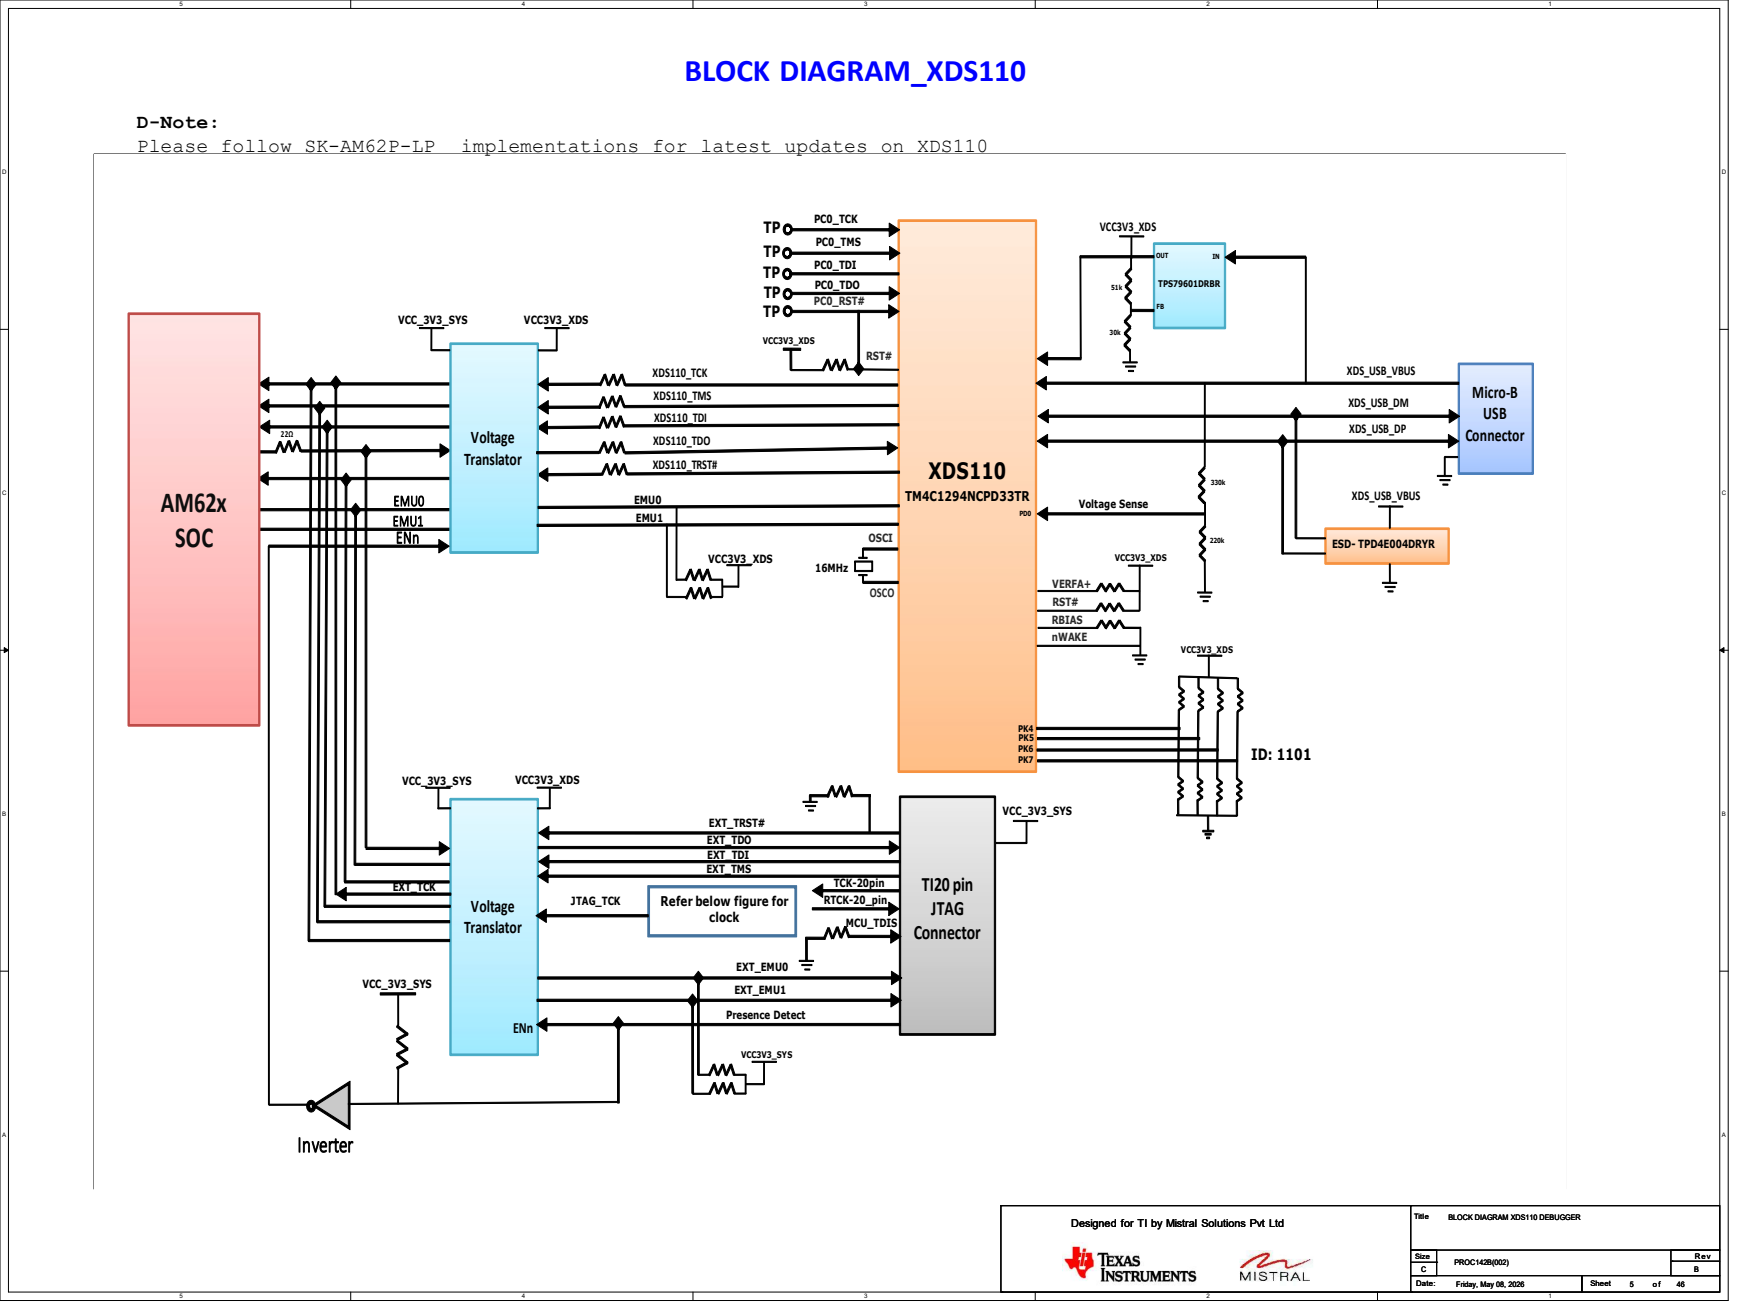
[picture p10: page 5]
TM4C1294NCPD33TR; XDS_USB_DM; VCC3V3_XDS 16MHz; OSCI OSCO; EMU0 EMU1; EXT_TMS; EXT_TDO; EXT_TRST#; TI20 pin JTAG Connector; EXT_TDI Presence Detect; ESD- TPD4E004DRYR; Voltage Translator; VCC_3V3_SYS; Voltage; Translator; MCU_TDIS; EXT_EMU0; EXT_EMU1; EMU0; EMU1; EXT_TCK; RTCK-20_pin; TCK-20pin; PC0_TCK; PC0_TMS; PC0_TDO; PC0_TDI RST#; PC0_RST#; ENn; XDS110; Micro-B USB Connector RST#; RBIAS nWAKE; VCC3V3_XDS PK5 PK6 PK7; VCC3V3_XDS; VCC3V3_SYS; Inverter; JTAG_TCK; XDS_USB_DP; XDS_USB_VBUS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

D-Note:
Please follow SK-AM62P-LP implementations for latest updates on XDS110

330k 220k Voltage Sense VERFA+

Refer below figure for
clock

BLOCK DIAGRAM XDS110 DEBUGGER

## Test Automation Header

## USB Type-A

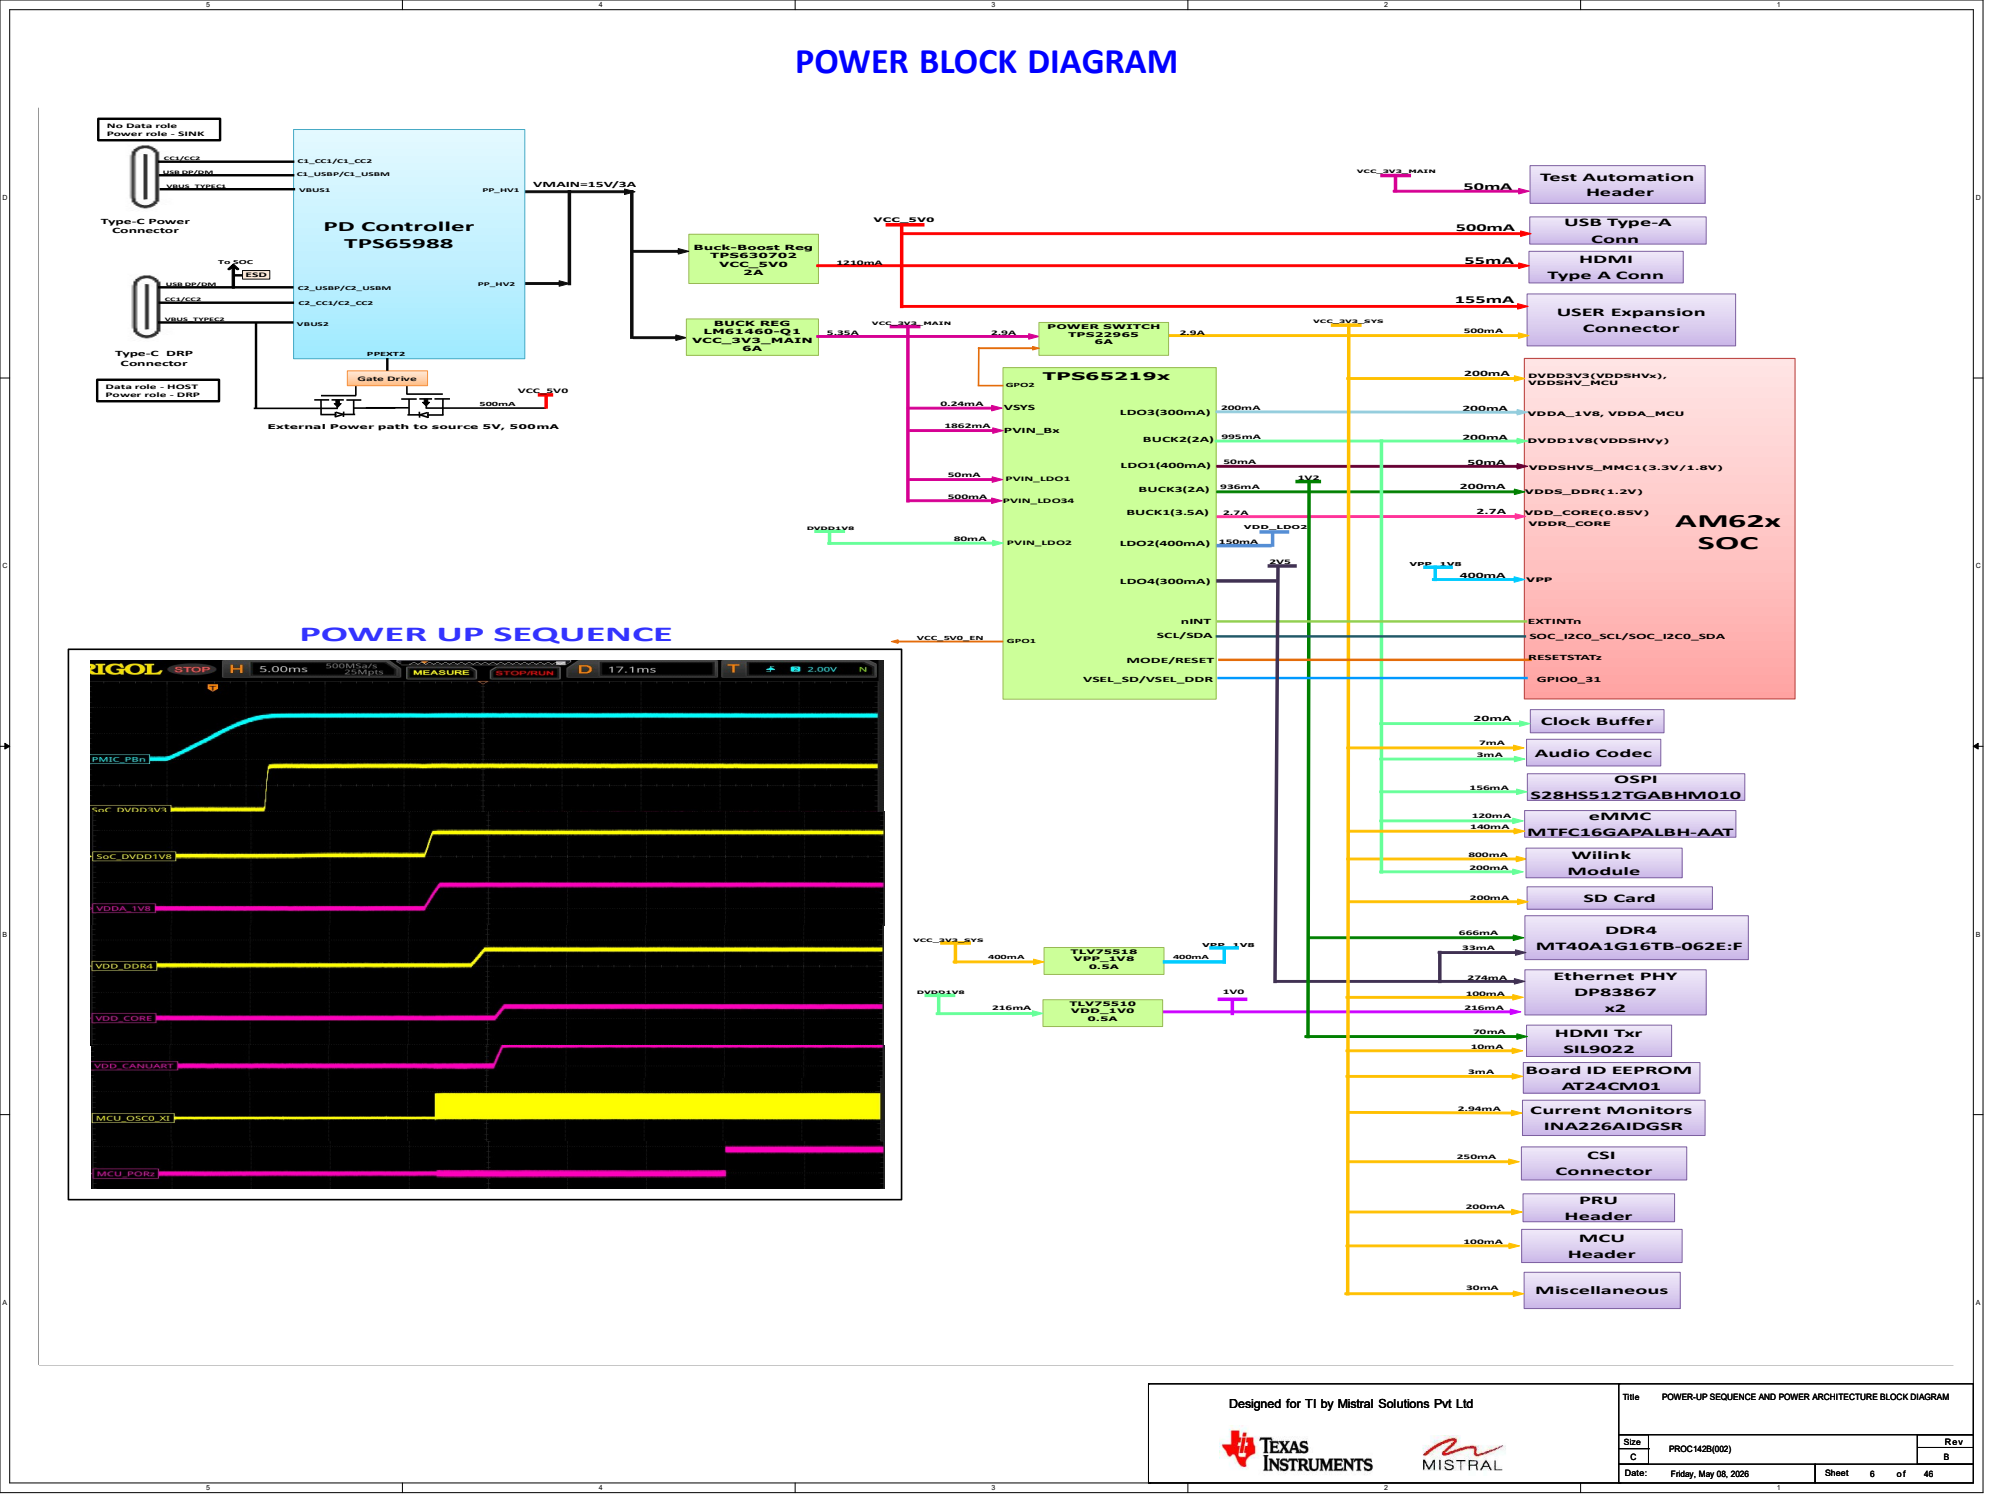
[picture p11: page 6]
Header MCU; Header; VDDR_CORE VPP VDDSHV5_MMC1(3.3V/1.8V) AM62x; SOC; Ethernet PHY DP83867; x2 HDMI Txr SIL9022; DVDD1V8(VDDSHVy) VDDA_1V8, VDDA_MCU 200mA; VSYS PVIN_Bx PVIN_LDO1; BUCK1(3.5A) BUCK2(2A) BUCK3(2A) LDO1(400mA) LDO2(400mA) LDO3(300mA) LDO4(300mA) ⁵⁰mA Buck-Boost Reg; TPS630702 VCC_5V0; C2_USBP/C2_USBM; To SOC; PP_HV1 USB DP/DM; PP_HV2 USB DP/DM; ESD; BUCK REG; LM61460-Q1 VCC_3V3_MAIN; TPS65219x; VMAIN=15V/3A; USER Expansion; Connector 155mA; 500mA VCC_5V0; Miscellaneous ³⁰mA; nINT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

POWER BLOCK DIAGRAM

No Data role Power role - SINK Data role - HOST Power role - DRP
CC1/CC2 CC1/CC2 VBUS_TYPEC1 VBUS_TYPEC2
C1_CC1/C1_CC2 C2_CC1/C2_CC2 VBUS1 VBUS2
VOUT PD Controller TPS65988 C1_USBP/C1_USBM

Conn HDMI Type A Conn VDD_CORE(0.85V) VDDS_DDR(1.2V) DVDD3V3(VDDSHVx), VDDSHV_MCU

Type-C Power Connector Type-C DRP Connector

SCL/SDA MODE/RESET VSEL_SD/VSEL_DDR

Audio Codec Clock Buffer Wilink Module

eMMC MTFC16GAPALBH-AAT OSPI S28HS512TGABHM010

SD Card DDR4 MT40A1G16TB-062E:F CSI Connector PRU

Board ID EEPROM AT24CM01 Current Monitors INA226AIDGSR

POWER-UP SEQUENCE AND POWER ARCHITECTURE BLOCK DIAGRAM

1

### To Test Automation

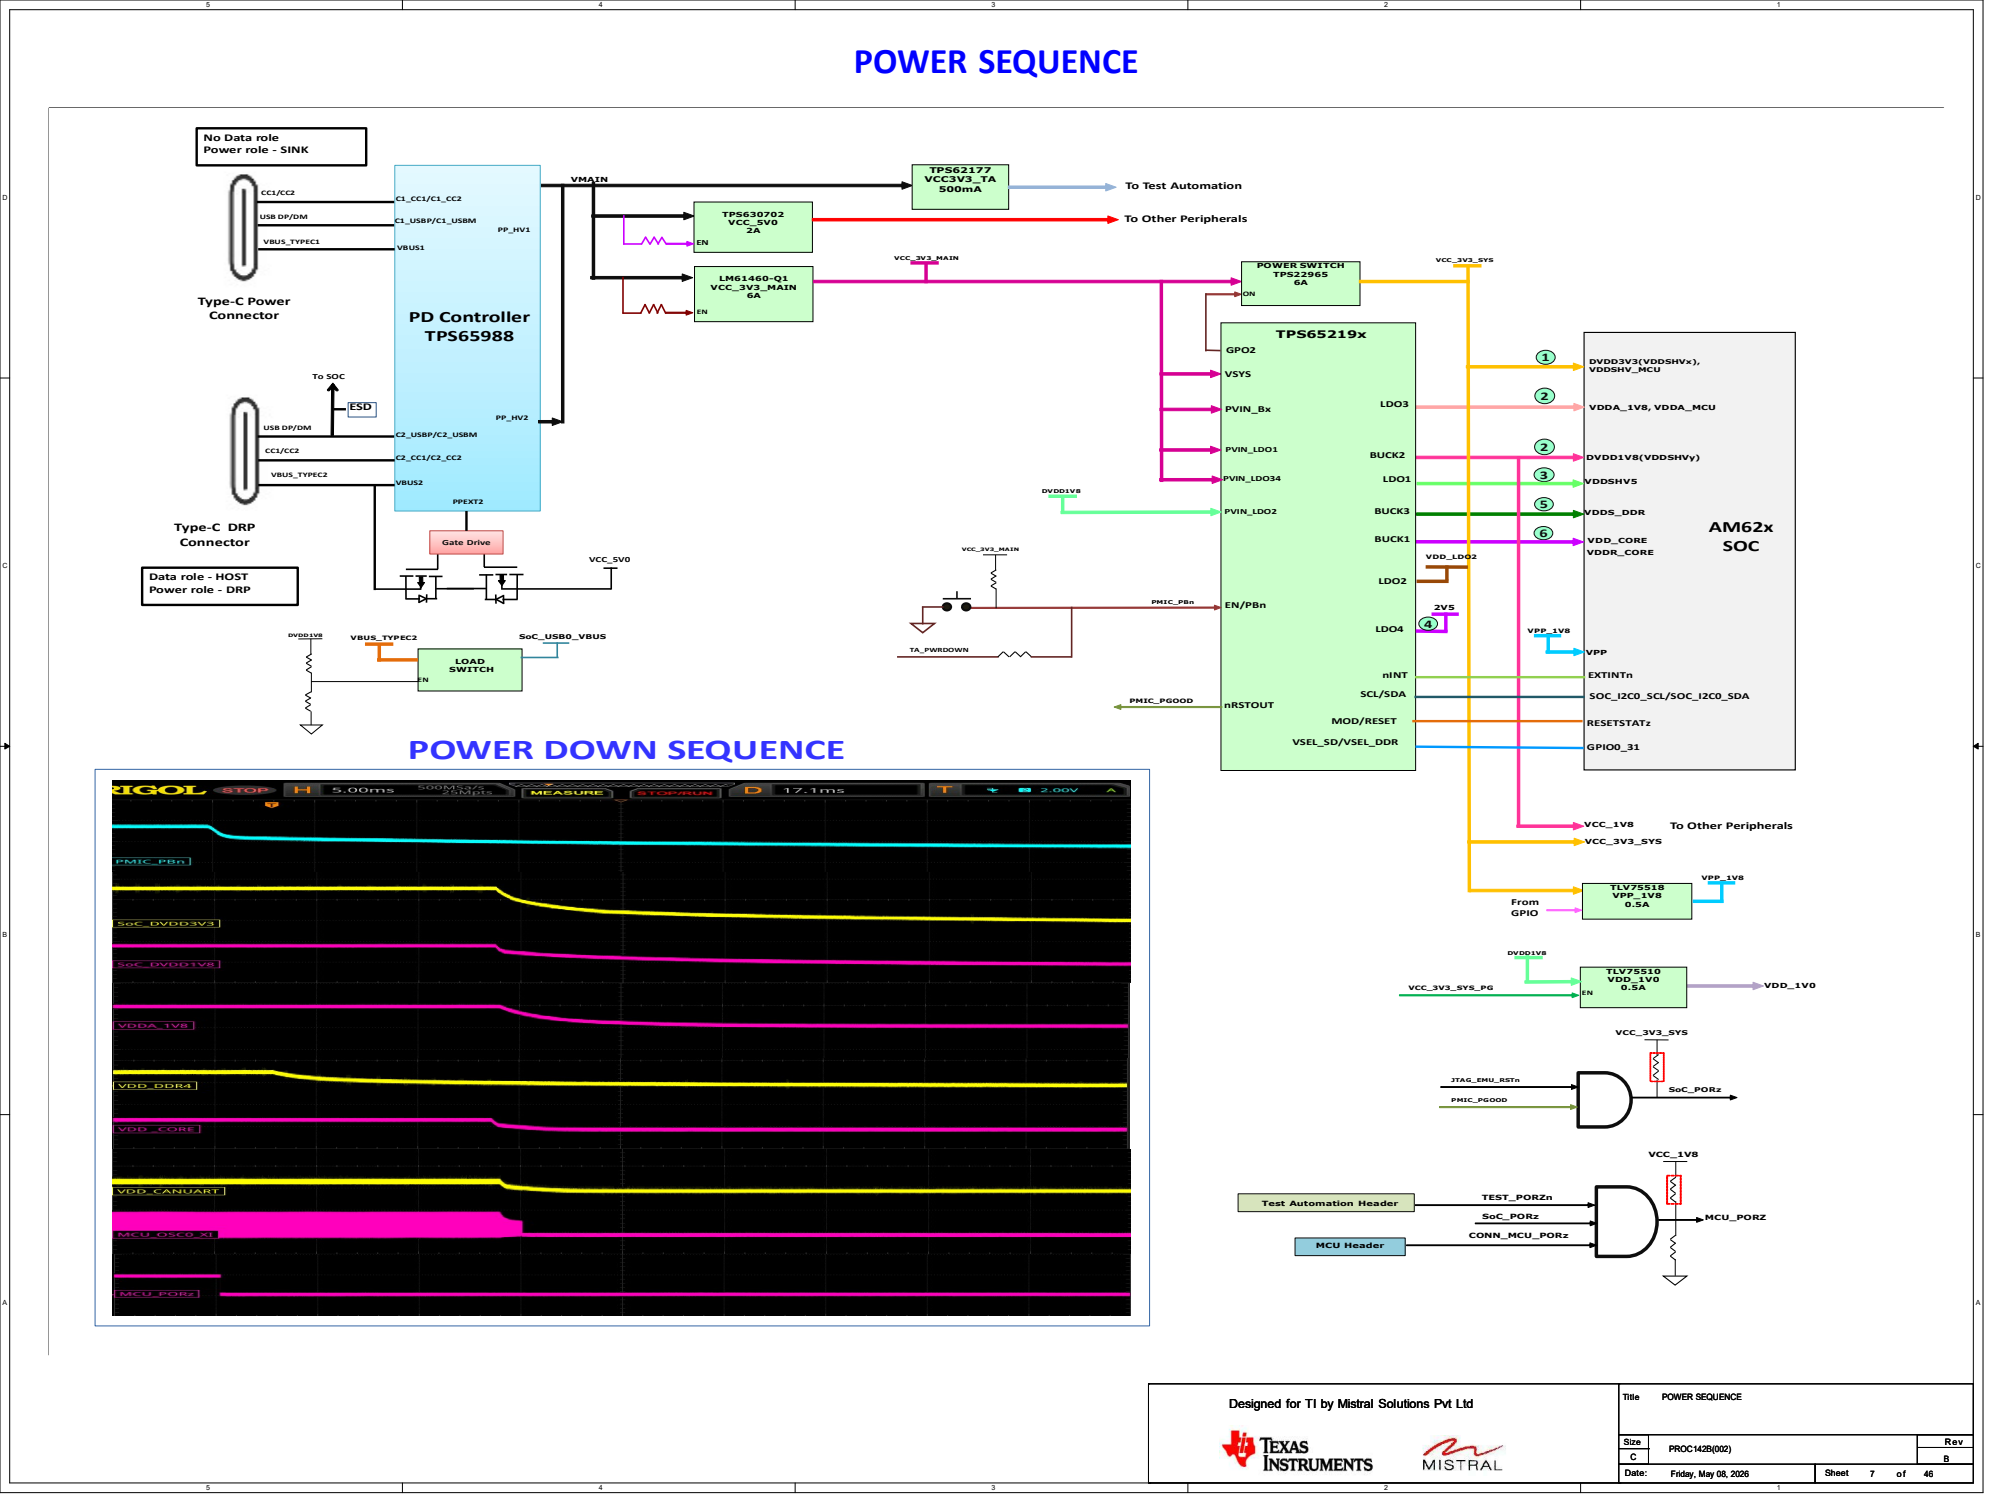
[picture p12: page 7]
TPS62177 VCC3V3_TA; VMAIN; DVDD3V3(VDDSHVx), VDDSHV_MCU; VPP; AM62x SOC VDD_CORE VDDS_DDR; VDDR_CORE DVDD1V8(VDDSHVy) VDDSHV5 VDDA_1V8, VDDA_MCU; VDD_1V0; MCU_PORZ; JTAG_EMU_RSTn; SoC_PORz VCC_3V3_SYS; SoC_PORz CONN_MCU_PORz TEST_PORZn; VCC_1V8; TLV75510 VDD_1V0; TPS630702 VCC_5V0; C2_USBP/C2_USBM; To SOC; PP_HV1 PP_HV2 USB DP/DM; ESD; Gate Drive; VCC_5V0 PPEXT2; PVIN_Bx; BUCK1 BUCK2 BUCK3; LDO1; LDO4; LDO3 TPS65219x; EN/PBn; nRSTOUT PMIC_PGOOD; PMIC_PGOOD; To Other Peripherals VCC_3V3_SYS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

No Data role Power role - SINK
CC1/CC2 CC1/CC2 VBUS_TYPEC1 VBUS_TYPEC2
C1_CC1/C1_CC2 C2_CC1/C2_CC2 VBUS1 VBUS2
PD Controller TPS65988 C1_USBP/C1_USBM
Type-C Power Connector Type-C DRP Connector

USB DP/DM

VSYS To Other Peripherals

VDD_LDO2 POWER DOWN SEQUENCE

Data role - HOST Power role - DRP

SCL/SDA MOD/RESET VSEL_SD/VSEL_DDR

Test Automation Header MCU Header

# Add 0x51 User Expansion Connector Add 0x50 PD Controller Add 0x38, 0x3F PRU

# I2C TREE

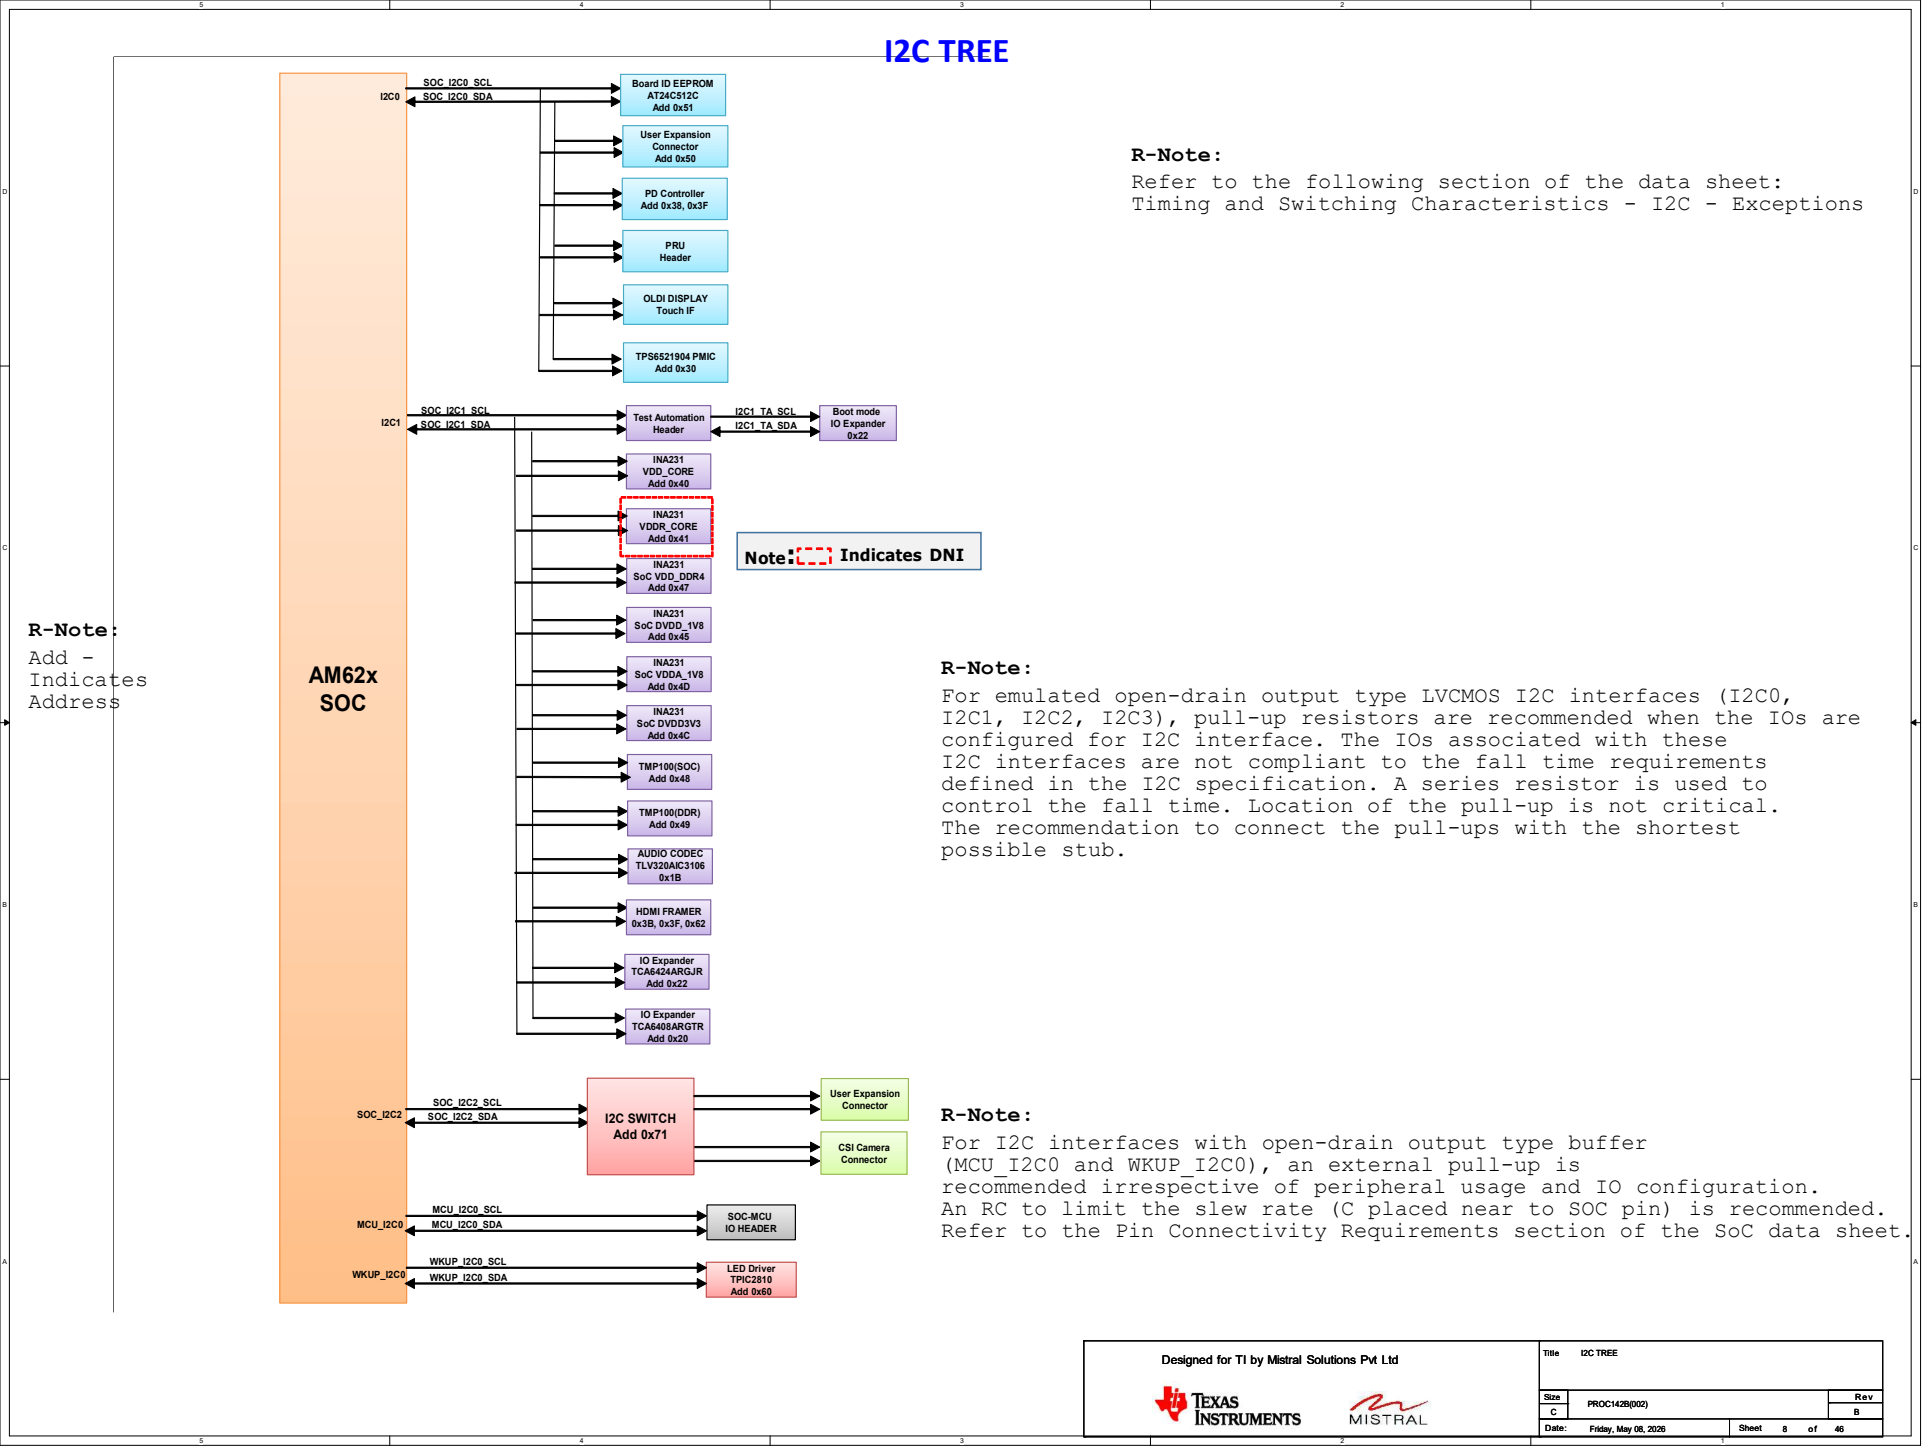
[picture p13: page 8]
AM62x SOC; SOC_I2C0_SCL SOC_I2C0_SDA; SOC_I2C1_SCL; SOC_I2C2_SCL; Test Automation Header; Boot mode; IO Expander 0x22 SOC_I2C1_SDA; I2C1_TA_SCL I2C1_TA_SDA I2C1; WKUP_I2C0; INA231 SoC VDD_DDR4 Add 0x47; INA231 SoC DVDD_1V8 Add 0x45; INA231 SoC VDDA_1V8 Add 0x4D; INA231 SoC DVDD3V3 Add 0x4C; SOC-MCU IO HEADER; AUDIO CODEC TLV320AIC3106 0x1B; HDMI FRAMER; LED Driver TPIC2810 Add 0x60 SOC_I2C2; SOC_I2C2_SDA MCU_I2C0; MCU_I2C0_SCL MCU_I2C0_SDA WKUP_I2C0_SCL WKUP_I2C0_SDA; Touch IF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

Board ID EEPROM

R-Note:
Refer to the following section of the data sheet:
Timing and Switching Characteristics - I2C - Exceptions

Header OLDI DISPLAY

TPS6521904 PMIC
Add 0x30
INA231 VDD_CORE Add 0x40 TMP100(SOC) Add 0x48 TMP100(DDR) Add 0x49

For emulated open-drain output type LVCMOS I2C interfaces (I2C0,
I2C1, I2C2, I2C3), pull-up resistors are recommended when the IOs are
configured for I2C interface. The IOs associated with these
I2C interfaces are not compliant to the fall time requirements
defined in the I2C specification. A series resistor is used to
control the fall time. Location of the pull-up is not critical.
The recommendation to connect the pull-ups with the shortest
possible stub.

User Expansion Connector CSI Camera Connector

For I2C interfaces with open-drain output type buffer
(MCU_I2C0 and WKUP_I2C0), an external pull-up is
recommended irrespective of peripheral usage and IO configuration.
An RC to limit the slew rate (C placed near to SOC pin) is recommended.
Refer to the Pin Connectivity Requirements section of the SoC data sheet.

D D

C C

B B

A A

## VOLTAGE CONNECTED ON SKEVM

## VOLTAGE DOMAIN ON SOC SIDE ACTIVE

STATE DEFAULT STATE DIRECTION WITH RESPECT TO CONTROL SL NO. | GPIO DESCRIPTION | GPIO NETNAME | Functionality | GPIO USED | SOC MUXED SIGNAL NAME 1 | Enable for WLAN Interface | SoC_WLAN_EN_1V8 | ENABLE | GPIO0_71 | MMC2_SDCD | OUTPUT | LOW | HIGH | VDDSHV6 | SoC_DVDD1V8
2 | WLAN Interrupt | SoC_WLAN_IRQ_1V8 | INTERRUPT | GPIO0_72 | MMC2_SDWP | INPUT | HIGH | LOW | VDDSHV6 | SoC_DVDD1V8
3 | Enable for BT Interface | BT_EN_SOC_3V3 | ENABLE | MCU_GPIO0_1 | MCU_SPI0_CS0 | OUTPUT | HIGH | LOW | VDDSHV_MCU | SoC_DVDD3V3 CPSW_RGMII_INTn/PRU_INTn | INTERRUPT | GPIO1_31 | EXTINTn | INPUT | HIGH | LOW | VDDSHV0 | SoC_DVDD3V3 CPSW Ethernet PHY Interrupt 4 | PRU Connector Interrupt PMIC_INTn
5 | OSPI Reset Control GPIO | GPIO_OSPI_RSTn | RESET | GPIO0_12 | OSPI0_CSn1 | OUTPUT | HIGH | LOW | VDDSHV1 | SoC_DVDD1V8
6 | OSPI Interrupt | OSPI_INTn | INTERRUPT | GPIO0_13 | OSPI0_CSn2 | INPUT | HIGH | LOW | VDDSHV1 | SoC_DVDD1V8
7 | SD Card IO Voltage Select | VSEL_SD | INTERRUPT ENABLE | MCU_GPIO0_15 GPIO0_31 | MCU_MCAN1_TX GPMC0_CLK | OUTPUT INPUT | HIGH LOW | HIGH LOW | VDDSHV_CANUART VDDSHV3 | SoC_DVDD3V3 MCU_GPIO0_15 SoC_DVDD3V3
8 IO Expander Interrupt TEST GPIO1 from Test Automation Connector/ User Interrupt Push Button 9
10 | User Test LED 1 | SOC_GPIO1_49 | GPIO | GPIO1_49 | MMC1_SDWP | OUTPUT | LOW | HIGH | VDDSHV0 | SoC_DVDD3V3

## IO EXPANDER - 01

1 | CPSW Ethernet PHY-2 Reset Control GPIO | GPIO_CPSW2_RST | RESET | IO EXPANDER - P01 | OUTPUT | HIGH | LOW | VDDSHV0 | SoC_DVDD3V3
2 | CPSW Ethernet PHY-1 Reset Control GPIO | GPIO_CPSW1_RST | RESET | IO EXPANDER - P01 | OUTPUT | HIGH | LOW | VDDSHV0 | SoC_DVDD3V3
3 | PRU Board Detection | PRU_DETECT | DETECTION | IO EXPANDER - P02 | INPUT | HIGH | LOW | VDDSHV0 | SoC_DVDD3V3
4 | SD Card Load Switch Enable | MMC1_SD_EN | ENABLE | IO EXPANDER -P03 | OUTPUT | HIGH | LOW | VDDSHV0 | SoC_DVDD3V3 VPP_LDO_EN | ENABLE | IO EXPANDER - P04 | OUTPUT | LOW | HIGH | VDDSHV0 | SoC_DVDD3V3 SOC eFuse Voltage(VPP=1.8V) Regulator Enable 5
6 | EXP CONN 3.3V Power Switch Enable | EXP_PS_3V3_EN | ENABLE | IO EXPANDER - P05 | OUTPUT | LOW | HIGH | VDDSHV0 | SoC_DVDD3V3
7 | EXP CONN 5V Power Switch Enable | EXP_PS_5V0_EN | ENABLE | IO EXPANDER - P06 | OUTPUT | LOW | HIGH | VDDSHV0 | SoC_DVDD3V3
8 | EXP CONN HAT Board Detection | RPI_HAT_DETECT | DETECTION | IO EXPANDER - P07 | INPUT | HIGH | LOW | VDDSHV0 | SoC_DVDD3V3
9 | M.2 Connector Alert | WLAN_ALERT_3V3 | ALERT | IO EXPANDER – P10 | OUTPUT | HIGH | LOW | VDDSHV0 | SoC_DVDD3V3
10 | M.2 Connector WAKEUP | BT_UART_WAKE_SOC_3V3 | WAKEUP | IO EXPANDER – P11 | OUTPUT | HIGH | LOW | VDDSHV0 | SoC_DVDD3V3
11 | SOC UART1 Mux Select | UART1_MUX_SEL | SELECT | IO EXPANDER - P12 | OUTPUT | LOW | HIGH | VDDSHV0 | SoC_DVDD3V3
12 | Enable for Wilink Level Translators | WL_LT_EN | ENABLE | IO EXPANDER - P13 | OUTPUT | LOW | HIGH | VDDSHV0 | SoC_DVDD3V3
13 | HDMI Transmitter Reset Control GPIO | GPIO_HDMI_RSTn | RESET | IO EXPANDER - P14 | OUTPUT | HIGH | LOW | VDDSHV0 | SoC_DVDD3V3
14 | Raspberry Pi Camera CSI0 GPIO1 | CSI_GPIO1 | INPUT/OUTPUT | IO EXPANDER - P15 | NA | NA | NA | VDDSHV0 | SoC_DVDD3V3
15 | Raspberry Pi Camera CSI0 GPIO2 | CSI_GPIO2 | INPUT/OUTPUT | IO EXPANDER - P16 | NA | NA | NA | VDDSHV0 | SoC_DVDD3V3
16 | PRU Power Switch Enable | PRU_3V3_EN | ENABLE | IO EXPANDER - P17 | OUTPUT | LOW | HIGH | VDDSHV0 | SoC_DVDD3V3
17 | HDMI Interrupt | HDMI_INTn | INTERRUPT | IO EXPANDER - P20 | INPUT | HIGH | LOW | VDDSHV0 | SoC_DVDD3V3
| | AUD_BUF_EN | ENABLE | IO EXPANDER - P21 IO EXPANDER - P22 | OUTPUT INPUT | HIGH LOW | HIGH LOW | VDDSHV0 VDDSHV0 | SoC_DVDD3V3 GPIO for communications with AM62x TEST_GPIO2 TEST GPIO2 from Test Automation Connector 18 SoC_DVDD3V3 MCASP2 Enable and Direction Control 19
20 | | WL_BUF_EN | ENABLE | IO EXPANDER - P23 | OUTPUT | HIGH | LOW | VDDSHV0 | SoC_DVDD3V3
21 | | AUD_BUF_CLK_DIR | DIRECTION CONTROL | IO EXPANDER - P24 | OUTPUT | HIGH | LOW | VDDSHV0 | SoC_DVDD3V3
22 | | WL_BUF_CLK_DIR | DIRECTION CONTROL | IO EXPANDER - P25 | OUTPUT | HIGH | LOW | VDDSHV0 | SoC_DVDD3V3
23 | OLDI Display Touch Interrupt | TS_INT# | INTERRUPT | IO EXPANDER - P26 | INPUT | HIGH | LOW | VDDSHV0 | SoC_DVDD3V3
24 | User Test LED 2 | IO_EXP_TEST_LED | GPIO | IO EXPANDER - P27 | OUTPUT | LOW | HIGH | VDDSHV0 | SoC_DVDD3V3

## IO EXPANDER - 02

1 | M.2 Connector SDIO Reset Control GPIO | WLAN_SDIO_RST_3V3 | RESET | IO EXPANDER – P0 | INPUT | HIGH | LOW | VDDSHV0 | SoC_DVDD3V3
2 | OLDI Display Reset control | GPIO_TS_RSTn | RESET | IO EXPANDER – P1 | INPUT | HIGH | LOW | VDDSHV0 | SoC_DVDD3V3
3 | Audio Codec Reset Control GPIO | GPIO_AUD_RSTn | DETECTION | IO EXPANDER – P2 | INPUT | HIGH | LOW | VDDSHV0 | SoC_DVDD3V3
4 | eMMC Reset control GPIO | GPIO_eMMC_RSTn | RESET | IO EXPANDER – P3 | OUTPUT | HIGH | LOW | VDDSHV0 | SoC_DVDD3V3

# GPIO MAPPING TABLE

Title
Designed for TI by Mistral Solutions Pvt Ltd | B GPIO MAPPING TABLE C
Friday, May 08, 2026 | 9 | 46 PROC142B(002)

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

# USB TYPE-C PD CONTROLLER AND POWER SUPPLY

## Silk: TYPE-C PWR

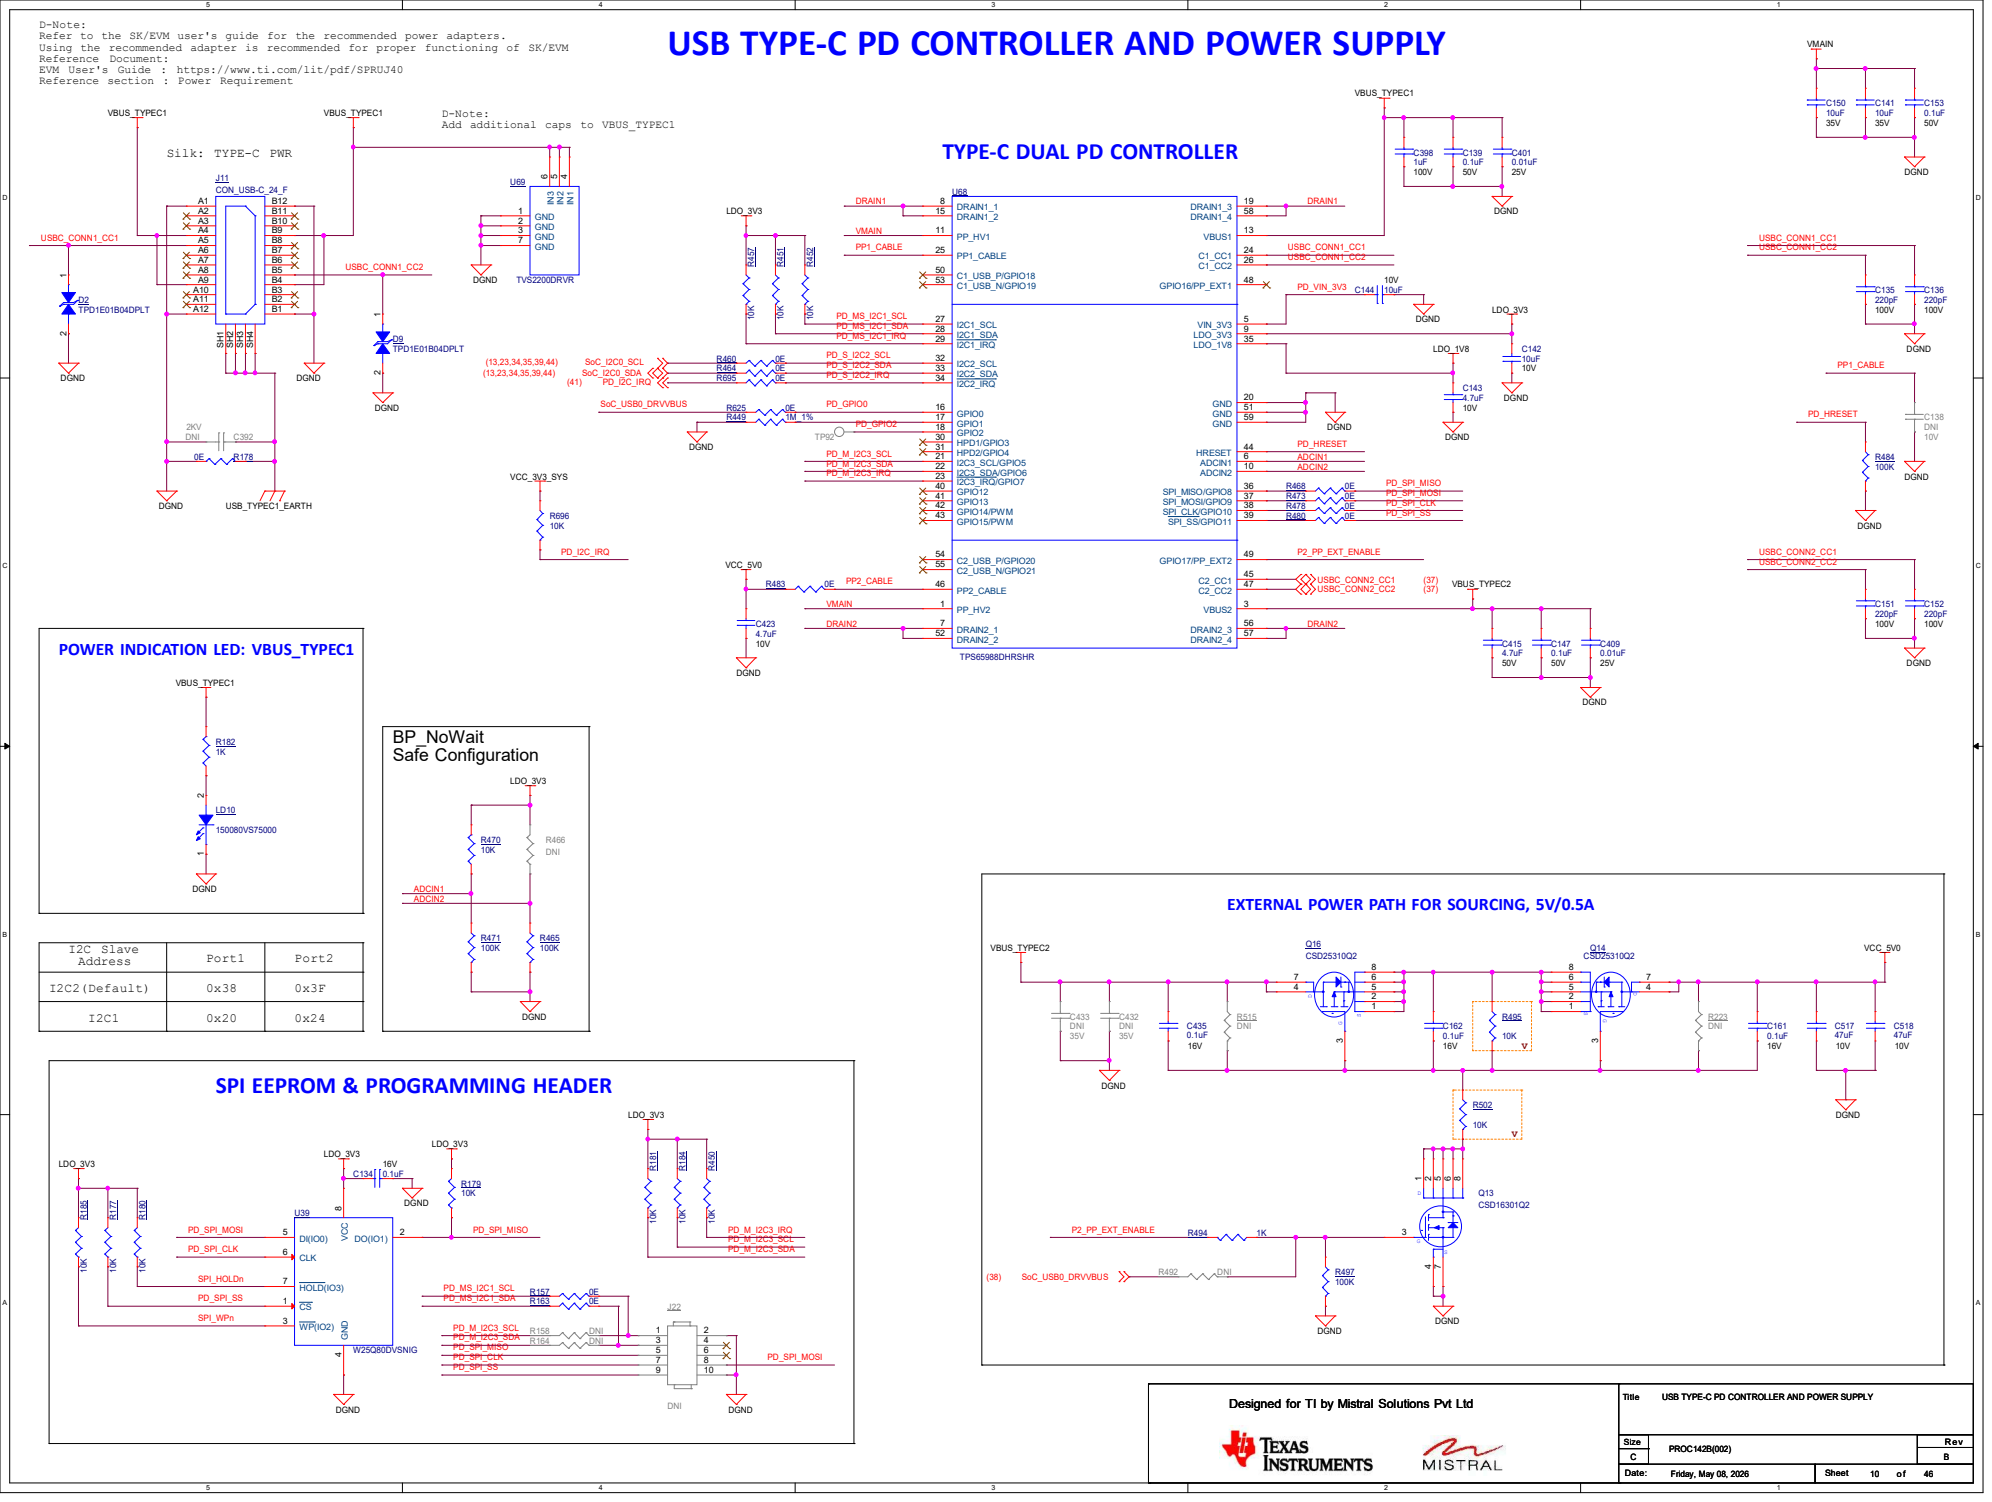
[picture p14: page 10]

D-Note:
Refer to the SK/EVM user's guide for the recommended power adapters.
Using the recommended adapter is recommended for proper functioning of SK/EVM
Reference Document:
EVM User's Guide : https://www.ti.com/lit/pdf/SPRUJ40
Reference section : Power Requirement

Add additional caps to VBUS_TYPEC1

TYPE-C DUAL PD CONTROLLER

6 GND 1 GND 2 GND 3 GND 7 R625 0E
U69TVS2200DRVRIN¹

EXTERNAL POWER PATH FOR SOURCING, 5V/0.5A

I2C Slave Address | Port1 | Port2

I2C2(Default) | 0x38 | 0x3F

SPI EEPROM & PROGRAMMING HEADER

4 DO(IO1) 2 DI(IO0) 5 CS 1 WP(IO2) 3 CLK 6 HOLD(IO3) 7 C134 0.1uF

# PERIPHERAL POWER SUPPLIES - 1

### D-Note:

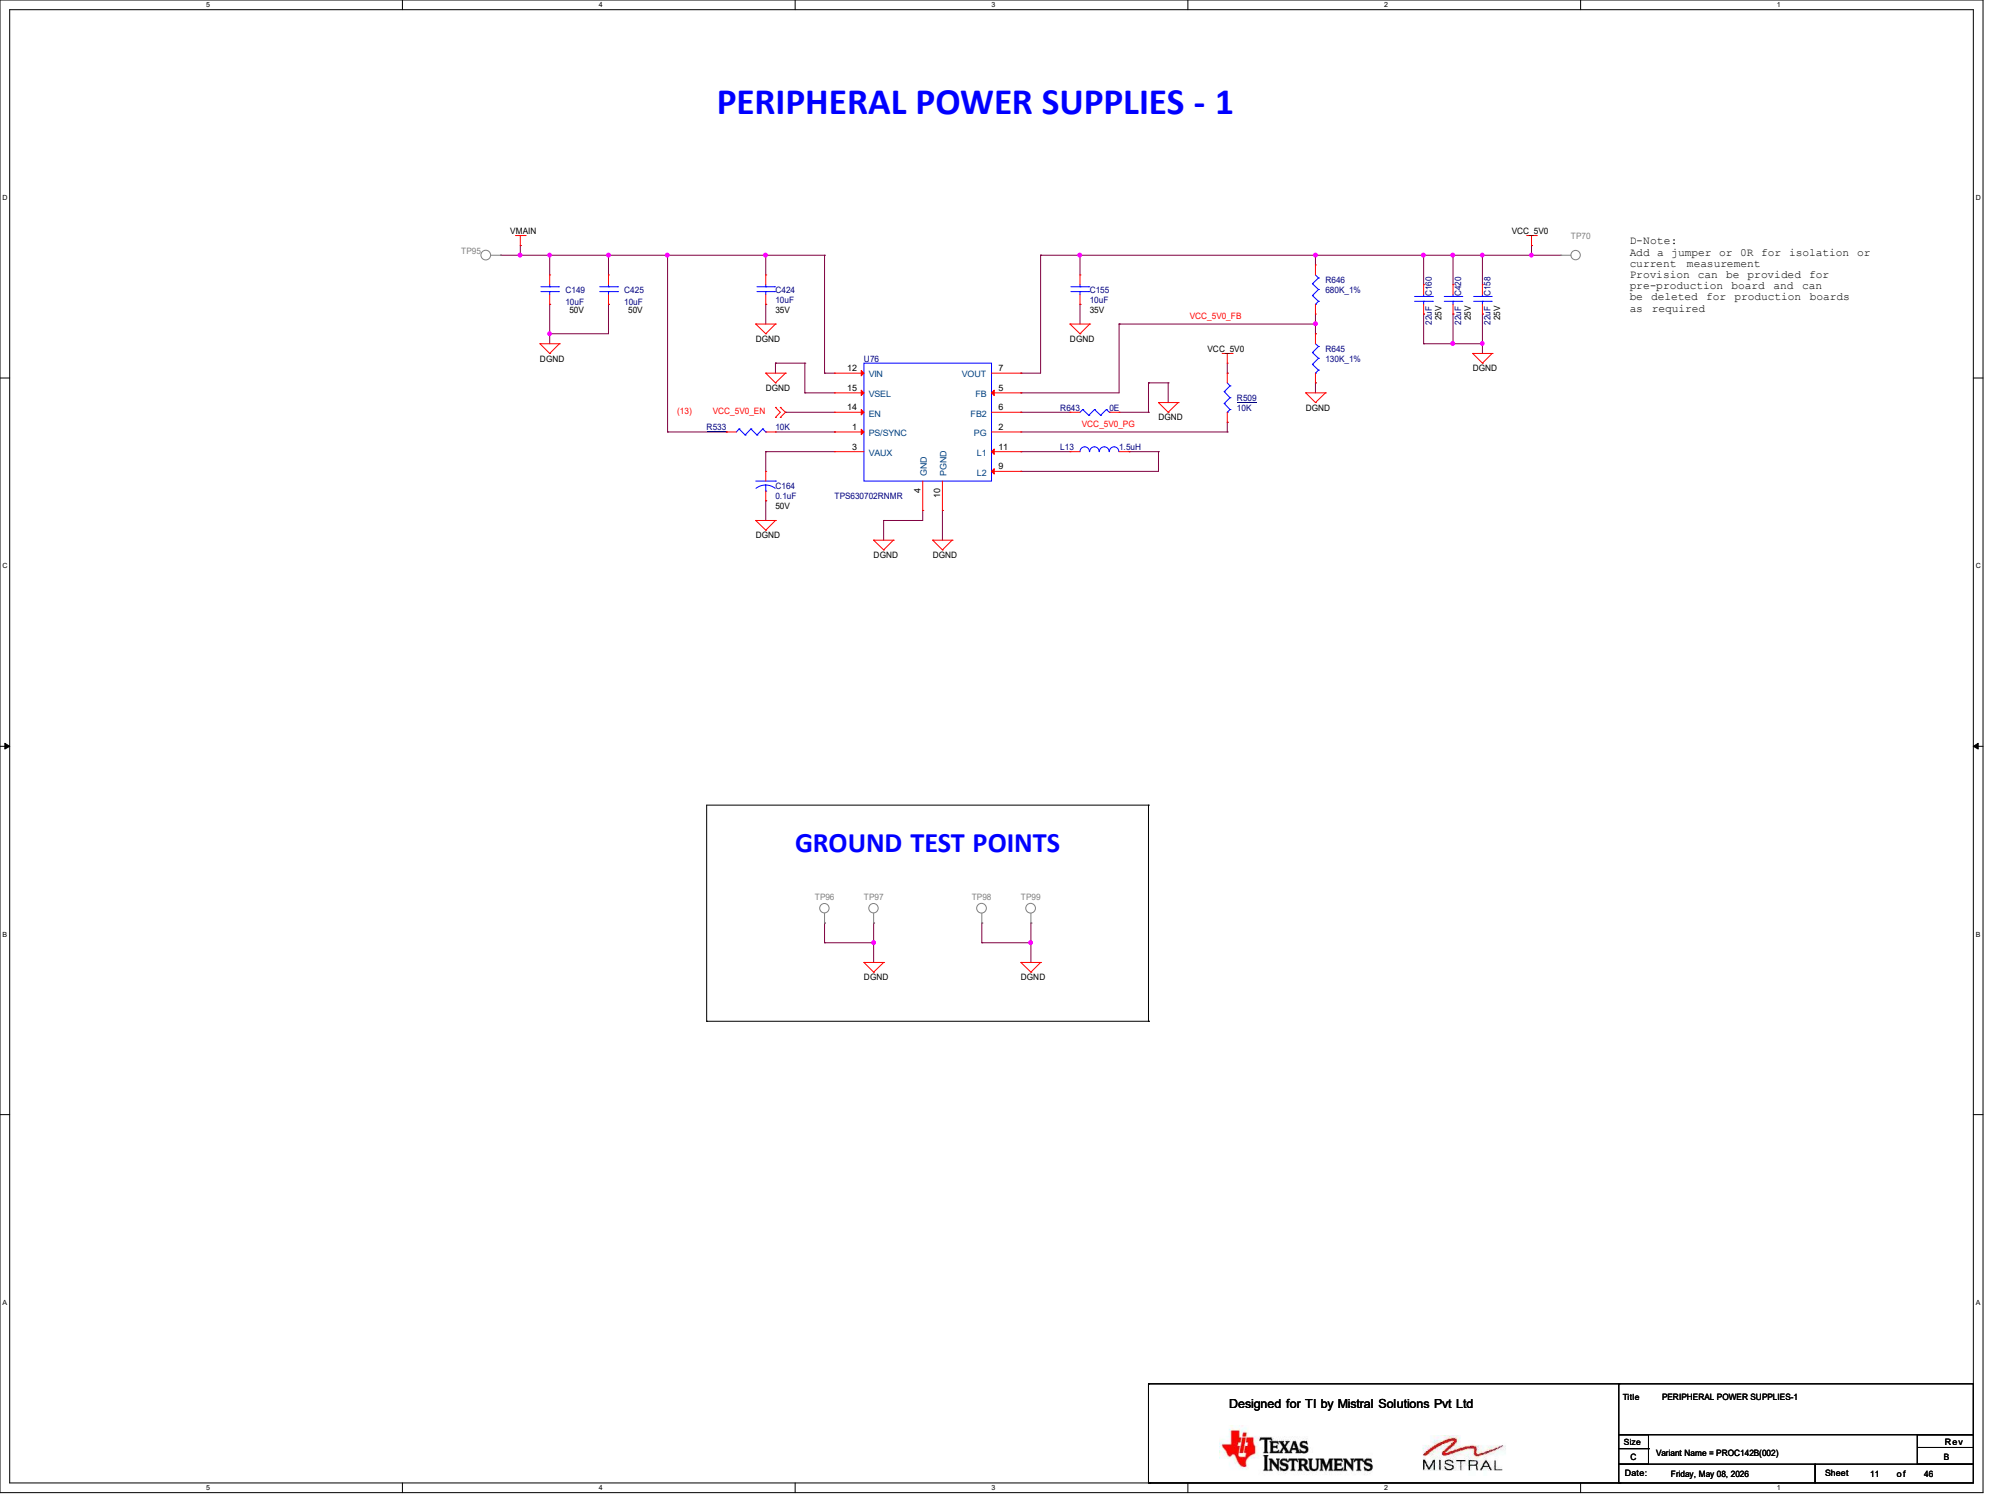
[picture p15: page 11]

Add a jumper or 0R for isolation or
current measurement
Provision can be provided for
pre-production board and can
be deleted for production boards

4 FB 5 FB2 6 VOUT 7 PGND 10 VIN 12 EN 14 VSEL 15

# 3.3V, 6.0 AMPS SUPPLY

# PERIPHERAL POWER SUPPLIES - 2

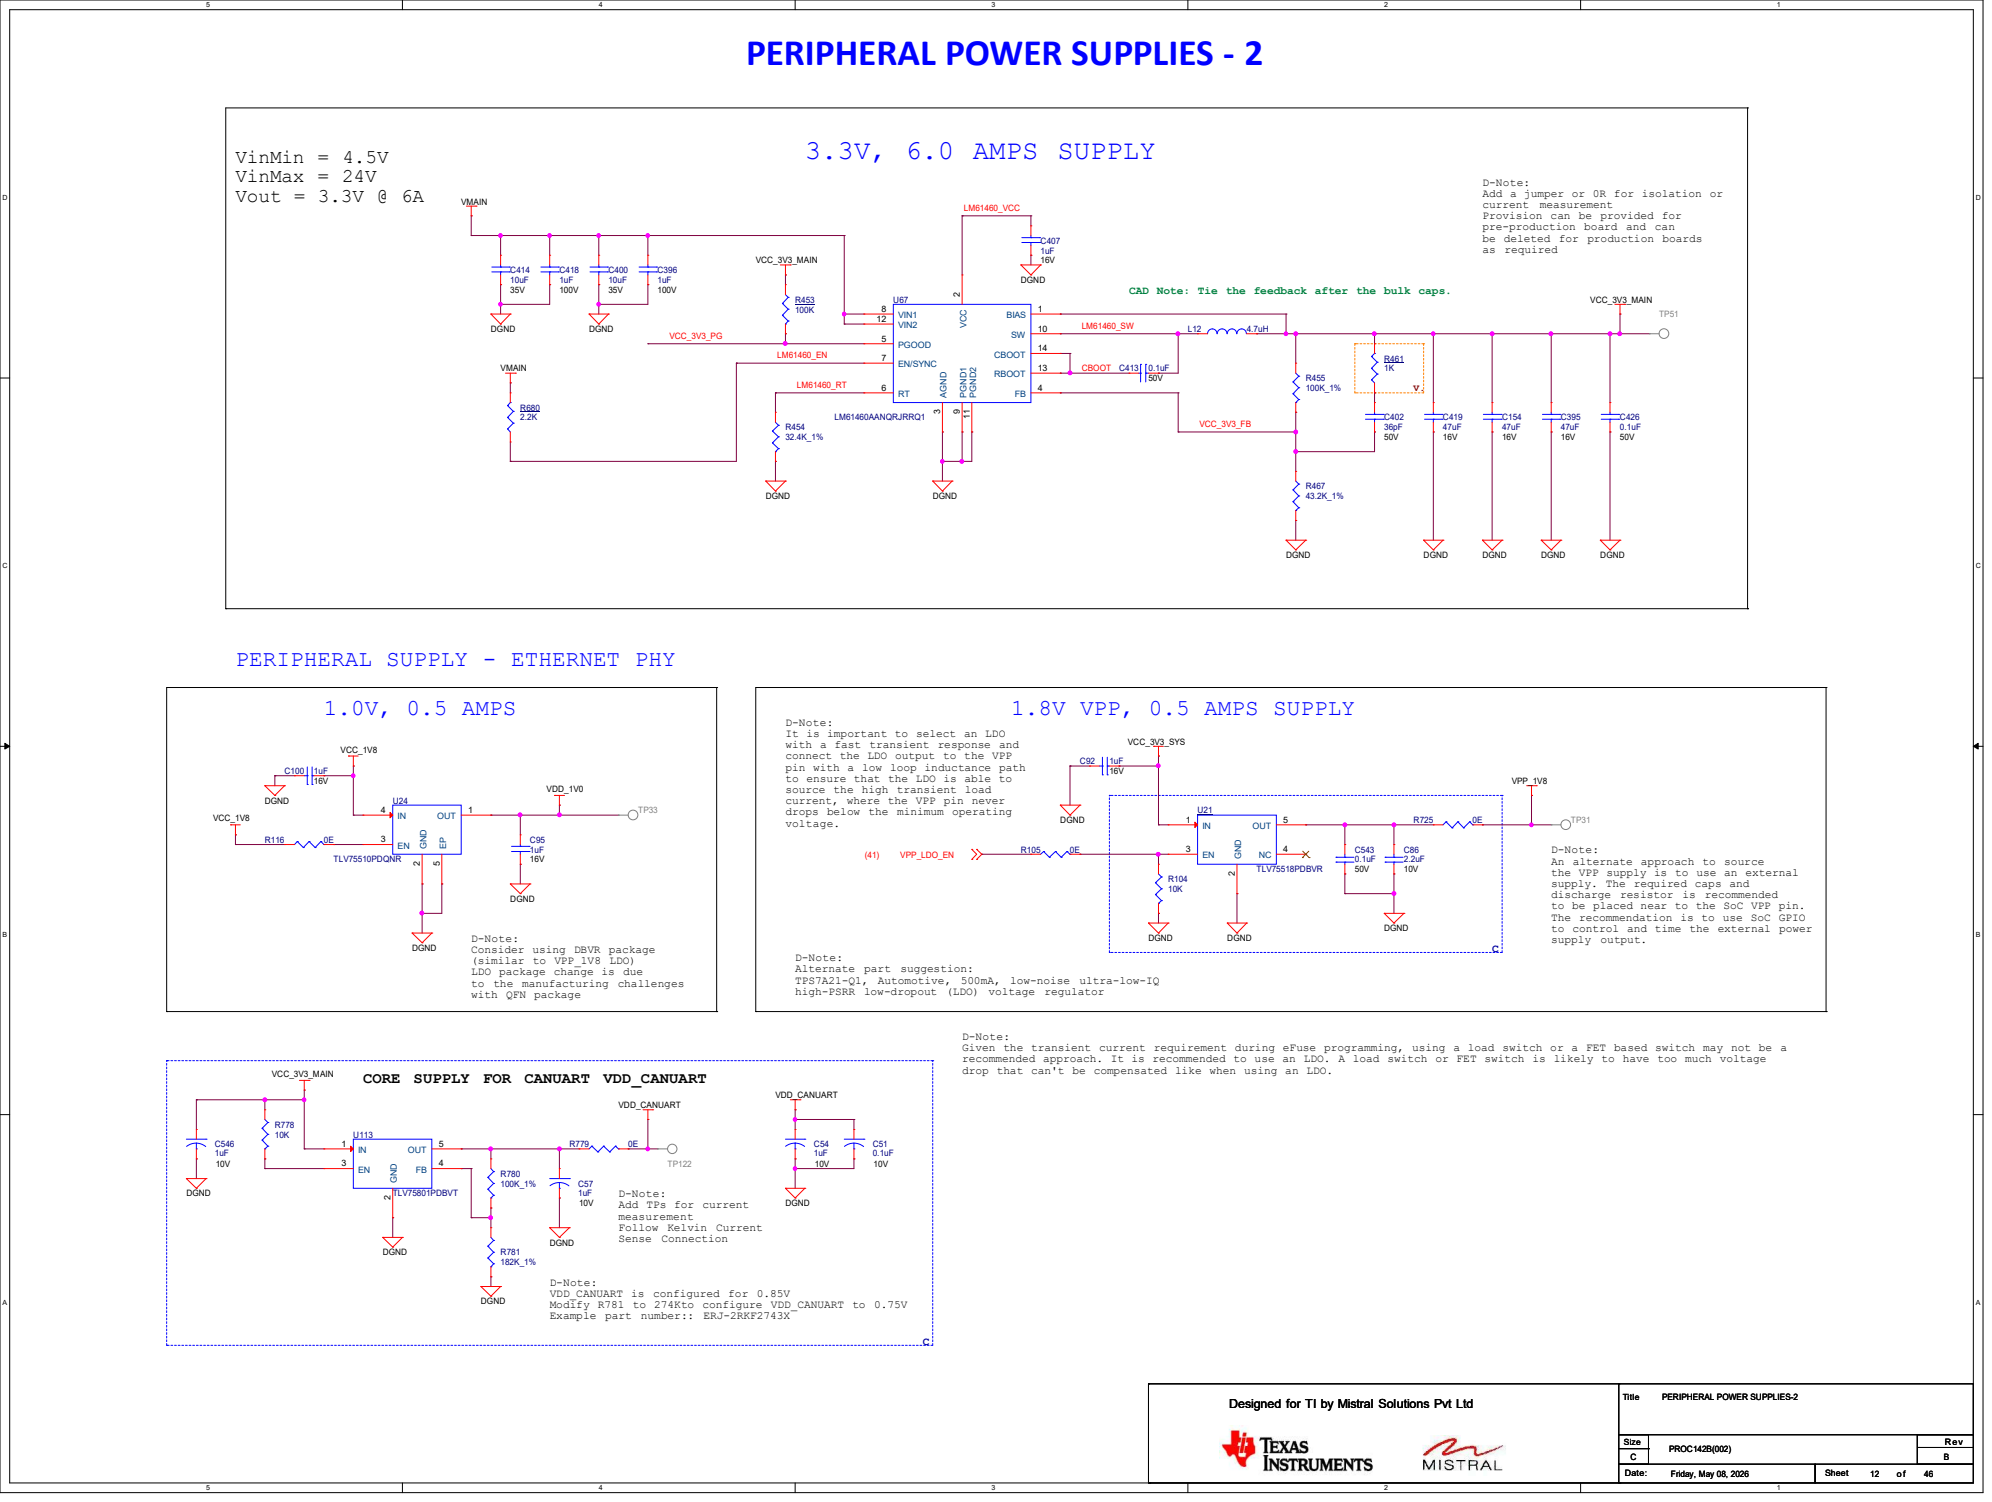
[picture p16: page 12]

D-Note:
Add a jumper or 0R for isolation or
current measurement
Provision can be provided for
pre-production board and can
be deleted for production boards
as required

CAD Note: Tie the feedback after the bulk caps.

3 FB 4 PGOOD 5 RT 6 EN/SYNC 7 VIN1 8 PGND1

PERIPHERAL SUPPLY - ETHERNET PHY

It is important to select an LDO
with a fast transient response and
connect the LDO output to the VPP
pin with a low loop inductance path
to ensure that the LDO is able to
source the high transient load
current, where the VPP pin never
drops below the minimum operating
voltage.

An alternate approach to source
the VPP supply is to use an external
supply. The required caps and
discharge resistor is recommended
to be placed near to the SoC VPP pin.
The recommendation is to use SoC GPIO
to control and time the external power
supply output.

Consider using DBVR package
(similar to VPP_1V8 LDO)
LDO package change is due
to the manufacturing challenges
with QFN package

Alternate part suggestion:
TPS7A21-Q1, Automotive, 500mA, low-noise ultra-low-IQ
high-PSRR low-dropout (LDO) voltage regulator

Given the transient current requirement during eFuse programming, using a load switch or a FET based switch may not be a
recommended approach. It is recommended to use an LDO. A load switch or FET switch is likely to have too much voltage
drop that can't be compensated like when using an LDO.

CORE SUPPLY FOR CANUART VDD_CANUART

Add TPs for current
measurement
Follow Kelvin Current
Sense Connection

VDD_CANUART is configured for 0.85V
Modify R781 to 274Kto configure VDD_CANUART to 0.75V
Example part number:: ERJ-2RKF2743X

# SOC POWER ARCHITECTURE - PMIC TPS6521904 PMIC

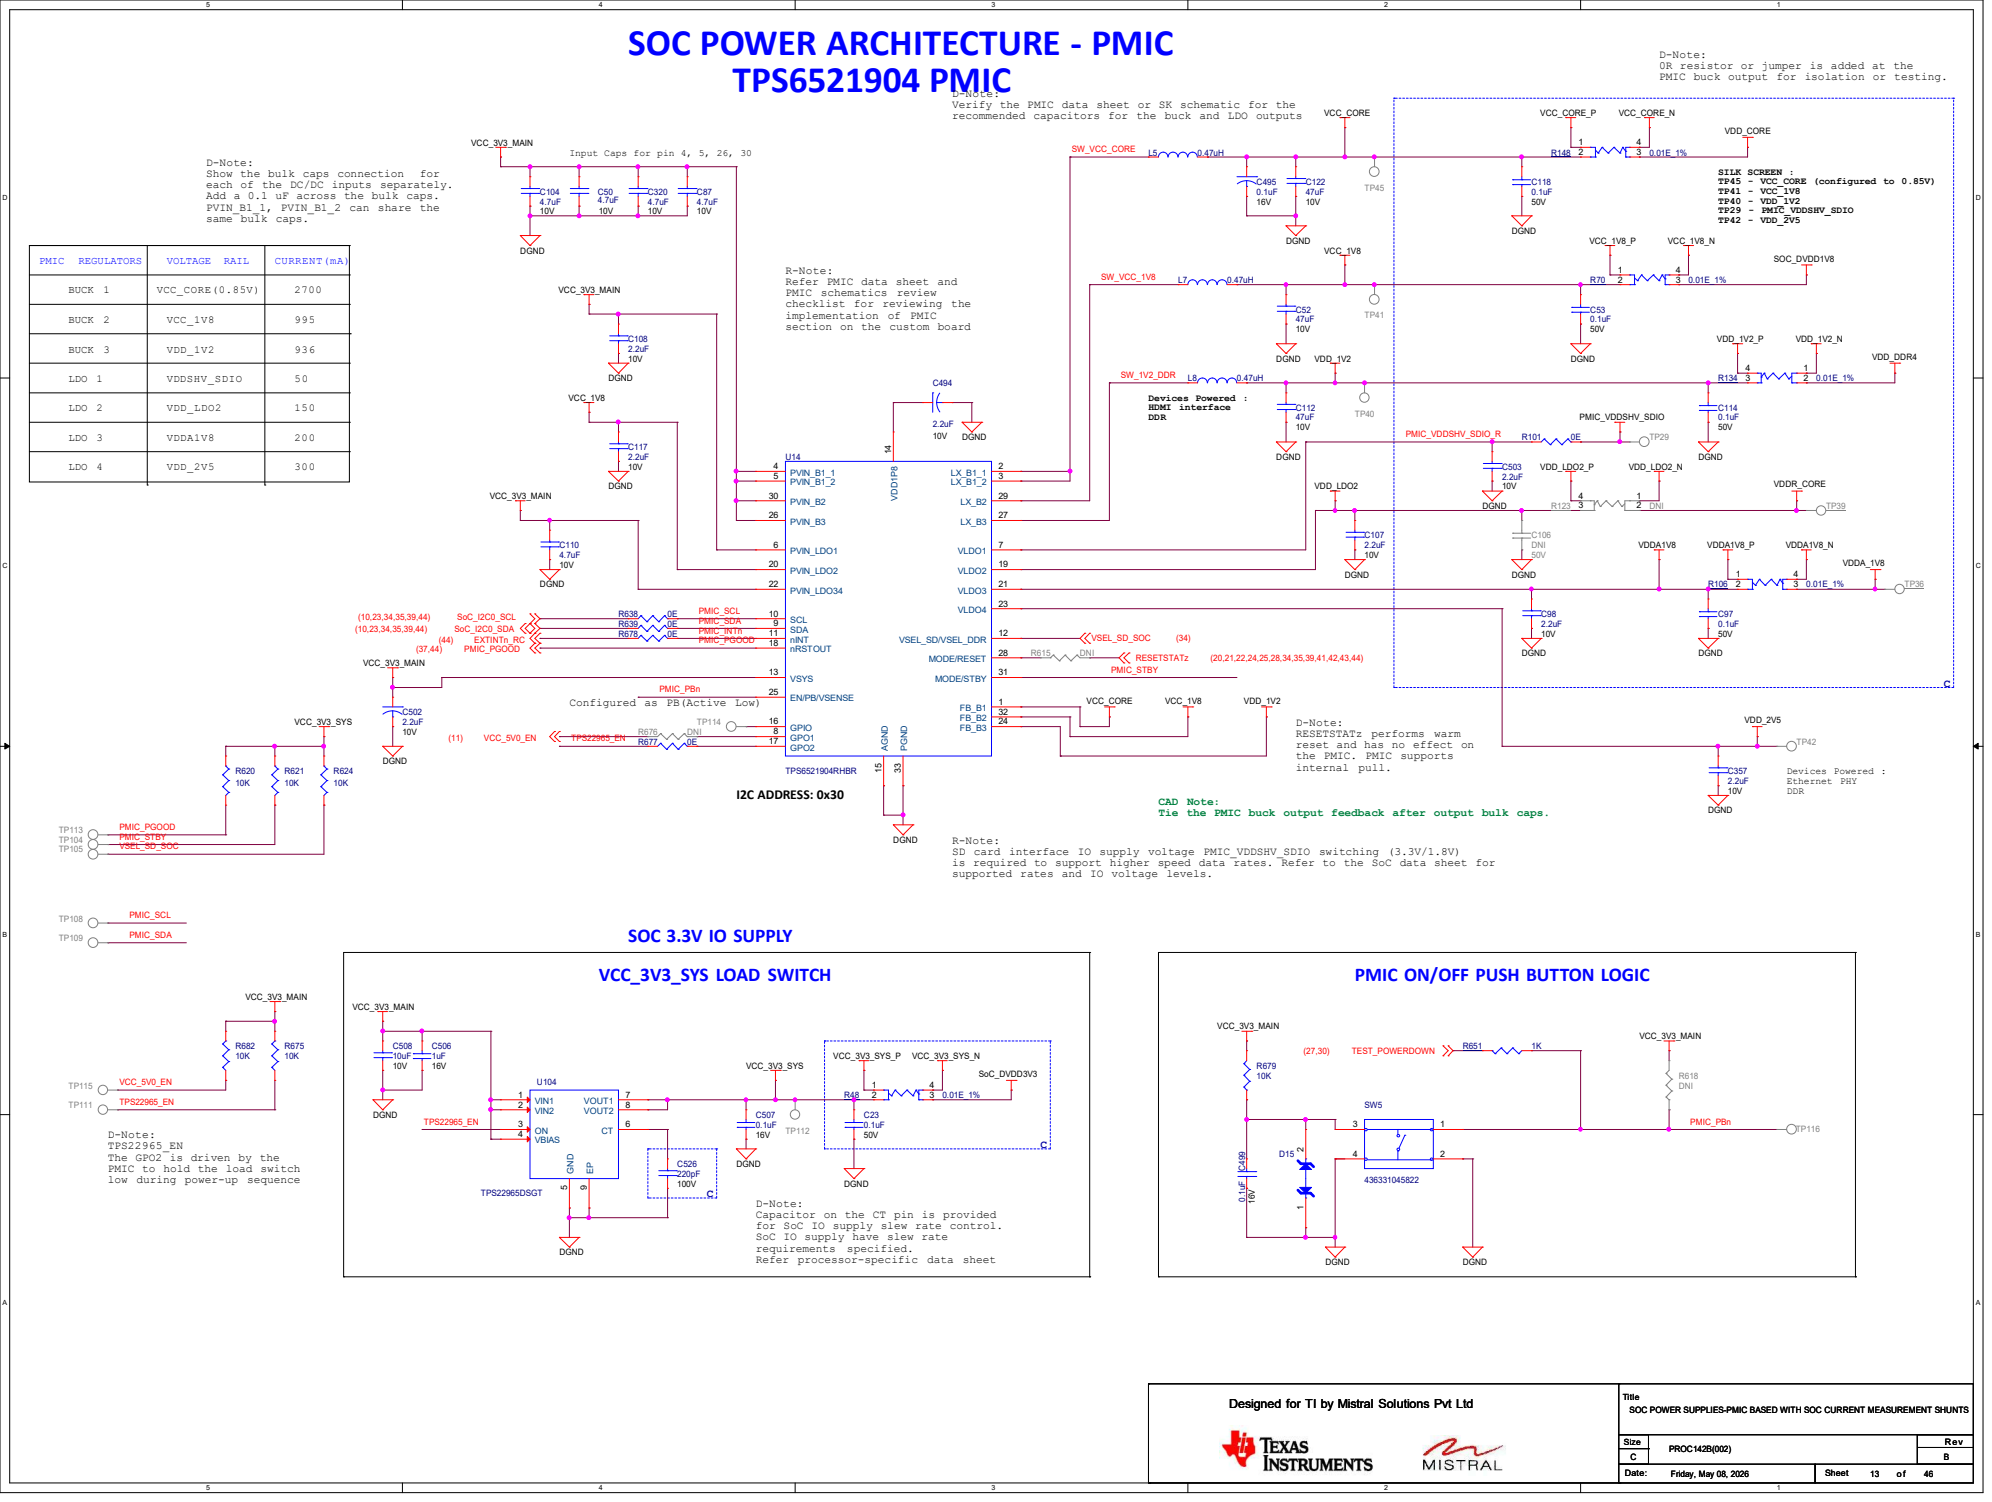
[picture p17: page 13]

D-Note:
0R resistor or jumper is added at the
PMIC buck output for isolation or testing.

Verify the PMIC data sheet or SK schematic for the
recommended capacitors for the buck and LDO outputs

Input Caps for pin 4, 5, 26, 30

each of the DC/DC inputs separately.
Add a 0.1 uF across the bulk caps.
PVIN_B1_1, PVIN_B1_2 can share the
same bulk caps.

R-Note:
Refer PMIC data sheet and
PMIC schematics review
checklist for reviewing the
implementation of PMIC
section on the custom board

Configured as PB(Active Low)

RESETSTATz performs warm
reset and has no effect on
the PMIC. PMIC supports
internal pull.

CAD Note:
Tie the PMIC buck output feedback after output bulk caps.

SD card interface IO supply voltage PMIC_VDDSHV_SDIO switching (3.3V/1.8V)
is required to support higher speed data rates. Refer to the SoC data sheet for
supported rates and IO voltage levels.

PMIC ON/OFF PUSH BUTTON LOGIC

TPS22965_EN
The GPO2 is driven by the
PMIC to hold the load switch
low during power-up sequence

Capacitor on the CT pin is provided
for SoC IO supply slew rate control.
SoC IO supply have slew rate
requirements specified.
Refer processor-specific data sheet

Title
SOC POWER SUPPLIES-PMIC BASED WITH SOC CURRENT MEASUREMENT SHUNTS C

# CURRENT MEASUREMENT DEVICES

# VDD_CORE

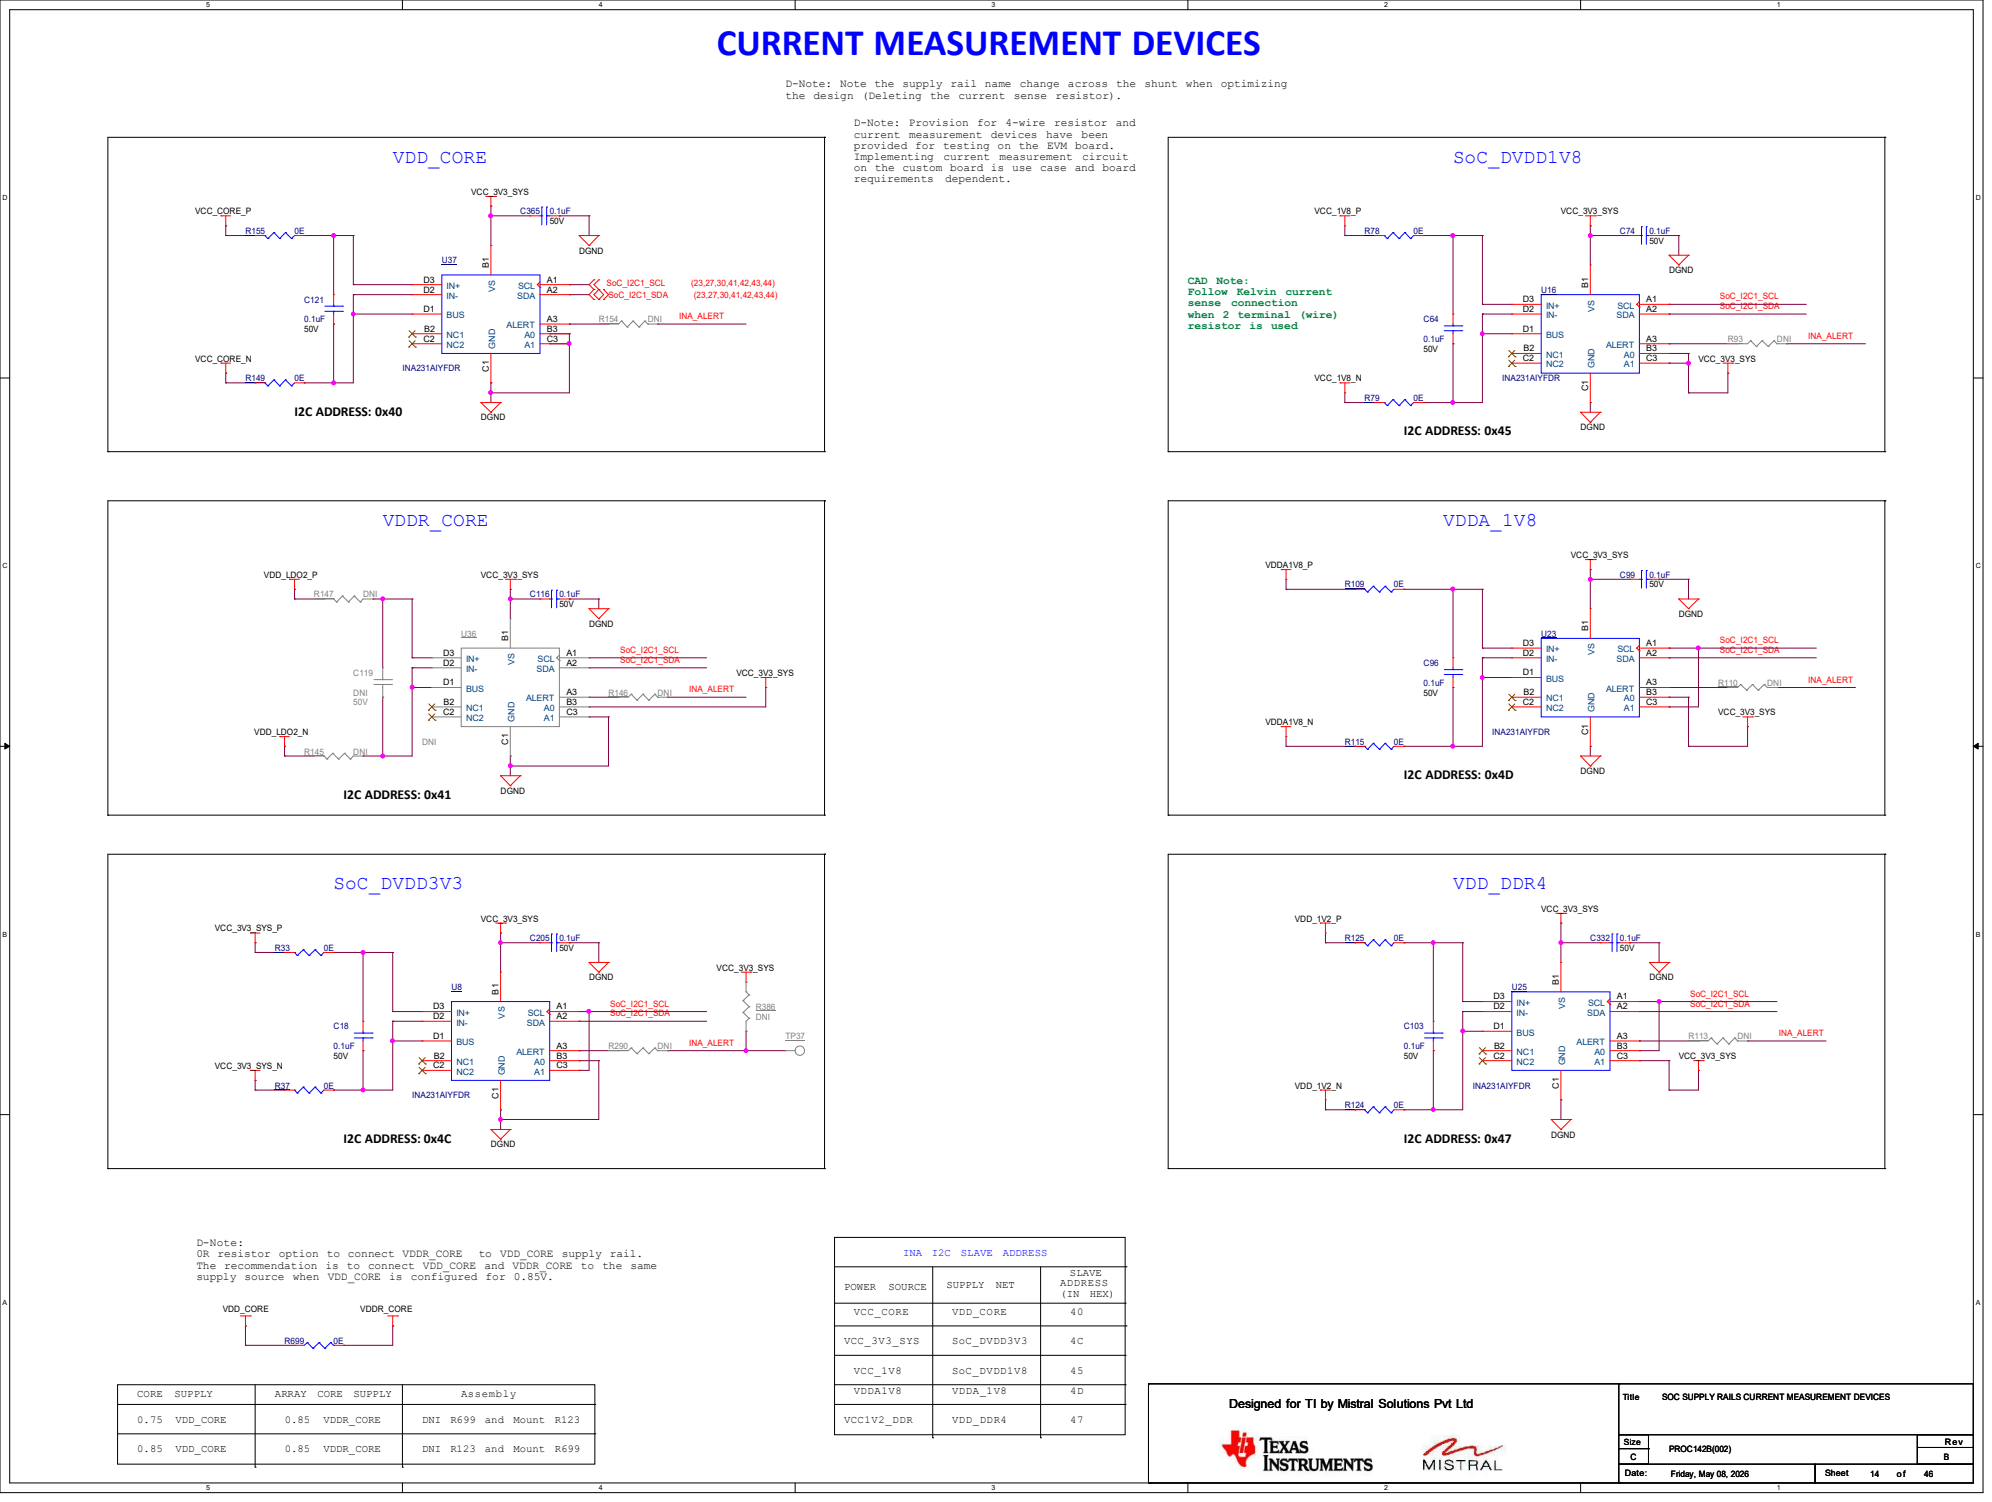
[picture p18: page 14]

D-Note: Note the supply rail name change across the shunt when optimizing
the design (Deleting the current sense resistor).

D-Note: Provision for 4-wire resistor and
current measurement devices have been
provided for testing on the EVM board.
Implementing current measurement circuit
on the custom board is use case and board
requirements dependent.

D-Note:
The recommendation is to connect VDD_CORE and VDDR_CORE to the same
supply source when VDD_CORE is configured for 0.85V.

Title
SOC SUPPLY RAILS CURRENT MEASUREMENT DEVICES C

D D

C C

B B

A A

# SOC POWER SUPPLIES AND SUPPLY RAILS

### D-Note: VDD_CORE and VDDR_CORE are recommended to be connected to the same supply source, so they ramp together when VDD_CORE is operating

at 0.85 V.

### D-Note: Select capacitors with ESR < 1 ohm. Ensure the PCB loop inductance is < 2.5 nH. Select 0201 package or the smallest

possible package.

### D-Note: Recommend implementing the voltage monitoring functionality using VMON_VSYS for early detection of supply failure. It is meant to be a power-fail indicator for the main input

(higher) voltage rail that enters the custom board. For example, 5, 12, or 24 volts. The error associated with this monitor would require you to set the threshold of the monitored voltage significantly lower than the nominal voltage (ROC) to avoid a false trigger. Refer to System Power Supply Monitor Design Guidelines section of the data sheet.

### R-Note: Connecting a 1.8V supply source directly to VPP pin continuously is not

recommended or allowed.

### D-Note: Refer to the Pin Connectivity Requirements to

connect the CSI0 supplies (analog and core),

### when CSI0 interface is not used. Ferrite and Bulk Caps are optional, when CSI0 is not used

and boundary scan functionality is required.

### D-Note: Changing the core voltage (Dynamically) is not allowed after the SOC has been released from reset. In case

the core supply is turned off,
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
