shikhakath/APE-SingleBoardComputer/reference/1_PROC142B/6_Assembly_Models_Package/Assembly Drawing/PROC142B ASSEMBLY.pdf

# PROC142B ASSEMBLY TOP REV.B

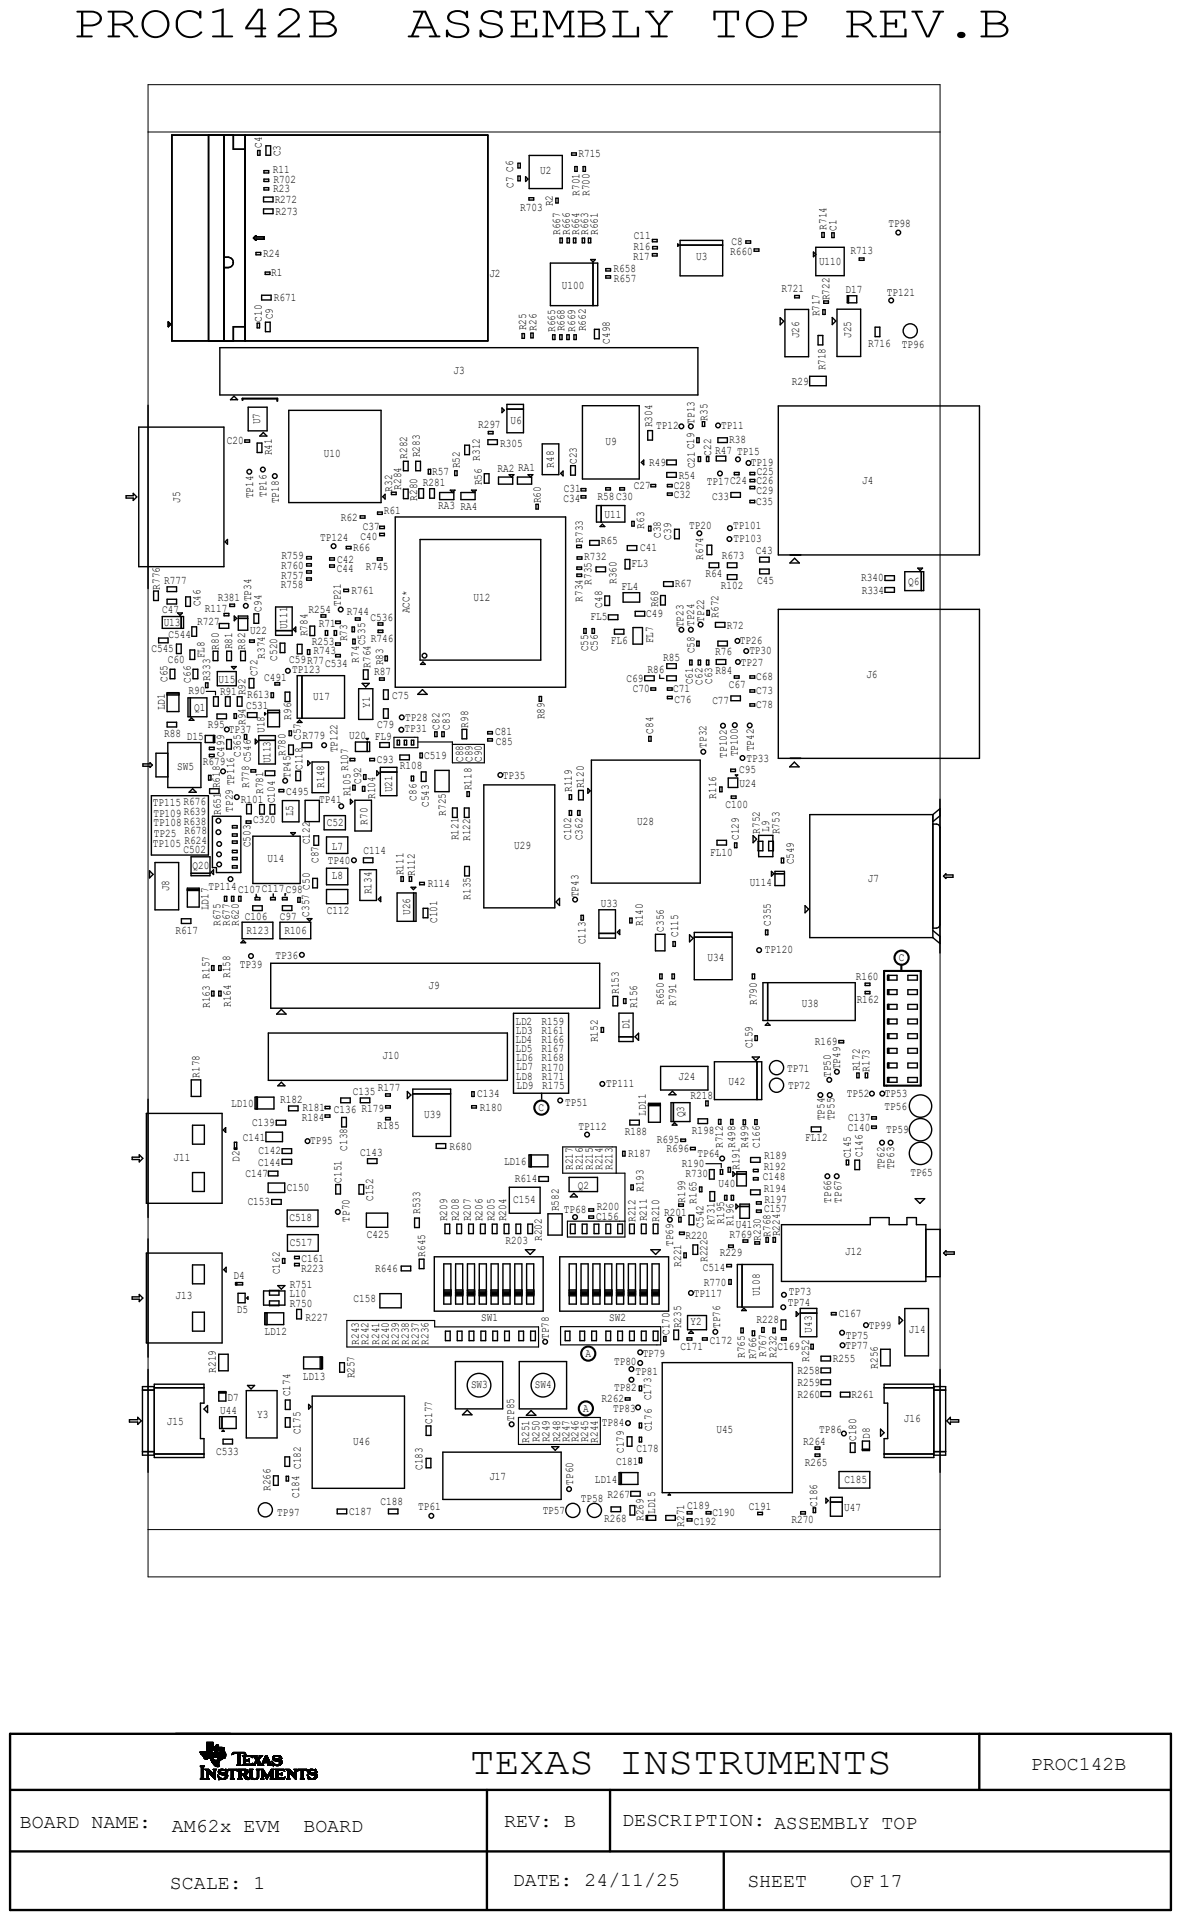
[picture p19: page 1]

# PROC142B ASSEMBLY BOTTOM REV. B

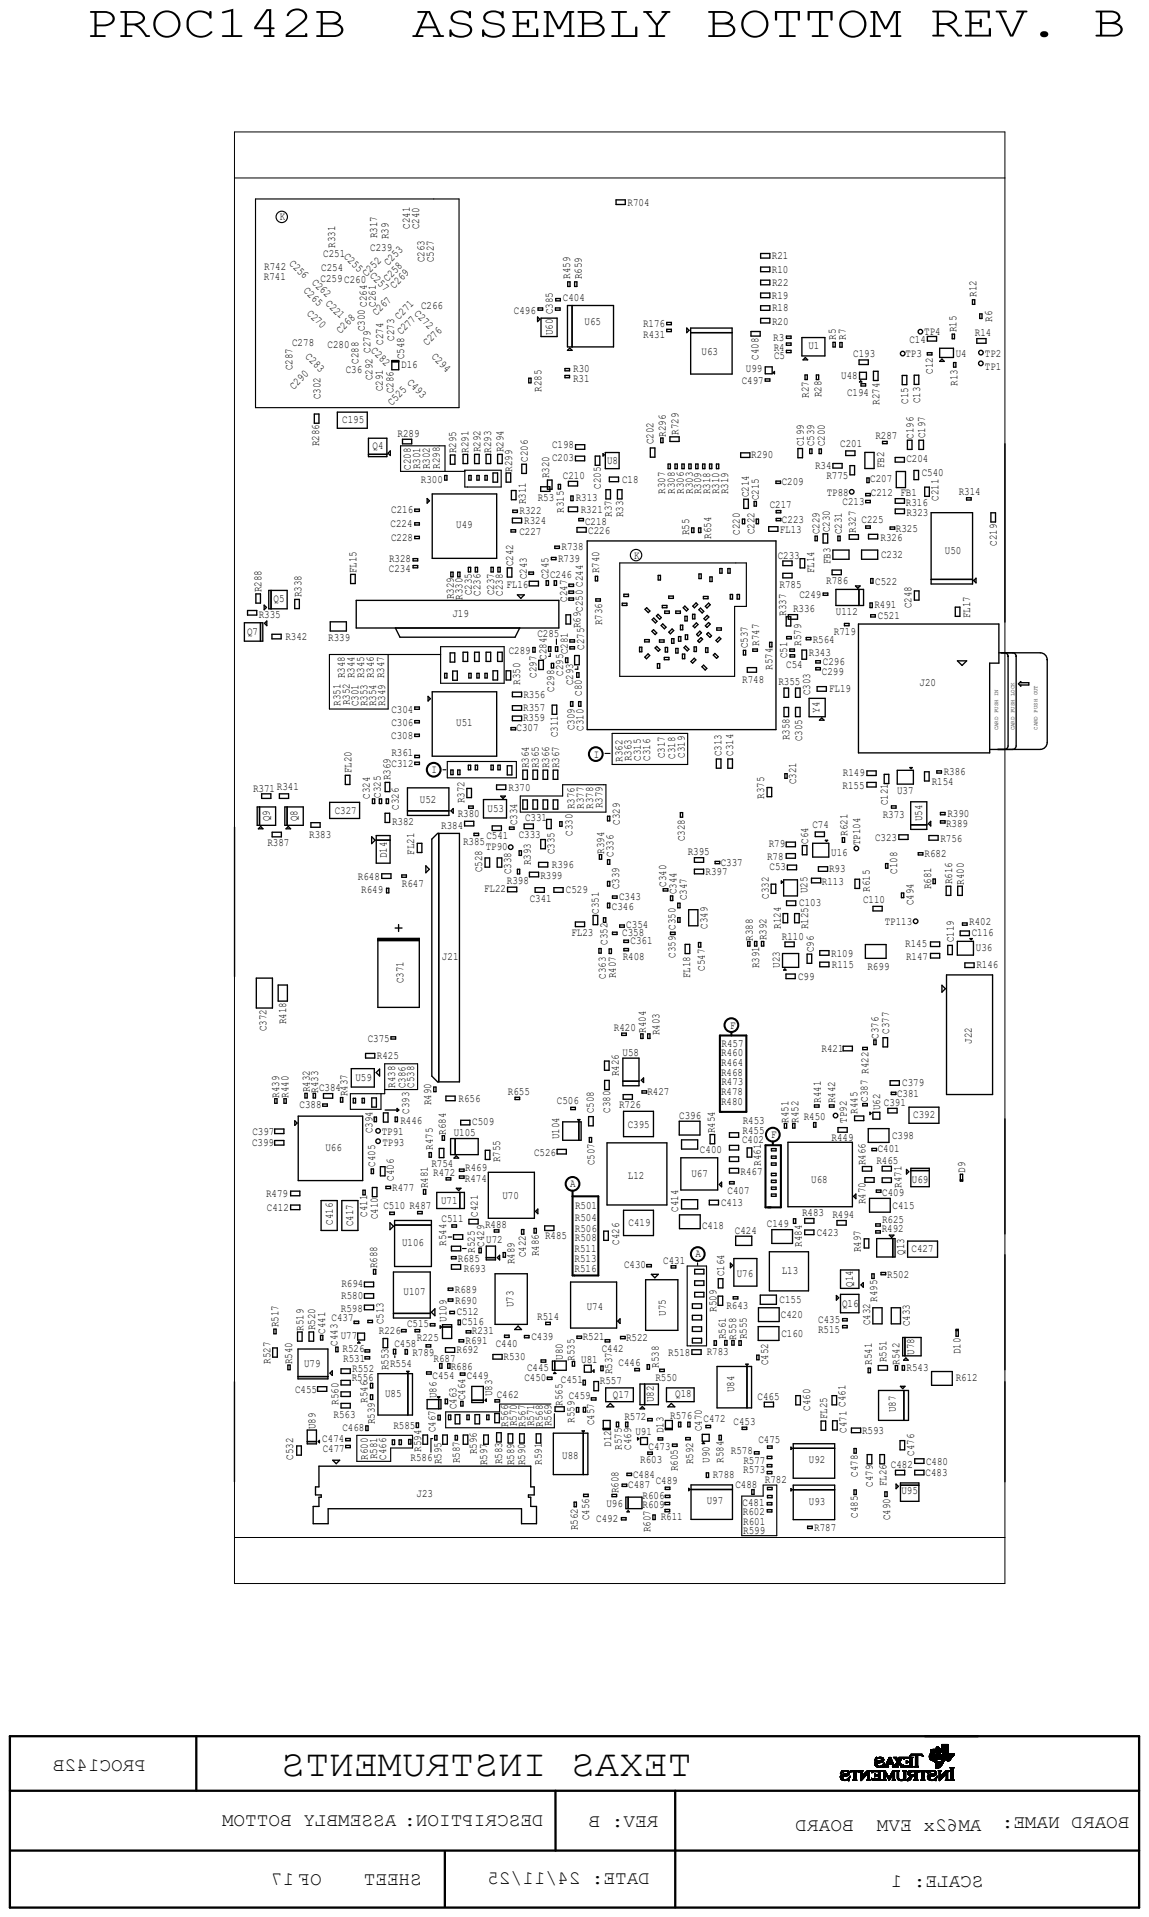
[picture p20: page 2]
