shikhakath/APE-SingleBoardComputer/reference/2_PROC142A/1_SCHEMATIC/PDF/PROC142A(002)_SCH_With_Design_Updates..Notes_V1.0.pdf

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
# I2C TREE

# TABLE OF CONTENTS

# GPIO MAPPING TABLE

# PERIPHERAL POWER SUPPLIES-2

# SOC POWER SUPPLIES - USING PMIC

# PERIPHERAL POWER SUPPLIES-1

# USB TYPE-C PD CONTROLLER AND POWER SUPPLY

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
# BLOCK DIAGRAM XDS110 DEBUGGER

# POWER ARCHITECTURE BLOCK DIAGRAM

# POWER-UP AND POWER-DOWN SEQUENCE

# TABLE OF CONTENTS

# REVISION HISTORY

# BLOCK DIAGRAM FOR AM625 / AM623 STARTER KIT SK (EVM)

PAGE | CONTENTS

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
# SOC MMC0.2 INTERFACE AND eMMC FLASH + RESET

# SOC OSPI/QSPI INTERFACE AND OSPI FLASH

# SOC SUPPLY RAILS CURRENT MONITORING

# CPSW3G RGMII_1 ETHERNET PHY

# M.2 INTERFACE AND CONNECTOR

# CAPS FOR SOC POWER SUPPLIES AND SOC GROUND VSS

# SOC DDRSS AND DDR4 MEMORY DEVICE INTERFACE

# SOC SUPPLY RAILS AND POWER SUPPLIES

# SD CARD - LOAD SWITCH, LOAD SWITCH RESET LOGIC AND DATA INTERFACE

# BOARD ID EEPROM & DIGITAL TEMPERATURE SENSORS

PAGE | CONTENTS | REV | A1
| | VER | 0.12

# AM625 / AM623 Starter Kit SK (EVM) WITH TPS6521904 PMIC

# ASSEMBLY NOTES AND MOUNTING HARDWARE

# SOC PUSH BUTTON RESET INPUTS, DEBOUNCE LOGIC FOR RC RESET

# SOC RESET AND IOs, AND EXTERNAL LVCMOS CLOCK (OSCILLATOR)

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
# TEST AUTOMATION

# BOOT MODE CONFIGURATION BUFFERS, RESISTOR DIVIDERS & DIP SWITCHES

# XDS110 DEBUGGER

# SOC MAC INTRFACE, SOC AND ETHERNET PHYs CLOCK BUFFER, LED DRIVER

# CPSW3G RGMII_2 ETHERNET PHY

# USB0 TYPE-C DRP

# SOC-MCU DOMAIN IO, OSC0 AND SOC-MCU IO HEADER

# SOC USB INTERFACE, USB1 TYPE-A CONNECTOR, VBUS DIVIDER & POWER SWITCH

# SOC JTAG INTERFACE AND JTAG BUFFERS

# SOC LFOSC0 AND SOC BOOTMODE INPUT PINS, PRU HEADER

# JTAG 20 PIN cTI CONNECTOR AND BUFFERS

# USER EXPANSION CONNECTOR

# FT4232 UART TO USB BRIDGE

# SOC DPI INTERFACE, DPI TO HDMI TRANSMITTER INTERFACE

# SOC OLDI INTERFACE, LCD CONNECTOR AND SOC UART1 FET SWITCH & BUFFER

# SOC CSI INTERFACE AND CAMERA CONNECTOR

# AUDIO CODEC

# IO EXPANDER AND MCASP1 FET SWITCH & BUFFER

# Hardware Design Guide : https://www.ti.com/lit/an/sprad05b/sprad05b.pdf

# Schematic Design and Review Checklist : https://www.ti.com/lit/an/sprad21d/sprad21d.pdf

# PMIC Power Solutions application note :

# DDR Board Design and Layout Guidelines : https://www.ti.com/lit/an/sprad06/sprad06.pdf

# https://www.ti.com/lit/an/slvafd0b/slvafd0b.pdf

# KEY LINKS TO COLLATERALS

44

# AUTOMATION SIGNALS BUFFER

* Verify the DNI components configuration with respect to the SK schematics (Use PDF) after completion of board design before board assembly * A standard 5% tolerance resistor can be used for most of the series and parallel pull resistor
* Be sure to read through all the D-Notes (Design notes), R-Notes (Review notes) and CAD notes during board design and before start of

# board build. (Refer FAQs listed for additional details)

# R-Note:-

# Revision Number

# SK-AM62B, SK-AM62B-P1, SK-AM62-LP, SK-AM62-SIP, SK-AM62A-LP, SK-AM62P-LP

# SKs (Starter Kits) for reference :

SK/EVM is a device evaluation board or platform. The SK/EVM is not a reference design. In some cases the EVM implementation may deviate from the optimum solution to provide a better customer experience or provide flexibility for customers to be able to validate the SOC functionality. TI expects and recommends customers to carefully review and follow all requirements defined in the datasheet, silicon errata, and TRM when designing their custom board. The information found in the datasheet should always take precedence over the SK/EVM implementation.

# D-Note :-

Title

Size | Rev
Date: | Sheet | o f
Designed for TI by Mistral Solutions Pvt Ltd | A1 TABLE OF CONTENTS C | Monday, May 27, 2024 | 1 | 44 PROC142A1(002)
Designed for TI by Mistral Solutions Pvt Ltd | A1 TABLE OF CONTENTS C | Monday, May 27, 2024 | 1 | 44 PROC142A1(002)
Designed for TI by Mistral Solutions Pvt Ltd | A1 TABLE OF CONTENTS C | Monday, May 27, 2024 | 1 | 44 PROC142A1(002)

D D

C C

B B

A A

# REVISION HISTORY

## Changed the HDMI external swing resistance to 7.5K. Added Standoff,Screw & Washer

11 APR 2023 | for M.2 connector. DNI'd R650 on SoC_USB1_DRVVBUS

0.05

## 24 OCT 2022

## Changed the PMIC part from TPS6521903RHBR to TPS6521904RHBR. Mounted R699 and

DNI'd R123. DNI'd the current monitor section of U36 | Mistral Design Team
0.01 | Drafted from PROC142E1 Schematics. R651 value changed to 1K. DNI'd R618 and R676.Changed the | Mistral Design Team 29 AUG 2022 | I2C buffer parts to TCA9517DR. Changed the part SN74AVC4T245RSVR to SN74AVC4T245DGVR

0.02

## 08 SEP 2022

Added the second GPIO Expander U110 Part# TCA6408ARGTR | Mistral Design Team

0.03

## 21 SEP 2022

Changed the Current monitors Res Filter values from 10E to 0E to the Sense pins. | Mistral Design Team

0.04

## 19 OCT 2022

Added Testpoint to TEMP_DIODE_P pin of SoC.
Changed the GPIO_OLDI_RSTn net name to GPIO_TS_RSTn. | Mistral Design Team
0.06 | 3 Nov 2022 | Changed the DDR4 part from MT40A1G16KD-062E IT:E to MT40A1G16TB-062E IT:F.
Changed the eMMC part from MTFC16GAPALBH-IT to MTFC32GAZAQHD-IT. | Mistral Design Team
0.07 | 15 Nov 2022
Removed the PMIC_STBY connection from SOC to PMIC. | Mistral Design Team

## Added 2x 47uF on VCC_5V0. DNI'd C432, C433(10uF) and changed C415 to 4.7uF. Added 22pF CAP across R108 22 Nov 2022

## 0.08 Mistral Design Team

AUTHOR | APPROVED BY
VER # | DESCRIPTION OF CHANGES DATE

## REVIEWED BY

1 Dec 2022 | Removed MMC2 connector section (J18) and associated resistors | Mistral Design Team
0.09

## 0.10 Mistral Design Team

0.11 | 16 MAY 2023 | Depopulated Pull up of SOC_WLAN_IRQ_1V8 (R6) | Mistral Design Team

https://e2e.ti.com/support/processors-group/processors/f/processors-forum/1285107/faq-am64x-am62x-am62ax-am62px-custom-board-hardware-design---

# collaterals-for-reference-during-schematic-design-and-schematics-review

https://e2e.ti.com/support/processors-group/processors/f/processors-forum/1184006/faq-am623-custom-board-hardware-design-collaterals-to-get-startedhttps://e2e.ti.com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

https://e2e.ti.com/support/processors-group/processors/f/processors-forum/1280721/faq-am625-am623-am625sip-am625-q1-am620-q1-custom-board-hardware-design---faqs-rela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

# LINKS TO KEY FAQs

https://e2e.ti.com/support/processors-group/processors/f/processors-forum/1332316/faq-am625-am623-custom-board-hardware-design---design-and-

# review-notes-for-reuse-of-sk-am62b-p1-schematics

0.12 | 27 MAY 2024 | Mistral Design Team

## Updated SoC Part Number, Enabled Voltage ratings for all the capacitors and added Design Review notes

## Moved to DNI : R222, R650, C305, C303, C156, Q2, Y4 Moved to Mount : R319, R309, R318, R310, R306, R307, R308, R303, R538, R572

C86 - 1uF changed to 2.2uF ; C60 - 4.7uF changed to 1uF ; C46 - 0.1uF changed to 4.7uF ;

## C47,C387,C194,C12 - 1uF changed to 0.1uF ; C77, C33 - 4.7uF changed to 10uF ; C75,C79 -9pF changed to 18pF ; C391,C14,C193 - 2.2uF changed to 1uF

R651 - 1K_0.1% changed to Std 1K ; R404,R408 - 1K_0.1% changed to 1K_1% ; R89,R353,R354,R301,R302 - 22E_1% changed to 0E ; R12,R333,R398 - 49.9K_1% changed to Std 10K ; R393,R475 - 10K_1% changed to Std 10K; R315 - 100K changed to 10k; R56 - 0E changed to Std 22E.

Designed for TI by Mistral Solutions Pvt Ltd | A1 REVISION HISTORY C | Monday, May 27, 2024 | 2 | 44 PROC142A1(002)
Designed for TI by Mistral Solutions Pvt Ltd | A1 REVISION HISTORY C | Monday, May 27, 2024 | 2 | 44 PROC142A1(002)
Designed for TI by Mistral Solutions Pvt Ltd | A1 REVISION HISTORY C | Monday, May 27, 2024 | 2 | 44 PROC142A1(002)

## PMIC

# PD Controller

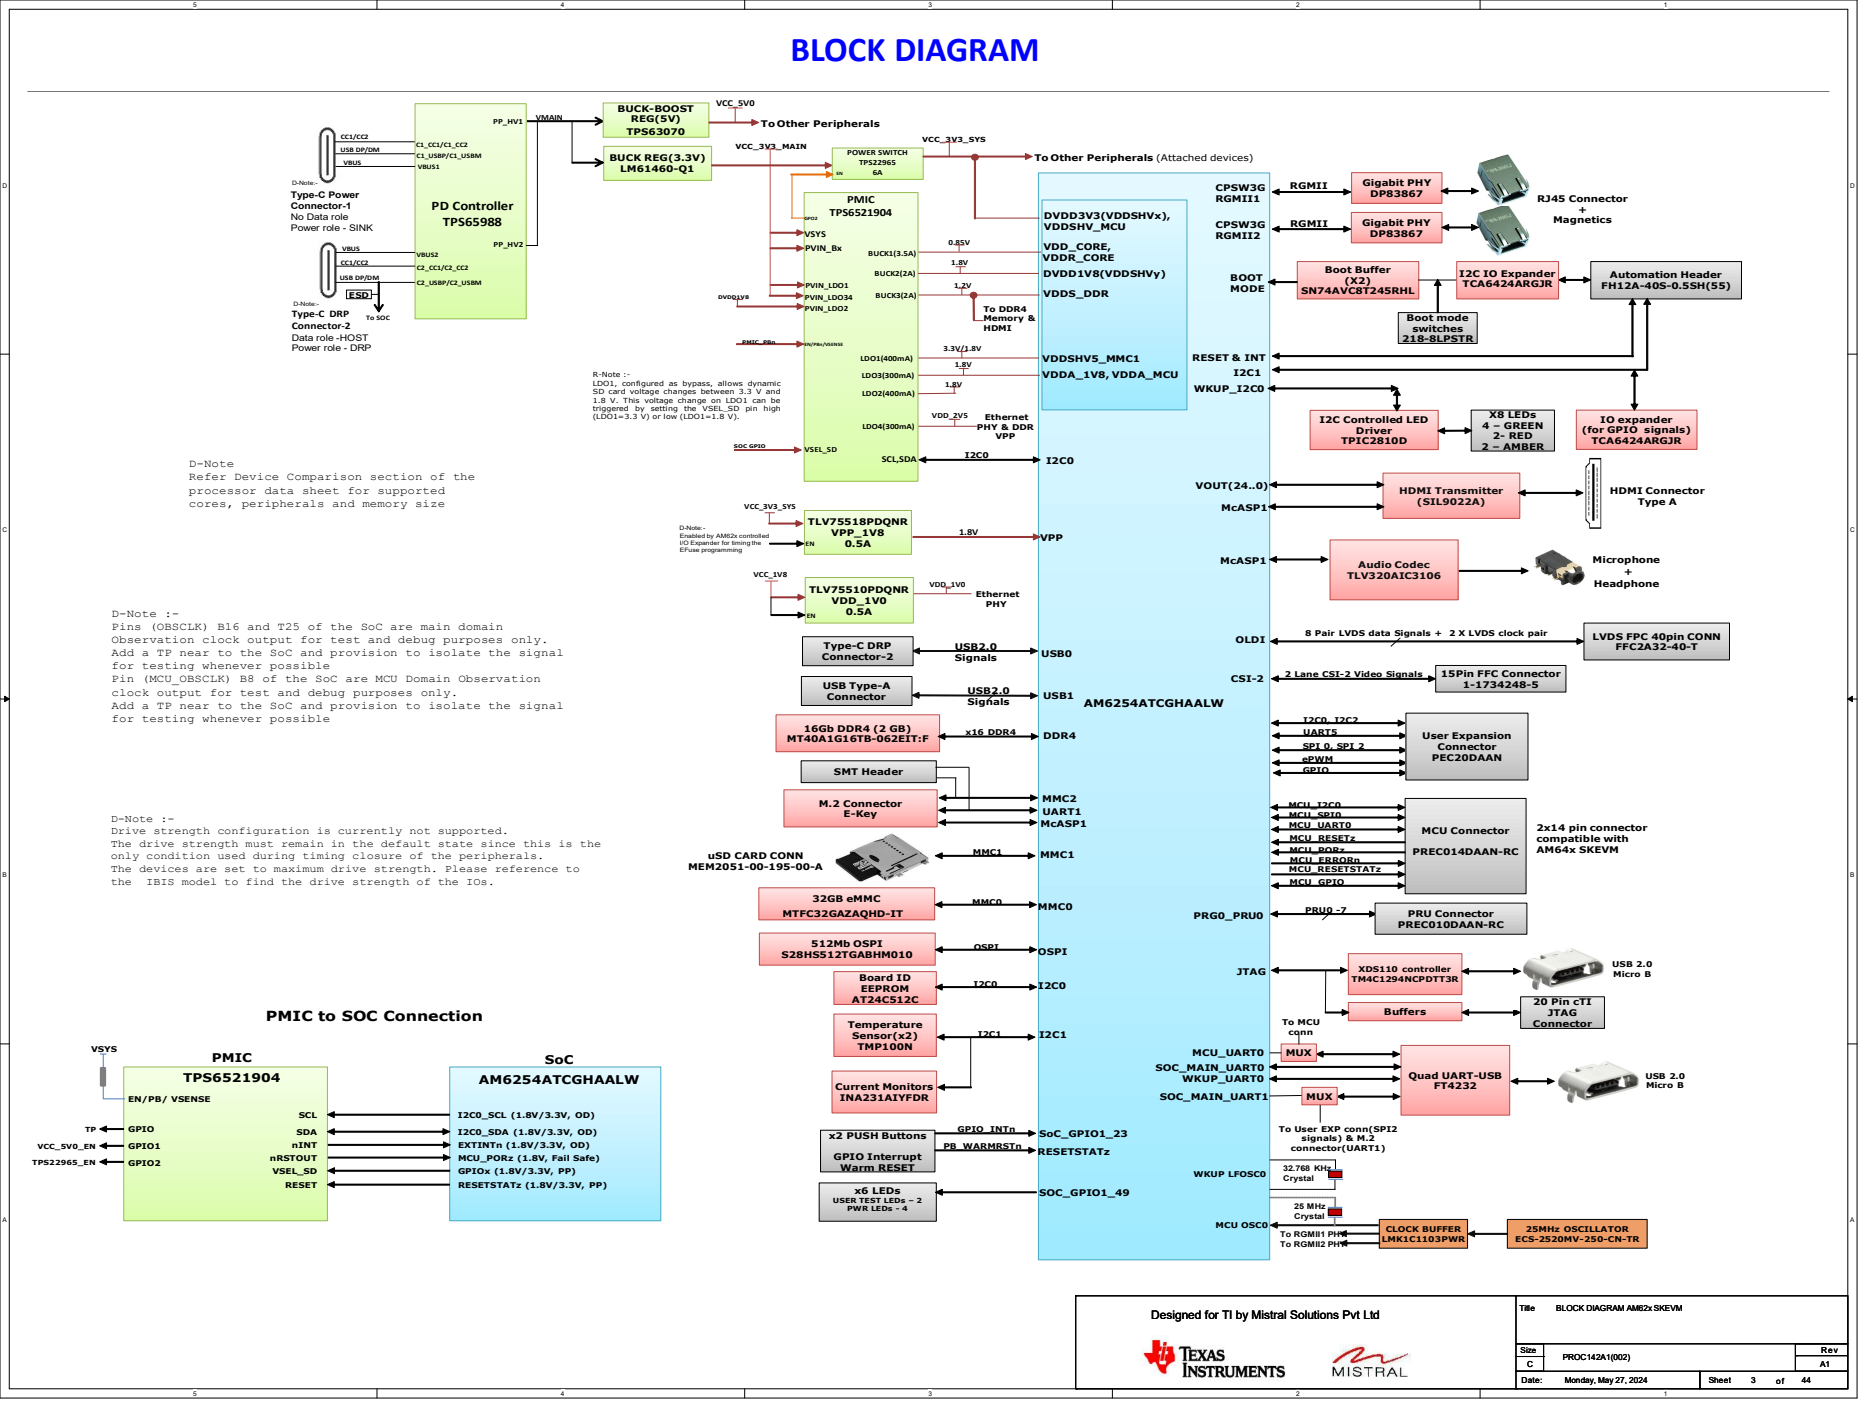
[picture p21: page 3]
AM6254ATCGHAALW; Automation Header FH12A-40S-0.5SH(55); BOOT MODE; I2C IO Expander TCA6424ARGJR; RESET & INT; RGMII; HDMI Transmitter (SIL9022A) Audio Codec TLV320AIC3106; HDMI Connector Type A; VOUT(24..0) McASP1; CPSW3G RGMII1 CPSW3G RGMII2 WKUP_I2C0; RJ45 Connector + Magnetics; Microphone +; Headphone McASP1; X8 LEDs 4 – GREEN; 2- RED 2 – AMBER; VCC_3V3_SYS; TPS6521904 BUCK1(3.5A) BUCK2(2A) BUCK3(2A) LDO1(400mA) LDO3(300mA) VSYS PVIN_Bx PVIN_LDO1; VPP_1V8 0.5A; VCC_5V0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

BLOCK DIAGRAM
EN SOC GPIO

PP_HV1 PP_HV2 USB DP/DM

To Other Peripherals

CC1/CC2 CC1/CC2 VBUS VBUS Type-C Power Connector-1 No Data role Power role - SINK

USB DP/DM

Gigabit PHY DP83867 Gigabit PHY DP83867 Boot Buffer (X2) SN74AVC8T245RHLBoot mode switches 218-8LPSTR

Type-C DRP Connector-2 Data role -HOST Power role - DRP ESD
(LDO1=3.3 V) or low (LDO1=1.8 V). D-Note:-

To DDR4 Memory & HDMI TLV75518PDQNR

EN/PBn/VSENSE

VSEL_SD R-Note :- LDO1, configured as bypass, allows dynamic SD card voltage changes between 3.3 V and 1.8 V. This voltage change on LDO1 can be

triggered by setting the VSEL_SD pin high

I2C Controlled LED Driver TPIC2810D

IO expander
(for GPIO signals) TCA6424ARGJR

D-Note
Refer Device Comparison section of the
processor data sheet for supported
cores, peripherals and memory size

D-Note:-
EN Enabled by AM62x controlled
I/O Expander for timing the EFuse programming

D-Note :-
Pins (OBSCLK) B16 and T25 of the SoC are main domain
Observation clock output for test and debug purposes only.
Add a TP near to the SoC and provision to isolate the signal
for testing whenever possible
Pin (MCU_OBSCLK) B8 of the SoC are MCU Domain Observation
clock output for test and debug purposes only.

15Pin FFC Connector 1-1734248-5 OLDI CSI-2

8 Pair LVDS data Signals + 2 X LVDS clock pair

SMT Header Type-C DRP Connector-2 USB Type-A Connector

16Gb DDR4 (2 GB) MT40A1G16TB-062EIT:F M.2 Connector E-Key 512Mb OSPI S28HS512TGABHM010 Board ID EEPROM

Drive strength configuration is currently not supported.
The drive strength must remain in the default state since this is the
only condition used during timing closure of the peripherals.
The devices are set to maximum drive strength. Please reference to
the IBIS model to find the drive strength of the IOs.

XDS110 controller TM4C1294NCPDTT3R MCU Connector PREC014DAAN-RC

2x14 pin connector
compatible with AM64x SKEVM

PMIC to SOC Connection

To MCU conn

RESETSTATz (1.8V/3.3V, PP) VSYS

Quad UART-USB

EN/PB/ VSENSE GPIO

x2 PUSH Buttons GPIO Interrupt Warm RESET x6 LEDs USER TEST LEDs – 2 PWR LEDs - 4

To User EXP conn(SPI2
signals) & M.2
connector(UART1)

To RGMII2 PHY 25 MHz Crystal MCU OSC0

ECS-2520MV-250-CN-TR

### TPS79601DRBR OUT

51k 30k

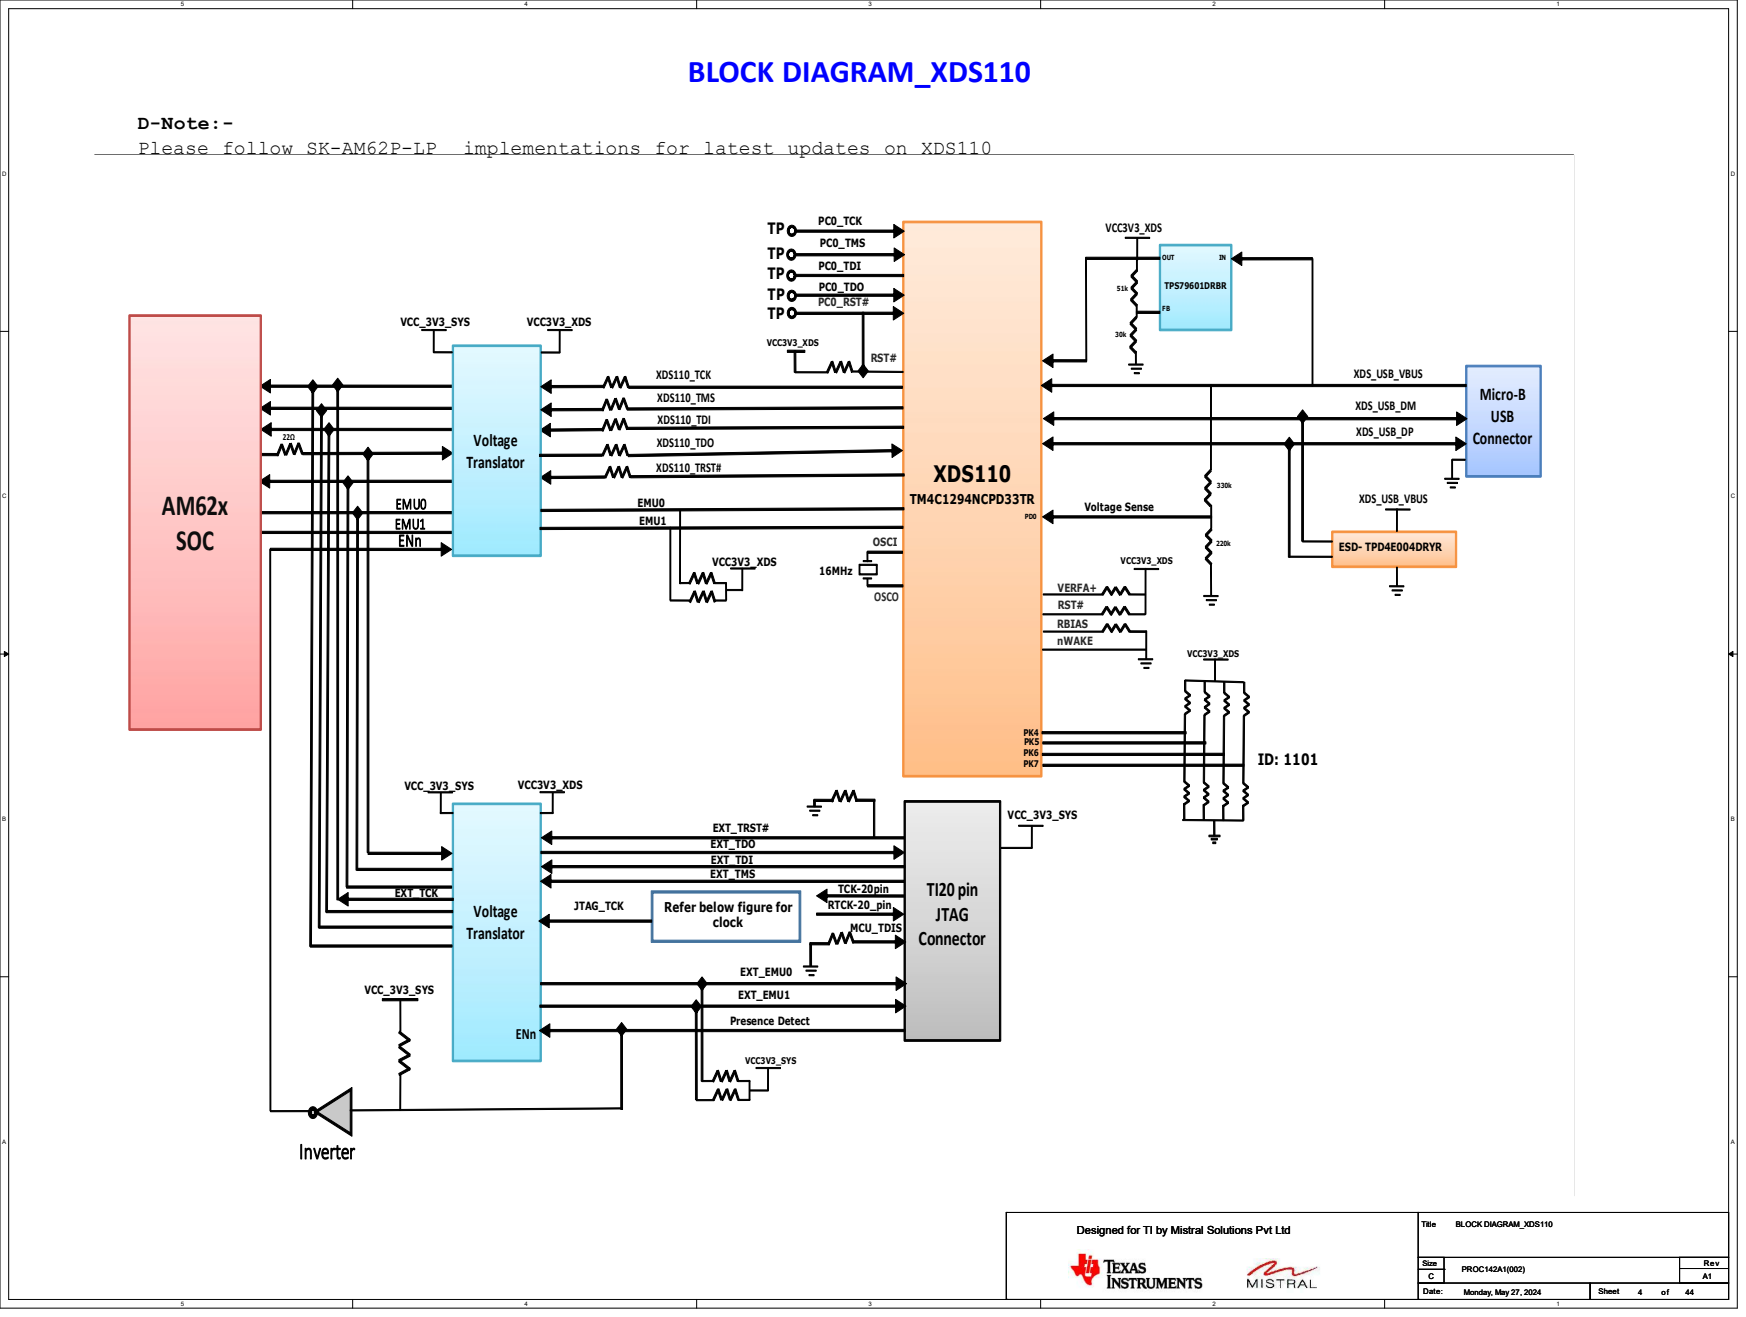
[picture p22: page 4]
TM4C1294NCPD33TR; XDS_USB_DM; VCC3V3_XDS; 16MHz; OSCI; OSCO; EMU0 EMU1; EXT_TMS; EXT_TDO; EXT_TRST#; TI20 pin JTAG Connector; EXT_TDI; Presence Detect; ESD- TPD4E004DRYR; Voltage Translator; VCC_3V3_SYS; Voltage; Translator; MCU_TDIS; EXT_EMU0; EXT_EMU1; 330k 220k Voltage Sense; VERFA+; EMU0; EMU1; EXT_TCK; RTCK-20_pin; TCK-20pin; PC0_TCK; PC0_TMS; PC0_TDO; PC0_TDI; RST#; PC0_RST#; ENn; XDS110; Micro-B USB Connector; RST# RBIAS nWAKE VCC3V3_XDS PK5 PK6 PK7; VCC3V3_SYS; Inverter; JTAG_TCK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

D-Note:-
Please follow SK-AM62P-LP implementations for latest updates on XDS110

Refer below figure for
clock

## Test Automation Header

## USB Type-A

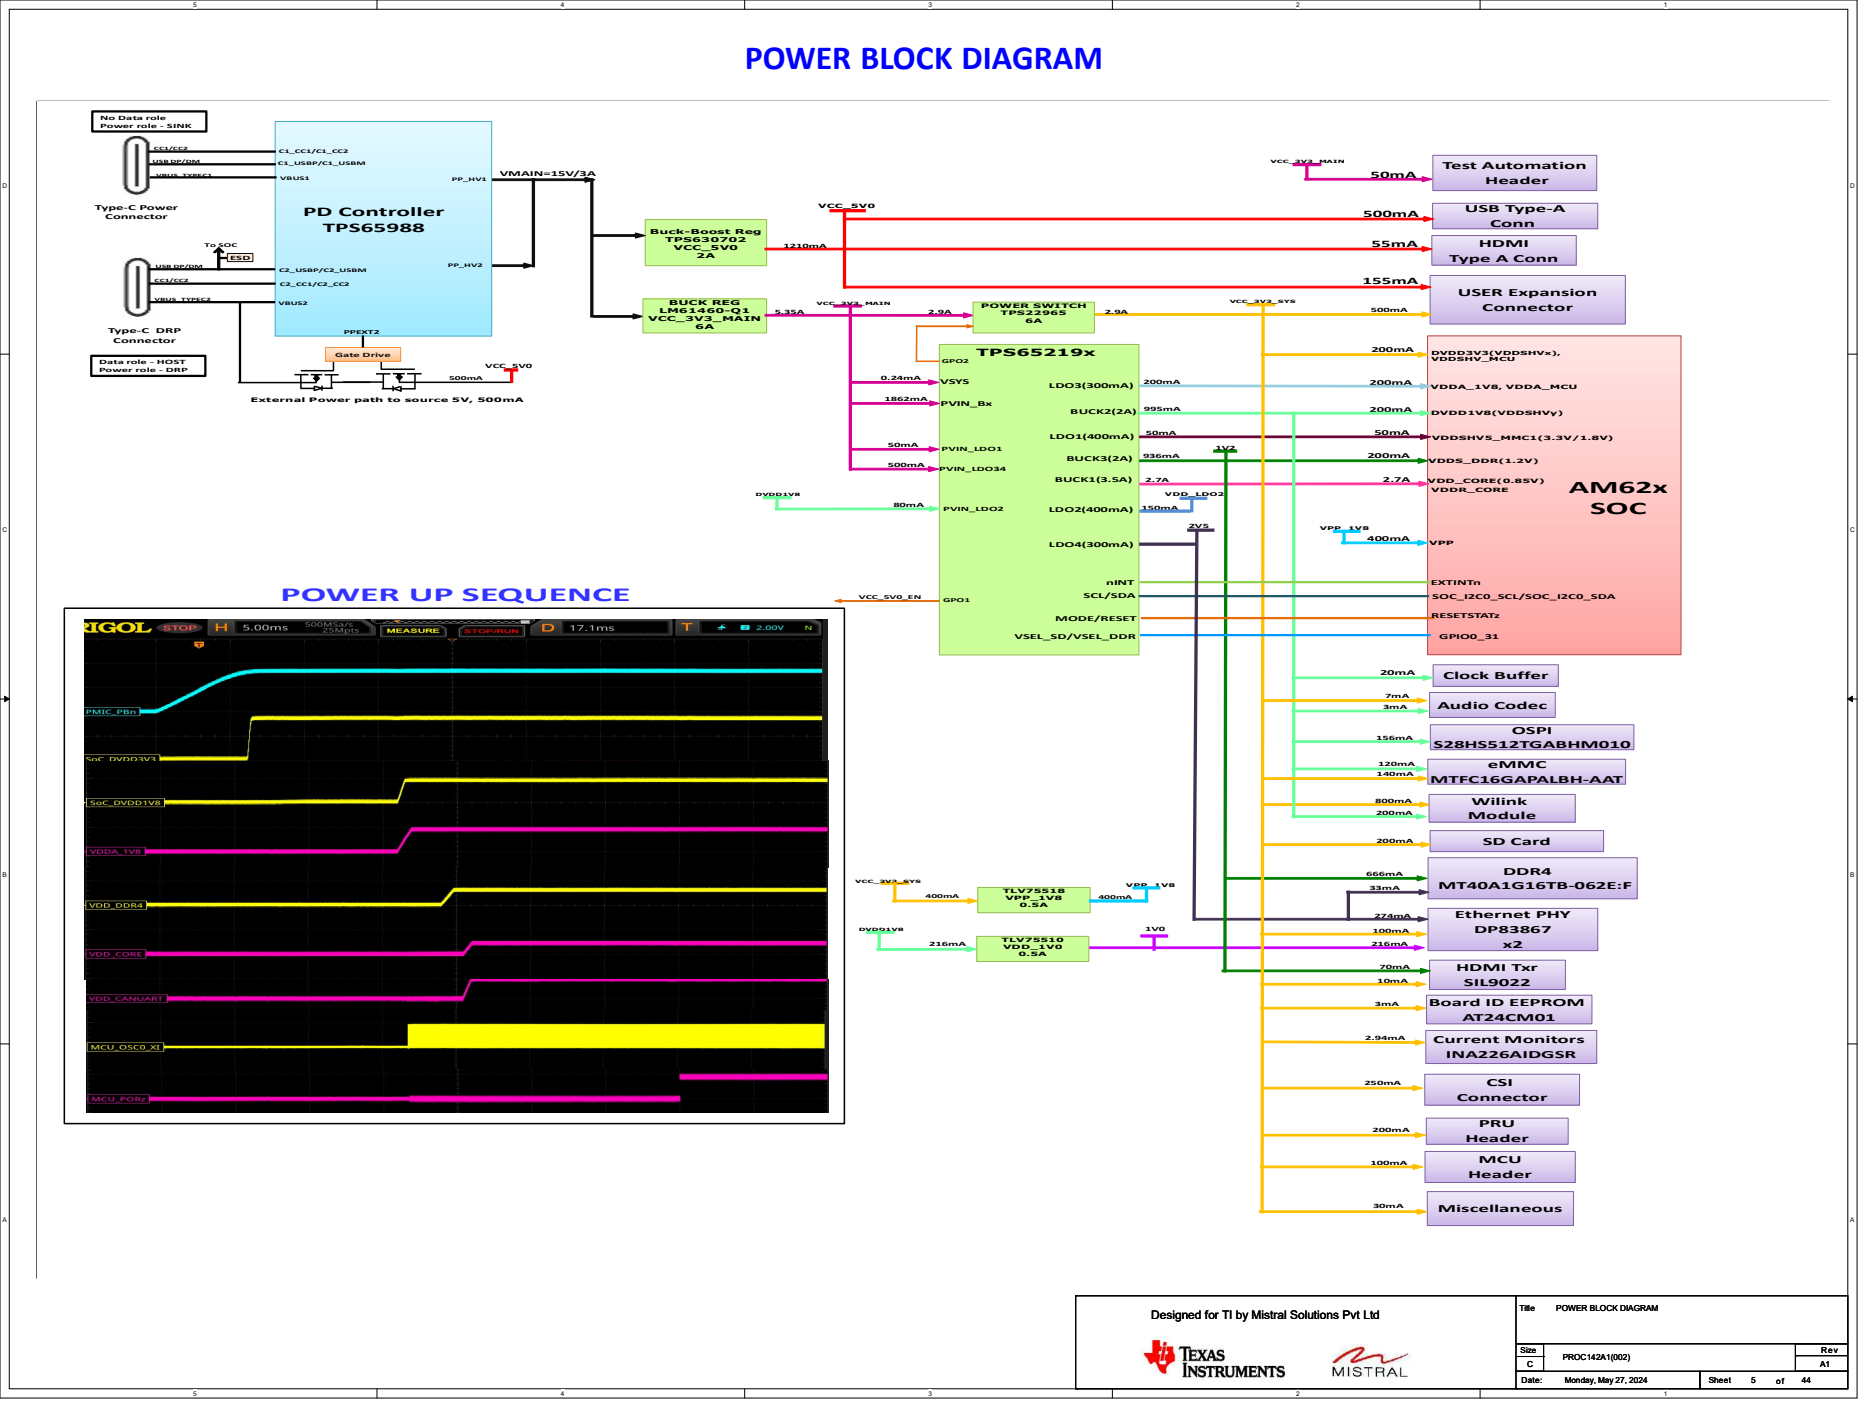
[picture p23: page 5]
SD Card DDR4 MT40A1G16TB-062E:F; Header MCU; Header; VDDR_CORE VPP VDDSHV5_MMC1(3.3V/1.8V) AM62x; SOC; Ethernet PHY DP83867; x2 HDMI Txr SIL9022; DVDD1V8(VDDSHVy) VDDA_1V8, VDDA_MCU 200mA; VSYS PVIN_Bx PVIN_LDO1; BUCK1(3.5A) BUCK2(2A) BUCK3(2A) LDO1(400mA) LDO2(400mA); LDO3(300mA); LDO4(300mA) ⁵⁰mA; C2_USBP/C2_USBM; To SOC; PP_HV1 USB DP/DM; PP_HV2 USB DP/DM; ESD; BUCK REG; LM61460-Q1 VCC_3V3_MAIN; TPS65219x; VMAIN=15V/3A; Clock Buffer; Wilink Module; USER Expansion; Connector 155mA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

POWER BLOCK DIAGRAM

No Data role Power role - SINK
CC1/CC2 CC1/CC2 VBUS_TYPEC1 VBUS_TYPEC2
C1_CC1/C1_CC2 C2_CC1/C2_CC2 VBUS1 VBUS2
TPS65988 C1_USBP/C1_USBM
VOUT PD Controller

Type-C Power Connector Type-C DRP Connector

Conn HDMI Type A Conn VDD_CORE(0.85V) VDDS_DDR(1.2V) DVDD3V3(VDDSHVx), VDDSHV_MCU

Buck-Boost Reg
TPS630702 VCC_5V0

Data role - HOST Power role - DRP

SCL/SDA MODE/RESET VSEL_SD/VSEL_DDR

Audio Codec
eMMC MTFC16GAPALBH-AAT OSPI S28HS512TGABHM010

Board ID EEPROM AT24CM01 Current Monitors INA226AIDGSR

CSI Connector PRU

1

### To Test Automation

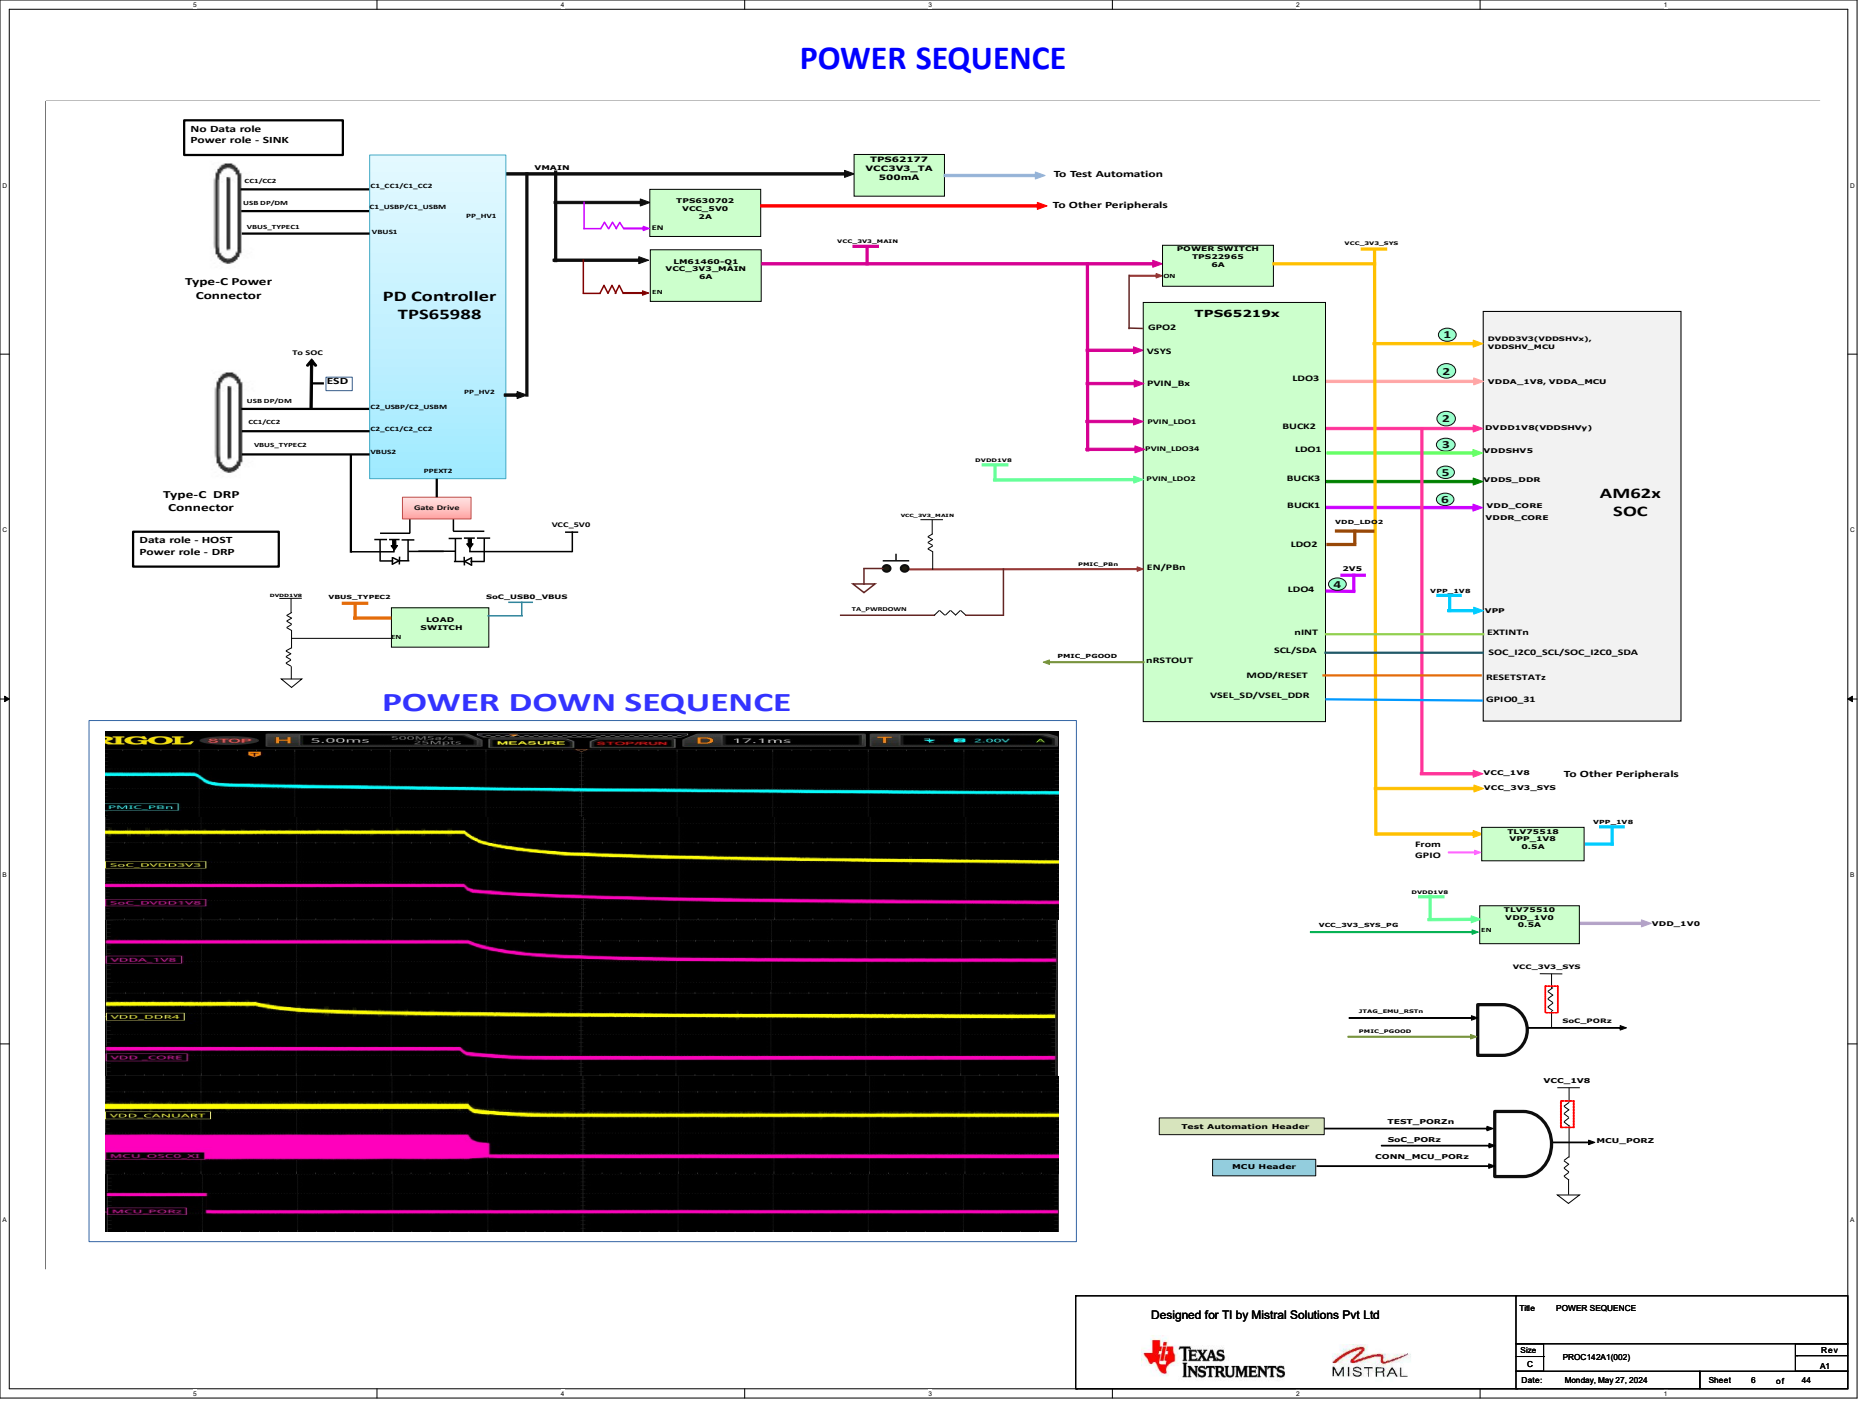
[picture p24: page 6]
TPS62177 VCC3V3_TA; VMAIN; DVDD3V3(VDDSHVx), VDDSHV_MCU; VPP; SOC VDD_CORE VDDS_DDR; VDDR_CORE DVDD1V8(VDDSHVy) VDDSHV5 VDDA_1V8, VDDA_MCU; VDD_1V0; MCU_PORZ; JTAG_EMU_RSTn; SoC_PORz VCC_3V3_SYS; SoC_PORz CONN_MCU_PORz TEST_PORZn; VCC_1V8; TLV75510 VDD_1V0; TPS630702 VCC_5V0; PD Controller; TPS65988 C1_USBP/C1_USBM; C2_USBP/C2_USBM; VBUS1; VBUS2; To SOC; VBUS_TYPEC2; ESD; Gate Drive; VCC_5V0 PPEXT2; PVIN_Bx; BUCK1 BUCK2 BUCK3; LDO1; LDO4; LDO3 TPS65219x; VSYS; EN/PBn; nRSTOUT PMIC_PGOOD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

No Data role Power role - SINK

USB DP/DM
PP_HV1 PP_HV2 USB DP/DM
VBUS_TYPEC1

To Other Peripherals

Type-C Power Connector

Type-C DRP Connector

VDD_LDO2 POWER DOWN SEQUENCE

Data role - HOST Power role - DRP

Test Automation Header MCU Header

# Add 0x51 User Expansion Connector Add 0x50 PD Controller Add 0x38, 0x3F PRU

# I2C TREE

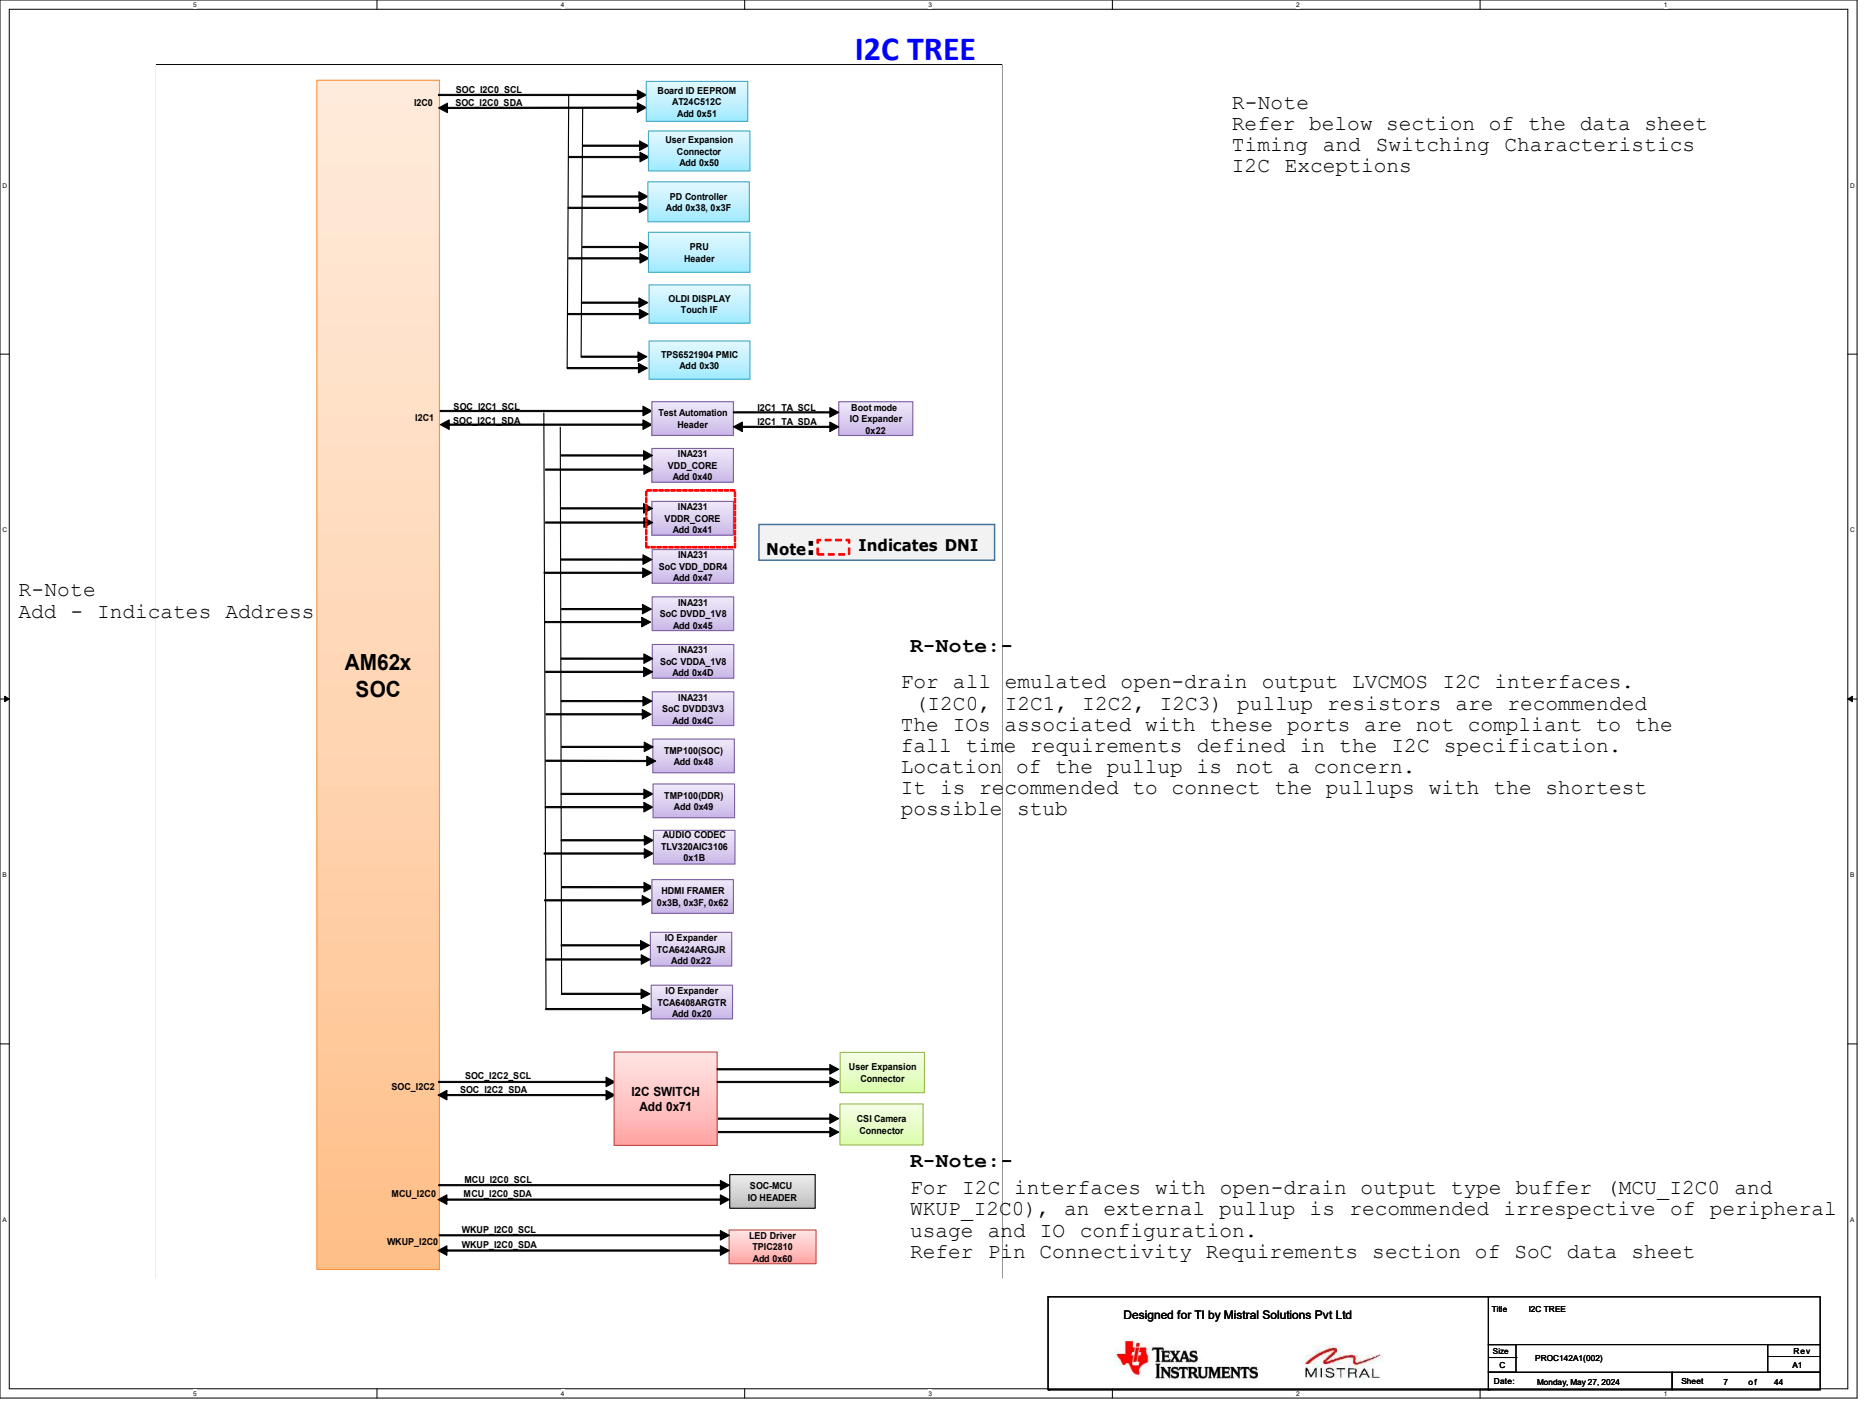
[picture p25: page 7]
AM62x SOC; SOC_I2C0_SCL SOC_I2C0_SDA; SOC_I2C1_SCL; SOC_I2C2_SCL; Test Automation Header; Boot mode; IO Expander 0x22 SOC_I2C1_SDA; I2C1_TA_SCL I2C1_TA_SDA I2C1; WKUP_I2C0; INA231 VDD_CORE Add 0x40; INA231 SoC VDD_DDR4 Add 0x47; INA231 SoC DVDD_1V8 Add 0x45; INA231 SoC VDDA_1V8 Add 0x4D; INA231 SoC DVDD3V3 Add 0x4C; SOC-MCU IO HEADER; AUDIO CODEC TLV320AIC3106 0x1B; HDMI FRAMER 0x3B, 0x3F, 0x62; LED Driver TPIC2810 Add 0x60 SOC_I2C2; SOC_I2C2_SDA; MCU_I2C0; MCU_I2C0_SCL MCU_I2C0_SDA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

Board ID EEPROM

R-Note
Refer below section of the data sheet
Timing and Switching Characteristics
I2C Exceptions

Header OLDI DISPLAY

Add - Indicates Address

R-Note:-
For all emulated open-drain output LVCMOS I2C interfaces.
(I2C0, I2C1, I2C2, I2C3) pullup resistors are recommended
The IOs associated with these ports are not compliant to the
fall time requirements defined in the I2C specification.
Location of the pullup is not a concern.
It is recommended to connect the pullups with the shortest
possible stub

TMP100(SOC) Add 0x48 TMP100(DDR) Add 0x49

User Expansion Connector CSI Camera Connector

For I2C interfaces with open-drain output type buffer (MCU_I2C0 and
WKUP_I2C0), an external pullup is recommended irrespective of peripheral
usage and IO configuration.
Refer Pin Connectivity Requirements section of SoC data sheet

D D

C C

B B

A A

SL NO. | GPIO DESCRIPTION | GPIO NETNAME | Functionality | GPIO USED | SOC MUXED SIGNAL NAME | DIRECTION WITH RESPECT TO CONTROL | DEFAULT STATE | ACTIVE STATE | VOLTAGE DOMAIN ON SOC SIDE | VOLTAGE CONNECTED ON SKEVM
1 | Enable for WLAN Interface | SoC_WLAN_EN_1V8 | ENABLE | GPIO0_71 | MMC2_SDCD | OUTPUT | LOW | HIGH | VDDSHV6 | SoC_DVDD1V8
2 | WLAN Interrupt | SoC_WLAN_IRQ_1V8 | INTERRUPT | GPIO0_72 | MMC2_SDWP | INPUT | HIGH | LOW | VDDSHV6 | SoC_DVDD1V8
3 | Enable for BT Interface | BT_EN_SOC_3V3 | ENABLE | MCU_GPIO0_1 | MCU_SPI0_CS0 | OUTPUT | HIGH | LOW | VDDSHV_MCU | SoC_DVDD3V3

## 4 CPSW Ethernet PHY Interrupt

CPSW_RGMII_INTn/PRU_INTn | INTERRUPT | GPIO1_31 | EXTINTn | INPUT | HIGH | LOW | VDDSHV0 | SoC_DVDD3V3 PRU Connector Interrupt

## PMIC_INTn

5 | OSPI Reset Control GPIO | GPIO_OSPI_RSTn | RESET | GPIO0_12 | OSPI0_CSn1 | OUTPUT | HIGH | LOW | VDDSHV1 | SoC_DVDD1V8
6 | OSPI Interrupt | OSPI_INTn | INTERRUPT | GPIO0_13 | OSPI0_CSn2 | INPUT | HIGH | LOW | VDDSHV1 | SoC_DVDD1V8
7 | SD Card IO Voltage Select | VSEL_SD | ENABLE | GPIO0_31 | GPMC0_CLK | OUTPUT | LOW | HIGH | VDDSHV3 | SoC_DVDD3V3
8 IO Expander Interrupt | | MCU_GPIO0_15 | INTERRUPT | MCU_GPIO0_15 | MCU_MCAN1_TX | INPUT | HIGH | LOW | VDDSHV_CANUART | SoC_DVDD3V3
9 | TEST GPIO1 from Test Automation Connector/ User Interrupt Push Button
10 | User Test LED 1 | SOC_GPIO1_49 | GPIO | GPIO1_49 | MMC1_SDWP | OUTPUT | LOW | HIGH | VDDSHV0 | SoC_DVDD3V3

## IO EXPANDER - 01

1 | CPSW Ethernet PHY-2 Reset Control GPIO | GPIO_CPSW2_RST | RESET | IO EXPANDER - P01 | OUTPUT | HIGH | LOW | VDDSHV0 | SoC_DVDD3V3
2 | CPSW Ethernet PHY-1 Reset Control GPIO | GPIO_CPSW1_RST | RESET | IO EXPANDER - P01 | OUTPUT | HIGH | LOW | VDDSHV0 | SoC_DVDD3V3
3 | PRU Board Detection | PRU_DETECT | DETECTION | IO EXPANDER - P02 | INPUT | HIGH | LOW | VDDSHV0 | SoC_DVDD3V3
4 | SD Card Load Switch Enable | MMC1_SD_EN | ENABLE | IO EXPANDER -P03 | OUTPUT | HIGH | LOW | VDDSHV0 | SoC_DVDD3V3

5

SOC eFuse Voltage(VPP=1.8V) Regulator Enable | VPP_LDO_EN | ENABLE | IO EXPANDER - P04 | OUTPUT | LOW | HIGH | VDDSHV0 | SoC_DVDD3V3
6 | EXP CONN 3.3V Power Switch Enable | EXP_PS_3V3_EN | ENABLE | IO EXPANDER - P05 | OUTPUT | LOW | HIGH | VDDSHV0 | SoC_DVDD3V3
7 | EXP CONN 5V Power Switch Enable | EXP_PS_5V0_EN | ENABLE | IO EXPANDER - P06 | OUTPUT | LOW | HIGH | VDDSHV0 | SoC_DVDD3V3
8 | EXP CONN HAT Board Detection | RPI_HAT_DETECT | DETECTION | IO EXPANDER - P07 | INPUT | HIGH | LOW | VDDSHV0 | SoC_DVDD3V3
9 | M.2 Connector Alert | WLAN_ALERT_3V3 | ALERT | IO EXPANDER – P10 | OUTPUT | HIGH | LOW | VDDSHV0 | SoC_DVDD3V3
10 | M.2 Connector WAKEUP | BT_UART_WAKE_SOC_3V3 | WAKEUP | IO EXPANDER – P11 | OUTPUT | HIGH | LOW | VDDSHV0 | SoC_DVDD3V3
11 | SOC UART1 Mux Select | UART1_MUX_SEL | SELECT | IO EXPANDER - P12 | OUTPUT | LOW | HIGH | VDDSHV0 | SoC_DVDD3V3
12 | Enable for Wilink Level Translators | WL_LT_EN | ENABLE | IO EXPANDER - P13 | OUTPUT | LOW | HIGH | VDDSHV0 | SoC_DVDD3V3
13 | HDMI Transmitter Reset Control GPIO | GPIO_HDMI_RSTn | RESET | IO EXPANDER - P14 | OUTPUT | HIGH | LOW | VDDSHV0 | SoC_DVDD3V3
14 | Raspberry Pi Camera CSI0 GPIO1 | CSI_GPIO1 | INPUT/OUTPUT | IO EXPANDER - P15 | NA | NA | NA | VDDSHV0 | SoC_DVDD3V3
15 | Raspberry Pi Camera CSI0 GPIO2 | CSI_GPIO2 | INPUT/OUTPUT | IO EXPANDER - P16 | NA | NA | NA | VDDSHV0 | SoC_DVDD3V3
16 | PRU Power Switch Enable | PRU_3V3_EN | ENABLE | IO EXPANDER - P17 | OUTPUT | LOW | HIGH | VDDSHV0 | SoC_DVDD3V3
17 | HDMI Interrupt | HDMI_INTn | INTERRUPT | IO EXPANDER - P20 | INPUT | HIGH | LOW | VDDSHV0 | SoC_DVDD3V3
18 | TEST GPIO2 from Test Automation Connector | TEST_GPIO2 | GPIO for communications with AM62x | IO EXPANDER - P21 | INPUT | HIGH | LOW | VDDSHV0 | SoC_DVDD3V3
19 | MCASP2 Enable and Direction Control | AUD_BUF_EN | ENABLE | IO EXPANDER - P22 | OUTPUT | LOW | HIGH | VDDSHV0 | SoC_DVDD3V3
20 | | WL_BUF_EN | ENABLE | IO EXPANDER - P23 | OUTPUT | HIGH | LOW | VDDSHV0 | SoC_DVDD3V3
21 | | AUD_BUF_CLK_DIR | DIRECTION CONTROL | IO EXPANDER - P24 | OUTPUT | HIGH | LOW | VDDSHV0 | SoC_DVDD3V3
22 | | WL_BUF_CLK_DIR | DIRECTION CONTROL | IO EXPANDER - P25 | OUTPUT | HIGH | LOW | VDDSHV0 | SoC_DVDD3V3
23 | OLDI Display Touch Interrupt | TS_INT# | INTERRUPT | IO EXPANDER - P26 | INPUT | HIGH | LOW | VDDSHV0 | SoC_DVDD3V3
24 | User Test LED 2 | IO_EXP_TEST_LED | GPIO | IO EXPANDER - P27 | OUTPUT | LOW | HIGH | VDDSHV0 | SoC_DVDD3V3

## IO EXPANDER - 02

1 | M.2 Connector SDIO Reset Control GPIO | WLAN_SDIO_RST_3V3 | RESET | IO EXPANDER – P0 | INPUT | HIGH | LOW | VDDSHV0 | SoC_DVDD3V3
2 | OLDI Display Reset control | GPIO_TS_RSTn | RESET | IO EXPANDER – P1 | INPUT | HIGH | LOW | VDDSHV0 | SoC_DVDD3V3
3 | Audio Codec Reset Control GPIO | GPIO_AUD_RSTn | DETECTION | IO EXPANDER – P2 | INPUT | HIGH | LOW | VDDSHV0 | SoC_DVDD3V3
4 | eMMC Reset control GPIO | GPIO_eMMC_RSTn | RESET | IO EXPANDER – P3 | OUTPUT | HIGH | LOW | VDDSHV0 | SoC_DVDD3V3

# GPIO MAPPING TABLE

Designed for TI by Mistral Solutions Pvt Ltd | A1 GPIO MAPPING TABLE C | Monday, May 27, 2024 | 8 | 44 PROC142A1(002)
Designed for TI by Mistral Solutions Pvt Ltd | A1 GPIO MAPPING TABLE C | Monday, May 27, 2024 | 8 | 44 PROC142A1(002)
Designed for TI by Mistral Solutions Pvt Ltd | A1 GPIO MAPPING TABLE C | Monday, May 27, 2024 | 8 | 44 PROC142A1(002)

# USB TYPE-C PD CONTROLLER AND POWER SUPPLY

## Silk: TYPE-C PWR

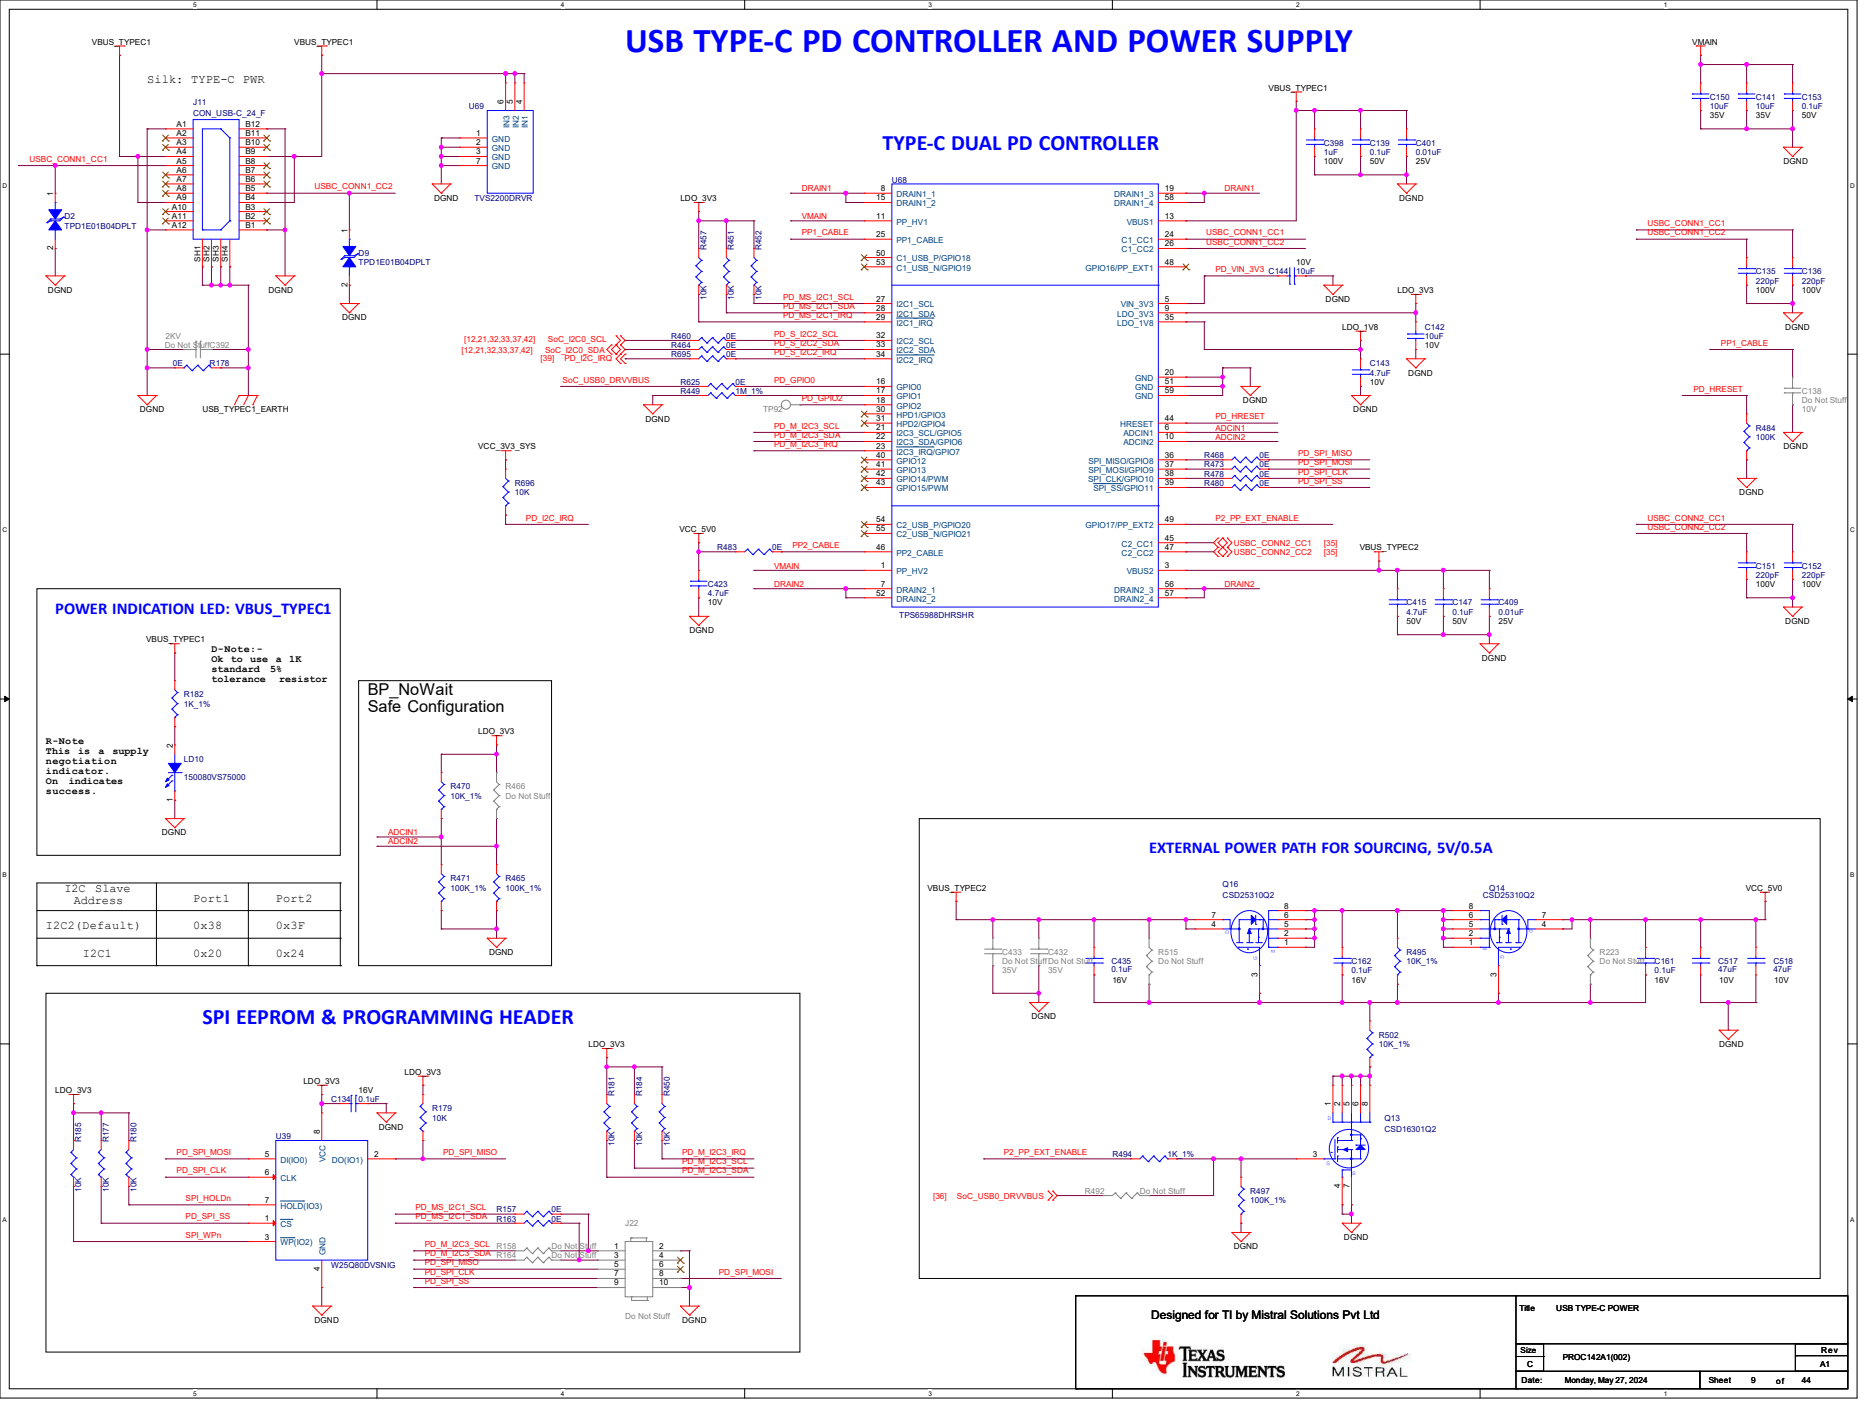
[picture p26: page 9]

6 GND 1 GND 2 GND 3 GND 7
U69TVS2200DRVRIN¹

TYPE-C DUAL PD CONTROLLER

EXTERNAL POWER PATH FOR SOURCING, 5V/0.5A

SPI EEPROM & PROGRAMMING HEADER

4 DO(IO1) 2 DI(IO0) 5 CS 1 WP(IO2) 3 CLK 6 HOLD(IO3) 7

# PERIPHERAL POWER SUPPLIES - 1

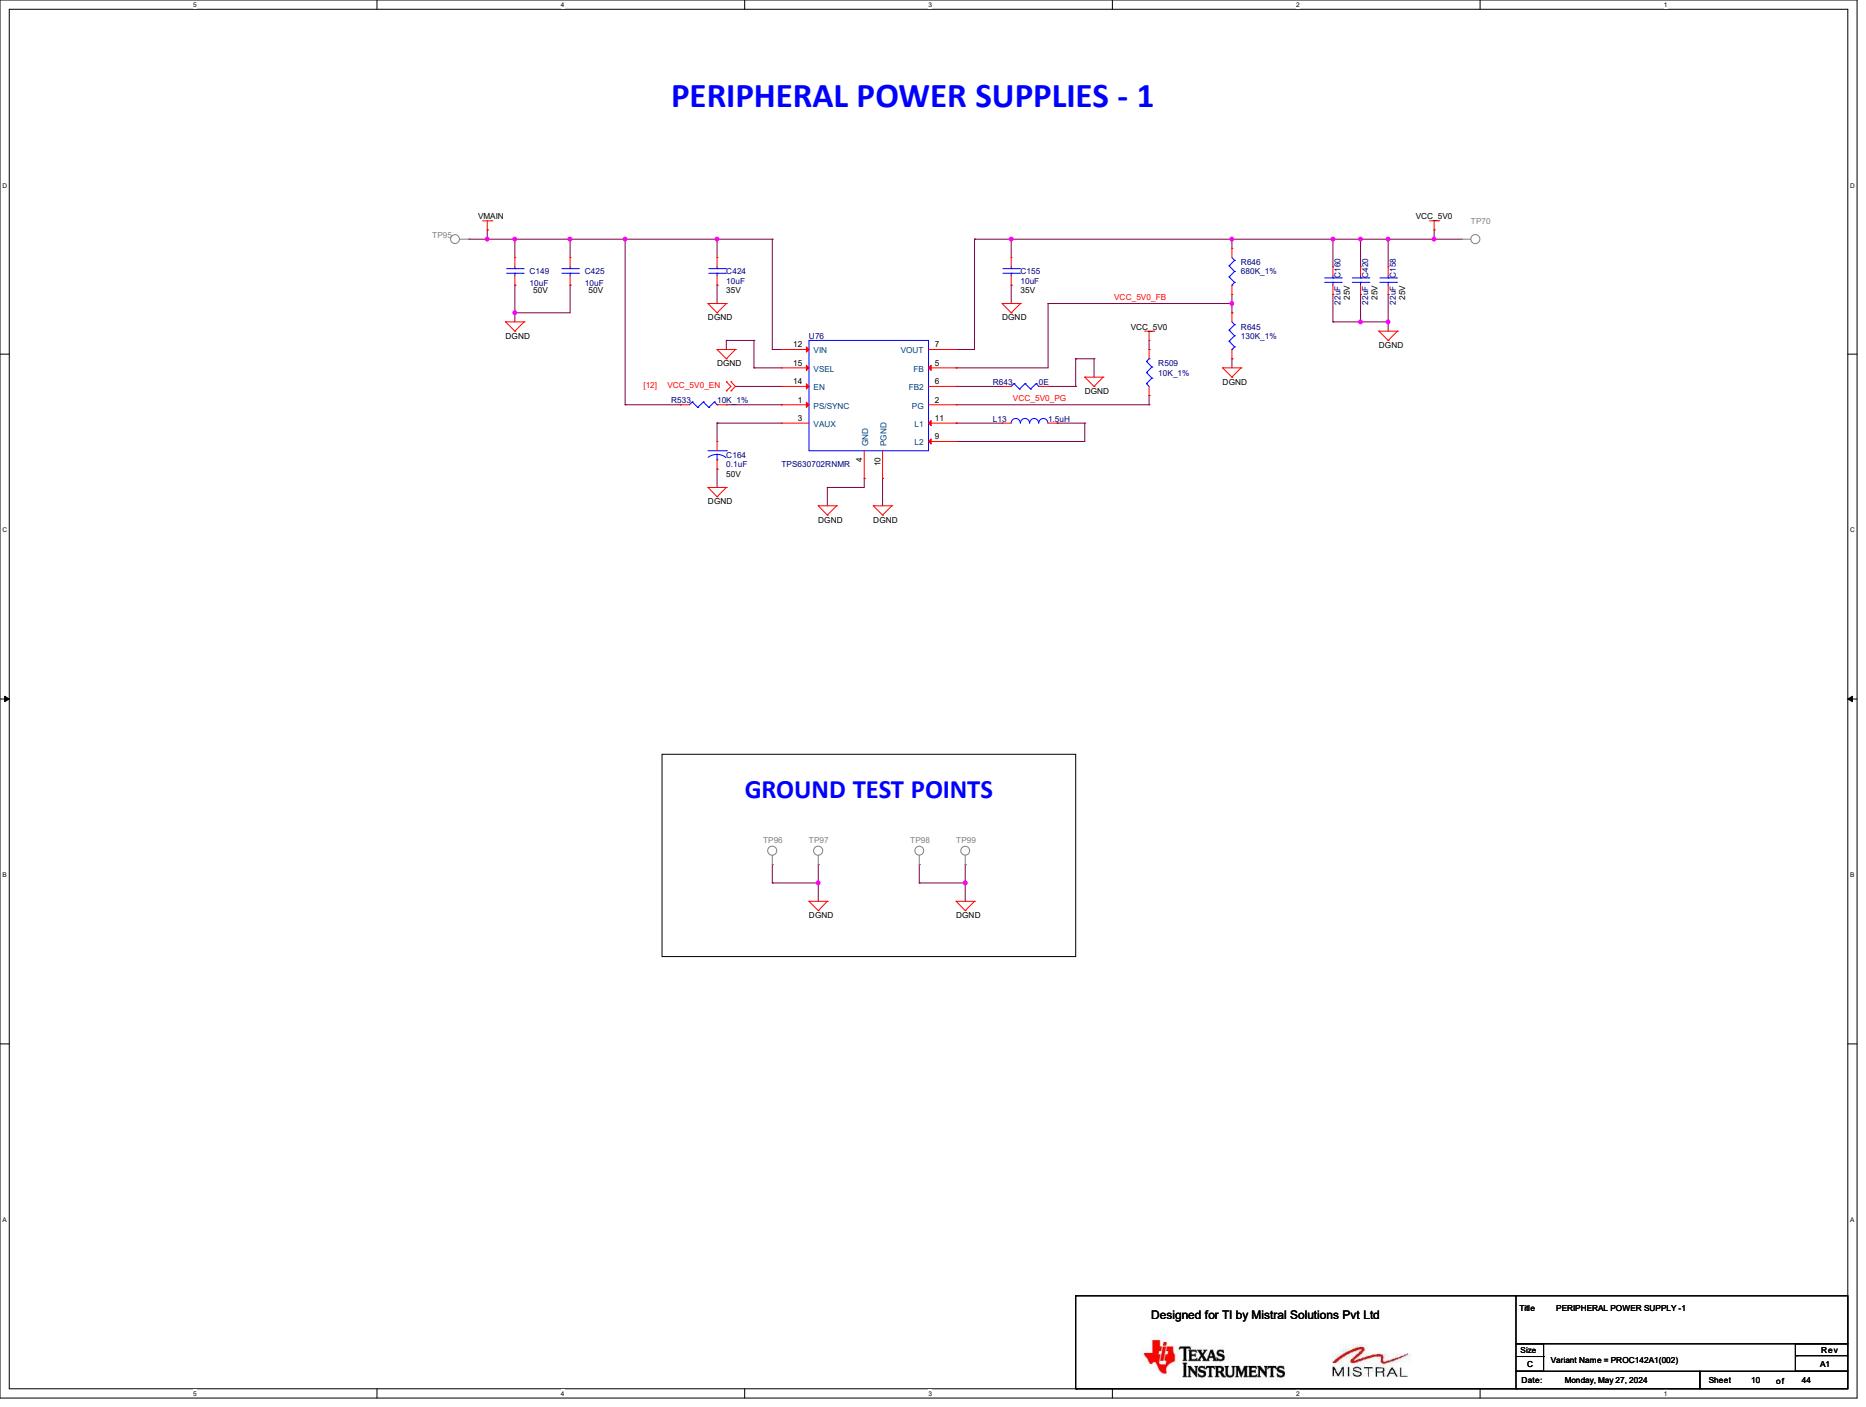
[picture p27: page 10]

4 FB 5 FB2 6 VOUT 7 PGND 10 VIN 12 EN 14 VSEL 15

# 3.3V, 6.0 AMPS SUPPLY

# PERIPHERAL POWER SUPPLIES - 2

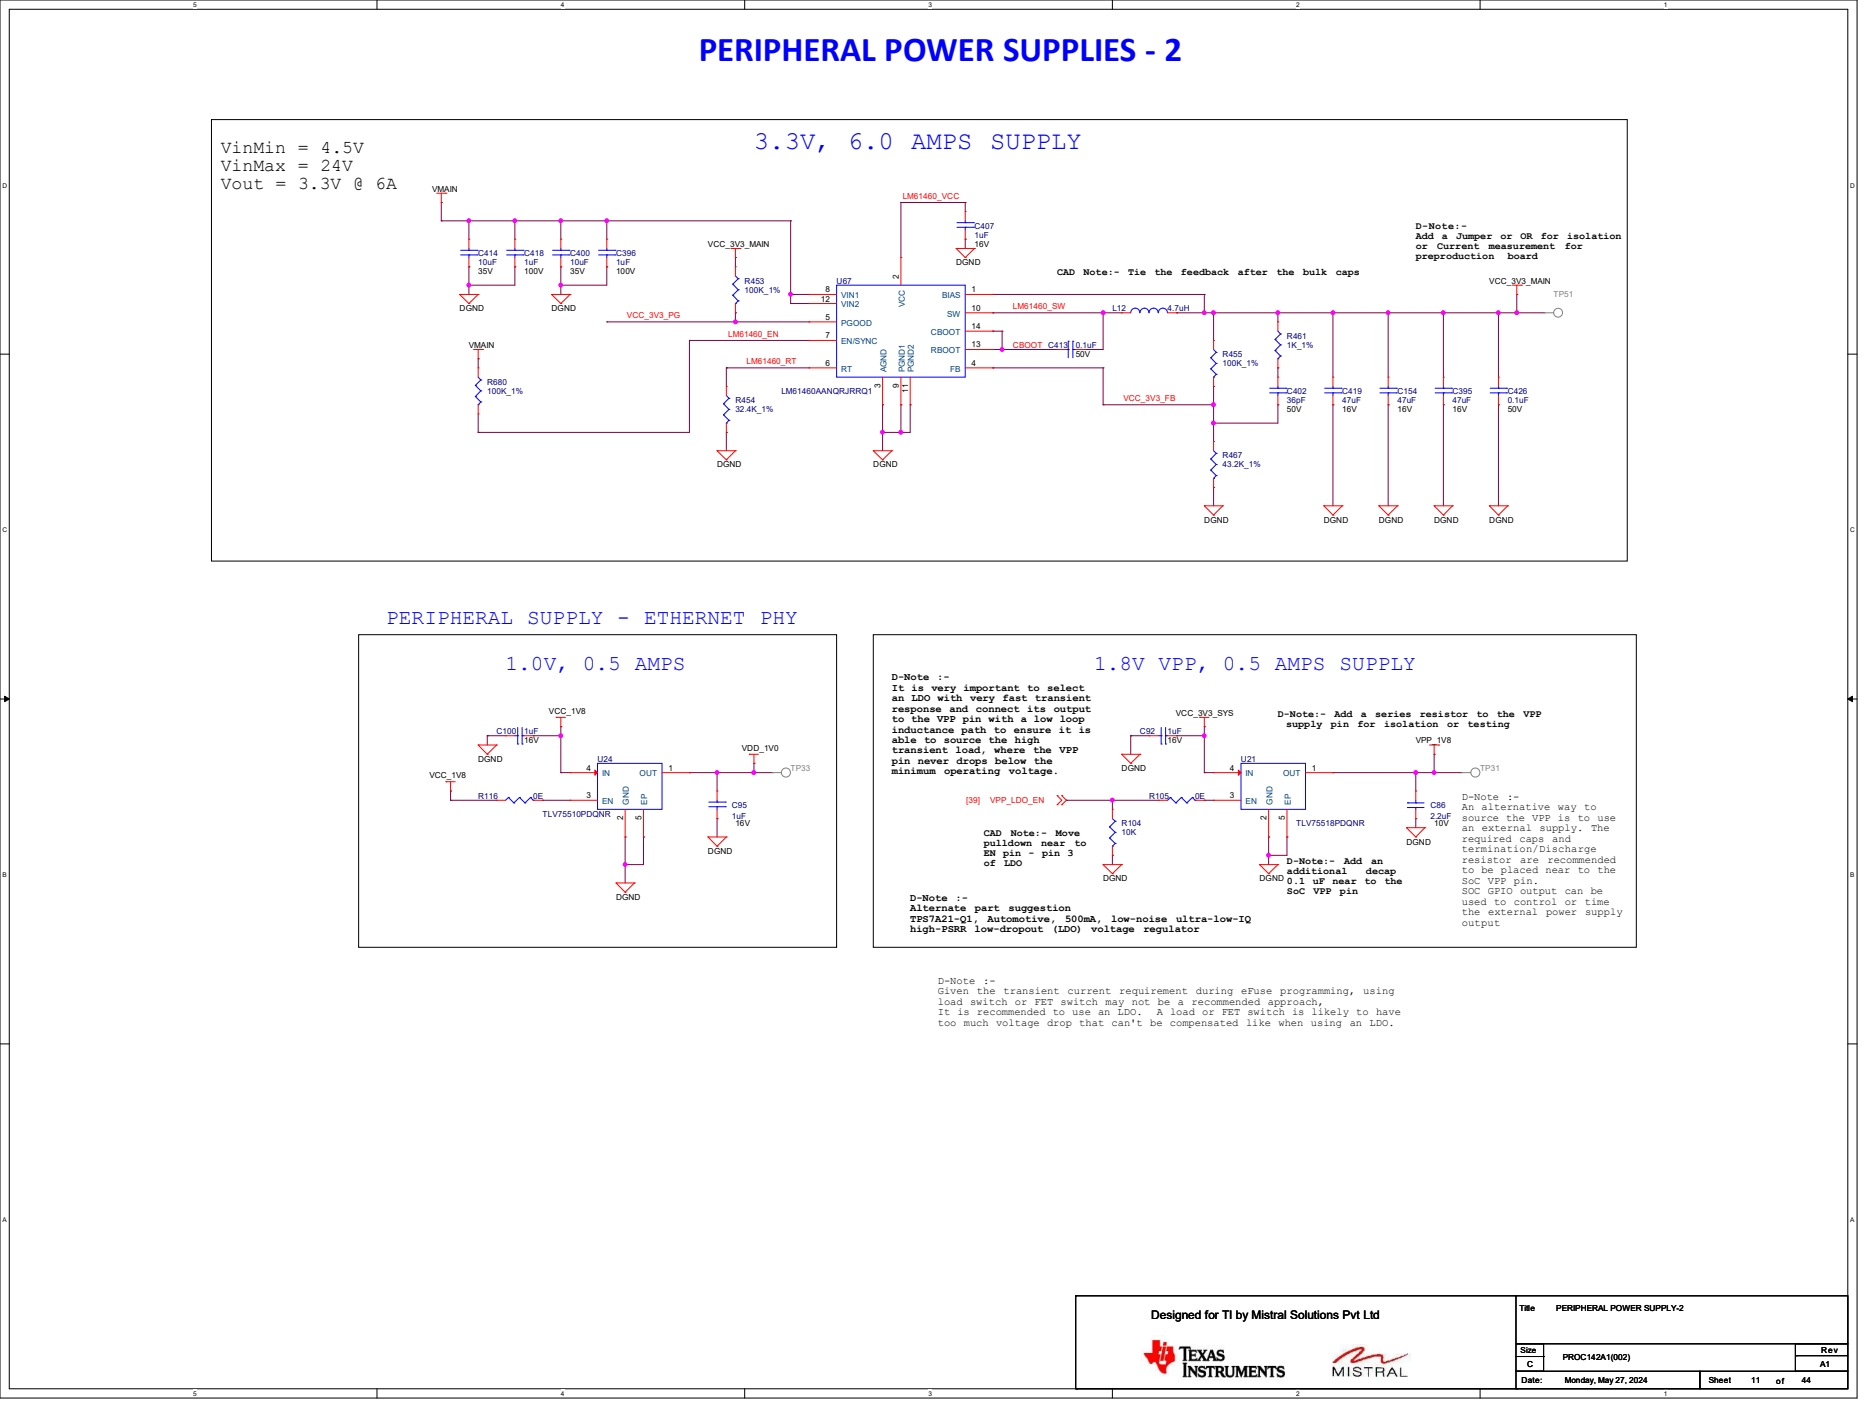
[picture p28: page 11]

D-Note:-
Add a Jumper or OR for isolation
or Current measurement for
preproduction board

CAD Note:- Tie the feedback after the bulk caps

3 FB 4 PGOOD 5 RT 6 EN/SYNC 7 VIN1 8 PGND1

PERIPHERAL SUPPLY - ETHERNET PHY

D-Note :-
It is very important to select
an LDO with very fast transient
response and connect its output
to the VPP pin with a low loop
inductance path to ensure it is
able to source the high
transient load, where the VPP
pin never drops below the
minimum operating voltage.

D-Note:- Add a series resistor to the VPP
supply pin for isolation or testing

An alternative way to
source the VPP is to use
an external supply. The
required caps and
termination/Discharge
resistor are recommended
to be placed near to the
SoC VPP pin.
SOC GPIO output can be
used to control or time
the external power supply
output

D-Note:- Add an
0.1 uF near to the
SoC VPP pin

Alternate part suggestion
TPS7A21-Q1, Automotive, 500mA, low-noise ultra-low-IQ
high-PSRR low-dropout (LDO) voltage regulator

Given the transient current requirement during eFuse programming, using
load switch or FET switch may not be a recommended approach,
It is recommended to use an LDO. A load or FET switch is likely to have
too much voltage drop that can't be compensated like when using an LDO.

# SOC POWER SUPPLY PMIC TPS6521904 PMIC

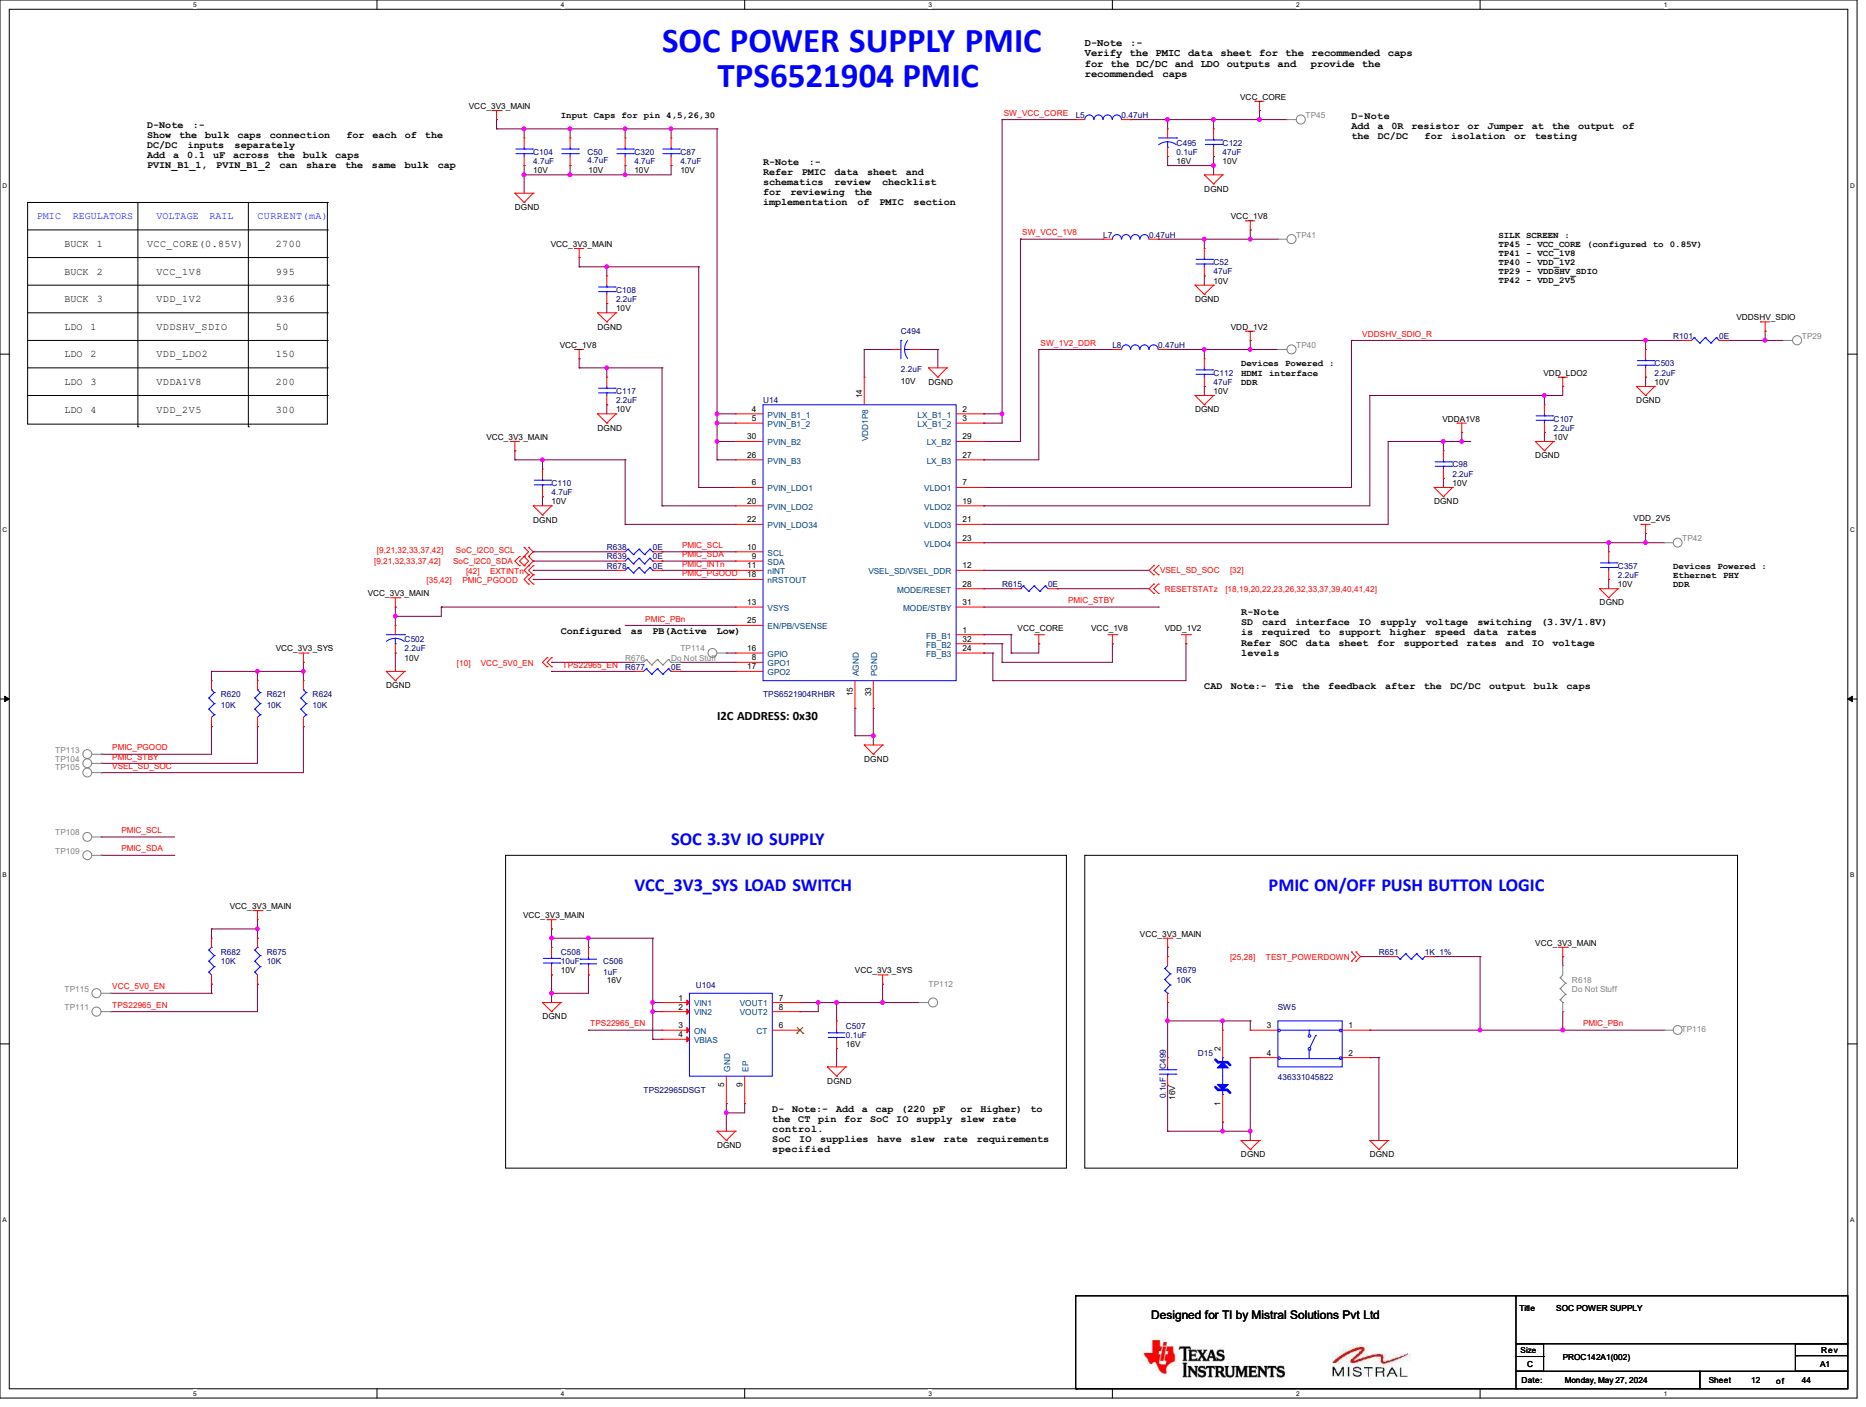
[picture p29: page 12]

D-Note :-
Verify the PMIC data sheet for the recommended caps
recommended caps

Input Caps for pin 4,5,26,30

D-Note
Add a 0R resistor or Jumper at the output of

DC/DC inputs separately
Add a 0.1 uF across the bulk caps
PVIN_B1_1, PVIN_B1_2 can share the same bulk cap

R-Note :-
Refer PMIC data sheet and
schematics review checklist
for reviewing the
implementation of PMIC section

R-Note
SD card interface IO supply voltage switching (3.3V/1.8V)
is required to support higher speed data rates
Refer SOC data sheet for supported rates and IO voltage
levels

Configured as PB(Active Low)

CAD Note:- Tie the feedback after the DC/DC output bulk caps

PMIC ON/OFF PUSH BUTTON LOGIC

the CT pin for SoC IO supply slew rate
control.
SoC IO supplies have slew rate requirements
specified

# CURRENT MONITORING DEVICES

# VDD_CORE

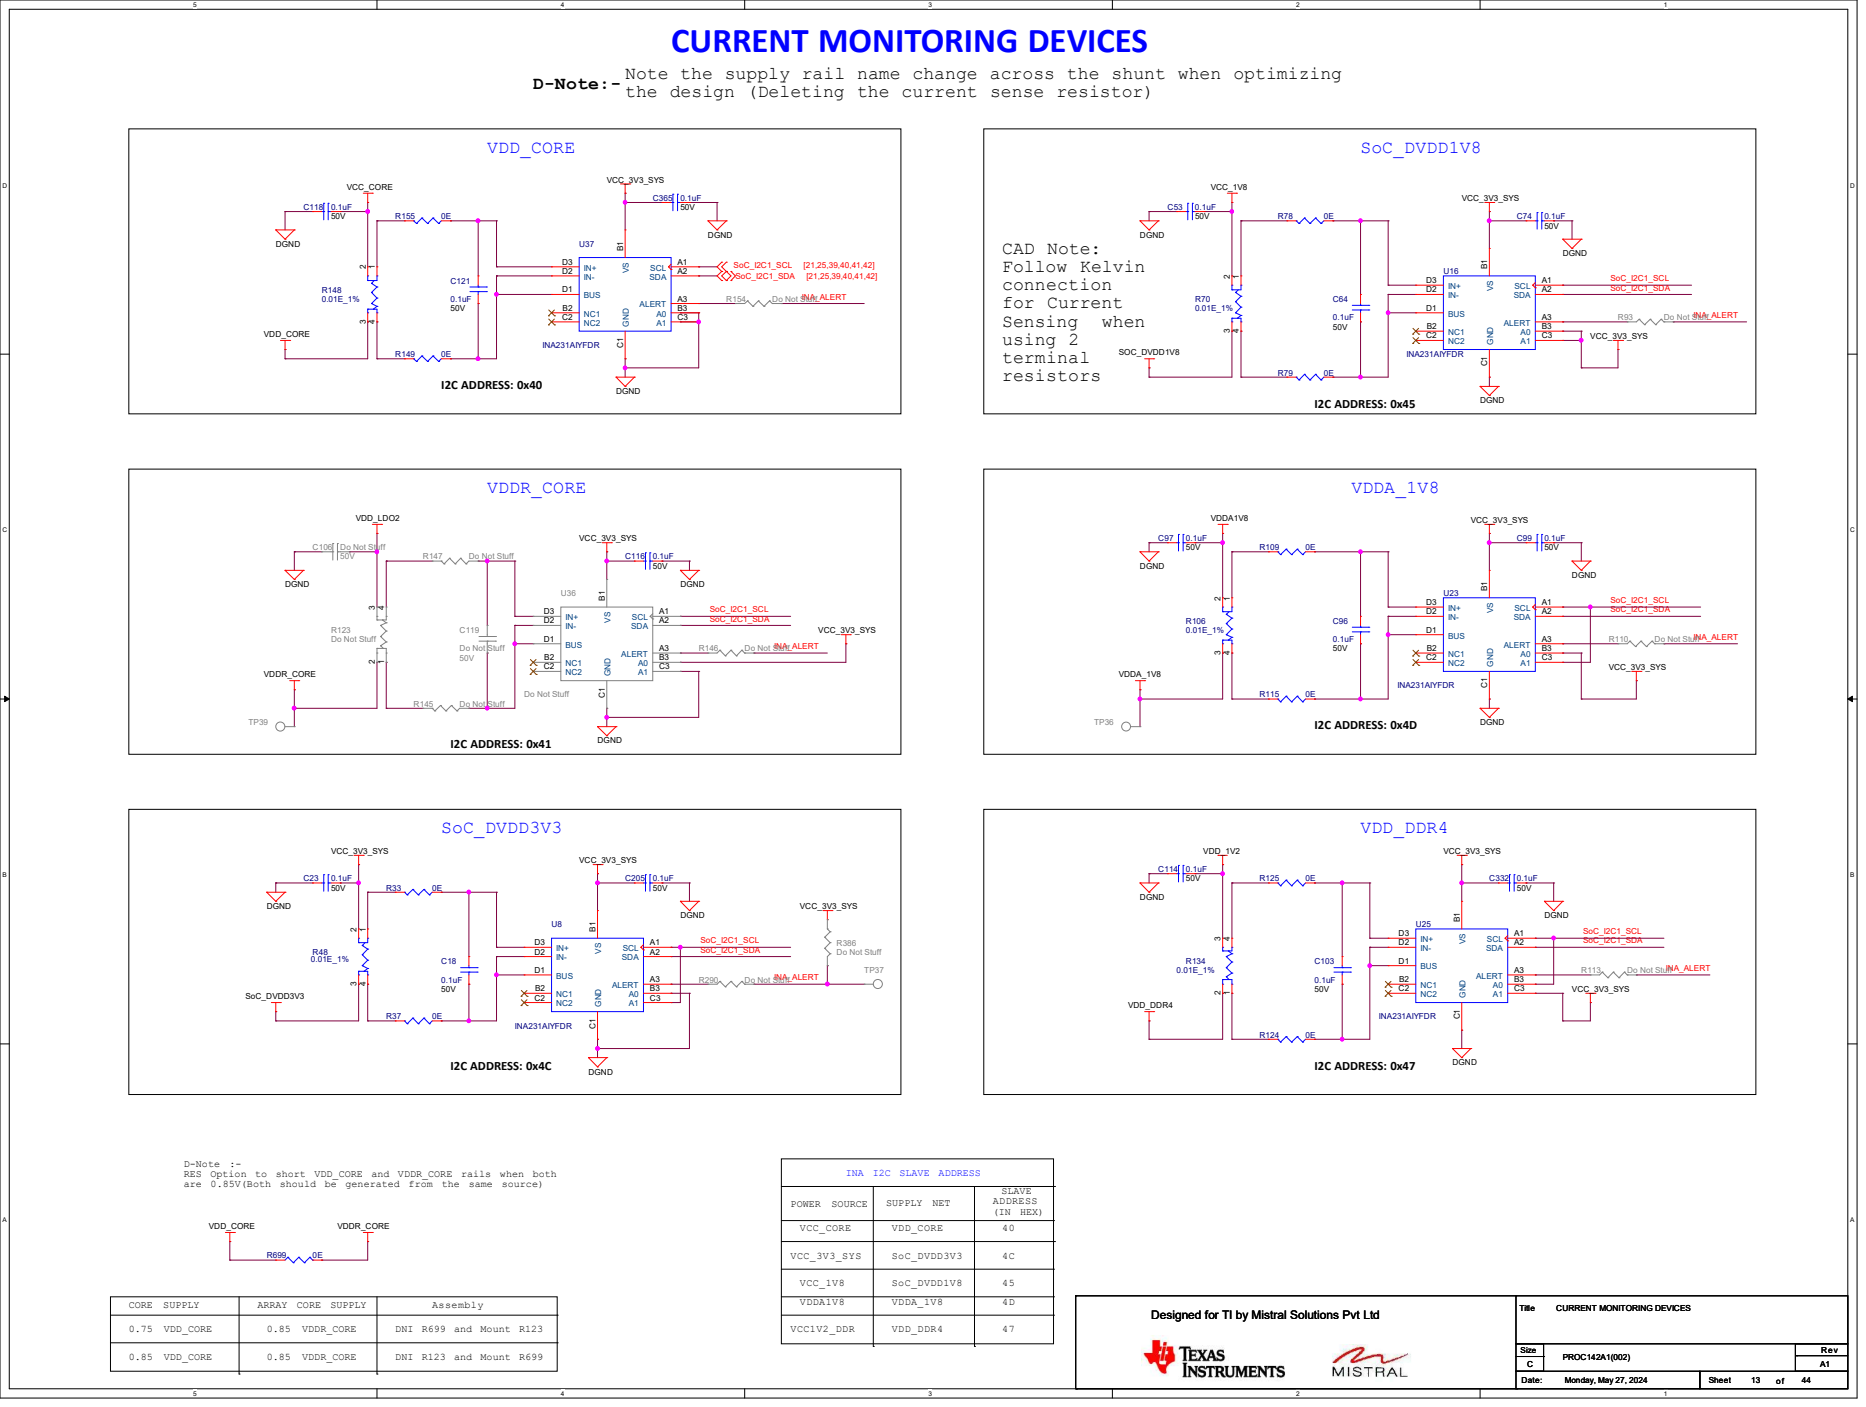
[picture p30: page 13]

the design (Deleting the current sense resistor) D-Note:-

Note the supply rail name change across the shunt when optimizing

D-Note :-
RES Option to short VDD_CORE and VDDR_CORE rails when both
are 0.85V(Both should be generated from the same source)

D D

C C

B B

A A

1.8V ANALOG SUPPLIES | CORE SUPPLIES

# 3.3V/1.8V MMC1 SUPPLY

# SOC POWER

### R-Note:- Reserved pin Leave unconnected

Internal purpose only

### D-Note :- VDD_CORE and VDDR_CORE are recommended to be powered by the same source so they ramp together when VDD_CORE is operating at 0.85V

### D-Note :-Select cap with less the 1 ohm ESR Ensure the PCB loop inductance is < 2.5 nH Select 0201 package or smallest possible package Refer SoC Data sheet

### D-Note :-Add a bulk cap 1 uF to minimize resonance

### D-Note :-Recommend implementing the voltage monitoring functionality using VMON_VSYS for early detection of supply failure It is meant to be a power-fail indicator for the main input ( higher) voltage rail

that enters the PCB. For example, 5, 12, or 24 volts.

### The error associated with this monitor would require you to set the threshold significantly lower than the nominal to avoid false trigger Refer System Power Supply Monitor Design Guidelines section of the data sheet

### R-Note Connecting 1.8V supply source directly to VPP continuously is not allowed

### D-Note :-Refer Pin connectivity requirements to connect the CSI0 supplies (analog and core) when CSI0 interface is not used Ferrite and Bulk Caps are optional when CSI0 is not used and Boundary scan functionality is required

### D-Note :-Common SOC LVCMOS IO interface guidelines

1. Most of the SOC IOs are not fail-safe. No input should be applied before supply ramps.

### 2. SOC LVCMOS inputs have minimum slew rate requirements specified

3. SOC IO buffers are off during Reset. A pull is required near to the attached device being

### driven by the SOC IOs 4. Any SOC IO that has a trace connected and not being actively driven needs a parallel

pull. When adding pull is not feasible, ensure the traces are routed away from noisy signals

### D-Note :-Changing the core voltage is not allowed after the device has been released from reset. If you turn off the core supply, we expect you to turn off all power rails and ramp them down per the power-down sequence and wait untill all supply rails decay below 300mv before turning on

power again.

### D-Note :-

Refer pin connectivity table of the SOC data sheet for connecting the USB IO, analog and core supplies when USB interface is not used.

### It is acceptable to have the supplies connected and all the USB pins left unconnected provided the USB driver is not initialized any time and the USB

calibration procedure does not happen.

### Grounding the USB supplies as per pin connectivity requirements when not used

saves power when low power is a critical requirement.

### D-Note :-

A Trace connected to SOC is effectively an antenna that will pick up noise.

### A potential will be generated on the signal when noise couples into the antenna. This potential will be largest on the highest impedance end of the

signal.

### By placing a pull-up or pull-down near the SoC pin, we force the highest potential to the open-circuit end of the signal rather than the SoC end of the

signal.

VDDA_SYS_MON

CAP_VDDS0

CAP_VDDS2

CAP_VDDS1

CAP_VDDS3
CAP_VDDS4
CAP_VDDS5
CAP_VDDS6

CAP_VDDS_MCU

CAP_VDDS_CANUART

VDDA_SYS_MON

# TEMP_DIODE_P DGND

VDDA_1V8_CSIRX | VDDA_1V8_CSIRX DGND

VDDA_1V8_USB DGND

VDDA_1V8_USB DGND

VDDA_1V8

VDDA_1V8 | VDDA_1V8_USB | DGND | DGND
VDDA_1V8_MCU | VDDA_1V8_MCU
VDDA_1V8 | VDDA_PLL0
VDDA_1V8 | VDDA_1V8_MCU
VDDA_1V8 | VDDA_PLL1 | DGND | DGND
VDDA_PLL0 | VDDA_PLL0 DGND | DGND
VDDA_PLL1 | VDDA_PLL1

VDD_CORE

VDD_CORE

VDDA_CORE_USB | DGND | DGND
DGND | DGND
VDDA_1V8 | VDDA_PLL2 | DGND | DGND
VDDA_PLL2 | VDDA_PLL2 | DGND

VDDSHV_SDIO

DGND | DGND
VDDA_1V8 | VDDA_1V8_OLDI
VDDA_1V8_OLDI | VDDA_1V8_OLDI

VDDA_CORE_USB

VDDA_CORE_CSI

VDDA_CORE_CSI | VDDA_CORE_CSI

VDDA_CORE_USB

VDD_CORE | VDD_CANUART | DGND | DGND
| | VDD_CANUART | VDD_CANUART

SoC_VDDSHV5_SDIO

SoC_VDDSHV5_SDIO

VDD_CORE

VDDR_CORE

VPP_1V8

VDDA_1V8

SoC_DVDD3V3

VDD_CANUART

VDD_DDR4

VDD_DDR4 | DGND

SoC_DVDD3V3

SoC_DVDD1V8

SoC_DVDD3V3

SoC_VDDSHV5_SDIO

SoC_DVDD1V8

SoC_DVDD3V3

VDDA_1V8

VDDA_1V8

VDDA_PLL1

VDDA_PLL2

VDDA_PLL0 | VDDA_1V8_MCU

VDDA_1V8_USB

SoC_DVDD1V8

VDDA_1V8_OLDI

SoC_DVDD3V3

VDDA_1V8_CSIRX

VDDA_CORE_CSI

VDDA_CORE_USB

VDDA_1V8_CSIRX

SoC_DVDD1V8

DGND

VCC_3V3_MAIN

Designed for TI by Mistral Solutions Pvt Ltd | A1 SOC POWER C | Monday, May 27, 2024 | 14 | 44 Variant Name = PROC142A1(002)
Designed for TI by Mistral Solutions Pvt Ltd | A1 SOC POWER C | Monday, May 27, 2024 | 14 | 44 Variant Name = PROC142A1(002)
Designed for TI by Mistral Solutions Pvt Ltd | A1 SOC POWER C | Monday, May 27, 2024 | 14 | 44 Variant Name = PROC142A1(002)

C281

0.01uF

25V C283

0.1uF C41 | 16V

4.7uF
10V

C258

1uF
16V

C246

1uF
16V

FL3

120E

1 2

C256

1uF
16V

FL19

120E

1 | 2 | C48 4.7uF 10V

FL7

26E

1 2

C263

0.1uF
16V

U12P

AM6254ATCGHAALW

CAP_VDDS_CANUART G9 | CAP_VDDS_MCU H11 | CAP_VDDS0 H15 | CAP_VDDS1 K18 | CAP_VDDS2 W17 | CAP_VDDS3 P19 | CAP_VDDS4 U7 | CAP_VDDS5 H17 | CAP_VDDS6 J19 C257

1uF
16V

C290

0.01uF

25V | C51
| 0.01uF

25V C221

0.1uF
16V C285

1uF
16V

FL18

26E

1 2 FL5

120E

1 2

C302

1uF
16V

C284

0.1uF
16V

C298

0.1uF

16V | C220
| 0.01uF

25V C243

0.1uF
16V | C88

1uF

16V | C300
| 0.1uF 16V

C251

1uF
16V

C49

4.7uF
10V

FL6

120E

1 | 2 | C296

0.01uF

25V C90

0.01uF

25V | C57 4.7uF 10V

FL14

120E

1 2

R108
9.76K_0.1%

FL16

120E

1 | 2 | C54
0.1uF C299 | 16V

1uF
16V

C269

1uF
16V

C275

0.1uF
16V

R375
56.2K_1%

C89

0.1uF
16V

C239

1uF
16V
TP122 | C289

0.01uF
25V C297

4.7uF
10V

C519
22pF
25V

FL4

26E

1 2

## ANALOG AND DIGITAL U12Q

AM6254ATCGHAALW

VDDS_OSC0 G7 | VDDS_DDR_C M9 | VDDA_TEMP1 | G16 VDDA_MCU | L11 VDDA_PLL2 | L14 VDDA_TEMP0 | T9 VDDA_PLL0 | U11 VDDA_PLL1 | U15 VDDA_1P8_OLDI0 | W9 VDDA_1P8_OLDI0 | W10 VDDA_CORE_USB W12 VDDA_CORE_CSIRX0 | W13 VDDA_1P8_CSIRX0 | W14 VDDA_1P8_USB Y11 VDDA_3P3_USB Y13 RSVD8 E7 | VDD_CANUART F8 | VMON_1P8_SOC G10 | VMON_VSYS H10 | VPP J8 | VMON_3P3_SOC K10
VDD_CORE H8 | VDD_CORE J11 | VDD_CORE J14 | VDD_CORE K17 | VDD_CORE L12 | VDD_CORE L15 | VDD_CORE M16 | VDD_CORE N8 | VDD_CORE N11 | VDD_CORE N13 | VDD_CORE P17 | VDD_CORE R11 | VDD_CORE R14 | VDD_CORE U12 | VDD_CORE V8 | VDD_CORE V15 | VDD_CORE V17 | VDDS_DDR K9 | VDDS_DDR L8 | VDDS_DDR P9 | VDDS_DDR R8 | VDDR_CORE K16 | VDDR_CORE N12 | VDDR_CORE N14 | VDDR_CORE P16 | VDDR_CORE R12 | VDDR_CORE T10 | VDDR_CORE U14 | VDDR_CORE J12
VDDSHV0 | F15 VDDSHV0 | G14 VDDSHV1 | L18 VDDSHV1 | M19 VDDSHV4 | T7 VDDSHV2 | W16 VDDSHV2 | W19 VDDSHV_MCU | F11 VDDSHV_MCU | G12 VDDSHV3 | N18 VDDSHV3 | P18 VDDSHV3 | T19 VDDSHV3 | U18 VDDSHV5 | G17 VDDSHV6 | J18 VDDSHV_CANUART | H9

C222

1uF
16V

FL9

120E

1 2

C270

0.01uF

25V | C245
| 0.1uF 16V

C276

1uF
16V

C288

0.01uF
25V

FL13

120E

1 2 C287

0.01uF
25V

C294

1uF
16V

# SOC POWER SUPPLIES - DECAPS

# CAD Note:- Place 0.1 uF caps near to SoC pins

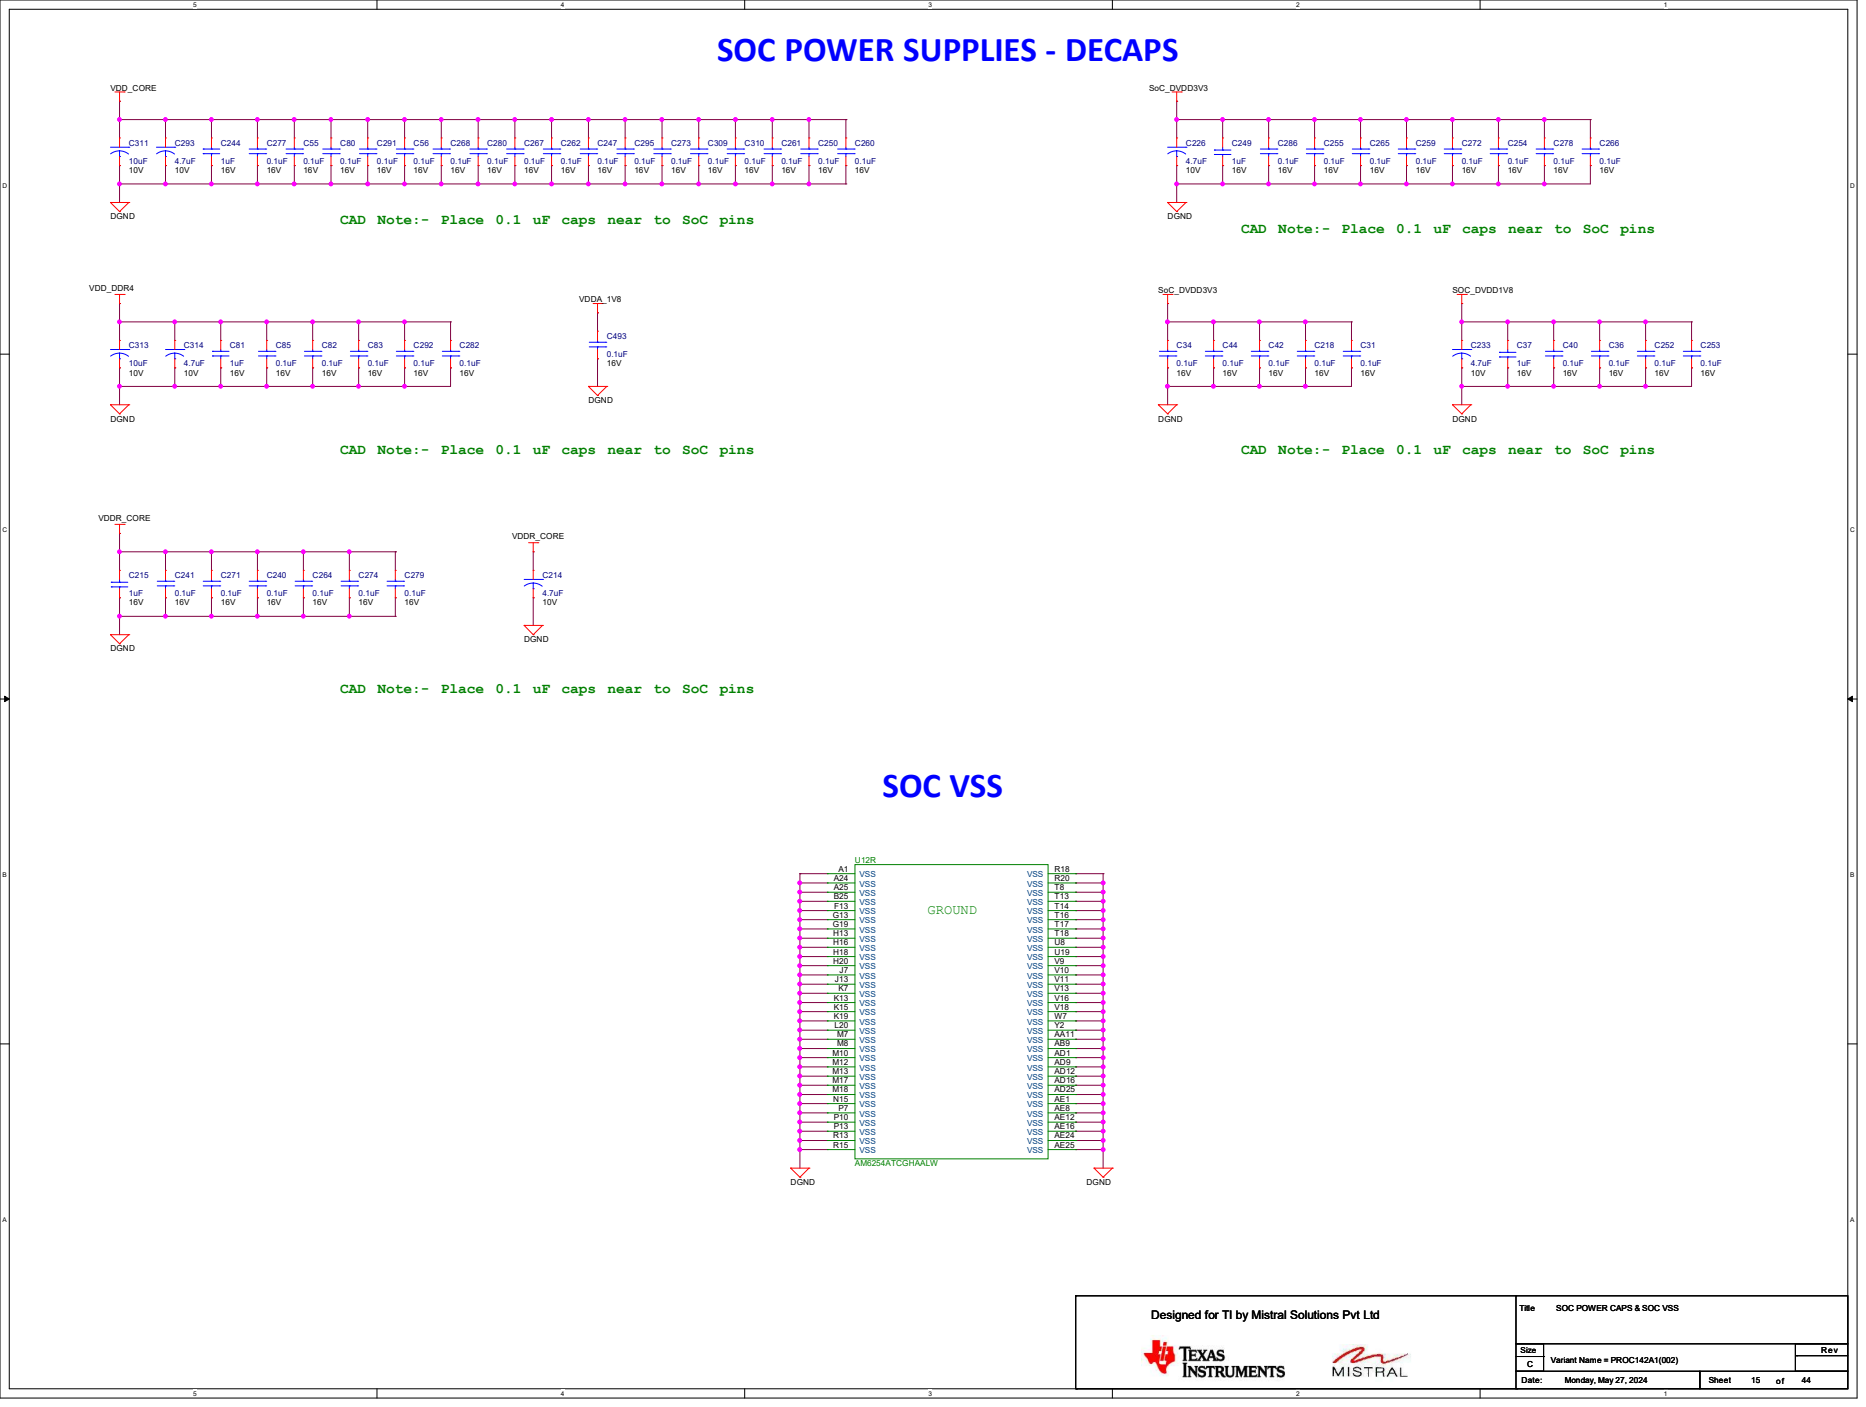
[picture p31: page 15]

CAD Note:- Place 0.1 uF caps near to SoC pins

# SOC DDR4 INTERFACE
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
