shikhakath/APE-SingleBoardComputer/reference/2_PROC142A/6_Assembly_Models_Package/Assembly Drawing/PROC142A_ASSEMBLY.pdf

C32 C19

# PROC142A ASSEMBLY TOP REV.A

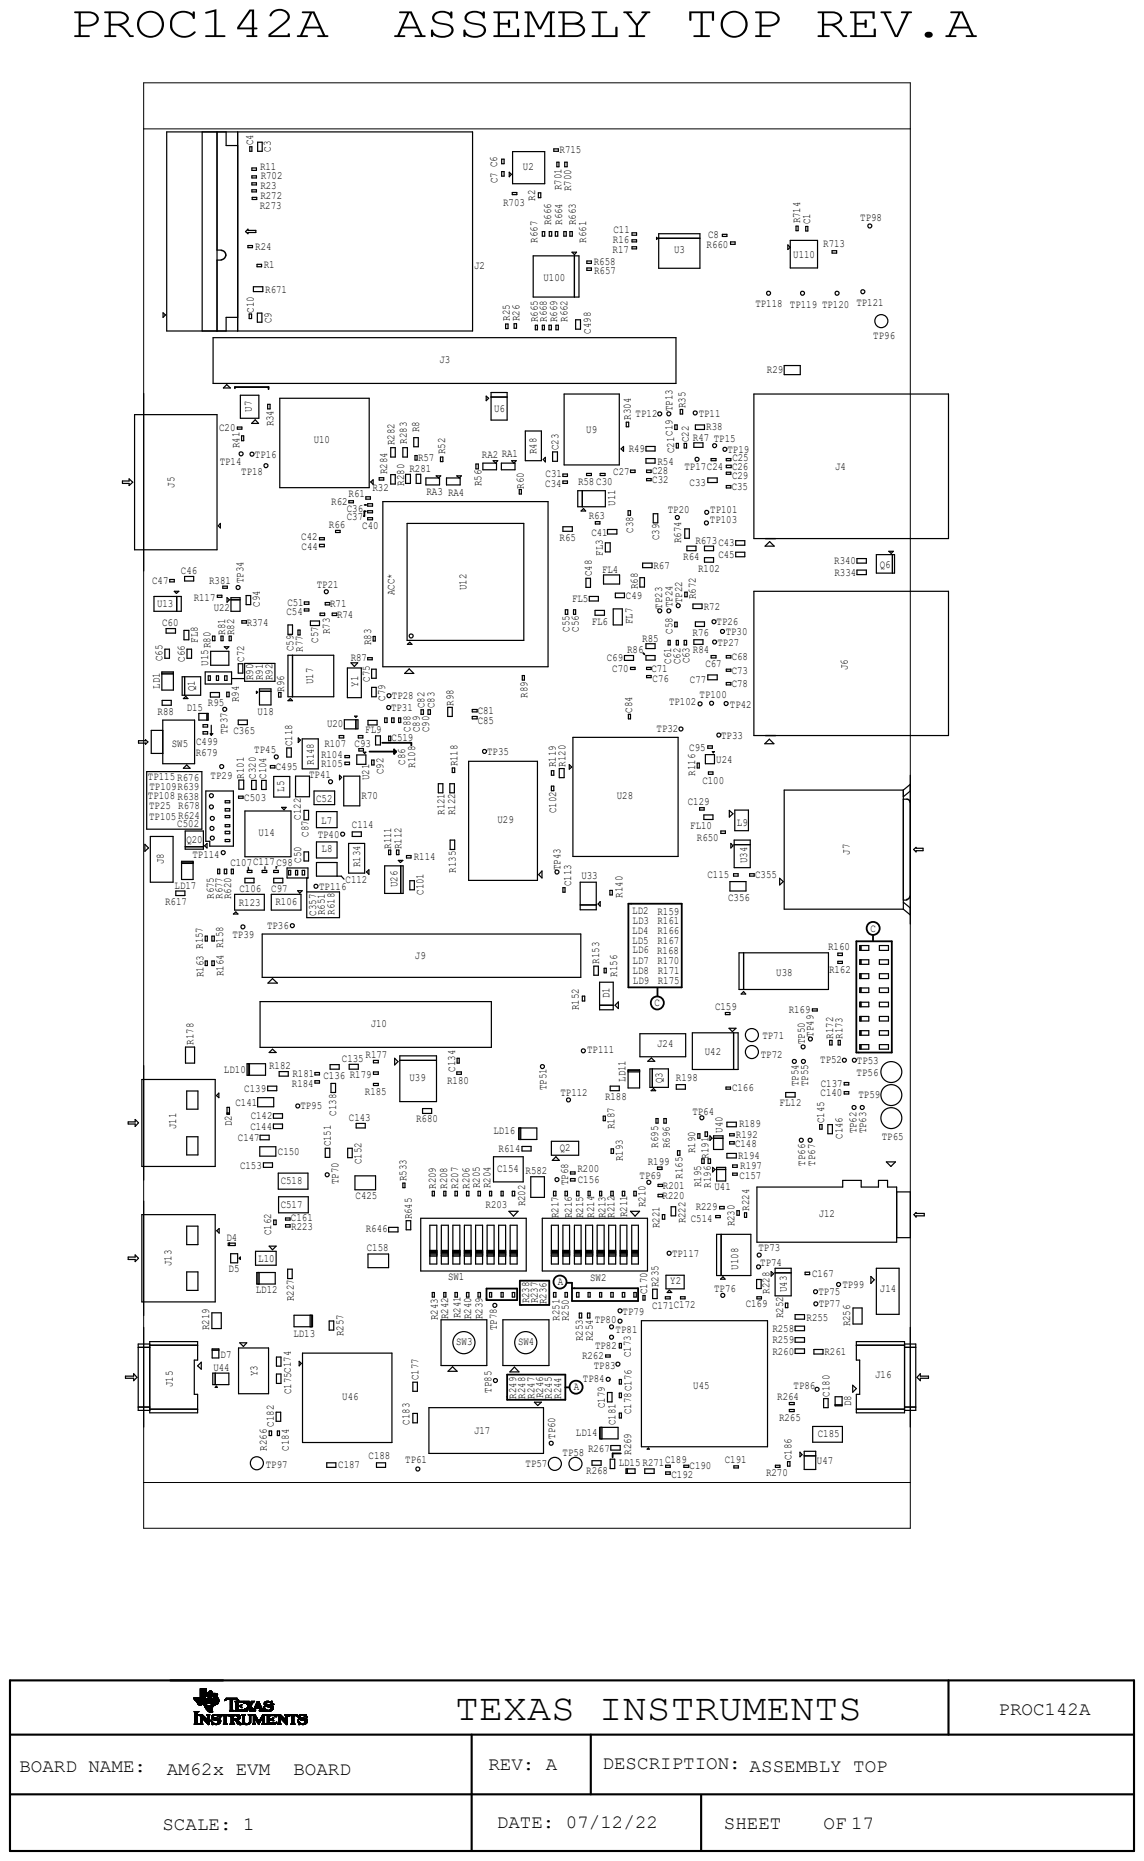
[picture p32: page 1]

C260 C279

# C381C196 C15

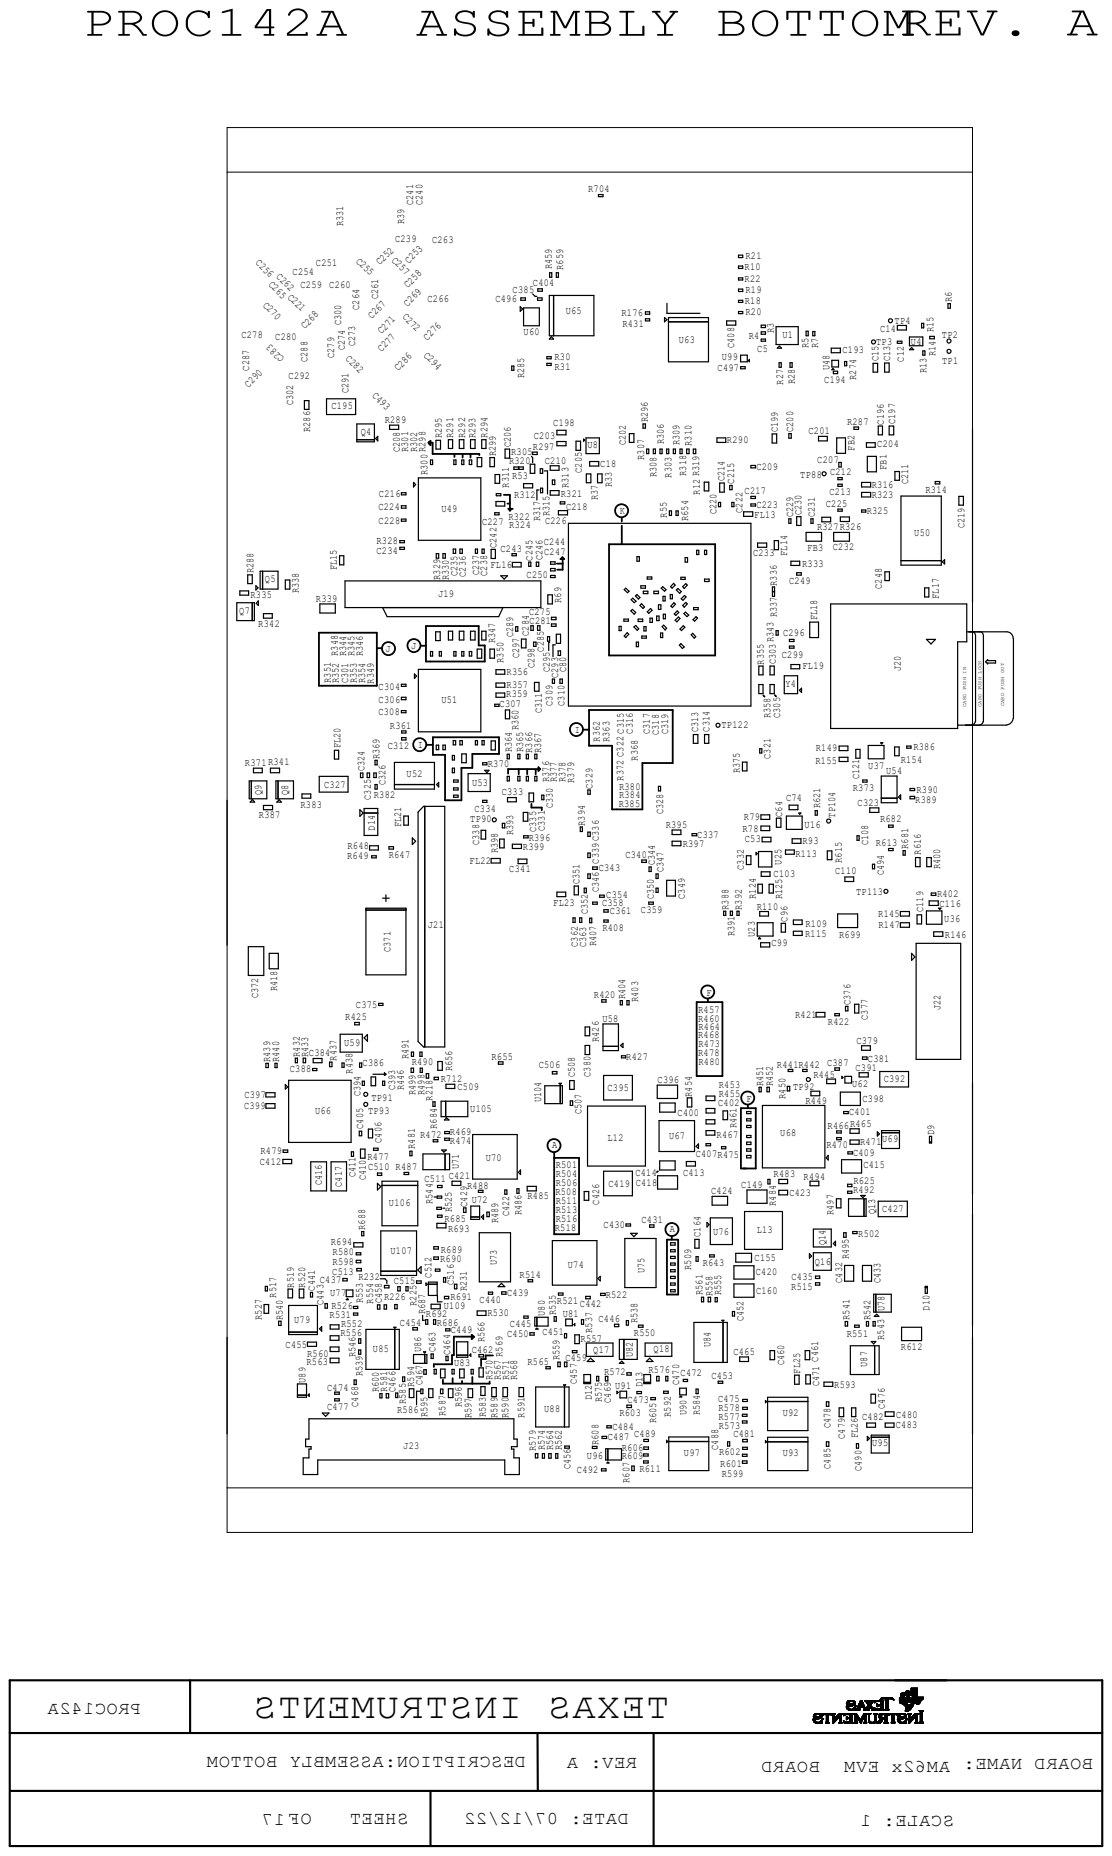
[picture p33: page 2]
