shikhakath/APE-SingleBoardComputer/(list of files, drawings)

Other design files:
hardware/APE - Single Board Computer.PrjPcb
hardware/Main.SchDoc
hardware/PCB.PcbDoc
hardware/sch/01_Power_Input.SchDoc
hardware/sch/02_PMIC.SchDoc
hardware/sch/03_SiP_Power.SchDoc
hardware/sch/04_SiP_GND_NC.SchDoc
hardware/sch/05_SiP_IO.SchDoc
hardware/sch/06_Clock_Reset_Boot.SchDoc
hardware/sch/07_Storage.SchDoc
hardware/sch/08_Ethernet.SchDoc
hardware/sch/09_USB.SchDoc
hardware/sch/10_HDMI.SchDoc
hardware/sch/11_Audio.SchDoc
hardware/sch/12_Camera.SchDoc
hardware/sch/13_Wireless.SchDoc
hardware/sch/14_Expansion.SchDoc
hardware/sch/15_Debug.SchDoc
hardware/sch/16_Misc.SchDoc
reference/1_PROC142B/1_SCHEMATIC/1_ORCAD/PROC142B_SCH_With_Design_Updates..Notes_V1.0.DSN
reference/2_PROC142A/1_SCHEMATIC/ORCAD/Backup_SK_Schematic_For_Reference/PROC142A_SCH.DSN
reference/2_PROC142A/1_SCHEMATIC/ORCAD/Backup_SK_Schematic_For_Reference/PROC142A_SCH.opj
reference/2_PROC142A/1_SCHEMATIC/ORCAD/PROC142A(002)_Sch_With_Design_Updates..Notes_V1.0.DSN
