shikhakath/APE-SingleBoardComputer/hardware/gen/symlib/av.py

"""Symbols for sheets 10 (HDMI), 11 (audio) and 12 (camera).

Every pin table below was read from the manufacturer document named above the
symbol (downloaded 2026-10-17, text extracted with pdftotext/PyMuPDF, pin
diagrams cross-checked against the pin tables). Thermal pads get the next free
pin number; connector shells/tabs are listed as pins so the footprint maps.
"""
from schgen import box

# ------------------------------------------------------------ HDMI (sheet 10)

# TI TFP410PAPR, HTQFP-64 PowerPAD (PAP).
# https://www.ti.com/lit/ds/symlink/tfp410.pdf (SLDS145D, Feb 2024)
# Figure 4-1 (pinout, top view) + Table 4-1 Pin Functions p.3-5. PowerPAD = pin 65
# (TI numbers it 65 in Figure 7-3). DATA[11:0] = pins 63..58, 55..50 (DATA0 = 63,
# DATA5 = 58, IDCK+ = 57, IDCK- = 56, DATA6 = 55, DATA11 = 50); DATA[23:12] =
# pins 36..47 (DATA23 = 36, DATA12 = 47). Split in two parts: A = video input and
# straps, B = supplies and DVI outputs.
TFP410 = box("TFP410_PAP", "TI TFP410 DVI 1.0 transmitter, 24-bit DPI in, HTQFP-64 PowerPAD", [
    # part A: pixel bus
    (63, "DATA0", "in", "L", 1), (62, "DATA1", "in", "L", 1), (61, "DATA2", "in", "L", 1),
    (60, "DATA3", "in", "L", 1), (59, "DATA4", "in", "L", 1), (58, "DATA5", "in", "L", 1),
    (55, "DATA6", "in", "L", 1), (54, "DATA7", "in", "L", 1), (53, "DATA8", "in", "L", 1),
    (52, "DATA9", "in", "L", 1), (51, "DATA10", "in", "L", 1), (50, "DATA11", "in", "L", 1),
    (47, "DATA12", "in", "L", 1), (46, "DATA13", "in", "L", 1), (45, "DATA14", "in", "L", 1),
    (44, "DATA15", "in", "L", 1), (43, "DATA16", "in", "L", 1), (42, "DATA17", "in", "L", 1),
    (41, "DATA18", "in", "L", 1), (40, "DATA19", "in", "L", 1), (39, "DATA20", "in", "L", 1),
    (38, "DATA21", "in", "L", 1), (37, "DATA22", "in", "L", 1), (36, "DATA23", "in", "L", 1),
    # part A: clock, sync, configuration
    (57, "IDCK+", "in", "R", 1), (56, "IDCK-", "in", "R", 1),
    (2, "DE", "in", "R", 1), (4, "HSYNC", "in", "R", 1), (5, "VSYNC", "in", "R", 1),
    ("", "", "pas", "R", 1),
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
