shikhakath/APE-SingleBoardComputer/(commit log)

2026-10-17 Add datasheets and TI SK-AM62B reference design files
    - datasheets/: AM625 datasheet, AM62x TRM (spruiv7c), TPS65219 PMIC
    datasheet, Octavo OSD62x-PM overview
    - reference/: TI SK-AM62B-P1 design packages (PROC142B, PROC142A)
    - Track files over GitHub's size limits (*.brd, *.alg, *.STEP, TRM PDF)
    with Git LFS
    - Add Altium-oriented .gitignore
2026-10-17 Add design proposal, research notes and Altium MCP config
    - DESIGN_PROPOSAL.md: architecture proposal for an OSD6254-based SBC
    (power tree, peripherals, IO domains, PCB, Altium setup, parallel
    design plan, risks and open decisions)
    - docs/research/: page-referenced notes on the OSD62x-PM SiP, the TI
    SK-AM62B-P1 reference design and AM625/TPS65219 constraints
    - .mcp.json: register the altium-mcp server for this project
    - README: repository layout, Git LFS and MCP setup notes
2026-10-18 Add Altium project for APE Single Board Computer
2026-10-18 Add priced BOM, Rev 2 proposal and schematic generator
    - docs/bom: merged BOM (156 lines, 140 placed), every part in stock,
    $232.62/board at qty 10 incl. PCB + JLCPCB assembly and plug-in modules
    - docs/research/bom: per-section part comparisons, JLCPCB stackup and
    cost study; docs/research/pinmux-allocation.md
    - DESIGN_PROPOSAL.md Rev 2: user decisions (100x70 mm, 1.4 GHz, M.2
    Wi-Fi, 1 GbE, codec, eMMC module, FT4232, USB-PD, JLC stackup, no LVDS)
    and stock-driven changes (TFP410, TPS6521904RSM, DP83867IS)
    - hardware/gen: Python schematic generator driving Altium through the
    altium-mcp server; symbols (generic, TPS65219, TPS22965, TLV755P,
    500-ball OSD6254 in 9 parts from the ve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
2026-10-18 Generate schematic v0.1: all 16 sheets in Python
    - Sheets 01 and 04-16 written (01 power input, 04 SiP GND/NC, 05 SiP IO,
    06 clock/reset/boot, 07 storage, 08 Ethernet, 09 USB, 10 HDMI,
    11 audio, 12 camera, 13 wireless, 14 expansion, 15 debug, 16 misc);
    687 designators, 443 nets, build.py check clean (no single-node nets,
    no accidental connections, no overlaps)
    - Symbols for every IC and connector built from downloaded datasheet
    pin tables (source cited above each symbol), split into symlib/
    - Generator: auto-discovered sheets and symbols, stricter rail rule,
    geometry/short and layout/overlap checks, rails report, shared logic
    and ESD symbols, frozen-sheet mechanism
    - SHEET_CONT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
2026-10-21 Add PCB footprint library as code (65 footprints, pad-vs-pin check)
    - footprints.py: footprint model in mm, builders, spec emission for
    create_footprints_batch, per-part footprint rules for generic symbols,
    PNG renderer and self-check.
    - fplib/*.py: 65 footprints from manufacturer land patterns, source and
    page cited above each; OSD62x-PM BGA500 with 0.20 mm NSMD lands from
    the ball map. LQFP64, QFN28 and the polymer cap are IPC-7351B derived
    (no vendor pattern).
    - build.py: check now fails on any symbol pin without a pad, pad without
    a pin, unresolved part footprint or joined terminal on two nets;
    new `footprints` command creates and saves lib/APE-SBC.PcbLib;
    `project` regis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
2026-10-21 Build the schematic in Altium: 16 sheets, symbol and footprint libraries
    Built and compiled on Altium Designer 26.6:
    - hardware/sch: all 16 sheets, each matching the generator pin for pin
    - hardware/lib: APE-SBC.SchLib (65 symbols) and APE-SBC.PcbLib (65
    footprints, 0 primitive errors); both registered in the project
    - ERC: 0 fatal; remaining entries are No-ERC-marked pins (listed by the
    MCP reader) and pin-type warnings
    Toolchain fixes found on the live run:
    - altium/ApeScripts.PrjScr/.pas: own script project replacing the MCP
    run_altium_script sandbox (no SbxField/extra variables there), run
    directly by build.py (run_ape, ping, unwedge)
    - Libraries created via DM_CreateNewDocument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
2026-10-21 Set up the PCB: 6-layer JLC stack, rules, classes, schematic import
    build.py pcb drives Altium through new ApeScripts procedures, with all
    values in gen/pcbsetup.py:
    - 100 x 70 mm outline; JLC06161H-3313 stack TOP/GND/SIG/GND/PWR/BOT
    with the impedance calculator's Dk and copper
    - SE50 / DIFF90 / DIFF100 impedance profiles; power and SE50 net
    classes; 19 differential pairs in USB0, USB1, USB_DBG, ETH_MDI,
    HDMI_TMDS and CSI classes
    - design rules from the stackup research (SiP room 0.09 mm / 0.15-0.25
    vias, mask, paste, holes, outline), priorities specific to general
    - Import Changes driven automatically; all 687 parts and 443 nets
    arrive and every pad net matches the generator (pcb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
2026-10-22 Review the schematic and footprints; fix drawing conventions
    Drawing:
    - Adjacent same-net ground and supply pins share one bus wire and one port;
    wires run under the whole net label, with uniform length per side.
    - Sheets auto-fit the smallest Altium size, shifting content down as well as up.
    - The build reopens sheets so ERC sees their real size.
    Octavo OSD62x-PM checklist and pin-by-pin review:
    - I2C0 47R series resistors (R1620/R1621) and a separate I2C0_*_BUS net.
    - Filtered VDDS_OSC0_1V8 rail (FB310) for VDDS_OSC0, the 25 MHz
    oscillator and the PORz gate.
    - LDO3 decoupling 4.7uF -> 1uF, inside the 30uF slow-ramp limit.
    - 13 rail test points.
    - PMIC MODE/LPM pull-ups.
    - R611 1k; R91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
2026-11-04 Add Production variant and remove unsafe PHY strap options
    DNP was only a hidden parameter, which BOM and pick-and-place outputs
    ignore. The new Production project variant marks the 47 DNP parts Not
    Fitted; `build.py variant` regenerates it from the sheets.
    Schematic:
    - R603 (Rbias) had "0402" as its value; it is now 10M. TI recommends the
    footprint on pre-production boards but gives no value.
    - Remove R824-R837. Fitted, they gave PHY address 5, RX skew 0.5 ns and
    TX skew 3.5 ns. The wanted setting is mode 1 (open), so no fitted value
    is correct. U800 pins 39, 40 and 45 are now NC.
    - Remove R816. Fitted beside R815, it lifted RESET_N to about 0.8 V during
    reset. The fallback only ne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
2026-11-04 Reset the eMMC module from RESETSTATz and the GPIO
    Checklist 62_EMMC_9 asks for RESETSTATz, alone or ANDed with a GPIO. The
    module's RST_n came from the GPIO alone, so a warm reset left it un-reset.
    - Add U703 (SN74LVC1G08 on VDD_1V8) and its decoupling C705, as on the
    SK-AM62B-P1. The gate's 5.5 V tolerant inputs also shift RESETSTATz to
    1.8 V.
    - Move the R710 pull-up to the GPIO side, so the reset follows RESETSTATz
    by default. R711 stays in series, in case a module's pin 12 is a supply.
    - Note that RST_n only acts once EXT_CSD[162] is enabled on the module.
    - Remove open item C4, which wrongly said the checklist allowed GPIO only.
    Rebuilt sheet 07 and imported it to the PCB, which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
2026-11-05 Give each SoC IO bank its own rail and fix the VMON divider
    Check the Octavo checklist power nets item by item against the netlist.
    - Add VDDSHV0-4, VDDSHV6, VDDSHV_MCU and VDDSHV_CANUART, each fed through a
    0R link (R303-R310), and move 110 parts to the net of the bank that powers
    their SoC ball. Pull-ups to VCC_3V3_SYS could not be told apart from
    pull-ups to the right bank (62_CONFIG_4, 62_CONFIG_5, 62_CONFIG_9 and others).
    - Change the VMON_VSYS divider from 10k/1.1k to 40.2k/4.87k (62_CONFIG_6). The
    trip point moves from 4.33-4.79 V to 3.97-4.47 V.
    - Give VDDA_3P3_USB its own bead (FB311, C361) and move VDDA_TEMP onto the
    VDDA_MCU bead (62_POWER_4 groups 5 and 3).
    - Keep R207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
2026-11-05 Place the board and add high-speed constraints
    Place all 717 parts on a 100 x 70 mm board, with nothing routed. The Pi outline
    was too tight, so the board grows past it while keeping the Pi mounting holes
    and 40-pin header positions for HATs.
    Set up the JLC06161H-3313 stack and its SE50, DIFF90 and DIFF100 profiles per
    layer. Add xSignals across the series parts, plus matched-length, length,
    via-count, routing-layer and high-speed clearance rules, with sources in
    hardware/gen/README.md section 11. RGMII, MDI, CSI and TMDS stay off L6 because
    it references the power plane.
    pcbsetup.py verify matches the saved file. The file has no copper tracks, arcs,
    vias or pours. DRC reports 7,245 violat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
2026-11-09 Rework placement, power and SoM escape on the 8-layer board
    - Switch to the 8-layer JLC stack (re-checked against 6 layers) and
    update the BOM.
    - Delete the 22 decoupling capacitors around U1 that the OSD62
    datasheet does not call for, and move U1 up 2 mm.
    - Route SoM power on L3, L4 and L6 instead of L8: 124 L8 tracks and
    5 vias replaced by 113 tracks and 8 vias.
    - Add the U1_Escape room and the Clr_HS_Escape rule, and exempt GND
    tracks from the 30 mil diff-pair clearance so the J1200 CSI pairs
    route.
    - Add the block-based placement, floorplan, fanout and power-plane
    generators.
    - Tie the ESD flow-through pads to their channel; R611 back to 10k.
    - Include the board and the PMIC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
2026-11-09 Let the HDMI pairs sit 0.1 mm apart from U1000 to J1000
    The 30 mil pair-to-pair rule stopped every HDMI pair after the first:
    U1001's pads are 0.65 mm apart and J1000's pins 0.5 mm, with no GND
    between neighbouring pairs. TI lifts the 30 mil for package escape and
    connector termination (SPRAAR7J 3.3, 3.4), which here covers the whole
    run, so HDMI tracks inside the new HDMI_Escape room need 0.10 mm.
    - pcbsetup.py: HDMI_Escape room round U1000, U1001 and J1000, and
    Clr_HDMI_Escape ahead of the per-pair 30 mil rules.
    - ApeScripts.pas: a room record may carry its own comment.
    - README: the rule and why.
    - PCB.PcbDoc: rules applied, with the board as currently edited.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
2026-11-09 Pin the HDMI pair width to 0.119 mm
    DP_100R allows 0.09-0.13 mm so the SiP pairs can neck down, and the
    router took whichever end its width mode gave: TX1 came out at 0.09 mm
    (about 113 ohm) and TX2 and TX0 at 0.13 mm (about 96 ohm). TMDS is L1
    only and needs no neck-down, so DP_100R_TMDS, ahead of DP_100R, fixes
    its width at the L1 100 ohm value, 4.69 mil, gap preferred 8.0 mil.
    The board has the rule applied; its existing HDMI tracks are still at
    the old widths and need re-routing.
2026-11-09 Save the board as routed by hand on 2026-11-09
    Hand routing since the last commit: about 400 tracks and 33 vias added,
    77 tracks and 21 vias removed, mostly DPI, CAM_IO, VCC_3V3_SYS, the
    VDDSHV rails and GND. The HDMI routes are unchanged.
2026-11-10 Fix footprints from the 2026-11-09 review: own paste, thermal vias
    - Pads under stencil windows now carry "no paste" themselves (Pad.paste),
    so TI's split stencils print without the board's Paste_Windowed rule:
    TPS63070, TPS25730, LM61460, TPS65219, TPS22965, DP83867, TLV320AIC3104,
    CH335F; Tag-Connect pads print none.
    - Thermal vias from TI's example layouts (Footprint.vias, 0.2/0.4 mm):
    REF 8, DRV 2, RSM 5, DSG 2, RGZ 12, RHB 5, PAP 36.
    - TFP410 pad 65 is TI's 8.0 mm land with its own -1.5 mm mask and paste
    expansion (5.0 mm mask-defined opening).
    - TF-01A shell tabs and USB-C S1-S4 follow the LCSC footprints; USB-A
    VBUS pads 1 and 5 are square. Same nets, no schematic change.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
2026-11-10 Drop every 0R link and add escape rooms for the pin-pitch pairs
    0R links: all 35 are gone, 25 fitted and 10 DNP. A fitted link's two nets
    are one net now. schgen.MERGED_NETS maps each old name to the kept one
    and is applied as every pin is placed, so the sheets can still name the
    IO bank behind a pull-up (VDDSHV0 is VCC_3V3_SYS, VDDSHV1 is VDD_1V8) and
    M2_SDIO_* is WL_SDIO_*. All 16 sheets regenerated.
    Board: the import removed only the 35 parts; nothing moved. Copper on the
    merged nets was renamed first (ApePlace MergeNets), the tracks, vias and
    arcs the import left with no net got it back (SetNets), and the 13 links
    routed on both pads are bridged by short tracks inside the old pads
    (AddT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
2026-11-10 Simplify the power planes and drop redundant power traces
    - Planes: delete the 7 pours that the IO-bank merge left inside a pour of
    the same net (VCC_3V3_SYS 4, 5, 6, 8, 10 on L5; VDD_1V8 28, 29 on L4).
    VDD_1V8 pour 32 stays: it is its own region left of the SoM. 30 pours.
    - Signal layers: remove 55 power segments that joined only vias already on
    a same-net plane, and 5 vias left touching nothing but their plane. Pad
    fanouts, regulator power paths, routes to uncovered vias and unfinished
    routes stay. Unrouted, shorts and antennae match the DRC from before.
    - ApePlace: DeletePolys. pcbsetup drc answers Altium's "Run DRC / Repour
    Polygons" prompt with Run DRC, so a modified pour no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
